Adar-Shapira/rv32im-mcu-project/Auxiliary/Lab 5/Screenshots/pre/test3_pipe_signaltap.jpeg

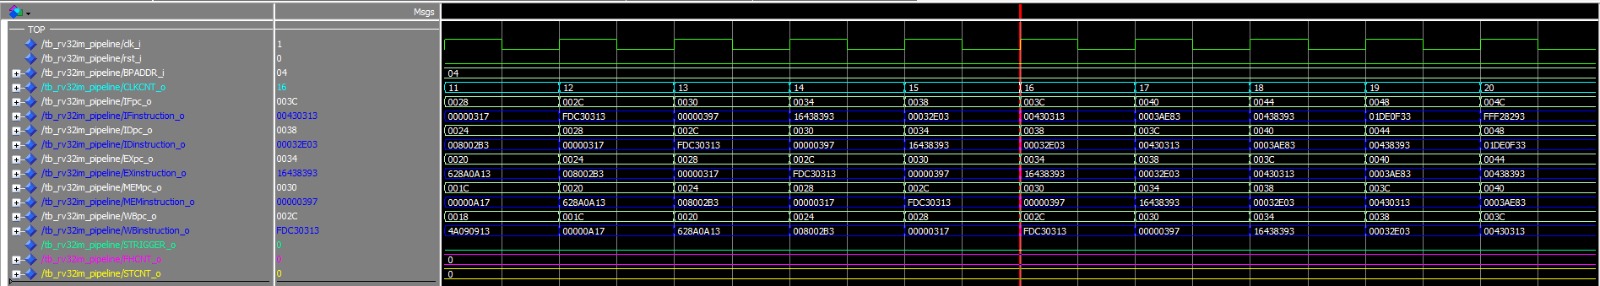
Auxiliary/Lab 5/Screenshots/pre/test3_pipe_signaltap.jpeg
