Adar-Shapira/rv32im-mcu-project/DOC/02_requirements_traceability.md

# Deliverable B — Requirements Traceability

Every address, bit field, interrupt source, timer mode, divider signal and clock, with the source it
came from. Where the material is ambiguous, the interpretation is labelled **Assumption** and what
would falsify it is stated.

Category tags, never mixed:

| Tag | Meaning |
| --- | --- |
| **[REQ]** | Official requirement, cited to a page of `Auxiliary/Final Project 2026 definition.pdf` |
| **[REQ-L5]** | Official requirement from `Auxiliary/Lab 5/Auxilary/LAB5 task definition.pdf` |
| **[CODE]** | Behaviour of code Hanan supplied |
| **[BENCH]** | Conclusion derived from a supplied benchmark |
| **[DEC]** | Our design decision |
| **[REC]** | Engineering recommendation, not binding |

All register bit-field tables in the specification are **raster images**, so no text extractor can
recover them and `Final Project 2026 definition.md` is missing or mangling every one. Everything
below was read from the PDF pages directly.

---

## 1. Data address space

**[REQ p3]** The data address space addresses DTCM and memory-mapped I/O at the lowest 14-bit
address `0…0 A13…A0`.

**[REQ p4, Figure 2]** Word-addressed layout, marked "32-bit Word":

| Word address | Byte address | Region |
| --- | --- | --- |
| `0x000` – `0x7FF` | `0x0000` – `0x1FFC` | DTCM, physical data memory — 2048 words |
| `0x800` – `0xFFF` | `0x2000` – `0x3FFC` | SFR (Special Function Registers), "distributed among many I/O devices, not all used" |

**[REQ p3, Figure 1]** Both memories are labelled `ITCM / L1-ICACHE 8kB size` and
`DTCM / L1-DCACHE 8kB size`.

**[CODE]** `cond_compilation_package.vhd:53-56` sets `G_ADDRWIDTH = 11` and
`G_DATA_WORDSNUM = 2048` — 2048 × 32 bits = 8 KiB. Consistent.

**[CODE]** `RV32IM_CORE.vhd:215-220` currently does `dtcm_addr_w <= alu_res_w(MA_WIDTH-1 DOWNTO 2)`
with `MA_WIDTH = 13`, and there is **no I/O decode at all**. Address `0x2000` therefore aliases onto
DTCM word 0 — where the interrupt vector table lives. This is the single most important gap in the
supplied core.

---

## 2. MMIO map

**[REQ p5, §5]** GPIO without interrupt capability:

| Register | Address | Resolution | Direction | Note |
| --- | --- | --- | --- | --- |
| `PORT_LEDR` | `0x2000` | Byte | GPO | LEDR7–LEDR0 |
| `PORT_HEX0` | `0x2004` | Byte | GPO | |
| `PORT_HEX1` | `0x2005` | Byte | GPO | |
| `PORT_HEX2` | `0x2008` | Byte | GPO | |
| `PORT_HEX3` | `0x2009` | Byte | GPO | |
| `PORT_HEX4` | `0x200C` | Byte | GPO | |
| `PORT_HEX5` | `0x200D` | Byte | GPO | |
| `PORT_SW` | `0x2010` | Byte | GPI | SW7–SW0 |

**[REQ p6, §6]** Peripherals with interrupt capability:

| Register | Address | Resolution | Device |
| --- | --- | --- | --- |
| `PORT_PB` | `0x2014` | Byte | KEY[3-1] |
| `UTCL` | `0x2018` | Byte | USART |
| `RXBF` | `0x2019` | Byte | USART |
| `TXBF` | `0x201A` | Byte | USART |
| `BTCTL1` | `0x201C` | Byte | Basic Timer |
| `BTCTL2` | `0x201D` | Byte | Basic Timer |
| `BTCMPR0` | `0x2020` | Word | Basic Timer |
| `BTCMPR1` | `0x2024` | Word | Basic Timer |
| `BTCAPR` | `0x2028` | Word | Basic Timer |
| `IE` | `0x202C` | Byte | Interrupt Controller |
| `IFG` | `0x202D` | Byte | Interrupt Controller |
| `TYPE` | `0x202E` | Byte | Interrupt Controller |

**[REQ p5, §4] vs [REQ p5, §5]** §4 lists ten switches and ten red LEDs; §5 maps only SW7–SW0 and
LEDR7–LEDR0. Only eight of each are memory-mapped. Benign — the map is authoritative.

**[REQ p5, Figure 5]** The decoder structure. An `Optimized Address Decoder` takes
`Address<A13..A4, A3, A2>` and produces `CS_1 … CS_n`. HEX registers are paired on one chip select
and separated by `A0`: HEX0 (`0x2004`) on `Ā0` and HEX1 (`0x2005`) on `A0`, both on `CS6`. Each
output port is a `D-Latch D0..D7 / Q0..Q7` enabled by `CS_x · MemWrite`, followed by a
`7-segment encoder` for the HEX ports. `PORT_LEDR` is a latch on `CS1 · MemWrite`. `PORT_SW` drives
`Data<7..0>` through a tri-state buffer on `CS7 · MemRead` — which is why the data bus is
bidirectional, and why Figure 1 links to a bidirectional-bus reminder.

**[BENCH]** Every `io_map.s` in every benchmark suite defines exactly these twenty addresses with
exactly these values, including the GPIO suites, which never use the timer or interrupt registers.
Two naming differences: the spec writes `RXBF`/`TXBF`, the benchmarks write `RXBUF`/`TXBUF`; and
`UTCL` on p6 is titled `UCTL` in the register table on p12. Same registers.

**[BENCH]** `Intrrupt-based IO/test1/asm-code/01_func.s:17-20` performs `sw` to `0x2005`, a
non-word-aligned byte address. Sub-word MMIO stores are therefore mandatory, not optional.

### 2.1 What the twenty addresses imply about the decoder — Phase 5A

**[BENCH]** Grouped by word — the addresses being those of §5 and §6 above — the map has no ragged edges: the twenty registers occupy exactly
**twelve consecutive 32-bit words** and **no register straddles a word boundary**.

| SFR word | Byte address(es) | Register(s) | Mapped lanes |
| --- | --- | --- | --- |
| 0 | `0x2000` | `PORT_LEDR` | 0 |
| 1 | `0x2004` `0x2005` | `PORT_HEX0` `PORT_HEX1` | 0 1 |
| 2 | `0x2008` `0x2009` | `PORT_HEX2` `PORT_HEX3` | 0 1 |
| 3 | `0x200C` `0x200D` | `PORT_HEX4` `PORT_HEX5` | 0 1 |
| 4 | `0x2010` | `PORT_SW` | 0 |
| 5 | `0x2014` | `PORT_PB` | 0 |
| 6 | `0x2018` `0x2019` `0x201A` | `UTCL` `RXBUF` `TXBUF` | 0 1 2 |
| 7 | `0x201C` `0x201D` | `BTCTL1` `BTCTL2` | 0 1 |
| 8 | `0x2020` | `BTCMPR0` — Word | 0 1 2 3 |
| 9 | `0x2024` | `BTCMPR1` — Word | 0 1 2 3 |
| 10 | `0x2028` | `BTCAPR` — Word | 0 1 2 3 |
| 11 | `0x202C` `0x202D` `0x202E` | `IE` `IFG` `TYPE` | 0 1 2 |

**[DEC]** The chip-select index is therefore `addr(5 DOWNTO 2)` — the word offset itself — and no
lookup table is needed to produce the one-hot. This is exactly Figure 5's structure: one CS per word,
`A0` separating the pair that shares it. Two words carry three registers, so `A1` joins `A0` there.
Implemented in `DUT/RV32IMscMCU/ADDR_DECODER.vhd`; the map is data in `const_package.vhd`
(`SFR_LANE_MASK`).

**[DEC]** Totals, exhaustively checked by `TB/RV32IMscMCU/tb_addr_decoder.vhd`: **8192** DTCM
bytes, **29** mapped SFR bytes (17 byte registers + 3 word registers × 4 lanes), **8163** unmapped.

**[BENCH] The write path is not the DTCM's write path.** `GPIO/test0/asm-code/test0.s:21-28` is
`li t4,PORT_HEX1` then `sw t0,0(t4)` — a **word** store to byte address `0x2005`. Every MMIO write in
every supplied benchmark has this shape, odd addresses included, and
`Intrrupt-based IO/test1/asm-code/01_func.s:17-20` uses an `srli` to place the value in bits 7..0
before the `sw`. Two consequences:

1. On the I/O side `A1..A0` are the **register selector**, not an offset into the data being
   written. Figure 5 wires the latch inputs `D0..D7` to `Data<7..0>` unconditionally.
2. The MMIO write path must **not** reuse the lane replication and `byteena_a` of Phase 3B
   (`DMEMORY.vhd`). Those are correct for the DTCM and wrong for a peripheral. A byte-resolution
   peripheral takes `Data<7..0>`; a Word-resolution one takes `Data<31..0>`.

**[BENCH] The read path only needs eight bits.** All three MMIO reads in the benchmarks are
`lw` from `PORT_SW`, and each is immediately followed by `andi` against a mask
(`GPIO/test1/asm-code/test1.s:24-25` and `test2.s:24-25`). Figure 5 drives only `Data<7..0>` from the
`PORT_SW` tri-state. **Assumption:** the upper 24 bits read as zero. Harmless either way in every
supplied benchmark, because the mask discards them. **Falsified by** a program that uses the upper
bits of an MMIO read.

**[DEC] Full decode, not partial.** `A12..A6 = 0` is part of the qualifier, so `0x2040` does not
alias onto `0x2000`. Figure 2 calls the SFR page "distributed among many I/O devices, **not all
used**", so unused addresses exist by design and must not land on used ones; and an unmapped-access
report is only meaningful under a full decode. Cost is a 7-input zero-compare. If Phase 14 finds the
decoder on the critical path, dropping `A12..A6` is the cheapest concession — `A13` must never be
dropped, as that is the DTCM/SFR split itself.

**[REQ p5] vs [REQ p5, Figure 5] — the GPO ports: output-only, or readable?** Clause 5's table gives
`PORT_LEDR` and `PORT_HEX0`…`PORT_HEX5` a Direction of **GPO**. Figure 5, however, draws inside *each*
of the three output-port interface blocks it shows a tri-state buffer labelled with `MemRead` and that
block's chip select (plus `A0` / `Ā0` for the pair), driving `Data<7..0>` — i.e. a **read-back** path,
so a load from `0x2000` or `0x2004` should return the byte the port last stored.

**Assumption (A15):** the two are reconcilable — "GPO" describes the *device* (an output device)
rather than forbidding a readable register, and a read-back register is the ordinary
memory-mapped-I/O arrangement. Read-back is therefore treated as required and scheduled with the rest
of the read path in Phase 6B. **Nothing is blocked either way:** no supplied benchmark reads a GPO
port — the only MMIO reads anywhere in the benchmark suites are three `lw` from `PORT_SW`.
**Falsified by** course staff saying the seven output ports must not respond to a read at all, in
which case Phase 6B omits the read-back and `unmapped_o`'s meaning there needs deciding.

**Phase 6A implements the write side only**, and records that omission as the second of its two
deviations from Figure 5 — see the header of `DUT/RV32IMscMCU/GPO_PORT.vhd`. It was found by an
adversarial review of the phase, not by design.

**[DEC] Naming deviation, recorded.** Figure 5 labels its chip selects `CS1`, `CS6` and `CS7` for
`PORT_LEDR`, the `PORT_HEX0`/`PORT_HEX1` pair and `PORT_SW`. No arithmetic relation to the addresses
reproduces those three numbers, so the figure's numbering is treated as **illustrative** and the
constants are named after the registers instead. The figure's structure is implemented unchanged.

---

## 3. Basic Timer

**[REQ p7, Figure 7]** `BTCTL1` — 8-bit, byte address `0x201C`:

| Bit | 7 | 6 | 5 | 4 | 3 | 2 | 1 | 0 |
| --- | --- | --- | --- | --- | --- | --- | --- | --- |
| Field | BTOUTMD | BTOUTEN | BTHOLD | BTSSEL | BTSSEL | BTCLR | BTINT | BTINT |
| Access | rw | rw | rw | rw | rw | rw | rw | rw |

**[REQ p7, Figure 7]** The `BTSSEL` encoding, from the 4-to-1 clock multiplexer in Figure 7:

| `BTSSEL` | Timer clock |
| --- | --- |
| `00` | SMCLK |
| `01` | SMCLK ÷ 2 |
| `10` | SMCLK ÷ 4 |
| `11` | SMCLK ÷ 8 |

**[REQ p7, Figure 7]** `BTCTL2` — 8-bit, byte address `0x201D`:

| Bit | 7 | 6 | 5 | 4 | 3 | 2 | 1 | 0 |
| --- | --- | --- | --- | --- | --- | --- | --- | --- |
| Field | 0 | 0 | 0 | 0 | CAPMD | CAPMD | CAPISEL | CAPISEL |
| Access | r | r | r | r | rw | rw | rw | rw |

**[REQ p8]** `CAPISEL` selects `{0: CAPIN1 pin, 1: CAPIN2 pin, 2: VCC('1'), 3: GND('0')}`.
`CAPMD` selects `{0,3: capture disabled, 1: Rising edge, 2: Falling edge}`.

**[REQ p7]** `BTCMPR0` (`0x2020`), `BTCMPR1` (`0x2024`), `BTCAPR` (`0x2028`) are all 32-bit
word-addressed, bits 31..0, `rw`.

**[REQ p8]** `BTCCRx` and `BTCMPRx` are the same registers under two names. "BTCCR" appears only in
the p8 prose and never in any address table; the addressed names are authoritative.

**[REQ p7, Figure 7]** Datapath, top to bottom:
`BTCMPR0` and `BTCMPR1` each feed a `Latch BTCL0` / `Latch BTCL1` enabled by a signal drawn as
`HEU0='1'`. `BTCNT` is a **32-bit up-mode** counter with `EN` from `BTHOLD`, `CLK` from the `BTSSEL`
mux, reset from `BTCLR`, and a comparator output `EQU0`. `BTCL0`/`BTCL1` and `EQU0`/`EQU1` feed an
`Output Unit` gated by `BTOUTMD` and `BTOUTEN`, producing `PWMout`. The capture path is
`CAPISEL` mux (CAPIN1 / CAPIN2 / VCC / GND) → `Capture Mode` block → edge detector →
`BTCNT_CAPTURE on event register` → `BTCAPR`. A 4-position mux selected by `BTINT` chooses the
`BTIFG` source from `EQU0`, `EQU1` and the capture event.

**[REQ p8]** Modes. *Compare*: `BTCNT` compared to `BTCCR0`/`BTCCR1` for periodic interrupt
intervals. *Output Compare*: compared to `BTCMPR0` and `BTCMPR1` for PWM. *Input Capture*: `BTCNT`
captured on event into `BTCAPR`.

**[REQ p8, Figure 8]** Reference lines top to bottom are `BTR(max)`, `BTCL0`, `BTCL1`, `0h`. The
sawtooth rises to `BTCL0` and resets. Two output traces: `Output Mode0: Set/Reset` and
`Output Mode1: Reset/Set`, which are complements of each other. So **`BTCL0` is the period and
`BTCL1` is the duty threshold**, and `BTOUTMD` selects which polarity.

### 3.1 Verification 1 — every timer constant decodes. **PASS, 13/13.**

Each `.eqv` from every `io_map.s`, decoded against the layouts above.

| Constant | Value | Binary | Decodes to | Name says | |
| --- | --- | --- | --- | --- | --- |
| `BTHOLD_BTCLR` | `0x24` | `0010_0100` | BTHOLD=1, BTSSEL=00, BTCLR=1, BTINT=00 | BTHOLD + BTCLR | ✔ |
| `BTHOLD_BTSSEL3_BTCLR` | `0x3C` | `0011_1100` | BTHOLD=1, BTSSEL=11, BTCLR=1 | BTHOLD + BTSSEL3 + BTCLR | ✔ |
| `BTSSEL3` | `0x18` | `0001_1000` | BTSSEL=11, everything else 0 | BTSSEL3 | ✔ |
| `BTOUTEN_BTSSEL3` | `0x58` | `0101_1000` | BTOUTEN=1, BTHOLD=0, BTSSEL=11 | BTOUTEN + BTSSEL3 | ✔ |
| `BTINT2` | `0x02` | `0000_0010` | BTINT=10 = 2 | BTINT2 | ✔ |
| `BTHOLD_BTCLR_BTINT2` | `0x26` | `0010_0110` | BTHOLD=1, BTSSEL=00, BTCLR=1, BTINT=10 | BTHOLD + BTCLR + BTINT2 | ✔ |
| `CAPMD1_CAPISEL3` | `0x07` | `0000_0111` | CAPMD=01 (rising), CAPISEL=11 (GND) | CAPMD1 + CAPISEL3 | ✔ |
| `BTIE` | `0x04` | `0000_0100` | IE bit 2 | BTIE | ✔ |
| `KEY3IE_KEY2IE_KEY1IE` | `0x38` | `0011_1000` | IE bits 5,4,3 | KEY1/2/3 IE | ✔ |
| `KEY3IE_KEY2IE_KEY1IE_BTIE` | `0x3C` | `0011_1100` | IE bits 5,4,3,2 | + BTIE | ✔ |
| `KEY1IFG_MASK` | `0xFFF7` | `…1111_0111` | AND-clears IFG bit 3 | KEY1IFG | ✔ |
| `KEY2IFG_MASK` | `0xFFEF` | `…1110_1111` | AND-clears IFG bit 4 | KEY2IFG | ✔ |
| `KEY3IFG_MASK` | `0xFFDF` | `…1101_1111` | AND-clears IFG bit 5 | KEY3IFG | ✔ |

**Independently corroborated by the benchmark authors' own comments**, which spell out the field
assignments:

| Source | Comment |
| --- | --- |
| `test4/01_func.s:76` | `# BTCTL1=(BTHOLD=1,BTCLR=1)` for `0x24` |
| `test2/01_func.s:56` | `# BTCTL1=(BTHOLD=1,BTSSEL=3,BTCLR=1)` for `0x3C` |
| `test4/01_func.s:101` | `# BTCTL1=(BTHOLD=0,BTCLR=0,BTSSEL=3,BTINT=0)` for `0x18` |
| `test4/01_func.s:147` | `# BTCTL1=(BTOUTEN=1,BTHOLD=0,BTCLR=0,BTSSEL=3)` for `0x58` |
| `test4/01_func.s:158` | `# BTCTL1=(BTHOLD=1,BTCLR=1,BTSSEL=SMCLK,BTINT=2)` for `0x26` |

That last comment is decisive: `0x26` has `BTSSEL = 00`, and the author annotates it
`BTSSEL=SMCLK`. So `00` is SMCLK undivided, exactly as Figure 7's mux shows.

**Caution:** `0x3C` means two different things depending on the destination register —
`BTHOLD_BTSSEL3_BTCLR` when written to `BTCTL1`, `KEY3IE_KEY2IE_KEY1IE_BTIE` when written to `IE`.

### 3.2 Verification 2 — the frequency arithmetic. **FAIL. A real contradiction.**

**[BENCH]** The two timing constants, with the benchmarks' own annotations:

```
.eqv SEC_PERIOD  0x01312D00   # = 20,000,000   # in case of SMCLK=20MHz
.eqv FREQ_5K     0x000001F4   # = 500          # in case of SMCLK=20MHz
```

**[BENCH]** Which `BTSSEL` each is used with, read from the sources rather than assumed:

| Test | Sequence | `BTSSEL` | Constant | Claimed |
| --- | --- | --- | --- | --- |
| test2 | `01_func.s:54` writes `0x3C`, `:64` loads `SEC_PERIOD` → `BTCMPR0`, `:72` writes `0x18` | **3 (÷8)** | `SEC_PERIOD` | "interrupt period of 1sec" |
| test3 | identical to test2 | **3 (÷8)** | `SEC_PERIOD` | "interrupt period of 1sec" |
| test4 compare | `01_func.s:74` writes `0x24`, `:95` loads `SEC_PERIOD`, `:99` writes `0x18` | **3 (÷8)** | `SEC_PERIOD` | "interrupt period of 1sec" |
| test4 PWM | `:120` loads `FREQ_5K` → `BTCMPR0`, `:145` writes `0x58` | **3 (÷8)** | `FREQ_5K` | "PWM frequency=5KHz (for SMCLK=20MHz)" |

Both constants are used at the **same** `BTSSEL = 3`, so ÷8 applies to both. Working the arithmetic
at SMCLK = 20 MHz, timer clock = 2.5 MHz:

- `FREQ_5K`: 2,500,000 ÷ 500 = **5000 Hz exactly** ✔ matches its comment.
- `SEC_PERIOD`: 20,000,000 ÷ 2,500,000 = **8 seconds**, not 1 ✘ off by exactly 8×.

For `SEC_PERIOD` to give one second at `BTSSEL = 3`, SMCLK would have to be 160 MHz, which is not
achievable from a 50 MHz input on this device and contradicts the constant's own annotation. For it
to give one second, `BTSSEL` would have to be `0`.

So exactly one of these holds, and the material does not say which:

1. SMCLK = 20 MHz, the `BTSSEL` table is as Figure 7 draws it, and the benchmarks' "1sec" comments
   are simply wrong — the real period is 8 s. `FREQ_5K` stays correct.
2. The `BTSSEL` encoding is reversed (`11` → ÷1), making `SEC_PERIOD` correct and `FREQ_5K` wrong
   by 8× (40 kHz instead of 5 kHz).

**[DEC]** We implement reading 1: Figure 7's table as drawn, `00` → ÷1 through `11` → ÷8. Three
independent things support it — the Figure 7 mux labels, the author's own `BTSSEL=SMCLK` comment on
value `00`, and `FREQ_5K` resolving exactly. Only the "1sec" prose comments contradict it, and
comments are the weakest evidence in the set.

**Assumption:** SMCLK = 20 MHz. Nothing in the specification states any frequency (see §6).
This is derived solely from `FREQ_5K` resolving exactly at ÷8, and from the benchmarks' own
`# in case of SMCLK=20MHz` annotations. **Falsified by** course staff stating a different SMCLK, in
which case `FREQ_5K` stops being 5 kHz and the whole derivation must be redone.

Raised as open question 2. It does not block: the timer implements the specified table, behaviour is
deterministic, and the 8× discrepancy is a property of the supplied benchmark rather than of our
RTL.

---

## 4. Interrupt controller

**[REQ p14]** `IE`, Interrupt Enable Register — byte address `0x202C`:

| Bit | 7 | 6 | 5 | 4 | 3 | 2 | 1 | 0 |
| --- | --- | --- | --- | --- | --- | --- | --- | --- |
| Field | 0 | 0 | KEY3IE | KEY2IE | KEY1IE | BTIE | TXIE | RXIE |
| Access | r-0 | rw | rw | rw | rw | rw | rw | rw |

`IEx`: 0 = interrupt not enabled, 1 = interrupt enabled.

**[REQ p14]** `IFG`, Interrupt Flag Register — byte address `0x202D`:

| Bit | 7 | 6 | 5 | 4 | 3 | 2 | 1 | 0 |
| --- | --- | --- | --- | --- | --- | --- | --- | --- |
| Field | 0 | 0 | KEY3IFG | KEY2IFG | KEY1IFG | BTIFG | TXIFG | RXIFG |
| Access | r-0 | rw | rw | rw | rw | rw | rw | rw |

`IFGx`: 0 = no interrupt pending, 1 = interrupt pending.

**[REQ p14]** `TYPE`, Interrupt Type Register — byte address `0x202E`. Bits 7:6 are `0`, read-only;
bits 5:0 are `TYPEx`, read-only.

**Cross-check:** these layouts were derived independently from the benchmark masks in §3.1 before
the PDF pages were read, and the two agree bit for bit. `BTIE = 0x04` → bit 2; `0x38` → bits 5,4,3;
`0xFFF7`/`0xFFEF`/`0xFFDF` → clear bits 3/4/5.

**[REQ p14]** Interrupt vector table:

| Source | Flag | TYPE | System interrupt | Priority |
| --- | --- | --- | --- | --- |
| RESET | — | `00h` | NMI | 0, highest |
| UART status error | RXIFG | `04h` | maskable | 1 |
| UART RX | RXIFG | `08h` | maskable | 2 |
| UART TX | TXIFG | `0Ch` | maskable | 3 |
| Basic Timer | BTIFG | `10h` | maskable | 4 |
| Pushbutton 1 | KEY1 | `14h` | maskable | 5 |
| Pushbutton 2 | KEY2 | `18h` | maskable | 6 |
| Pushbutton 3 | KEY3 | `1Ch` | maskable | 7, lowest |

**[REQ p13]** Clearing rules, verbatim:

- a. `BTIFG` is reset automatically when the interrupt is serviced.
- b. `RXIFG` is automatically reset if the pending interrupt is served or when `RXBUF` is read.
- c. `TXIFG` is automatically reset if the interrupt request is serviced or if a character is
  written to `TXBUF`.
- d. `KEYiIFG` is reset manually with software (`BTIFG`, `RXIFG`, `TXIFG` as well).
- e. As part of the CPU servicing an interrupt, `GIE` is cleared *in HW* — DINT of other interrupts.
- f. Symmetrically, as part of the CPU returning from interrupt, `GIE` is set *in HW* — EINT, back
  to the original state.

**[REQ p13, diagram]** Structure. The controller sits on the Control / Address / Data buses with a
`CS` input and interrupt-source inputs `IS0 … ISn`, drives `INTR` to the CPU and receives `INTA`
from it — both `CS` and `INTA` drawn active-low.

Per source: a D flip-flop with `D` tied to `"1"`, **clocked by the interrupt source `IS`** and
asynchronously cleared by `clr_irq`, with an "interrupt done" feedback path into that clear. So each
flag is a set-only latch triggered by the source's edge — this is exactly the KEY edge-latch
behaviour, and no separate edge detector is drawn.

Per the multi-source diagram, the flop outputs form the **IFG register** directly, and each
`irq_n AND eint_n` product feeds an OR tree whose output is ANDed with `GIE` to produce `INTR`.

**Assumption:** `IFG` holds the **raw latched** flag and `IE` masks only the path toward `INTR`.
The single-source diagram labels the `irq AND eint` output `IFGx`, which would instead make `IFG`
the masked value; the multi-source diagram contradicts it by bracketing the flop outputs as "the IFG
Register". We follow the multi-source reading because the benchmarks read and clear `IFG` bits
independently of `IE`. **Falsified by** a benchmark that reads `IFG` and expects a masked value.

### 4.1 Verification 4 — every TYPE value has a vector. **PASS.**

`TYPE` is a byte offset into the DTCM vector table, so `TYPE / 4` is the word index. Words 0–7 of
each benchmark's DTCM image:

| TYPE | Word | test1 | test2 | test3 | test4 |
| --- | --- | --- | --- | --- | --- |
| `00h` RESET | 0 | `00000000` | `00000000` | `00000000` | `00000000` |
| `04h` UART error | 1 | `00000200` | `0000011c` | `0000017c` | `00000234` |
| `08h` UART RX | 2 | `00000200` | `0000011c` | `0000017c` | `00000234` |
| `0Ch` UART TX | 3 | `00000204` | `00000120` | `00000180` | `00000238` |
| `10h` Basic Timer | 4 | `000001fc` | `00000104` | `00000164` | `000001f8` |
| `14h` KEY1 | 5 | `00000160` | `00000068` | `00000080` | `00000138` |
| `18h` KEY2 | 6 | `00000194` | `0000009c` | `000000cc` | `00000178` |
| `1Ch` KEY3 | 7 | `000001c8` | `000000d0` | `00000118` | `000001b8` |

Every entry is word-aligned and inside the ITCM extent. The RESET vector is `0` in all four,
consistent with **[REQ p3]** "KEY0 as a System RESET (brings the PC to the first program
instruction)".

**This resolves the `RXIFG` ambiguity in practice.** TYPE `04h` and `08h` hold the *same* handler
address in all four benchmarks, so the two UART sources vector to one routine that distinguishes
error from data by reading `UCTL`. The hardware still has to pick which TYPE value to present, but
the choice cannot change program behaviour in any supplied benchmark. Open question 4 is therefore
non-blocking.

### 4.2 The service protocol

**[REQ p15]** At the next clock cycle after `INTR` is set to `'1'` by the controller, the CPU sets
`INTA` to `'0'`. At that point, before the service process starts, the next PC address is the
**interrupt return address**.

Entry — latency **two cycles**, triggered by the **falling edge of `INTA`**:

*Cycle 1*
- Clear `GIE` (bit `gp[0] = 0`)
- Set `INTA` (`INTA = '1'`)
- Write the content of register `TYPE` onto the Data BUS and capture it in a dedicated register.
  **[REQ p15]** notes it cannot go on the Address BUS, because the CPU is the only bus master.

*Cycle 2*
- If the pending `TYPE` interrupt is a synchronous source, clear its flag (like `BTIFG`)
- Emulate execution of `load` (of the `TYPE` content) and `jalr` (to `Mem[TYPE]` content), with
  `R[tp]` = interrupt return address

Return — latency **one cycle**: as part of executing `jalr zero, 0(tp)` (`reti`), set `GIE`
(bit `gp[0] = 1`).

**[BENCH]** The software side of the contract:
`Intrrupt-based IO/*/asm-code/io_map.s` defines `.eqv reti  jalr zero,0(tp)`, and
`test1/asm-code/00_main.s:77` is `ori gp,gp,0x01   # EINT, GIE=gp[0]=1`.

So `INTA` is idle-high, pulses low for exactly one cycle as the trigger, and is driven high again in
Cycle 1.

### 4.3 What Phase 9A built — the controller leaf

**[OUR CODE]** `DUT/RV32IMscMCU/INTERRUPT_CTRL.vhd`, verified by `tb_interrupt_ctrl.vhd` against
`tools/model_interrupt_ctrl.py` (twelve faithful mutations, all caught). No lab precedent exists —
searched, only a student explanation document mentions interrupts. Design points, each carrying its
source:

- **Raw latch, masked view** — `irq_q` set by the event edge with **no IE gate** (the p13 flop,
  D='1'), and `ifg_w = irq_q AND ie_q` is the *only* thing read-back, the TYPE encoder and the
  `INTR` OR-tree ever see. This is the p13 structure taken literally and the falsified-A6 answer
  honoured: what `IFG` reads is the masked product. The first draft gated the *set* by IE instead —
  killed and kept as mutant M1. Observable corners recorded as **A22** (masked requests reappear on
  enable), **A23** (`RXIFG` presents `08h`), **A24** (W0C).
- **KEY events fire on RELEASE** — the prep session (`DOC/03` §C) is the only polarity source: all
  request events are rising 0→1 edges of the raw KEY line, which rises when the key is let go. The
  implementation detects the **falling** edge of the polarity-normalized pressed level — the same
  physical event on either board polarity — through the Figure 10a two-flop synchronizer
  (`SYNC.vhd`, reused as in `DIV_UNIT`) plus one history flop. Taking the raw idle-high line into
  reset-cleared flops would fabricate one spurious "release" after reset; the pressed level idles
  low, matching reset. Press-edge detection is mutant M8 — DOC/03's exact warned-against bug.
- **Clearing** — rules a/b/c auto-clear the serviced source's raw latch at the INTA accept edge
  (`b`/`c` are live but sourceless until Phase 12); rule d exempts the KEYs. A hardware set beats a
  same-edge software clear, so the ISR read-modify-write idiom can never swallow a new event.
- **The INTA handshake** — TYPE is frozen into `type_capt_q` at the edge ending the INTA-low cycle
  and pushed (`type_push_o`) during the following cycle, for the MCU level to drive onto the data
  bus per REQ p15 (the CPU is the only bus master, so the controller pushes and the CPU captures).
  Phase 9C owns the BidirPin that does the driving.
- **Clock domain** — the controller belongs to the CPU clock: INTR/INTA and the bus writes are
  CPU-side handshakes. `bt_ifg_set_i` arrives from the timer on `pclk_w`; under **A19**
  (MCLK = SMCLK, one 20 MHz net) that is the same domain today. **If B3 ever splits them, this
  input needs a pulse CDC** — this sentence is the recorded reminder.

### 4.4 What Phase 9B built — the CPU side

**[OUR CODE]** The entry FSM and the datapath hijacks, verified by `tb_intr_core.vhd` (the
testbench plays the controller) running a program from `tools/gen_intr_core_test.py`, whose
interpreter emulates the whole protocol as the second derivation. Design points:

- **The FSM is three states** (`I_IDLE → I_CYC1 → I_CYC2`), with the *accept cycle* being the IDLE
  cycle in which `accept_w` fires — so `INTA = NOT accept_w` is a combinational one-cycle low
  pulse, and the instruction executing in that cycle completes normally, leaving `pc_q` at the
  return address. `intr_i` is registered once (`intr_q`) because REQ p15 says INTA falls "at the
  next clock cycle after INTR is set".
- **F13 is the accept gate**: `accept_w` requires `div_start_w = '0'` (the RAW decode — a stalled
  div keeps it high for its whole stall, and an accept cycle can therefore never be a div issue
  cycle, so no divide is ever annulled mid-flight) **and** `div_busy_w = '0'` (the synchroniser
  tail after retirement — this is the consumer `div_busy_w` was declared for in Phase 7B2).
- **Cycle 1**: PC held through the same mechanism as the divider stall (`if_hold_w`); GIE cleared
  through IDECODE's new side door (`RF_q(3)(0)` only — gp's other 31 bits untouched); `type_q`
  captures `dbus_rdata_i` RAW (not the region-muxed load value — the annulled instruction's
  address must not steer the capture).
- **Cycle 2**: the DTCM address is hijacked to `type_q(7 DOWNTO 2)` (F14: TYPE is already ×4) with
  `MemOp` forced to `MEM_W` (DMEMORY's extract mux would otherwise slice the vector to whatever
  width the annulled instruction decoded); the read word enters IFETCH's new top-priority vector
  arm; `tp` takes the zero-extended return address.
- **Annul** (`annul_w`, Cycles 1+2): RegWrite, MemWrite, DivStart and — load-bearing — the bus-side
  MemRead are all suppressed: in Cycle 1 the controller is *driving* the shared bus with TYPE, so
  the core must not enable a reader against it. The DTCM-side MemRead gate also silences the
  half-word misalignment `severity failure` an annulled `lh` could otherwise raise.
- **reti** is recognized in CONTROL as the exact word `jalr zero,0(tp)` (`INST_RETI = x"00020067"`,
  io_map.s's own `.eqv`); the jalr redirect is the normal one, and the only added effect is the
  GIE-set side door at the same edge (rule f). An *annulled* reti — the return address itself
  holding one — is masked from the side door.

### 4.5 What Phase 9C wired — the two halves onto the bus

**[OUR CODE]** `RV32IMscMCU.vhd` only; no peripheral or core logic changed. Verified end to end by
`tb_intr_mmio.vhd` over a program from `tools/gen_intr_mmio_test.py`, whose second derivation is
the two **already-vetted models composed** (`Intc` + `Timer` on one emulated bus with the §4.4
protocol between them) — nothing re-modelled.

- `IE`/`IFG`/`TYPE` are readers 11/12/13 in the existing Phase 6B structure — `CS_INTC` with lanes
  0/1/**2** (`lane2_w` is new: TYPE at 0x202E is the map's first base+2 register). TYPE has a
  reader and **no write path anywhere** (REQ p14: read-only).
- **The TYPE push is bus driver `RD_TYPEPUSH`** — one more `BidirPin` on the one shared bus
  (Hanan's "mandatory … bi-directional bus" answer applies to it like to every reader), enabled by
  the controller's push strobe instead of a `CS·MemRead` term. It cannot collide: during entry
  Cycle 1 the core's annul holds MemRead **and** MemWrite low, and the `onehot_check` now watches
  exactly that claim.
- The controller instance sits on `pclk_w` — **F11 verbatim** ("the other modules' registers are
  DFF based on SMCLK"), which supersedes §4.3's earlier CPU-clock phrasing; sound because
  `pclk_w` *is* `mclk_w` today (A19). If B3 splits them, the INTR/INTA/TYPE handshake **and**
  `bt_ifg_set_i` all need CDC.
- Sources: `bt_ifg_set_w` (Phase 8B's pulse, consumed at last) and `key_pressed_w` (Phase 6C's
  normalized level; the controller fires on its falling edge = the release). The p13 drawing shows
  CS and INTA active-low; the CS here is active-high like every decoder output since Phase 5A — a
  recorded convention difference, not a behavioural one. INTA is active-low as drawn.

---

## 5. Division accelerator

**[REQ p9, Figure 9]** Datapath: a `Dividend left shift-register` loaded via `Load` and shifting
`'0'` in at the LSB; a `Divisor register`; a `Subtractor` computing `Result = Y − X` with a
`Non-negative Result` feedback that also drives the quotient bit; and a
`Quotient left shift-register`. Outputs are `Residue` and `Quotient`.

Control signals: `DIVCLK`, `DIVRST`, `DIVENA` in; `DIVBUSY` out.

**[REQ p9]** Operand and result registers `DIVIDEND`, `DIVISOR`, `QUOTIENT`, `RESIDUE`, all 32-bit,
bits 31..0.

**[REQ p9]** "The divider results are ready after N DIVCLK cycles after loading a value to the
second operand DIVISOR, i.e., 32 DIVCLK cycles (**fast clock**) in our case of N=32."

So **writing `DIVISOR` starts the operation**, and the count is 32 cycles of the fast clock.

**[REQ p4, Figure 3]** The integration. `Control Unit` gains `PCHold` and `DIVbusy` as inputs and
`DIVstart` as an output; a `Divider Accelerator 32-bit` block takes `Ain`/`Bin` and produces
`Quotient`/`Rem`, clocked by `divclk`, preceded by a `Sync` block also on `divclk`; and the
write-back mux is widened, selected by `WBSrc1`/`WBSrc0`.

**Assumption:** `DIVIDEND`, `DIVISOR`, `QUOTIENT` and `RESIDUE` are **core-internal**, not
memory-mapped. They are given register diagrams on p9 but appear in neither MMIO table, and
Figure 3 wires them to the ALU operands rather than to the data bus. **Falsified by** course staff
assigning them SFR addresses. Raised as open question 6.

**Third piece of evidence for the same reading, added 2026-08-24.** Figure 10b labels the two
synchroniser inputs `Read data1` and `Read data2` — which are this project's own register-file read
port names (`read_data1_o` / `read_data2_o` in `IDECODE.vhd`). So the operands enter the divider
domain straight from the register file, not from the data bus. Together with Figure 3 wiring
`Ain`/`Bin` to the ALU operands, that is two figures pointing the same way and none pointing the
other. Q6 still wants a confirmation, but the provisional answer is now well supported.

### 5.2 What Phase 7B1 built — the subsystem around the engine

**[CODE, ours]** `DUT/RV32IMscMCU/DIV_UNIT.vhd`, verified by `TB/RV32IMscMCU/tb_div_unit.vhd` and
pre-verified in Python by `tools/model_div_unit.py`. Engine + four clock-domain crossings + the
MCLK-side handshake + the signed `div`/`rem` wrapper, behind one MCLK-domain interface.

**[DEC] The stall is built on `done_o`, not `busy_o`.** `DIVstart` takes two synchroniser stages to
reach the engine and `DIVBUSY` two more to return, so for several MCLK cycles after a `div` issues
`busy` still reads **low**: a stall written as "hold while busy" does not hold at all, and the core
runs past its own divide. Phase 7B2's term is `PCHold <= DIVstart AND NOT done_o`.

**[DEC] A launch race, found in review of our own design and fixed.** The enable and the two operand
buses each cross through their own two-stage synchroniser. Launched on the same MCLK edge, nothing
guarantees the operand bits resolve no later than the enable bit — `DIVENA` can legitimately arrive
one DIVCLK edge before a bit of `Ain`/`Bin` has settled, and the engine would load a half-updated
operand. The `LAUNCH` state holds the enable back one MCLK cycle: data first, control after.

**[DEC] The result buses are deliberately not synchronised**, and that is the correct application of
`SYNC.vhd`'s own rule rather than an omission of it: a two-flop synchroniser on a multi-bit bus is
only sound when the bus is *stable*, and `Quotient`/`Residue` change on every iteration. They are
read directly, after `DIVBUSY` has been seen to fall through two stages — by which point the engine
has been idle and its outputs constant for at least two MCLK cycles.

**[DEC] The operands are registered before crossing**, a deliberate deviation from Figure 10b, which
draws live `Read data1`/`Read data2` going straight into the `Sync` block. A live register-file
output is stable only *because* the core stalls; a latched copy is stable by construction.

**[REQ, RISC-V] The signed wrapper needs exactly one special case, and it is not the one people
expect.** `-2^31 / -1` needs **nothing**: `|-2^31|` is `0x80000000`, the engine returns quotient
`0x80000000`, the signs agree so nothing is negated, and `0x80000000` *is* `-2^31`. **Divide by zero
does** need hardware: RISC-V requires `-1` for every dividend, but for a *negative* dividend the sign
correction would negate `0xFFFFFFFF` into `+1`. So `divisor = 0` bypasses the sign correction, giving
quotient all-ones and remainder the original dividend — one rule that is simultaneously correct for
`div`, `divu`, `rem` and `remu`. Confirmed necessary rather than defensive: removing it from the
model produces 155 failures.

**[DEC] A clock-ratio constraint, recorded because B3 is open.** The handshake's `WAIT_RISE` only
terminates if `DIVBUSY` stays high long enough for the MCLK synchroniser to catch it — roughly
`f_DIVCLK < 16 × f_MCLK`. At the planned 50 MHz against 20 MHz there is twelve times the margin
needed. **The failure mode is a hang, not a wrong answer**, which is why the testbench checks it (P5)
instead of trusting it. If B3 returns a much faster `DIVCLK`, re-check this.

---

### 5.3 What Phase 7B2 wired into the core

**[CODE, ours]** `CONTROL.vhd`, `IFETCH.vhd`, `IDECODE.vhd`, `RV32IM_CORE.vhd`, `RV32IMscMCU.vhd`.

**[REQ p4, Figure 3]** `CONTROL` gains the `DIVstart` output the figure draws, plus two qualifiers
(signed, remainder). The four encodings were already in `const_package.vhd` and had simply never been
decoded. Each mask is `0xFE00707F`, so **funct7 is part of the compare** — which matters: `div`'s
funct3 of `100` is the same as `xor`'s, and only the funct7 bit separates them. A narrower mask would
have made every `div` decode as a `xor` and quietly compute one.

**[DEC] The stall is one line in `IFETCH`, and the obvious alternative is wrong.** `next_pc_w` takes
`pc_q` while `PCHold` is high. Freezing only the *pc register* would not have worked: `itcm_addr_w`
is `next_pc_w`, so it would still have been `pc_plus4_q`, the ITCM would have fetched the *following*
instruction, `instruction_o` would have changed underneath the stall, and `DIVstart` — being
combinational decode — would have dropped mid-divide. Feeding `pc_q` back re-fetches the **same**
instruction, which is what holds the whole thing steady. `pc_plus4_q` needs no separate hold: it
tracks `next_pc_w + 4`, so it sits at `pc_q + 4`, the right value to resume on.

**[DEC] `RegWrite` and `MemWrite` are gated off during the stall.** Without it, a div — an R-type
instruction — leaves `RegWrite` asserted for every cycle of the stall, so the register file takes a
new and (until the last cycle) meaningless write on each. The final write would still be correct, so
this is not a correctness bug on its own; it is gated because a register file written fifteen times
per divide is indefensible in a report, and because the same gate is what any future multi-cycle
instruction needs. `MemWrite` is gated too, for one AND gate, against a store executing repeatedly.

**[BENCH] Why the four Lab 5 cycle counts cannot move, checked and not assumed.** Every new control
term is gated by `pc_hold_w`, which can only rise on a div — and the four Lab 5 benchmarks contain
**none**. Their ITCM images decode to exactly **one `mul` each and zero div/rem** (29 / 29 / 52 / 62
words). The decoder used for that count was validated by confirming test1's first word is
`0x00000417` = `auipc x8,0`, and the word counts match the "29 to 62 instructions" already recorded
in `RV32IMscMCU.vhd`'s header.

**[CODE] The ISA suite's expected counts changed from 25/9 to 21/5**, and that is the phase working
rather than a regression: `div`/`divu`/`rem`/`remu` were four of the mismatches and now pass
regardless of the ISA repairs (the divider was never behind the — since-retired — `G_ISA_REPAIR`
switch). The generator's two
independent derivations disagreed until the defect model was taught the new behaviour, and it
**refused to promise a count** until they agreed. The ITCM/DTCM images are byte-identical, so the
program did not change — only which stores are expected to fail. **The 5 that remain are all
mul-related and all out of scope** per F1.

---

### What Phase 8A built — the Basic Timer core

*(The timer's specification facts live in §3; this build note sits here with the other phase-build
notes rather than renumbering the document.)*

**[CODE, ours]** `DUT/RV32IMscMCU/BASIC_TIMER.vhd`, verified by `TB/RV32IMscMCU/tb_basic_timer.vhd`
and pre-verified by `tools/model_basic_timer.py` (0 failures; eight faithful mutations all caught).

**[CODE, Lab 4] The skeleton is `Auxiliary/Lab4/DUT/pwm.vhd`**, read in full first per the standing
check-the-labs rule: its wrap-at-`Y` counter → `BTCNT` wrapping at `BTCL0`; its `ena` → `BTOUTEN`
(page 8's *"hold the PWMout signal value"* is an update-enable's behaviour, stated in prose); its
Mode 0/1 → `BTOUTMD`; `X` → `BTCL1`; its Mode 2 Toggle dropped (one mode bit, two Figure 8 traces).

**[BENCH] B4 largely resolved from the benchmarks.** `BTINT` codes `00`→EQU0 and `10`→capture are
pinned by `io_map.s`'s `BTINT2=0x02` being written exactly when test4 configures capture, and by
every compare test using `BTINT=0`. `01`→EQU1 / `11`→reserved are **A20**.

**[FORUM F16]** implemented literally: reset clears `BTCTL1`, `BTCTL2`, `BTCAPR`, `BTCMPR0`,
`BTCMPR1` — and `BTCNT` has **no reset arm** at all (`BTCLR` only).

**[FORUM F17] and a new finding.** `EQU0 = (BTCNT = BTCL0)` with restart on the next counting tick
makes the period **`BTCL0`+1** ticks. Consequence, measured by the testbench rather than argued:
`FREQ_5K = 500` at ÷8 yields (500+1)×8 = **4008** SMCLK cycles = **4990 Hz**, not the 5 kHz the
`io_map.s` comment claims; exactly 5 kHz needs 499. Reported (P8's printed note), not silently
"fixed" — the same posture as B2's `SEC_PERIOD` factor-8.

**[DEC]** The prescaler is a clock **enable**, not a divided clock net (fabric idiom; nothing
observable differs at the register boundary). Capture uses two synchroniser stages plus an
edge-delay stage, because an edge detector must compare two *settled* samples — the `SYNC.vhd` rule
applied inline. Writes to `BTCAPR` are ignored; capture hardware owns it.

---

**[REQ p10, Figures 10a/10b]** The CDC rule and its exact structure, read off the figures rather
than inferred from the prose. **Three flip-flops, not two.**

Figure 10a draws the complete crossing:

| Domain | Contents | Clock |
| --- | --- | --- |
| A (slow) | `Comb logic` → one `D Q` | `MCLK` |
| B (fast) | `Din` → `D Q` → `Ds` → `D Q` → `Dout` "stable" | `DIVCLK`, both stages |

The accompanying waveform names the interval between `Din` and `Ds` the **"Metastable phase"** and
the point after `Dout` settles **"Stable Output"**.

The page 10 prose makes the domain-A register mandatory, not optional: *"It's fundamental to have a
flip-flop to synchronize every signal that is driven by combinational logic (combo) in domain A
before sending it to domain B through the synchronizer. In domain B, we must register the input to
avoid metastability caused by violating the fast clock-domain B regime."*

Figure 10b then draws the block as the divider instantiates it — a `Sync` box clocked by `divclk`,
containing **two independent two-DFF chains**:

```
Read data1 -> [DFF] -Ds-> [DFF] -> Ain
Read data2 -> [DFF] -Ds-> [DFF] -> Bin
```

**Assumption, and it is a real one.** A two-stage synchroniser on a *multi-bit bus* is only sound
when the bus is stable across the crossing: individual bits can resolve on different destination
cycles, so a bus that changes mid-sample can present a value that never existed on the source side.
Figure 10b applies it to two 32-bit operands regardless. For the divider that is sound, because the
CPU writes `DIVIDEND` and `DIVISOR` and only then does the enable cross — the operands are
quasi-static by the time they matter. **Falsified by** any later use where the data can change while
being sampled; such a crossing needs a handshake or a gray code, not this block.
**Implemented and tested:** `DUT/RV32IMscMCU/SYNC.vhd`, `TB/RV32IMscMCU/tb_sync.vhd`. Gap G-310.

Neither figure draws a reset. One is added anyway — a synchroniser chain starting at `'U'` propagates
unknowns into the divider for two cycles — and it is sampled in the **destination** domain, since a
reset released in the source domain would itself be an unsynchronised crossing.

### 5.1 What Phase 7A built, and the one interpretation it rests on

**[CODE, ours]** `DUT/RV32IMscMCU/DIV_ACCEL.vhd`, verified by
`TB/RV32IMscMCU/tb_div_accel.vhd` and pre-verified in Python by
`tools/model_div_accel.py`. The **unsigned engine only**. The signed `div`/`rem` wrapper, both
clock-domain crossings, the `DIVstart`/`PCHold` stall and the write-back mux are Phase 7B, which
needs the `DIVCLK` that Phase 4B produces.

**Assumption A18 — the interconnection of Figure 9's blocks.** Figure 9 is a raster image, and at
its resolution the individual wires between the shift register, the subtractor's two inputs and the
residue output **cannot be traced**. The block set and every signal name *are* legible and are
implemented exactly as drawn. The interconnection is implemented as classical restoring division:
the upper half of the 2N-bit register is the running remainder, the lower half holds the dividend
bits not yet consumed, each cycle shifts the pair left by one with `'0'` entering at the LSB, `Y` is
the upper half *after* that shift, `X` is the divisor register, and the non-negative flag both
selects `Y-X` over `Y` and becomes the next quotient bit. **The argument for it is that it is the
only assignment of Figure 9's blocks that produces a correct quotient and residue — not that it was
read off the page.** **Falsified by** course staff describing a different interconnection. Verified
exhaustively at N=8: all 65536 operand pairs, divide-by-zero column included.

**Reconciling "writing `DIVISOR` starts it" with `DIVENA`.** §5 above, read straight off page 9,
says the operation begins when a value is loaded into the second operand `DIVISOR`. This
implementation is triggered by `DIVENA`. Those are the same event seen from the two sides of the
boundary, and it is worth writing down because side by side they look like a contradiction:
`DIVIDEND` and `DIVISOR` are **core-internal** registers (F2, confirmed), so there is no MMIO store
that could "write `DIVISOR`" — the core loads them while executing `div`/`rem`, and Figure 3 shows
the Control Unit raising `DIVstart` from that same decode. `DIVstart`, crossed into the `DIVCLK`
domain, *is* `DIVENA`. Page 9 describes the core's view; Figure 9's port list describes the
accelerator's. Neither says the accelerator watches a bus write, and it does not.

**[REQ p9] The 32-cycle sentence, met literally.** "The divider results are ready after N DIVCLK
cycles after loading a value to the second operand DIVISOR." Implemented as one Load edge followed
by N iteration edges, with `DIVBUSY` raised on the Load edge and dropped on the Nth iteration —
so `DIVBUSY` is high across exactly N `DIVCLK` periods and the results are valid N cycles after the
load. The testbench measures this on every one of its 66 000+ operations rather than as a spot
check.

**[REQ p9 + BENCH-independent] Divide by zero needs no hardware at all.** With `X = 0` the test
`Y >= X` holds on every cycle, so every quotient bit is `'1'` and every subtraction removes nothing,
which leaves the remainder accumulating the dividend's bits as they shift through. After N cycles:
`QUOTIENT` = all ones, `RESIDUE` = the dividend. That is exactly Hanan's forum answer (*"in
practice the division result will be all ones"*, `DOC/03` F4) **and** exactly what the RISC-V
unprivileged spec requires of `divu`/`remu` — three independent sources agreeing on one behaviour,
reached with zero exception logic. Stated here because its absence from the RTL looks like an
omission and is not.

**[DEC] An N-bit `Y` is wide enough — nothing overflows.** The natural worry is that `2A + b` needs
N+1 bits, since `A` can be as large as `X-1`. It cannot happen: after k steps `A` is exactly (the
value of the top k bits of the dividend) minus (partial quotient)×`X`, and the partial quotient is
non-negative, so `A ≤` the value of the top k bits `< 2^k ≤ 2^N`. The bit shifted out of the top of
the upper half is therefore always `'0'`. This is why Figure 9's 2N-bit register with an N-bit
subtractor is correct for **every** divisor, including divisors at or above `2^31` — the case a
naive width argument gets wrong. It is also the only claim in this section that an N=8 sweep cannot
test, so the N=32 directed list aims straight at it.

**[REQ p4, Figure 3] The start is armed once per `DIVENA` assertion, and that is load-bearing.**
Figure 3 makes `DIVstart` an output of the Control Unit, and the Control Unit is combinational
decode of the current instruction. While the core is stalled on a `div`, the `div` *is* the current
instruction — so `DIVstart`, and therefore `DIVENA`, stays asserted for the whole operation and
beyond. A start condition of "`DIVENA` is high" alone would relaunch the divide on the cycle after
it finished, forever, and the core would never see a result. The engine therefore refuses to reload
until it has seen `DIVENA` low. Confirmed to be a real trap rather than a theoretical one:
`tools/model_div_accel.py` was mutated to start on a level, and **property P7 was the sole failure**
— it passes every other check in the suite.

**[REQ p4, Figure 3 — PHASE 7B, recorded now so it is not rediscovered the hard way] The core
cannot stall on "`DIVBUSY` is high".** `DIVstart` has to cross into `DIVCLK` (two stages), the
engine then raises `DIVBUSY`, and `DIVBUSY` has to cross back into `MCLK` (two stages). For several
`MCLK` cycles after the `div` issues, `DIVBUSY` still reads low — so a naive "stall while busy"
stalls for nothing and the core runs straight past its own divide. The stall must begin on the
core's own `DIVstart` and end on a seen-high-then-low `DIVBUSY`. Note that Figure 10 draws only the
operand crossing, MCLK→DIVCLK; the `DIVBUSY` crossing in the other direction is drawn nowhere and is
ours to get right.

**[CODE] `DIVRST` is a functional initialise, not only a power-on reset**, per Hanan's wording (F2).
It is asynchronous and active high, matching every other clocked element in this design, and it
clears the whole engine rather than only the quotient register — which cannot change any result,
since everything it clears is reloaded by the next Load, and which does mean a read before the first
divide returns zero instead of `'U'`. **It must arrive already synchronised to `DIVCLK`**: it
originates in the `MCLK` domain, and an asynchronous reset released in one domain against registers
clocked in another is a recovery/removal violation. That is not a gap — it is what Figure 3's `Sync`
block in front of the accelerator is for, and the block already exists (`SYNC.vhd`, Phase 4A).

**[CODE] The subtractor uses the `-` operator, on Hanan's explicit permission** (F5: *"You may use
the subtraction operator"*, with the advice to check what Quartus synthesises). Taken because this
unit sits on the **fast** clock, so its 32-bit carry path is the accelerator's critical path, and an
inferred subtractor maps onto the Cyclone IV carry chain while a hand-built ripple of discrete gates
may not. The structural alternative is real and already in the material —
`Auxiliary/Lab4/DUT/AdderSub.vhd`, generic n-bit, built from `Lab4/DUT/FA.vhd` — and
its mapping is exact: `x => divisor`, `y => the shifted upper half`, `sub_cont => "001"`,
`s => Y-X`, **`cout` => the Non-negative Result flag** (for `sub_cont = "001"` it forms
`y + not(x) + 1`, whose carry-out is precisely `y >= x`). Written down so the PPA comparison is a
component swap rather than a re-derivation. Deliberately not done in Phase 7A: it is a PPA
experiment, and 7A is the correctness step.

---

## 5A. USART in UART mode — bonus, §6.iv  (numbered 5A so §6–§10 keep their references)

**[REQ p6]** `UTCL` `0x2018`, `RXBF` `0x2019`, `TXBF` `0x201A` — all three Byte resolution, all
three in SFR word 6, `CS_UART`, split by A1..A0 (**F15**: in the peripherals' space any byte
address is meaningful). The chip select and its three lanes have existed and been exhaustively
tested since Phase 5A; Phase 12A is their first consumer.

**[REQ p12]** `UCTL` — the p6 map spells it `UTCL`, the p12 bit-field table is titled `UCTL`. Same
register, two spellings; **open question P3**, and the code uses the table's name.

| 7 | 6 | 5 | 4 | 3 | 2 | 1 | 0 |
| --- | --- | --- | --- | --- | --- | --- | --- |
| BUSY | OE | PE | FE | BAUDRATE | PEV | PENA | SWRST |
| r | r | r | r | w | w | w | w |

- `SWRST` 0 = released for operation, 1 = USART logic held in reset.
- `PENA` parity enable; `PEV` 0 = odd, 1 = even, unused when parity is disabled.
- **`BAUDRATE` 0 = 9600, 1 = 115200.** This **answers open question P4** from the specification
  itself: baud is selected by this one bit and there is no separate `UxBRx`/`UxMCTL` register, which
  is what Figure 11's undocumented "Prescaler/Divider" and "Modulator" blocks had left ambiguous.
- `FE` framing error; `PE` parity error, **"when PENA = 0, PE is read as 0"**; `OE` overrun, set
  when a character is transferred into `RXBUF` before the previous one was read; `BUSY` a transmit
  or receive operation is in progress.

**The contradiction on this page, and how it was resolved.** The feature list a few lines above says
"1-start bit, 1-stop-bit, 8-bit data with **non-parity**", while this table defines `PENA`, `PEV` and
`PE`. Both cannot be true. **Phase 12A read the feature list and left parity out** — `PENA`/`PEV`
stored and inert, `PE` a constant 0 — recorded as **A26**. **Phase 12E reversed that.** The register
table is the more specific source; a generic cannot implement a writable register field; a bit
software can write that changes nothing is a stub; and `PE` is one of the three error flags the
feature list *itself* asks for under "Status flags for error detection". Parity is now runtime,
selected by `PENA`/`PEV` and reported by `PE`. 8N1 remains the reset state and what every supplied
program uses, so nothing that worked before changed. **A26 is retired**; **A30** records what happens
to a character whose parity is wrong.

**[REQ p12]** `RXBUF` holds the last received character, and **"reading RXBUF resets the receive-
error bits, and RXIFG"**. `TXBUF` holds data waiting for the transmit shift register, and
**"writing to the transmit data buffer clears TXIFG"**. Those two sentences are the second halves
of clearing rules b and c in §4 — the "or when serviced" halves are already built in
`INTERRUPT_CTRL.vhd` (`svc_rx_w` / `svc_tx_w`).

### 5A.1 What Phase 12A built

**[OUR CODE + THIRD PARTY]** `UART_PERIPH.vhd` (ours) over `UART_CORE.vhd` (jakubcabal's MIT top
level, adapted) over his `UART_TX`/`UART_RX`/`UART_DEBOUNCER`/`UART_PARITY`. Provenance, md5s and
the exact per-file changes are in `DOC/01` §2.5. Verified by `tb_uart.vhd` — a **real txd→rxd
loopback** for the engine — and `tools/model_uart.py` for the register layer, twelve faithful
mutations all caught.

- **The baud divider is rounded, and that is a finding, not a preference.** The reference truncates
  `CLK_FREQ/(16*BAUD)`; at SMCLK = 20 MHz (**F8**, **F11**) and 115200 that gives 10 → 125 000 baud,
  **+8.5%**, which no 8N1 frame survives. Rounding gives 11 → 113 636, −1.36%. 9600 → 130 → 9615,
  +0.16%. `UART_CORE.vhd` asserts the resulting error at **elaboration** for any `CLK_HZ`, so a
  wrong clock is a compile error and not a dead link on the bench.
- **BUSY is three terms** — receiver mid-frame, transmitter mid-frame, and a byte still queued in
  `TXBUF`. Dropping the third would let a polling loop write over an unsent character.
- **The overrun case that is not one:** a character arriving in the same cycle its predecessor is
  read is not an overrun, because the predecessor was read. The read-clear is sequenced before the
  arrival-set inside one process for exactly this.
- **How software knows a character arrived:** there is no "RXBUF full" bit in the p12 table, by
  design — that is `RXIFG`'s job, read from `IFG` at `0x202D`. Which is why rule b's second half
  (`rx_clr_o`) has to reach the interrupt controller, and does in Phase 12B.

### 5A.1b What Phase 12E built — parity, because a stored bit that does nothing is a stub

**[REQ p12 → CODE]** `PENA` and `PEV` reach the shift registers and `PE` comes back. Two input ports
and one output port on the third-party `UART_TX`/`UART_RX`, and three touched lines in each:

- the `PARITY_BIT` **string generic is gone**, replaced by `PARITY_EN`/`PARITY_EVEN` ports, both
  defaulted so an upstream-style instantiation still means "none";
- `UART_PARITY` is instantiated **unconditionally** with `PARITY_TYPE => "even"` and odd is one
  inversion of it — odd parity *is* the inverse of even parity — so **`UART_PARITY.vhd` stays
  byte-identical to upstream** and no second instance is spent on it;
- the receiver's parity-check register gains **`AND PARITY_EN`**, which is load-bearing: it samples
  on every `rx_clk_en`, not only in the `paritybit` state, so without the gate an 8N1 frame would
  latch a meaningless comparison and *valid characters would be dropped about half the time*.
  Upstream could leave it ungated because the whole process only existed in a parity build.

With `PARITY_EN = '0'` the `paritybit` state is unreachable and the check register is pinned at `'0'`,
so the 8N1 path is **bit-for-bit the path Phase 12A verified**.

**Verified where each half can be.** The register layer: `model_uart.py` phase **P6B**, plus nine
mutations of the parity logic, all nine caught — two of them only after the phase itself was fixed,
because the first draft sampled `RXBUF` one edge too early and tested the no-overrun property on a
buffer that was already full. The engine: `tb_uart.vhd` phase **P9**, which does what a loopback alone
cannot — it **measures the parity bit on the wire**. A `0x00` character is low for 9 bit times in 8N1
and 10 in 8E1, because the data bits and the even parity of zero are all `0`. Then 8O1 round-trips —
which is what discriminates `PEV`, since the two parity bits for a byte are inverses and a receiver
locked to one polarity rejects every frame of the other — a hand-driven frame with an **inverted**
parity bit sets `PE` and is **not delivered**, and a hand-driven frame with the right one is, so the
failure is about parity and not about hand-driven frames.

**Assumptions A25, A27, A28 and A30** are in §10, each with what would falsify it. **A26 is
retired** — it was the assumption that parity could be left out.

### 5A.2 What Phase 12B built — the USART on the bus

**[OUR CODE]** `uart_periph` is instantiated in **both** MCU tops on `CS_UART`'s three lanes, with
`MemRead_i` connected — which is what makes `RXBUF`'s read side effect possible at all. Three new
byte readers join the read path (`NRD_BYTE` 15 → 18, `NRD` 18 → 21).

**[REQ p12 → CODE]** `INTERRUPT_CTRL` gains `rx_clr_i` and `tx_clr_i`, ORed into the raw latches'
clear terms. These are the **software halves of clearing rules b and c**, and they close the two
half-implemented rules §4 has carried since Phase 9A. The three UART event inputs, defaulted to `'0'`
since 9A, are driven now too: every input the controller has finally has a real source, and all seven
vector-table entries of REQ p14 can fire.

**[REQ p6 → CODE]** The USART was the twelfth and last mapped SFR word to be attached, so the
simulation-only stub notice changed meaning rather than being deleted: a write that still reaches it
means the target is **read-only by design**, and the only two such words left are `PORT_SW` and
`PORT_PB`.

**[REF]** The two board pins come from the course's own Terasic table,
`Auxiliary/Lab4/Auxiliary/DE2_115_pin_assignments.csv`: `UART_RXD` = **PIN_G12** (input),
`UART_TXD` = **PIN_G9** (output), 3.3-V LVTTL. `UART_CTS` (PIN_G14) and `UART_RTS` (PIN_J13) are in
that table too and are deliberately left unassigned — 8N1 with no hardware flow control.

Verified by `tb_uart_mmio.vhd`: the bench ties `UART_RXD_i` to `UART_TXD_o` — what a loopback plug on
the DB9 does — and 22 scored stores are exact. Two of them exist only because mutation testing showed
the first draft could not see a fault: rule c was unobservable until a round enabled `TXIE`, and with
a loopback `RXBUF` and `TXBUF` hold the same byte at every natural scoring point, so one moment is
now engineered where they differ (`TXBUF` = `0x71` while its frame is on the wire, `RXBUF` still
`0x3C`).

### 5A.3 What Phase 12C built — the clause 8 menu

**[REQ p12, clause 8]** The menu, transmitted MCU → PC, with five items. Implemented as an
interrupt-driven server: `ISR_RX` delivers each command, `ISR_BT` is the ~0.5 s tick (Basic Timer
`EQU0`), `ISR_KEY1` arms the message, and one polling main loop pushes a character per pass whenever
the transmitter is not `BUSY`.

**Item 1 says `LEDG`.** The board *has* nine green LEDs — the Terasic CSV lists `LEDG[0..8]` with
pins — but **clause 4's output interface is the ten red LEDs and clause 5's GPIO table has exactly
one LED register**, `PORT_LEDR` at `0x2000`. There is no memory-mapped path to `LEDG` anywhere in the
specification, and `LEDG` appears in the document exactly once, in that line. **Our design decision:**
item 1 counts up on `PORT_LEDR`, and the transmitted text says `LEDR` so the operator reads what the
board does. Recorded as **R2**; inventing a `PORT_LEDG` register would be adding an address the
specification does not contain.

**One program, two data images.** The ITCM is byte-identical for the board and for simulation (the
generator asserts it); a single DTCM word, `V_HALFSEC`, carries `9,999,999` for the board — 10,000,000
SMCLK ticks = 0.5 s at 20 MHz with `BTSSEL = 00`, cross-checked against the supplied benchmarks'
`SEC_PERIOD = 20,000,000` for one second at the same setting — and `1,999` for simulation.

**Register discipline, stated because there is no context save:** the three handlers touch only
`t3`/`t4` and read-only address registers; the main loop uses only `t0`/`t1`/`t2` and the
s-registers. An interrupt can therefore land between any two instructions of main without corrupting
it. The supplied ISRs in `test1` rely on the same convention informally.

Verified by `tb_uart_menu.vhd`, the first bench in this project that acts as a **third party** rather
than an observer: it shifts characters onto `UART_RXD_i` at the real bit time and decodes
`UART_TXD_o` mid-bit, then works the menu as a person would. Its two expected strings are
**generated**, and `gen_uart_menu.py` reads the testbench back and fails if they have drifted from
the DTCM image.

## 5B. The PPA tables — three tables, three rows each  *(added 2026-08-27)*

**[REQ p10, §6]** Three tables, each ending *"Attaching the print screen of the Quartus … report is
mandatory"*:

| table | columns |
| --- | --- |
| Area | Logic elements, Registers, I/O pins, Embedded memory bits, Embedded 9-bit Multipliers, PLLs |
| Performance | `f_max`, Critical path (*"what is the slowest submodule and why does it cause the critical path"*), `f_MCLK (= f_sysclk)` |
| Power | Total, Static, Dynamic, I/O power consumption |

**All three have the same three rows**, and this is the part nothing in this project had recorded:

| row | the document's label | the build |
| --- | --- | --- |
| 1 | MCU with GPIO | single-cycle, **no interrupt capability** |
| 2 | MCU with GPIO and Interrupt Capability | single-cycle, complete |
| 3 | Pipelined MCU with GPIO and Interrupt Capability | the pipeline, complete |

**[REQ p5 / p6]** Which peripherals row 1 drops is settled by the two clause titles, not by
interpretation. §5: "GPIO peripherals … **without** interrupt capability" — eight devices,
`PORT_LEDR`, `PORT_HEX0..5`, `PORT_SW`. §6: "Peripherals **with** interrupt capability" — twelve
addresses, `PORT_PB` + the USART's three + the Basic Timer's five + `IE`/`IFG`/`TYPE`. So **`PORT_PB`
is in the interrupt half.** It reads like a GPIO input port and is easy to file under §5 by mistake;
the specification puts it in §6 because the KEYs are an interrupt source.

**[OUR CODE]** `GEN_INTERRUPT` on `RV32IMscMCU` (default `G_GEN_INTERRUPT`, `True`) is row 1's
switch. §7's own wording endorses the mechanism: SignalTap pins *"need to be removed in the final
step using a suitable parameter in the generate VHDL statement"*.

**Assumption A29:** row 1 means "none of §6's twelve addresses", and the CPU core is the same core in
both rows. What would falsify it: a statement from Hanan that row 1 also drops the divider
accelerator (§6.iii, which has no MMIO address and is part of the CPU as we read it), or that row 1
keeps `PORT_PB` because it is physically a GPIO device.

**The residue, stated because a PPA number must be honest:** with `GEN_INTERRUPT => FALSE` the core
is untouched and `intr_i` is tied to `'0'`, so the entry FSM collapses by constant propagation — but
`reti` stays decoded in `CONTROL` and its GIE side door in `IDECODE` survives. One AND gate and one
register-bit write path. Verified to work, not merely to compile, by
`SIM/RV32IMscMCU/run_ppa_row1.do`.

## 6. Clocks

**[REQ p3, Figure 1]** `baseclk50MHz → Clock Tree → mclk, accelclk, smclk`. Three named clocks:
`mclk` to the RISC-V core, `smclk` to the peripherals, `accelclk` to the accelerator.

**[REQ p16]** The PPA performance table's third column is `f_MCLK (= f_sysclk)`, so `mclk` is the
system clock the tables report.

**[REQ p7, Figure 7]** The Basic Timer's `BTSSEL` mux input is `SMCLK`.

**[REQ p9]** The divider's `DIVCLK` is "fast clock" — corresponding to `accelclk`.

**No numeric frequency is stated anywhere in the specification** except the string `baseclk50MHz`
inside the Figure 1 image. Verified by searching the whole document.

**[CODE]** `cond_compilation_package.vhd:58-59` sets `G_PLL_DIV = 2`, `G_PLL_MUL = 1`, giving
50 ÷ 2 = **25 MHz**, and both Lab 5 SDC files document 25 MHz.

**[CODE]** `Auxiliary/Lab 5/Auxilary/RV32I/QUARTUS/SDC/RISCV_simple.sdc` constrains the *input port* at 50 MHz —
`create_clock -name clk -period 20 [get_ports {clk_i}]` — and then `derive_pll_clocks
-create_base_clocks`, letting the tool derive the PLL outputs.

**[BENCH]** `SEC_PERIOD` and `FREQ_5K` are both annotated `# in case of SMCLK=20MHz`, and `FREQ_5K`
resolves exactly at 20 MHz ÷ 8 (see §3.2).

**[CODE]** All three ALTPLL copies in the material expose only `c0`. ~~A three-output clock tree
requires regenerating the megafunction.~~ **Superseded 2026-08-24 by forum answer F6:** three
separate PLL instances, so nothing is regenerated. What was actually missing was a per-instance
ratio — `PLL.vhd`'s entity has no generics at all. See §6.1.

**[DEC]** Target `SMCLK = 20 MHz`. **Assumption:** `MCLK = SMCLK = 20 MHz` unless course staff say
otherwise. **[REC]** 20 MHz also buys timing headroom the design needs: the single-cycle core closes
at only 26.81 MHz *before* any peripheral is added, and the MMIO decoder lands in its critical path.
**Falsified by** course staff specifying `MCLK ≠ SMCLK`, or by a required `f_MCLK` above 20 MHz.

**Assumption:** `ACCELCLK = 50 MHz`, the undivided board clock, since §6.iii calls `DIVCLK` the fast
clock and 50 MHz is the only faster clock available. **Falsified by** timing closure failing at
50 MHz for the divider, or by a stated value.

### 6.1 What Phase 4B built, and the conflict it had to resolve

**[CODE, ours]** `DUT/RV32IMscMCU/CLOCK_TREE.vhd` and `DUT/RV32IMscMCU/PLL_GEN.vhd`, verified by
`TB/RV32IMscMCU/tb_clock_tree.vhd`. The leaf only — wiring it in, releasing reset on lock and
constraining the three clocks in the SDC are Phase 4C.

**[CODE] The roadmap's stated blocker was the wrong one, and the real one is smaller.** The plan said
Phase 4B needed the ALTPLL regenerated for `c1`/`c2`. Forum answer F6 removed that — three separate
instances, not one multi-output PLL. But three instances of `PLL.vhd` would produce **three copies of
one frequency**, because `PLL.vhd`'s entity takes **no generics at all**: its ratio comes from
`G_PLL_DIV`/`G_PLL_MUL` in `cond_compilation_package.vhd`. That is the actual obstacle, and the fix is
a per-instance ratio, not a regenerated megafunction.

`PLL_GEN.vhd` promotes four constants to generics — `clk0_divide_by`, `clk0_multiply_by`,
`inclk0_input_frequency`, `intended_device_family`, plus the `lpm_hint` string. **Every one already
appears in `PLL.vhd`'s own `altpll` component declaration and is already passed by it**, so nothing
new is asserted about the megafunction. That distinction matters: adding `clk1_*`/`clk2_*` generics,
which appear in no file we have, *would* have been the unverifiable-parameter risk the roadmap warned
about, and this deliberately is not that.

**[DEC] `PLL.vhd` is left byte-identical rather than edited.** Its md5 is
`a12064f21cedbb715db75713499dc998` in all four places it exists — our `DUT` copy, `Lab 5/DUT/RV32IM_sc`,
`.../RV32IM_pipeline` and Hanan's `Auxilary/DUT` — making it the one file whose provenance needs no
argument. The price is ~60 lines of duplicated `altpll` component declaration, accepted knowingly.

**Assumption A19 — when `MCLK` and `SMCLK` are the same frequency they share one PLL and one net.**
This is the one genuine conflict in the phase, and it is a design decision, not a reading.

- **F6** says the three clocks come from three separate PLL instances.
- **F7** says `MCLK` and `SMCLK` may be the same value.
- Do both literally and you get **two independent PLLs each producing 20 MHz.**

That combination has a defect. The core drives address, write data and `MemWrite` on `MCLK`; every
peripheral register captures that bus on `SMCLK` — `gpo_port` does exactly this, and F11 says the
peripheral registers should be DFFs on `SMCLK`. Two PLLs locked to the same 50 MHz reference are
frequency-identical, but **nothing specifies their output phase relationship**, so the setup/hold
margin on that capture is whatever the fitter happens to produce, Quartus has no basis on which to
analyse it, and Figure 5 draws no synchroniser anywhere on the GPIO write path. It would probably
work on the bench and it cannot be shown to work — which is the failure mode that appears during a
demonstration.

The reading A19 rests on: F6 answers *how to produce three clocks* — do not try to make one PLL emit
three — rather than mandating that two clocks of equal frequency be electrically distinct nets. F7
permitting `MCLK = SMCLK` as *values* supports that, since two independent PLLs at one frequency buy
nothing and cost analysability. **Falsified by** course staff saying `MCLK` and `SMCLK` must be
separate nets even at equal frequency, in which case the MMIO bus needs synchronisation that nothing
in the assignment draws. One generic: `SMCLK_SHARES_MCLK => FALSE`. Raised in `DOC/05`.

**[CODE] The ratios are checked at elaboration, not trusted.** `50000 kHz × 2 = 20000 kHz × 5` for
`MCLK` and `SMCLK`, `× 1 = × 1` for `ACCELCLK`, cross-multiplied in integer kHz so nothing rounds.
A further check refuses `SMCLK_SHARES_MCLK = TRUE` together with `SMCLK_KHZ /= MCLK_KHZ`, since one
net cannot carry two frequencies and the symptom would be every Basic Timer interval silently wrong.

**[CODE] In simulation `MCLK` *is* `clk_i`**, exactly as `RV32IM_CORE.vhd` already does at
`MODELSIM = 1`. This is deliberate and it is the property Phase 4C depends on: the four benchmark
counts 134 / 1514 / 2725 / 2735 must survive 4C unchanged. `ACCELCLK` is generated at a period
deliberately **coprime** with the testbenches' 100 ns clock (reducing to 10:3), so the fast edge walks
through every phase of the slow one — the same argument as `tb_sync.vhd`'s 70/30, and the property
Phase 7B's crossing needs in order to be exercised at all. It does **not** reproduce the real 5:2
ratio and is not trying to.

### 6.2 What Phase 4C did with it

**[CODE, ours]** `RV32IMscMCU.vhd`, `RV32IM_CORE.vhd`, `aux_package.vhd` and
`Quartus/RV32IMscMCU/RV32IMscMCU.sdc`. No new files.

`clk_i` — the 50 MHz board oscillator — now enters `CLOCK_TREE` **and nowhere else**, which is what
Figure 1 draws. The core receives `mclk` on its `clk_i`; the internal PLL generate is gone and the
transitional `mclk_o` port that Phase 6A added is removed. The peripherals move to `smclk_w` (the
same net as `mclk_w` under A19's default). `PLL.vhd` is now instantiated by nothing — it stays
compiled and byte-identical, because its provenance is worth more than a tidy file list.

**[DEC] Reset is held until the PLLs report lock**, behind `GEN_RESET_ON_LOCK` (default `TRUE`).
Before lock a PLL output is not a valid clock — it can be stopped, at the wrong frequency, or
glitching — so releasing reset into it is how a design comes up differently on different power-ons.
`Auxiliary/Lab4/DUT/fpga_hw_interface.vhd` captures `pll_locked` and `PROJECT_EXPLANATION.md` §9.3
records that it then leaves it **unused**, so this is a deliberate improvement over the reference and
the report should present it as one. The clock tree's own `areset` keeps the *unconditioned* reset: a
PLL held in reset by its own lock signal would never lock.

**[DEC] Why the four benchmark counts must not move, stated so that a change is a finding.** In
simulation `CLOCK_TREE`'s `mclk_o` **is** `clk_i` — the same tie the core previously made for itself
at `MODELSIM = 1` — so the clock is bit-identical. And `mclk_cnt_q` is held at zero by reset and
starts counting when reset releases, while the program starts executing at that same moment: holding
reset until the modelled 200 ns lock shifts both together, so the count at the benchmark's self-jump
is unchanged. Only the wall-clock time at which the simulation ends moves. `GEN_RESET_ON_LOCK =>
FALSE` isolates the reset change from the clock change in one run if a count does move.

**[CODE] The SDC was rewritten and the old one was wrong twice over** — it named `RV32IM_CORE` as the
top (untrue since Phase 1) and documented a single 25 MHz PLL output (untrue since 4B). It now
constrains the one real clock and lets `derive_pll_clocks` produce the rest, and it writes out two
conditionals rather than leaving them to be rediscovered: what must be added if `SMCLK_SHARES_MCLK`
is ever set `FALSE`, and the ACCELCLK clock-group statement — **deliberately commented out** until
Phase 7B, because `accelclk` has no load today, Quartus prunes that PLL, and a `set_clock_groups`
whose collections match nothing is a constraint that looks applied and is not.

**Modelling limitation, recorded rather than discovered later:** the simulated `locked` is one-shot
and ignores `rst_i`. A real PLL drops lock when its `areset` is asserted; this one rises once at
`SIM_LOCK_DELAY_NS` and stays high. No current testbench asserts reset twice — all six drive it high
from 0 ns and low at 80 ns — so the simplification is acceptable, but a reset-recovery test written
against this model would prove nothing.

**What none of this verifies: the PLLs themselves.** `altpll` is a black box needing `altera_mf`, and
the course's own idiom is not to instantiate it in simulation. Whether three `pll_gen` instances lock
at the right frequencies on a Cyclone IV E is a Quartus question, on Adar's list. Two specific
unknowns are recorded there: the inherited `intended_device_family => "Cyclone II"` against the
board's Cyclone IV E (left at the known-working value), and whether three instances with different
parameters may share one `CBX_MODULE_PREFIX`.

---

## 7. IPC and validation instrumentation

**[REQ-L5 p8, clause 6.iii.b]** The IPC equation the final-project document references but does not
contain:

```
IPC = ( CLKCNT_o − ( STCNT_o + 4 + depth · FHCNT_o ) ) / CLKCNT_o
    = InstructionCounter / CLKCNT_o                        where IPC = 1/CPI
```

**[REQ-L5 p8, clause 6.iii.a]** `SignalTap trigger = ( IF_pc == BPADDR_i )`

**[REQ-L5 p8]** SignalTap capacity:
`STdepth = ( Embedded memory size − Design usage memory size ) / #ST channels`

**[REQ-L5 p8]** `STCNT_o` is an 8-bit stall counter, cleared on reset, counting on the rising edge
when a stall occurs. `FHCNT_o` is an 8-bit flush counter, same conditions. `BPADDR_i` is an 8-bit
breakpoint address of **word granularity**, cleared on reset, fed by SW7–SW0.

> **The submitted design deliberately exceeds this width, and it had to.** The revised pipeline
> declares `STCNT_WIDTH` and `FHCNT_WIDTH` as **16**
> (`Auxiliary/Lab 5/DUT/RV32IM_pipeline/RV32IM_PIPE_CORE.vhd`), because test3 and
> test4 produce roughly 298 and 304 flushes — an 8-bit counter wraps at 255 and the IPC equation
> would then be computed from a wrapped value. `DOC/HANDOVER_Report_lab5.md` §4.3 records the change.
>
> This is a **design decision, not a requirement**, and the report must say so rather than presenting
> 16 bits as what p8 asked for. Our wrapper follows the implementation at 16 bits.
>
> A related change in the same revision: `STCNT` now increments only when `stall = '1' AND
> flush = '0'` (§4.4). A stall coinciding with a MEM redirect is moot — the flush already costs
> `depth = 3` in the IPC equation — so counting it would double-charge. `Auxilary/Ori/` counts
> unconditionally (`RV32IM_CORE.vhd:558`) and is the counter-example.

**[REQ-L5 p7]** Conditional branches and unconditional jumps are resolved in **pipeline stage 4**.

**[REQ p17, §8.c.iii and §8.e.iii]** Both reference "clause 6.iii.b". **That clause does not exist
in the final-project document** — its §6.iii is the divider diagram and has no lettered sub-items.
The equation is in the LAB5 PDF. Recorded so nobody hunts for it again.

**[REQ p17, §8.c.i]** ModelSim golden comparison: RARS `DTCM.h` against ModelSim `DTCM.mem`.
**[REQ p17, §8.e.i]** ISMCE golden comparison: RARS `DTCM.hex` against ISMCE `DTCM.hex`.

**[BENCH]** This is why the two image formats differ and must not be interchanged. `bin/M9K-intel/*.hex`
uses `auipc imm = 0x00000` (text base 0) and is the ITCM source; `bin/Hexadecimal-Text/ITCM.h`
retains RARS's `0x3000` base and is **not** loadable. The `.h` files are the DTCM golden text, which
is exactly what §8.c.i asks for.

---

## 8. Verification 3 — the MMIO map is bijective. **PASS.**

- Every one of the twenty addresses in §5 and §6 appears in every `io_map.s`, with the same value.
- Every address any `io_map.s` defines appears in §5 or §6. No extras.
- The GPIO suites define the timer and interrupt-controller addresses too, even though they never
  use them — so all seven `io_map.s` files carry the identical canonical map.

Only naming differs: `RXBF`/`TXBF` (spec) vs `RXBUF`/`TXBUF` (benchmarks), and `UTCL` (p6 map) vs
`UCTL` (p12 register table).

---

## 9. Submission

**[REQ p18, §10.8]** `id1_id2.zip` with `id1 < id2`, uploaded to Moodle only by the student with
`id1`. Any violation disqualifies the submission. Here: `209580208_211468582.zip`, uploaded by
209580208.

**[REQ p18, Table 1]** The ZIP contains "the next six subdirectories (only the exact next sub
folders)" — above a table listing **five**: `DUT`, `TB`, `SIM`, `DOC`, `Quartus`.

**[REQ-L5 p10, §9.g]** The LAB5 document uses the *identical* wording — "the next six
subdirectories" — above a table listing the same five. Lab 5 was submitted with five and accepted.

**[DEC]** Five directories. The word "six" is an inherited typo, and the precedent is direct.

**[REQ p18]** Subfolder names for this project are `RV32IMscMCU` and `RV32IMpipelinedMCU` — *not*
Lab 5's `RV32IM_sc` / `RV32IM_pipeline`. Testbench filenames `tb_RV32IMscMCU.vhd` and
`tb_RV32IMpipelinedMCU.vhd`. `DOC` holds `Readme.txt` and `Final_report.pdf`. `Quartus` holds a
SignalTap file, an SDC file and a SOF file per design, and "Do not place files that are not relevant
for compilation or a result of compilation!"

**[REQ p17, §10]** The prose says the report is `final.pdf`; Table 1 says `Final_report.pdf`.
**[DEC]** `Final_report.pdf`, matching the table, which is the more specific statement. Open
question 7.

---

## 10. Assumption register

Everything in this document that is not cited to a source.

| # | Assumption | Basis | Falsified by |
| --- | --- | --- | --- |
| ~~A1~~ | `SMCLK = 20 MHz` — **CONFIRMED 2026-08-24, no longer an assumption.** Stated in Hanan's own words in `Intrrupt-based IO/ReadMe.txt`: *"value of 0x01312D00 is for SMCLK=20MHz"* | — | — |
| ~~A2~~ | `MCLK = SMCLK` — **CONFIRMED 2026-08-24.** Hanan, on whether the three clocks may share a frequency: *"since you are working with a single-cycle base CPU (not a pipeline) running at a low frequency … your values may be identical, i.e. MCLK = SMCLK"* | — | — |
| A3 | `ACCELCLK = 50 MHz` | §6.iii calls DIVCLK the fast clock; 50 MHz is the only faster clock | Timing closure failure, or a stated value |
| A4 | `BTSSEL` is `00`→÷1 … `11`→÷8 as Figure 7 draws it | Figure 7 mux labels; the `BTSSEL=SMCLK` author comment on `0x26`; `FREQ_5K` resolving exactly | Course staff reversing it — but then `FREQ_5K` breaks |
| A5 | The benchmarks' "1sec" comments are wrong, not the `BTSSEL` table | Three-to-one evidence, §3.2 | Course staff confirming a 1 s period at `BTSSEL=3` |
| ~~A6~~ | ~~`IFG` holds the raw latched flag; `IE` masks only toward `INTR`~~ — **FALSIFIED 2026-08-24 by Hanan's forum answer.** `IFG` is the **masked** value: *"the flag accumulated as '1' in the IFG register depends on BOTH conditions, interrupt request AND interrupt enable; if either is zero the flag drops to zero and the meaning is that the source is not pending"*, and `IFG` only rises when `IE = 1`. The single-source diagram's `IFGx` label on the `irq AND eint` output was the correct reading after all. Phase 9 follows this. | — | — |
| ~~A7~~ | Divider operand/result registers are core-internal — **CONFIRMED 2026-08-24.** Hanan on `DIVRST`: it initialises the divider's internal quotient shift register *"in parallel with writing the Dividend, Divisor values into the **core's** registers"* | — | — |
| A8 | Five submission directories, not six | LAB5 uses identical wording and was accepted with five | Course staff naming a sixth |
| A9 | `Final_report.pdf` | Table 1 is more specific than the prose | Course staff preferring `final.pdf` |
| A10 | Board is DE2-115 | All Lab 5 material and the students' own hardware runs target it | Course staff naming DE10-Standard |
| A11 | The upper 24 bits of an MMIO read return zero | Figure 5 drives only `Data<7..0>` from the `PORT_SW` tri-state; all three MMIO reads in the benchmarks `andi` the result immediately | A program that uses the upper bits of an MMIO read |
| A12 | A Word-resolution register owns all four lanes of its word | §6's table gives `BTCMPR0`/`BTCMPR1`/`BTCAPR` Address Resolution "Word", and `io_map.s` marks them "define a Word address" | A byte-resolution use of any of those three |
| A13 | A GPO port holds zero after reset — LEDs off, every HEX showing `0` | Nothing states a reset value and Figure 5 draws no reset on the latch at all; zero needs no extra state, whereas "blank until first written" needs a flag nothing asks for | Any statement that the displays should be dark after KEY0 |
| A16 | `PORT_PB` reads `'1'` for a **pressed** key — i.e. the active-low pushbuttons are inverted at the board boundary | The bit **order** is Hanan's forum answer and is not assumed; the **polarity** is stated nowhere, and no supplied program reads `PORT_PB` at all. Grounds: `Auxiliary/Lab4/DUT/fpga_hw_interface.vhd:37-38` does exactly this for all four keys, and this design already does it for KEY0 via `RST_ACTIVE_LOW` | Course staff saying `PORT_PB` presents the raw pin. One word: `KEY_ACTIVE_LOW => FALSE` |
| A15 | The seven GPO ports are readable (Figure 5's `MemRead` tri-state), despite clause 5's Direction column saying `GPO` | Figure 5 draws the buffer inside every output-port block; a read-back register is the ordinary MMIO arrangement, and "GPO" plausibly describes the device | Course staff saying an output port must not respond to a read |
| ~~A14~~ | A `PORT_HEXn` register is 8 bits wide and the display decodes bits 3..0 — **CONFIRMED 2026-08-24.** Hanan, asked whether HEX0 and HEX1 are needed together to show one value: *"each HEX stands on its own"* | — | — |
| A17 | All five Basic Timer interface registers are readable as well as writable, `BTCTL2` included | One of the two forum lines that could not be transcribed with full confidence appeared to make `BTCTL2` read-only, but `BTCTL2` is the capture-control register and the applications do write to it. Asked rather than assumed — `DOC/05` §2 | Course staff confirming `BTCTL2` is read-only |
| A18 | Figure 9's blocks are interconnected as classical restoring division | The figure is a raster image and its bit-level wiring is not legible; this is the only interconnection of those blocks that yields a correct quotient and residue. Verified exhaustively at N=8, all 65536 pairs | Course staff describing a different interconnection |
| A19 | When `MCLK` and `SMCLK` are configured to the same frequency they share **one PLL and one net** | F6 (three instances) and F7 (equal values permitted) taken literally together give two independent PLLs at 20 MHz, across which the core drives a synchronous parallel bus into peripheral registers (F11) with no synchroniser drawn anywhere. Two PLLs on one reference are frequency-identical but phase-unspecified, so that capture cannot be timing-analysed. See §6.1 | Course staff saying the two must be separate nets even at equal frequency. One generic: `SMCLK_SHARES_MCLK => FALSE` |
| A20 | `BTINT`: `01`→EQU1 and `11`→no source | `00`→EQU0 and `10`→capture are **benchmark-pinned** (`BTINT2=0x02` set exactly when test4 configures capture; every compare test uses 0); EQU1 is the only source left and page 8 says "three options" | Course staff giving a different table — one selected-signal assignment in `BASIC_TIMER.vhd` |
| A21 | `BTCL0`/`BTCL1` shadow latches load on the bus write | Figure 7's latch-enable label `HEU0` is defined nowhere (open question P1); immediate transfer is indistinguishable in every supplied benchmark, which all configure the compare registers while the timer is held | `HEU0` turning out to mean update-on-EQU0 — one enable term |
| A22 | A masked interrupt request is invisible but **remembered**: the raw latch keeps it, and setting the IE bit later makes the flag reappear | The p13 diagram's flop has D='1' and no enable — IE lives one AND gate downstream, on the product the diagram itself labels `IFGx`; the prep session restates the same structure ("the flop output irq is the raw latch; what the register exposes is the AND"). No benchmark can tell: all four clear `IFG` while `IE=0` and only then enable — the W0C store clears the raw latches, which `tb_interrupt_ctrl` P3 proves as the exact test1 init pattern | A benchmark (or Hanan) expecting silence when IE is enabled over an uncleared request — the fix is one AND gate on the set path, and mutant M1 already models it |
| A23 | The one `RXIFG` bit presents TYPE `08h`, never `04h` | One flag serves two vector-table rows (p14); §4.1 shows words 1 and 2 of every benchmark vector table hold the **same** handler, so the choice cannot change behaviour in any supplied program. Open question 4 / P2 stays open for Phase 12, where the UART could tell error from data at the source | Hanan specifying the error code must win — a side latch remembering which event set the bit, Phase 12 |
| A24 | Software cannot **set** an `IFG` bit — writes are W0C (0 clears the raw latch, 1 leaves it) | The p13 flop has no software-set path drawn; the only software access in any benchmark is the ISR read-modify-write idiom, which W0C serves exactly (and a hardware set beats a same-edge software clear, so a flag arriving between the `lw` and the `sw` survives) | A benchmark or answer requiring software-triggered interrupts — a write-through arm on the latch, and mutant M3 already models it |
| A25 | `UCTL` resets to `0x00`, so `SWRST = 0` and the USART is operational out of reset | The p12 table gives SWRST's two meanings but **no reset value**; the MSP430 this peripheral is modelled on resets it to 1. Every other peripheral here resets its interface registers to zero (F16 for the timer), and firmware written either way still works — an MSP430-style driver clears SWRST first, which is a no-op here | A supplied firmware that depends on the USART being *held* in reset until it is configured. One reset value to change |
| A26 | ~~**Parity is not implemented — the frame is 8N1.**~~ **RETIRED 2026-08-27 by Phase 12E: parity is implemented, at runtime.** The assumption was that REQ p12's feature list ("8-bit data with non-parity") outweighed the same page's UCTL table, which defines `PENA` as "Parity enabled. Parity bit is generated (TXD) and expected (RXD)", `PEV` as odd/even and `PE` as a readable error flag. That was the cheap reading, not the right one: a generic cannot implement a writable register field, a bit software can write that changes nothing is a stub, and `PE` is one of the three error flags §6.iv's own feature list requires ("Status flags for error detection"). The predicted cost — "a runtime *is there a parity bit* input threaded into the author's RX and TX state machines" — was right, and it came to two ports and three touched lines per file | The specification's own register table, which is the more specific of the two conflicting statements | Nothing now: both readings are satisfied. 8N1 is still the reset state and what every supplied program uses, `PE` still reads 0 whenever `PENA = 0` — the specification says so outright — and `PENA = 1` now does what the table says it does |
| A27 | `TXBUF` is readable | The p12 text calls it "user accessible" and the MSP430's is readable; no supplied program reads it | Nothing that matters — if it should be write-only, delete one reader |
| A28 | Switching `UCTL[3]` mid-character corrupts that character; no hardware interlock is built | Nothing in the specification describes an interlock, and one would silently delay a software write. What *is* built is `UART_CORE`'s `>=` compare, so a downward switch cannot strand the divider counter above its new maximum — that part is not left to software | A requirement that the rate change take effect only at a frame boundary — one gating term on the counter's maximum |

| A29 | PPA table row 1, "MCU with GPIO", means none of §6's twelve interrupt-capable addresses — so no interrupt controller, no Basic Timer, no USART and no `PORT_PB` — while the CPU core is the same core as in row 2 | The two clause titles: §5 is "GPIO peripherals ... **without** interrupt capability" (eight devices), §6 is "Peripherals **with** interrupt capability" (twelve addresses, `PORT_PB` among them). The row labels are the document's own | A statement that row 1 also drops the divider accelerator (§6.iii, no MMIO address, part of the CPU as we read it), or that it keeps `PORT_PB` because that device is physically GPIO |
| A30 | A character whose parity bit is wrong is **not delivered**: `RXBUF` keeps what it held, `RXIFG` is not raised by it, and software learns of it through `PE` and the status-error interrupt (TYPE 04h) | This is the third-party receiver's own behaviour, not ours — `uart_rx.vhd` holds `DOUT_VLD` low for a parity-errored frame (`DOUT_VLD <= NOT rx_parity_error AND UART_RXD`), and it was kept rather than changed. REQ p12 defines `PE` and says nothing about whether the character is delivered | A statement that a parity-errored character must still land in `RXBUF` (which is the MSP430's behaviour). The cost is one term in `UART_RX`'s output register and one line in the register layer, both already identified |

Thirty assumptions, one of them (A26) since **retired**, of which **five were settled by Hanan's forum answers on 2026-08-24** — A1, A2, A7 and A14 confirmed, and **A6 falsified**. A17 was raised in `DOC/05` on the same day and is entered here only now; A18 came out of Phase 7A, A19 out of Phase 4B, A20/A21 out of Phase 8A — note A20 is only the half of B4 the benchmarks do NOT pin — A22/A23/A24 out of Phase 9A (the falsified-A6 structure's observable corners: the masked-request memory, the `RXIFG` TYPE choice, and W0C), and A25–A28 out of Phase 12A (the USART: its reset value, the 8N1 frame, a readable TXBUF, and baud switching being a program-order responsibility), A29 out of Phase 14 (what PPA row 1 contains), and A30 out of Phase 12E (what happens to a parity-errored character). **A26 is the one that has been retired**: Phase 12E implemented the parity it assumed away. **A19 is the one to send with A15** — like A15 it is a genuine conflict between two sources rather than a gap, and it decides whether the core-to-peripheral bus is one clock domain or two. See `DOC/03_open_questions.md`, section "ANSWERS FROM HANAN'S FORUM", for the wording of each and for the three answers that contradict code already written.

None blocks Step 2. A1, A2, A4 and A5 must be settled before the Basic Timer
(roadmap Step 9) is verified against real constants; A10 before pin planning. A11 and A12 came out of
Phase 5A and are both exercised by `TB/RV32IMscMCU/tb_addr_decoder.vhd`, so if either is wrong the
change is one line in `const_package.vhd` and the exhaustive sweep re-proves the whole map. A13 and
A14 came out of Phase 6A; both are one line in `GPO_PORT.vhd` or in the `SEGGEN` generate of
`RV32IMscMCU.vhd`, and `tb_gpio.vhd` re-proves the display path either way. **A15 is the one to send
Hanan** — it is a genuine contradiction between clause 5's table and Figure 5, not an ambiguity, and
it decides whether Phase 6B builds seven read-back paths or none.
