Adar-Shapira/rv32im-mcu-project/Auxiliary/hanan/Fundamental_Concepts_and_ISA_G.md

361-1-4201
Computer Architecture
Lecture 1: Fundamental Concepts
and ISA
Lecturer: Dr. Guy Tel-Zur

Based on a course by Prof. Onur Mutlu

Carnegie Mellon University

Spring 2015

V 1.0, 19/03/2020
V 1.1, 3/3/2021
V 1.2 24/3/2022
V 1.3 8/3/2023
V2 8/5/2024

Computer Architecture in Levels of Transformation

Problem

Algorithm

Program/Language

Runtime System
(VM, OS, MM)

ISA (Architecture)

Microarchitecture

Logic

Circuits

Electrons

 האירק: Patt, “Requirements, Bottlenecks, and Good Fortune: Agents for

Microprocessor Evolution,” Proceedings of the IEEE 2001.

3

Levels of Transformation, Revisited

 A user-centric view: computer designed for users

Problem

Algorithm

Program/Language

User

Runtime System
(VM, OS, MM)

ISA

Microarchitecture

Logic

Circuits

Electrons

 The entire stack should be optimized for user

4

What is Computer Architecture?

 The science and art of designing, selecting, and

interconnecting hardware components and designing the
hardware/software interface to create a computing system
that meets functional, performance, energy consumption,
cost, and other specific goals.

 We will soon distinguish between the terms architecture, and

microarchitecture.

םג ומכ הרמוח יביכר ןיב רושקלו רוחבל ןנכתל תונמואהו עדמה
בשחמ תכרעמ רוציל ידכ הנכתל הרמוחה ןיב קשממ ןנכתל
 ,
היגרנאה תכירצב םיעוציבב תוילאנויצקנופה תושירדב תדמועש
.
תופסונ תויפיצפס תורטמבו תולעב

 ,

 ,

:
בשחמ תרוטקטכירא רידגנ
 ,

5

An Enabler: Moore’s Law

Reading
 Assignment!

סוחדל

Moore, “Cramming more components onto integrated circuits,”
Electronics Magazine, 1965.       Component counts double every other year

Image source: Intel

.םידומע

3

 כ"הסב

Moodle

 -ה רתאמ םג הדרוהל ןתינ  רמאמה

6

Number of transistors on an integrated circuit doubles ~ every two years

Image source: Wikipedia

7

Required Reading

Reading
 Assignment!

 Moore, “Cramming more components onto integrated

circuits,” Electronics Magazine, 1965.

 Only 3 pages

 A quote:

   “With unit cost falling as the number of components per circuit
rises, by 1975 economics may dictate squeezing as many as 65
000 components on a single silicon chip.”

 Another quote:

    “Will it be possible to remove the heat generated by tens of

thousands of components in a single silicon chip?”

.םידומע

3

 כ"הסב

Moodle

 -ה רתאמ םג הדרוהל ןתינ  רמאמה

8

What Do We Use These Transistors for?

 תצלמומ האירק

 Your readings for this week should give you an idea…

 Patt, “Requirements, Bottlenecks, and Good Fortune:

Agents for Microprocessor Evolution,” Proceedings of the
IEEE 2001.

9

Computer Architecture Today (I)

 Today is a very exciting time to study computer architecture

 Industry is in a large paradigm shift (to multi-core and

beyond) – many different potential system designs possible

 Many difficult problems motivating and caused by the shift

 Power/energy constraints → multi-core?
 Complexity of design → multi-core?
 Difficulties in technology scaling → new technologies?
 Memory wall/gap

ןורכיזה ןכלו תוחפ הברה ורפוש ןורכיזה יעוציב ךא םידבעמה יעוציב ורפוש םינש ךשמב
קובקב ראווצ תויהל ךפה

 ,

!

 Reliability wall/issues

 Programmability wall/problem

 Huge hunger for data and new data-intensive applications

 No clear, definitive answers to these problems



10

Computer Architecture Today (II)

 These problems affect all parts of the computing stack – if we

do not change the way we design systems

Problem

Algorithm

Program/Language

User

Many new demands
from the top
(Look Up)

Runtime System
(VM, OS, MM)

ISA

Microarchitecture

Logic

Circuits

Electrons

Many new issues
at the bottom
(Look Down)

Fast changing
demands and
personalities
of users
(Look Up)

 No clear, definitive answers to these problems

11

Computer Architecture Today (III)

 Computing landscape is very different from 10-20 years ago.

 Both UP (software and humanity trends) and DOWN

(technologies and their issues), FORWARD and BACKWARD,
and the resulting requirements and constraints.

Hybrid Main Memory

Heterogeneous
Processors and
Accelerators

Persistent Memory/Storage

Every component and its
interfaces, as well as
entire system designs
are being re-examined

General Purpose GPUs

הנש

25

 ינפל םייק היה אל ףקשב תונומתב גצומש המ לכ

12

Computer Architecture Today (IV)

Credit: Dr. MeganWachs - Keynote RISC-V and FPGAs: "Open Source Hardware Hacking",
https://hackaday.com/2020/01/27/supercon-keynote-megan-wachs-breaks-down-risc-v/
https://www.youtube.com/watch?v=vCG5_nxm2G4

Computer Architecture Today (V)

 You can revolutionize the way computers are built, if you
understand both the hardware and the software (and
change each accordingly)

 You can invent new paradigms for computation,

communication, and storage

 Recommended book: Thomas Kuhn, “The Structure of Scientific

Revolutions” (1962)
 Pre-paradigm science: no clear consensus in the field

 Normal science: dominant theory used to explain/improve things

(business as usual); exceptions considered anomalies

 Revolutionary science: underlying assumptions re-examined

14

Computer Architecture Today (V)

 You can revolutionize the way computers are built, if you

understand both the hardware and the software (and change
each accordingly)

 You can invent new paradigms for computation,

communication, and storage

 Recommended book: Thomas Kuhn, “The Structure of Scientific

Revolutions” (1962)
 Pre-paradigm science: no clear consensus in the field

 Normal science: dominant theory used to explain/improve things

(business as usual); exceptions considered anomalies

 Revolutionary science: underlying assumptions re-examined

15

Paradigm Shift

Fundamental Concepts

17

What is A Computer?

 Three key components

H&P

→

– Computation      (
– Communication (
→
– Storage (memory)

 datapath & control)

 input & output)

 יכ הנושארה תגצמב וניאר
 םירידגמ

:םיביכרמ

5

1. Input
2. Output
3. Memory
4. Datapath
5. Control

18

What is A Computer?

 We will cover all three components

Processing

control
(sequencing)

datapath

Memory
(program and data)

I/O

19

The Von Neumann Model/Architecture

 Also called stored program computer

 (instructions in memory).

 Two key properties:

 Stored program

 Instructions stored in a linear memory array

 Memory is unified between instructions and data

When is a value interpreted as an instruction?
 The interpretation of a stored value depends on the control signals

 Sequential instruction processing

 One instruction processed (fetched, executed, and completed) at a time

 Program counter (instruction pointer) identifies the current instr.

 Program counter is advanced sequentially except for control transfer

instructions

20

The Man from the Future: The
Visionary Life of John von Neumann

https://www.ias.edu/von-neumann
https://www.atomicarchive.com/resources/biographies/vonNeumann.html

The Von Neumann Model/Architecture

 Recommended reading – )תושר( תצלמומ האירק

 Burks, Goldstein, von Neumann,

Preliminary discussion of the logical design of an electronic computing instrument, 1946.

 Patt and Patel book, Chapter 4, “The von Neumann Model”

https://archive.org/details/introduction-to-computing-systems-from-bits-gates-to-c-beyond-yale-patt-z-library/mode/2up

 Stored program

 Sequential instruction processing

22

The Von Neumann Model (of a Computer)

Credit: Behrooz Parhami, University of California, Santa Barbara

The Von Neumann Model (of a Computer)

 Q: Is this the only way that a computer can operate?

 A: No.

 Qualified Answer: But, it has been the dominant way

 i.e., the dominant paradigm for computing

 for N decades

 Multi Processor isn’t Von Neumann model!

27

The Dataflow Model (of a Computer)

יביטנרטלא לדומ
 Von Neumann model: An instruction is fetched and executed

in control flow order
 As specified by the instruction pointer

 Sequential unless explicit control flow instruction

 Dataflow model: An instruction is fetched and executed in

data flow order
 i.e., when its operands are ready

 i.e., there is no instruction pointer

 Instruction ordering specified by data flow dependence
 Each instruction specifies “who” should receive the result

 An instruction can “fire” whenever all operands are received

 Potentially many instructions can execute at the same time

 Inherently more parallel

28

Von Neumann vs Dataflow

 Consider a Von Neumann program

 What is the significance of the program order?

 What is the significance of the storage locations?
b

a

V ←  a + b;
w ←  b * 2;
x ←  v - w
y ←  v + w
z ←  x * y

Sequential

+

-

*2

+

Dataflow

*

z

 Which model is more natural to you as a programmer?

29

More on Data Flow

 In a data flow machine, a program consists of data flow nodes
 A data flow node fires (fetched and executed) when all it inputs

are ready
 i.e. when all inputs have tokens

 Data flow node and its ISA representation

סוטטס

An example:

טנמוגראה

הלועפה

R=Ready bit

30

Data Flow Nodes

וז תכרעמל ריבחת תונבל רשפא

Control
input

10>7 is true

Branch

הבחרה
 ףקשב
 אבה

)יליבקמ בשחמ(

31

Barrier sync. example

Parallel program

Single thread

Work
sharing

Sequential part

Parallel section

Parallel count the number of characters in
a book. Divide the pages of the book

Barrier

parallel for

Barrier synchronization

Local
histogram

Bulk synchronous processing - Leslie Lamport

32

https://en.wikipedia.org/wiki/Leslie_Lamport

 winner of the 2013 Turing Award

תושר תאירק

An Example Data Flow Program

N is a non negative integer

boolean

decrement

OUT

34

ISA level Trade-off: Instruction Pointer

 Do we need an instruction pointer in the ISA?

 Yes: Control-driven, sequential execution

 An instruction is executed when the IP points to it

 IP automatically changes sequentially (except for control flow

instructions)

 No: Data-driven, parallel execution

 An instruction is executed when all its operand values are available

(data flow)

?ונלש הריחבה לש תוכלשהה המ

 Tradeoffs: MANY high-level ones

 Ease of programming (for average programmers)?

•

תיתרדס תינכת גאבדל רתוי לק

 Ease of compilation?

 Performance: Extraction of parallelism?

 Hardware complexity?

36

ISA vs. Microarchitecture Level Trade-off

 A similar tradeoff (control vs. data-driven execution) can be made

at the microarchitecture level

 ISA: Specifies how the programmer sees instructions to be

executed
 Programmer sees a sequential, control-flow execution order vs.

 Programmer sees a data-flow execution order

 Microarchitecture: How the underlying implementation actually

executes instructions
 Microarchitecture can execute instructions in any order as long as

it obeys the semantics specified by the ISA when making the
instruction results visible to software
 Programmer should see the order specified by the ISA

Most of the ISAs available today are sequential!!!

37

The Von-Neumann Model

 All major instruction set architectures today use this model

 x86, ARM, MIPS, SPARC, Alpha, POWER

Underneath (at the microarchitecture level), the execution model
of almost all implementations (or, microarchitectures) is very
different

 Pipelined instruction execution: Intel 80486 uarch

 Multiple instructions at a time: Intel Pentium uarch

 Out-of-order execution: Intel Pentium Pro uarch

 Separate instruction and data caches

 But, what happens underneath that is not consistent with the

von Neumann model is not exposed to software
 Difference between ISA and microarchitecture

38

What is Computer Architecture?

 ISA+implementation definition: The science and art of

designing, selecting, and interconnecting hardware
components and designing the hardware/software interface
to create a computing system that meets functional,
performance, energy consumption, cost, and other specific
goals.

 Traditional (ISA-only) definition: “The term architecture is

used here to describe the attributes of a system as seen by the
programmer, i.e., the conceptual structure and functional
behavior as distinct from the organization of the dataflow and
controls, the logic design, and the physical implementation.”
Gene Amdahl, IBM Journal of R&D, April 1964

39

ISA vs. Microarchitecture

 ISA

 Agreed upon interface between software

and hardware
 SW/compiler assumes, HW promises

 What the software writer needs to know to
write and debug system/user programs

Problem

Algorithm

Program

ISA

 Microarchitecture

 Specific implementation of an ISA

 Not visible to the software

 Microprocessor

u = μ

 ISA, uarch, circuits “Architecture”

=ISA+microarchitecture

Microarchitecture

Circuits

Electrons

40

ISA vs. Microarchitecture

 What is part of ISA vs. Uarch?

 Gas pedal: interface for “acceleration”

 Internals of the engine: implement “acceleration”

 Implementation (uarch) can be various as long as it satisfies

the specification (ISA)
 Add instruction vs. Adder implementation

 Bit serial, ripple carry, carry lookahead adders are all part of

microarchitecture

 x86 ISA has many implementations: 286, 386, 486, Pentium, Pentium

Pro, Pentium 4, Core, …

 Microarchitecture usually changes faster than ISA

 Few ISAs (x86, ARM, SPARC, MIPS, Alpha) but many uarchs

 Why?

41

ISA

 Instructions

 Opcodes, Addressing Modes, Data Types

 Instruction Types and Formats

 Registers, Condition Codes

 Memory

 Address space, Addressability, Alignment

 Virtual memory management

 Call, Interrupt/Exception Handling

 Access Control, Priority/Privilege

 I/O: memory-mapped vs. instr.

 Task/thread Management

 Power and Thermal Management

 Multi-threading support, Multiprocessor support

42

Microarchitecture

 Implementation of the ISA under specific design constraints

and goals

 Anything done in hardware without exposure to software

 Pipelining

 In-order versus out-of-order instruction execution

 Memory access scheduling policy

 Speculative execution

 Superscalar processing (multiple instruction issue?)

 Clock gating

 Caching? Levels, size, associativity, replacement policy

 Prefetching?

 Voltage/frequency scaling?

 Error correction?

43

:הבוח תאירק

A New Golden Age for Computer
Architecture
By
JOHN L. HENNESSY and
DAVID A. PATTERSON

לדומה רתאב אצמנ רמאמה

וז תגצמ ןאכ דע
