Adar-Shapira/rv32im-mcu-project/Auxiliary/Lab 5/Auxilary/RV32I/QUARTUS/pinPlanner/DE2-115_pinLocation.txt

Pin Planner - Connected Locations:

1) rst_i = PIN_AB28(SW0)
2) clk_i = PIN_Y2(CLOCK_50MHz) = PLL input clock

Note: all the rest signals pins and ports are unassigned
