Adar-Shapira/rv32im-mcu-project/Auxiliary/Lab 5/Auxilary/RV32I/QUARTUS/pinPlanner/DE10-Standard_pinLocation.txt

Pin Planner - Connected Locations:

1) SW[0] = PIN_AB30 = reset
2) CLOCK_50MHz = PIN_AF14 = PLL input clock

Note: all the rest MIPS.vhd ports are unassigned
