Adar-Shapira/rv32im-mcu-project/Auxiliary/Lab4/Auxiliary/Digital Logic Circuits - Power Analysis.pdf

# Digital Circuits

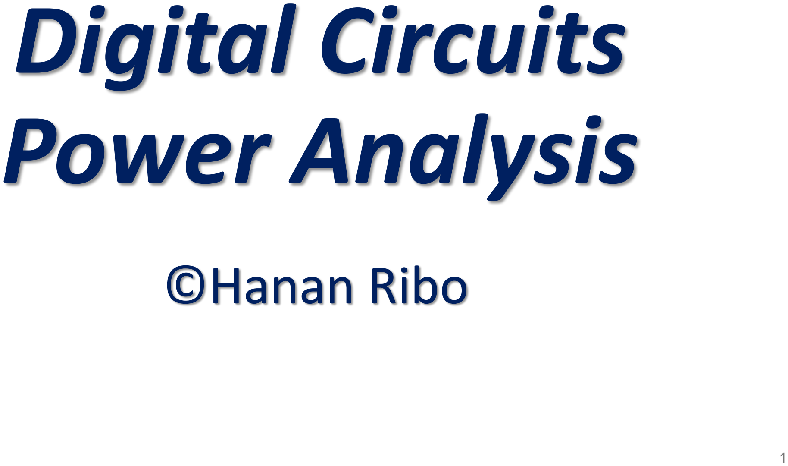
[picture p3: page 1]

# Power Analysis

# ©Hanan Ribo

## CMOS Static Power Dissipation

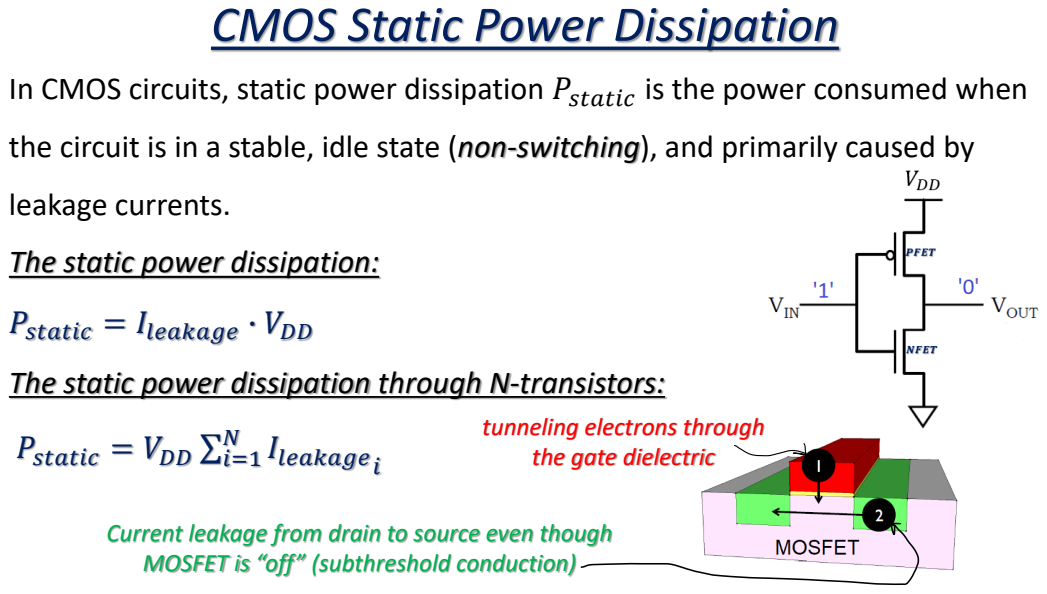
[picture p4: page 3]
N Ileakagei

In CMOS circuits, static power dissipation Pstatic is the power consumed when
the circuit is in a stable, idle state (non-switching), and primarily caused by
leakage currents.
The static power dissipation:

Pstatic = Ileakage ∙ VDD
The static power dissipation through N-transistors:

tunneling electrons through
the gate dielectric

Pstatic = VDD σi=1

Current leakage from drain to source even though
MOSFET is “off” (subthreshold conduction)

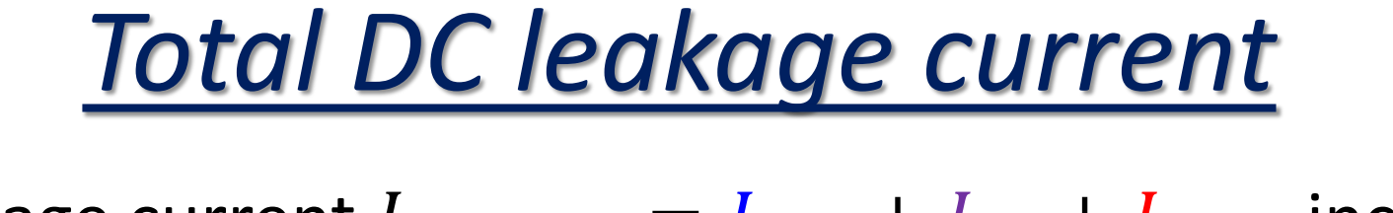
[picture p5: figure]
Total DC leakage current

The total DC leakage current Ileakage = Isub + Iox + IGIDL includes:

### 1. Subthreshold leakage Isub flowing from the drain to the source

when VGS < Vtℎ , depends strongly on temperature and Vtℎ (gets larger as

difference between Vtℎ and VGoff gets smaller)

### 2. Gate Oxide leakage Iox tunneling through the gate dielectric (dependent

on the gate oxide thickness and material)

### 3. Junction leakage IGIDL caused by high electric fields in the drain junction

(dependent on the voltage difference between the gate and drain)

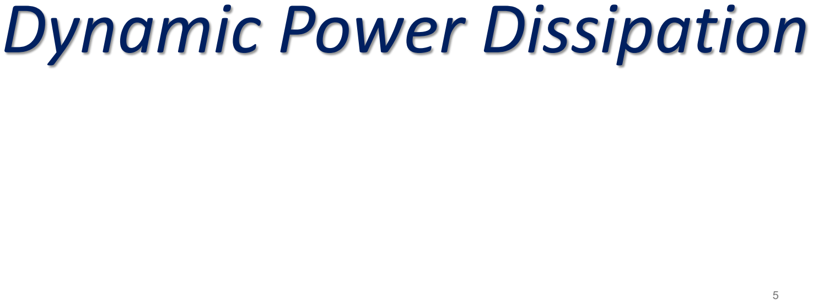
[picture p6: page 5]

# Dynamic Power Dissipation

## CMOS Dynamic Power Dissipation

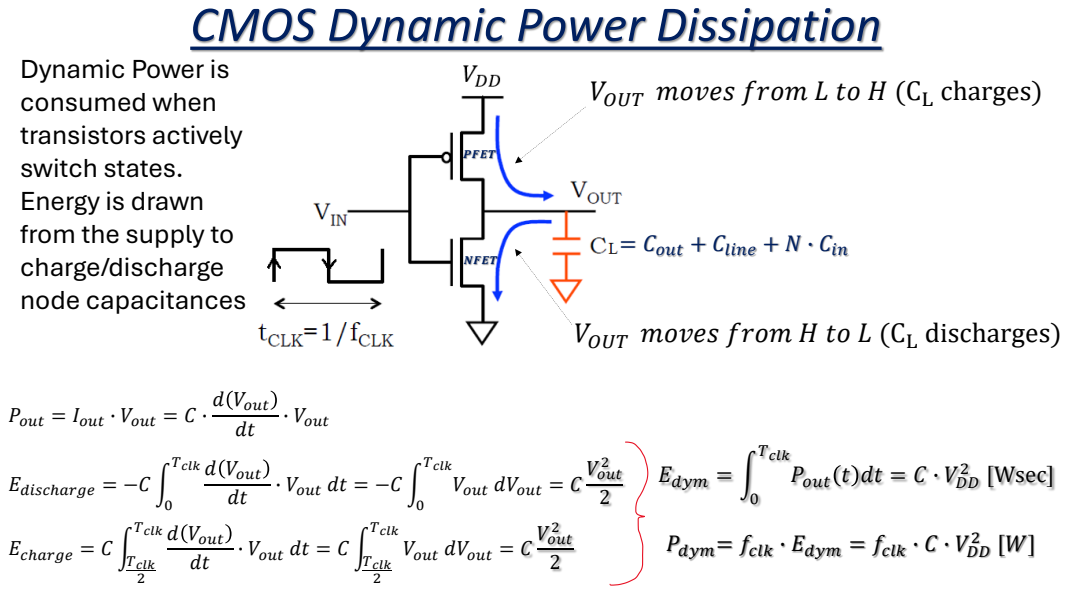
[picture p7: page 6]
d Vout; ∙ Vout; Ediscℎarge = −C න; Tclk d Vout; ∙ Vout dt = −C න; Tclk; Vout dVout = C; Vout; Ecℎarge = C නTclk; ∙ Vout dt = C නTclk; Edym = න; Pout t dt = C ∙ VDD; [Wsec]

Dynamic Power is
consumed when
transistors actively
switch states.
Energy is drawn
from the supply to
charge/discharge
node capacitances.

VOUT moves from L to H (CL charges)

= Cout + Cline + N ∙ Cin

VOUT moves from H to L (CL discharges)

Pout = Iout ∙ Vout = C ∙

Pdym= fclk ∙ Edym = fclk ∙ C ∙ VDD

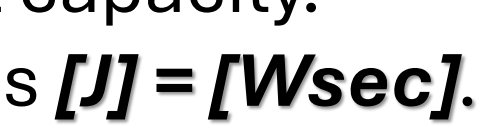
[picture p8: figure]
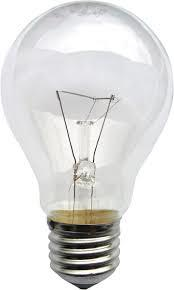
[picture p9: figure]

©Hanan Ribo | 7

### Energy: - The total capacity to do work (is a measure of quantity), like a car's

total fuel or like battery total capacity.
- Energy measure unit is joules [J] = [Wsec].

### Power: - The rate at which that work is done over time (the speed the energy is

used), like a car's engine horsepower or battery electrical power.
- Power measure unit is watts [W] = [J/sec] (i.e., energy per second).

### Electrical Power and Energy: P = I ∙ V [W] , E = I ∙ V ∙ t [J] How much energy a 100W light bulb running for 2 hours uses ?

E = 200 Wh = 200 ∙ 3600 J = 720,000 J

## CMOS Dynamic Power Dissipation

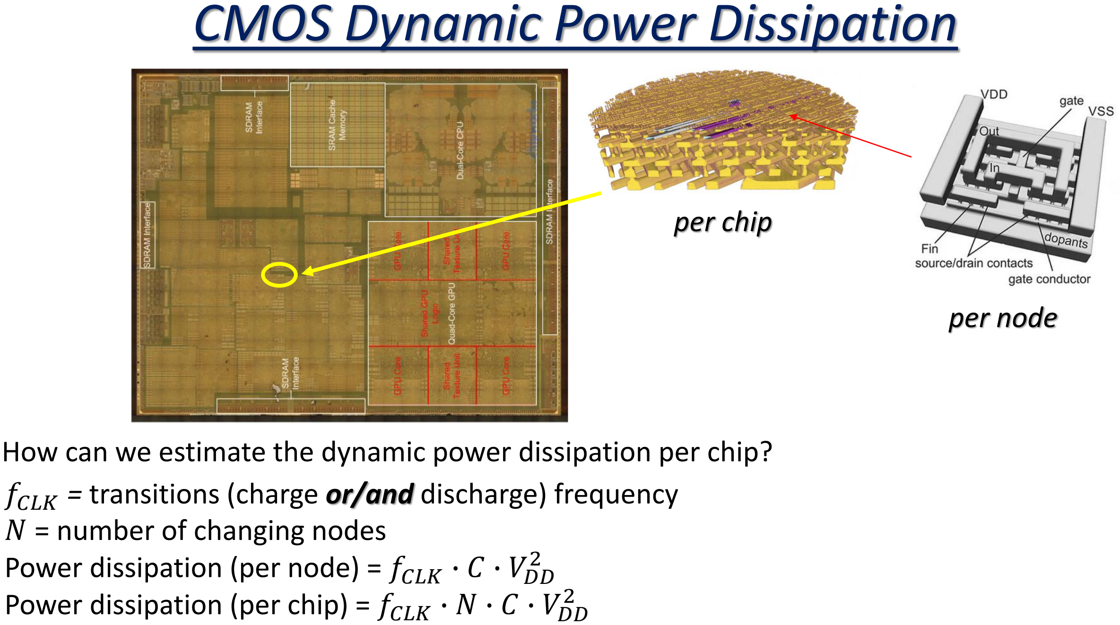
[picture p10: page 8]

fCLK = transitions (charge or/and discharge) frequency N = number of changing nodes
Power dissipation (per node) = fCLK ∙ C ∙ VDD

2
Power dissipation (per chip) = fCLK ∙ N ∙ C ∙ VDD

2

How can we estimate the dynamic power dissipation per chip?

per chip

per node

## CMOS Dynamic Power Dissipation - Example

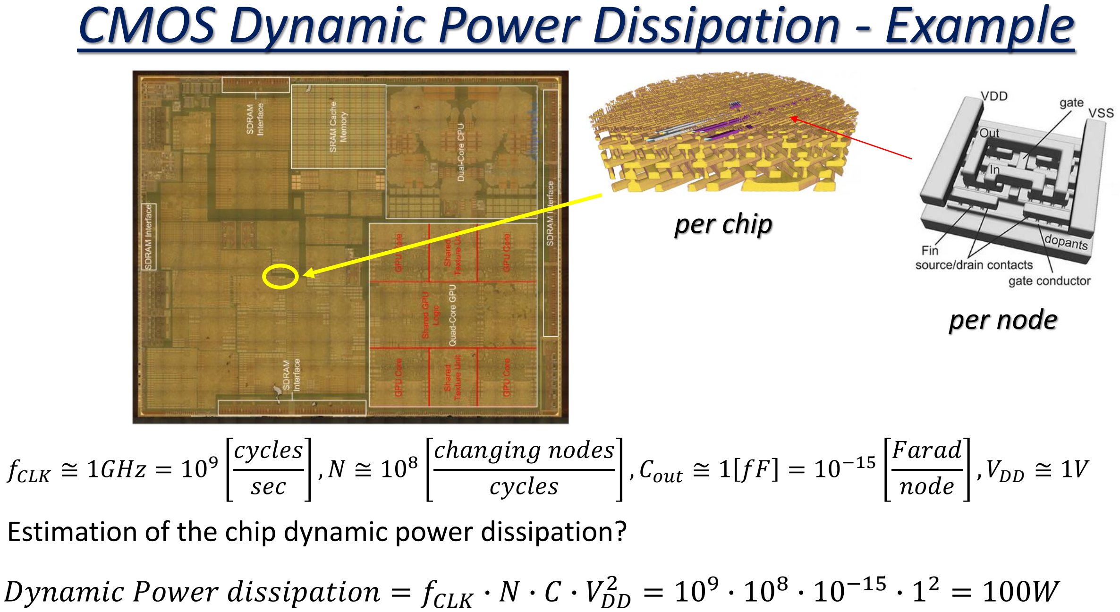
[picture p11: page 9]

fCLK ≅ 1GHz = 10⁹

cycles
sec

, N ≅ 10⁸

cℎanging nodes

cycles | , Cout ≅ 1 | fF | = 10⁻¹⁵ | Farad
node | , VDD ≅ 1V

Estimation of the chip dynamic power dissipation?

per chip

per node

Dynamic Power dissipation = fCLK ∙ N ∙ C ∙ VDD

2 = 10⁹
- 10⁸
- 10⁻¹⁵
- 1

2 = 100W

# Counter layout on an FPGA - example

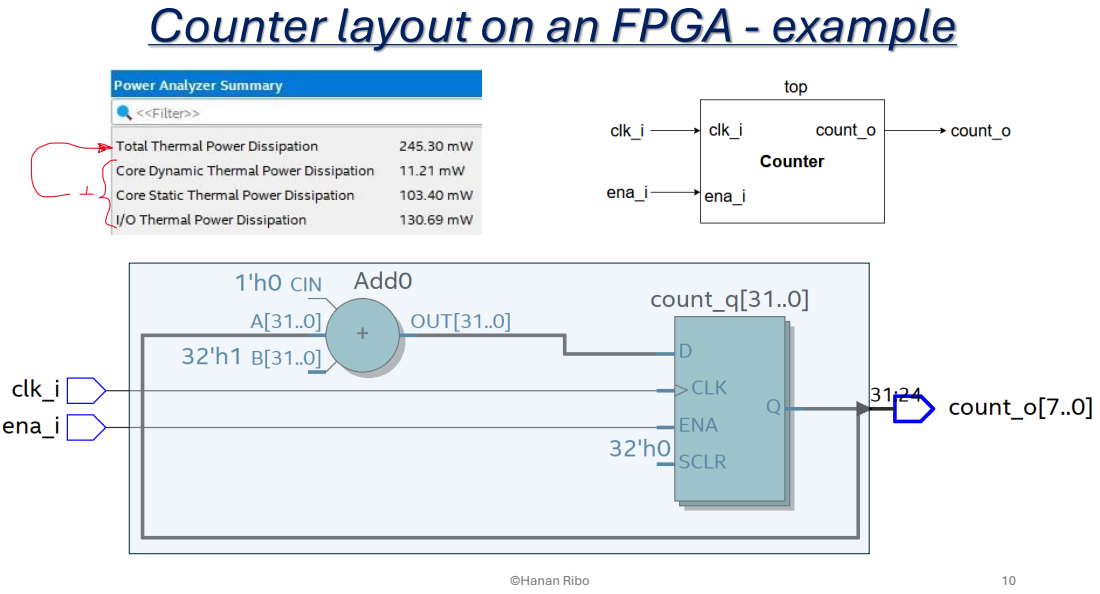
[picture p12: page 10]
©Hanan Ribo
