Adar-Shapira/rv32im-mcu-project/Auxiliary/Lab4/Auxiliary/Digital Logic Circuits - Timing Analysis.pdf

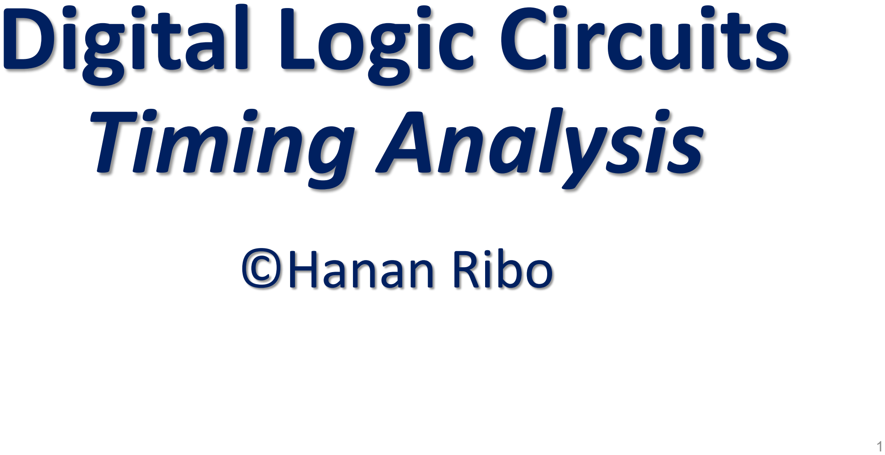
[picture p13: page 1]

# Digital Logic Circuits Timing Analysis

1

# ©Hanan Ribo

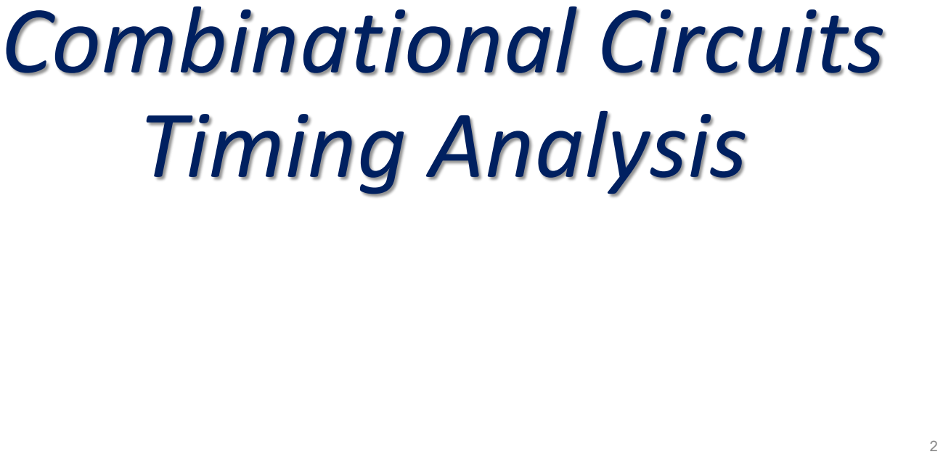
[picture p14: page 2]

# Combinational Circuits Timing Analysis

2

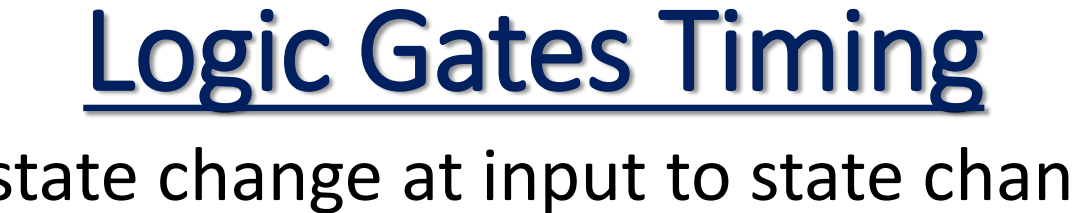
[picture p15: figure]
Logic Gates Timing
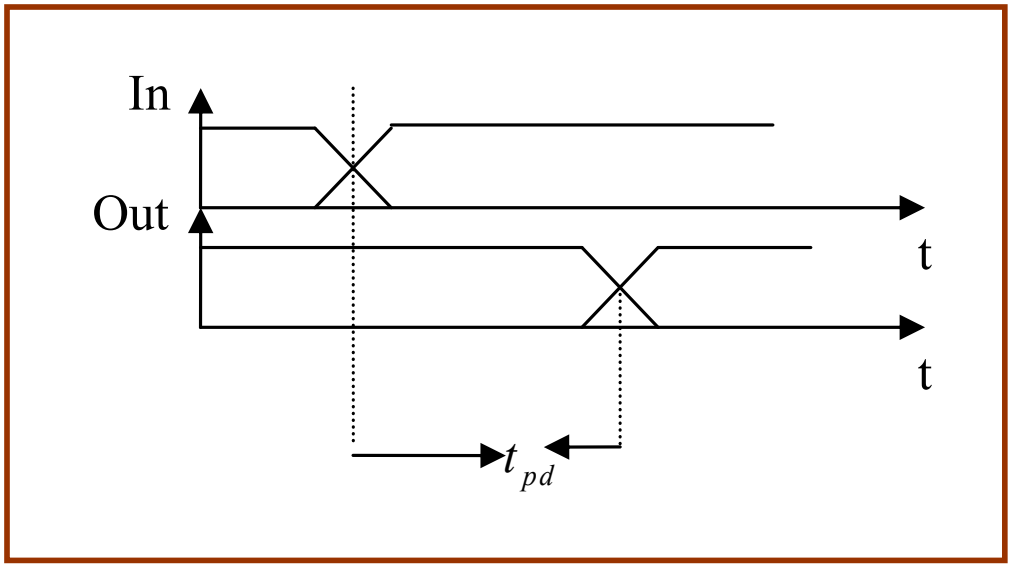
[picture p16: figure]
Out

©Hanan Ribo | 3

tpd: Time from state change at input to state change at output

## CMOS NOT Gate VTC (Voltage Transfer Curve)

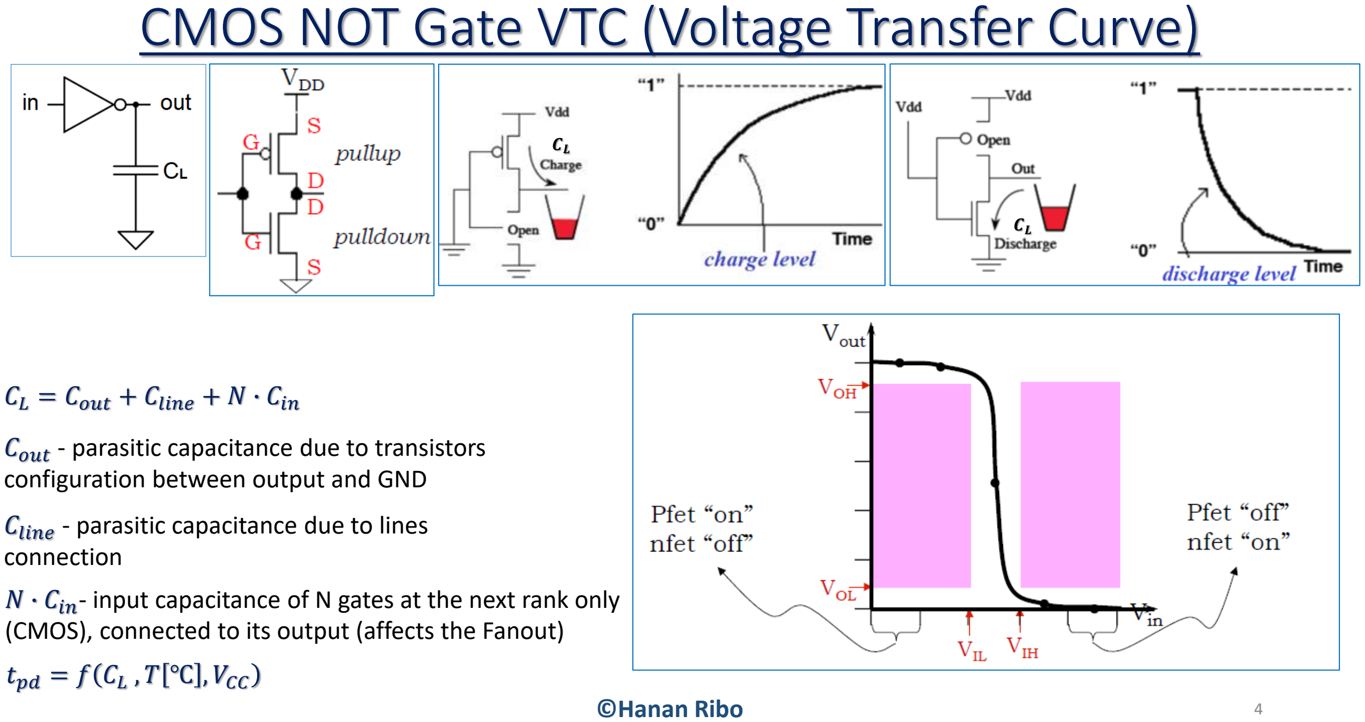
[picture p17: page 4]

©Hanan Ribo | 4

CL = Cout + Cline + N ∙ Cin

Cout - parasitic capacitance due to transistors configuration between output and GND
Cline - parasitic capacitance due to lines
connection
N ∙ Cin- input capacitance of N gates at the next rank only (CMOS), connected to its output (affects the Fanout)
tpd = f CL
, T | ℃ | , VCC

CL

CL

## Digital Logic Abstraction

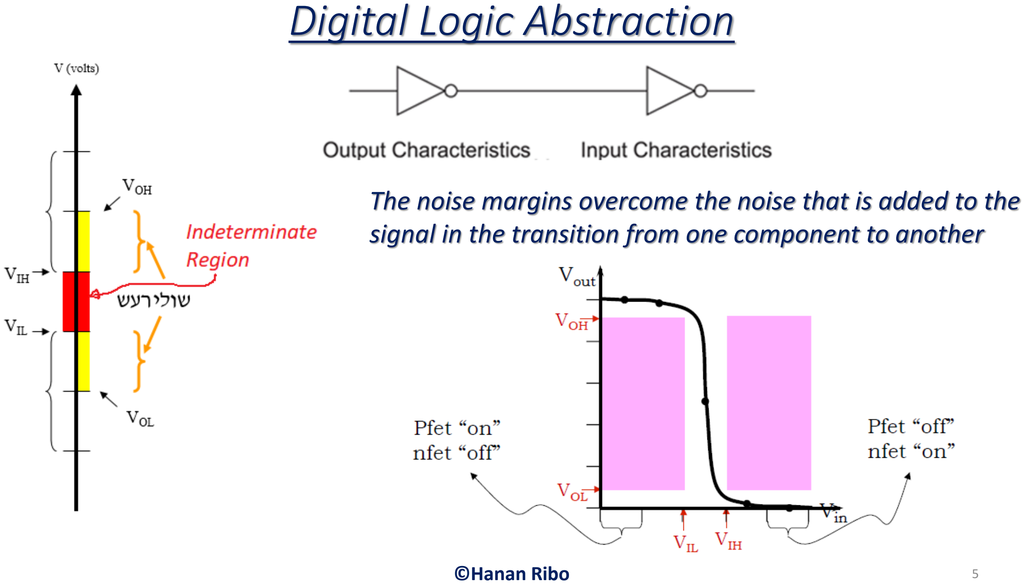
[picture p18: page 5]

©Hanan Ribo | 5

The noise margins overcome the noise that is added to the signal in the transition from one component to another

## CMOS Timing Specifications

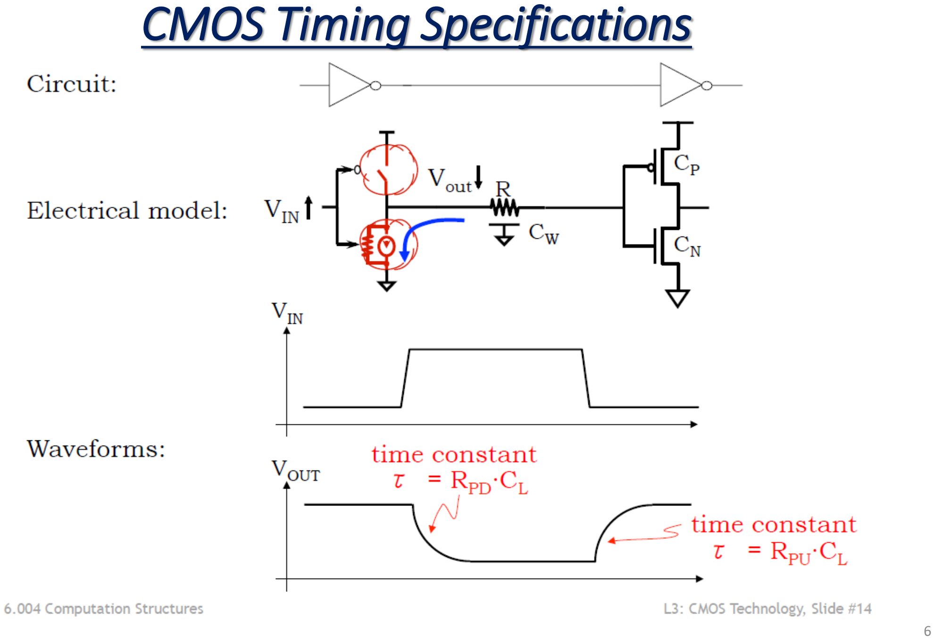
[picture p19: page 6]

6

## Propagation delay (tPD):

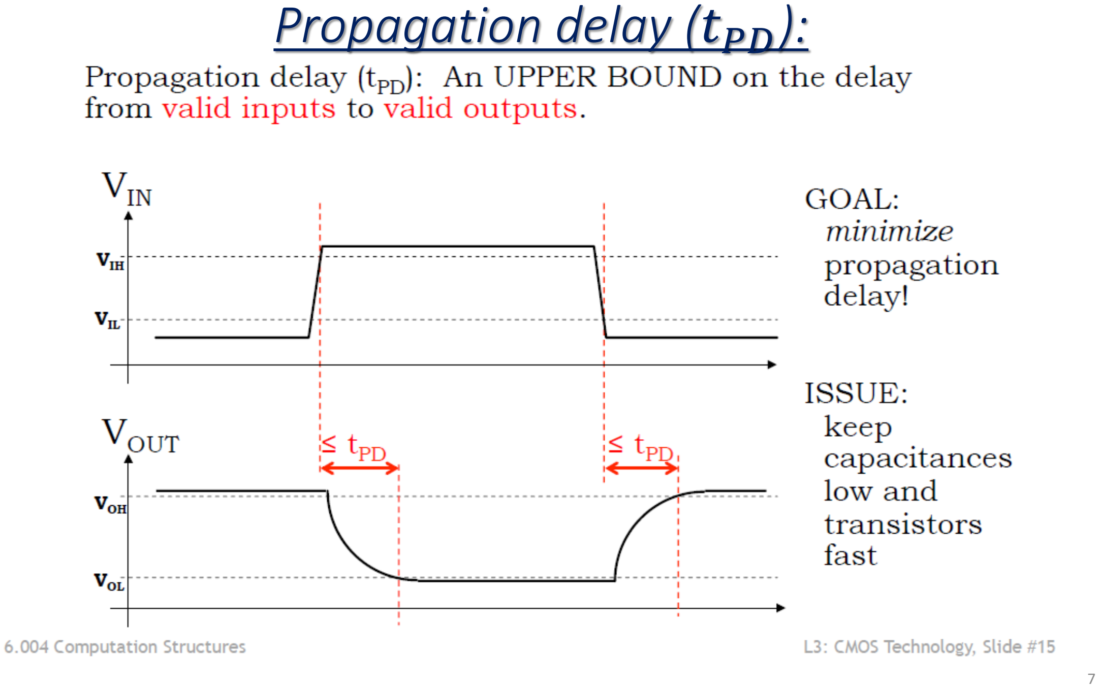
[picture p20: page 7]

7

## Contamination Delay

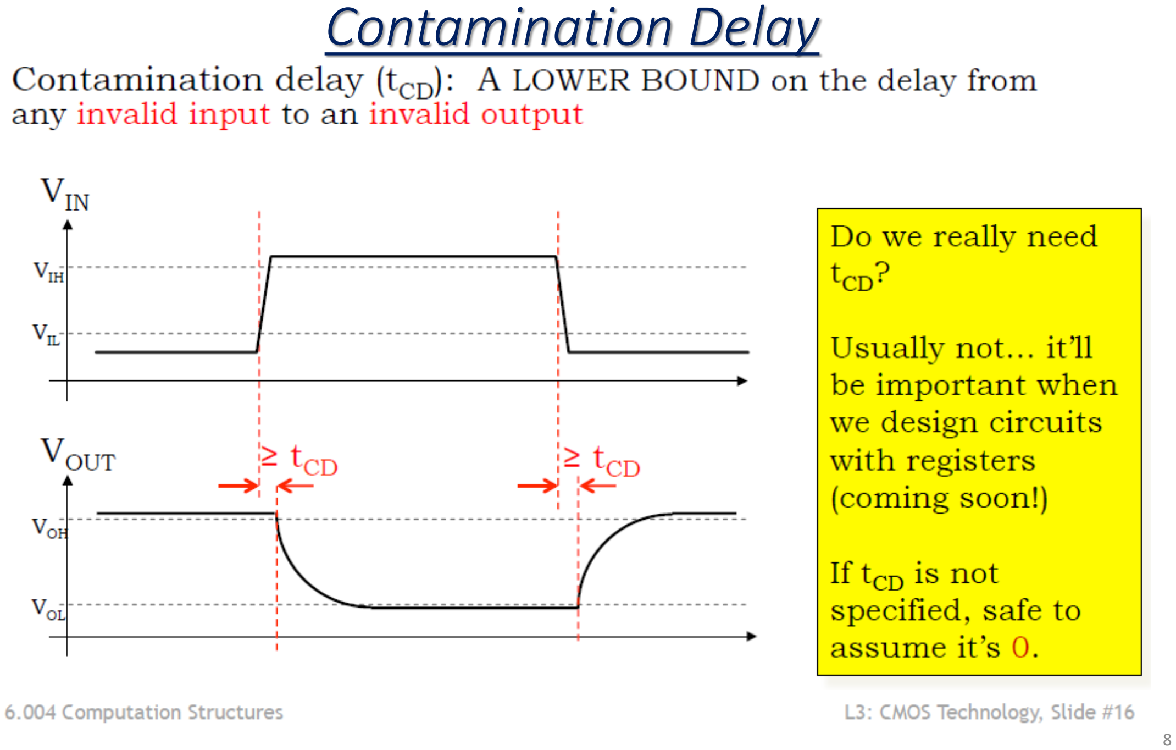
[picture p21: page 8]

8

## Combinational Example

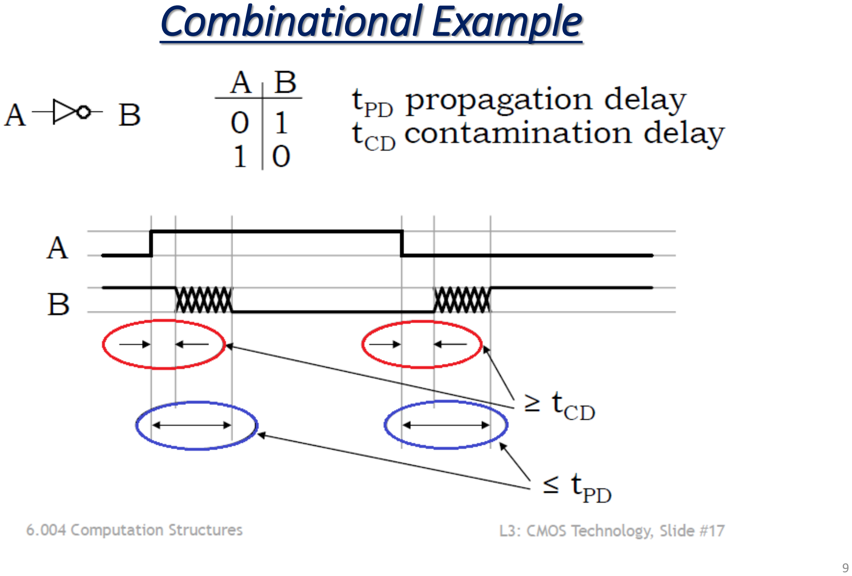
[picture p22: page 9]

9

# Static Discipline Obedience

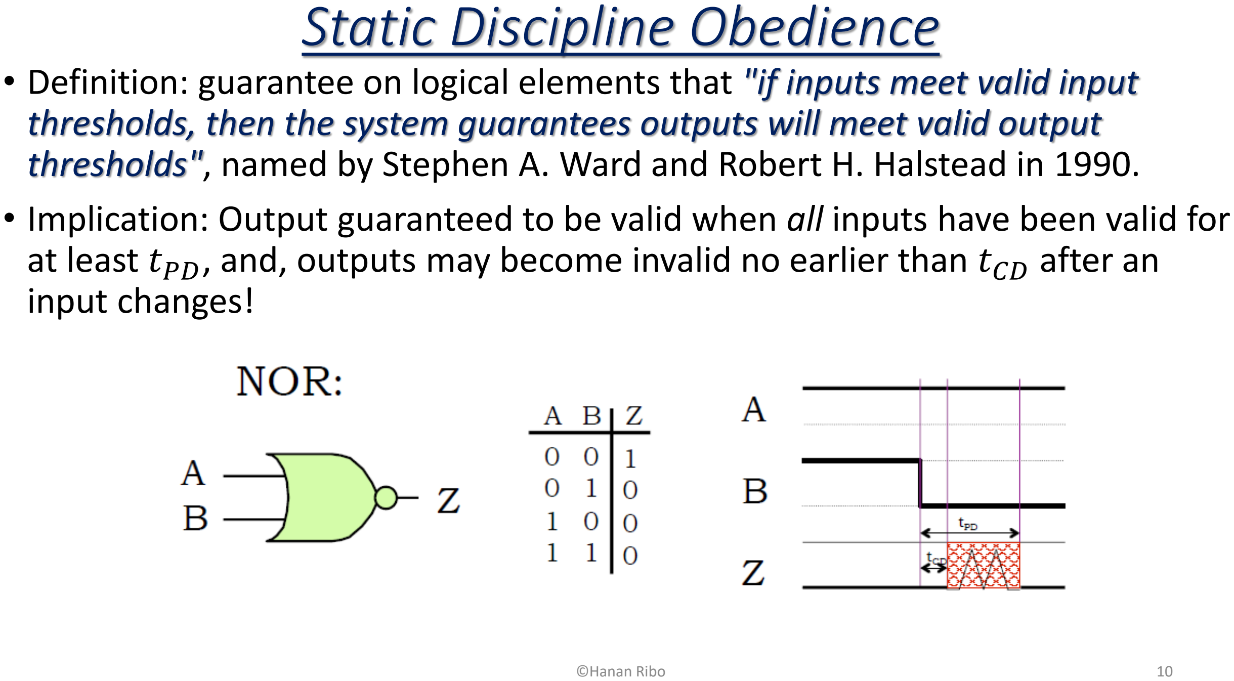
[picture p23: page 10]

- Definition: guarantee on logical elements that "if inputs meet valid input thresholds, then the system guarantees outputs will meet valid output thresholds", named by Stephen A. Ward and Robert H. Halstead in 1990.
- Implication: Output guaranteed to be valid when all inputs have been valid for at least tPD, and, outputs may become invalid no earlier than tCD after an input changes!
©Hanan Ribo | 10

# Cascaded gates delay

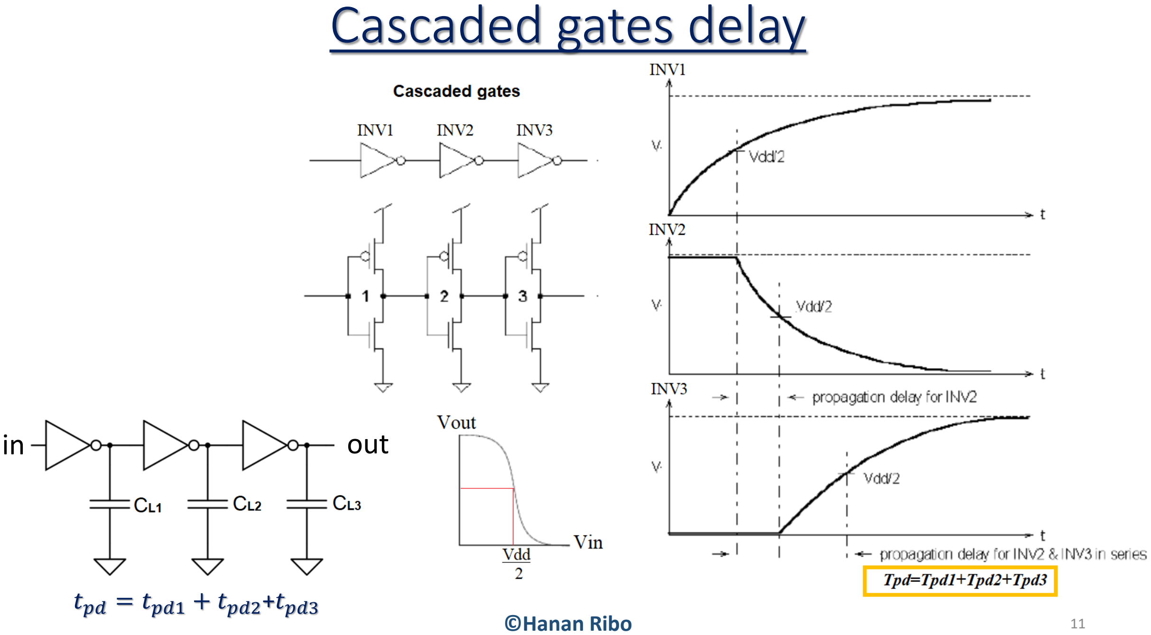
[picture p24: page 11]

©Hanan Ribo | 11

tpd = tpd1 + tpd2+tpd3

in | out

## Fan-out delay

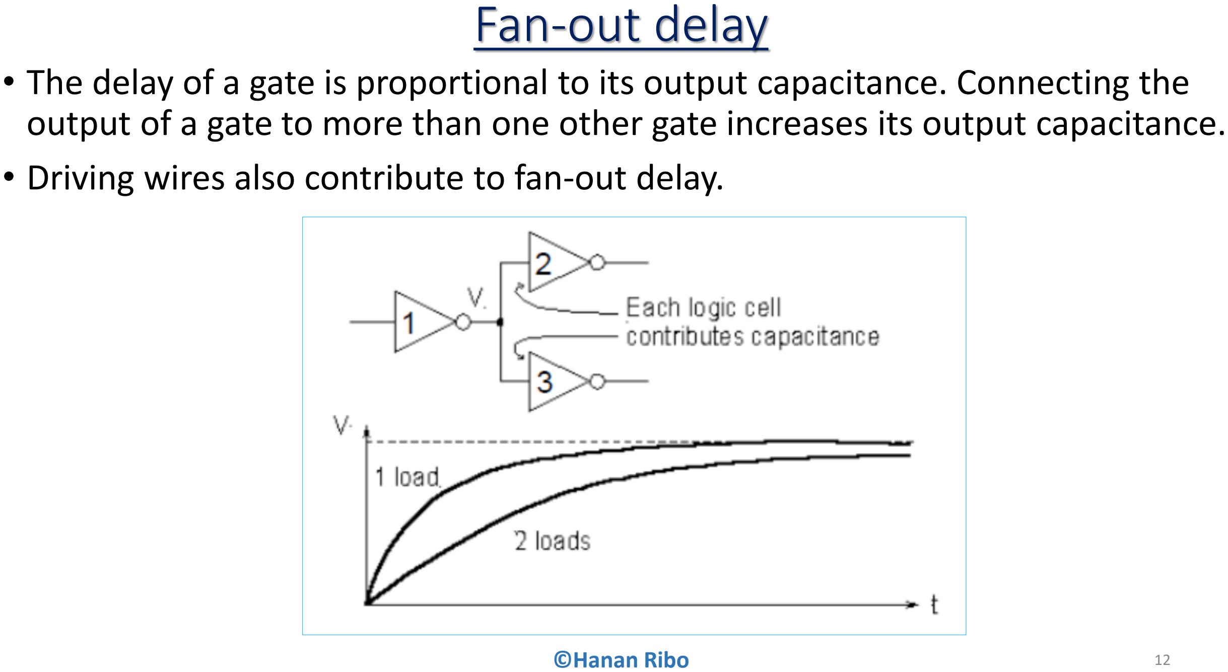
[picture p25: page 12]

- The delay of a gate is proportional to its output capacitance. Connecting the output of a gate to more than one other gate increases its output capacitance.
- Driving wires also contribute to fan-out delay.
©Hanan Ribo | 12

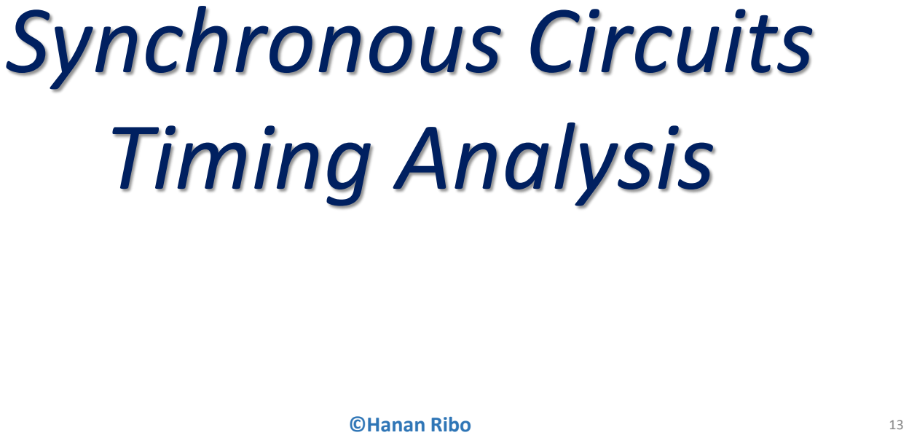
[picture p26: page 13]

©Hanan Ribo | 13

# Synchronous Circuits Timing Analysis

# NOR based SR Latch

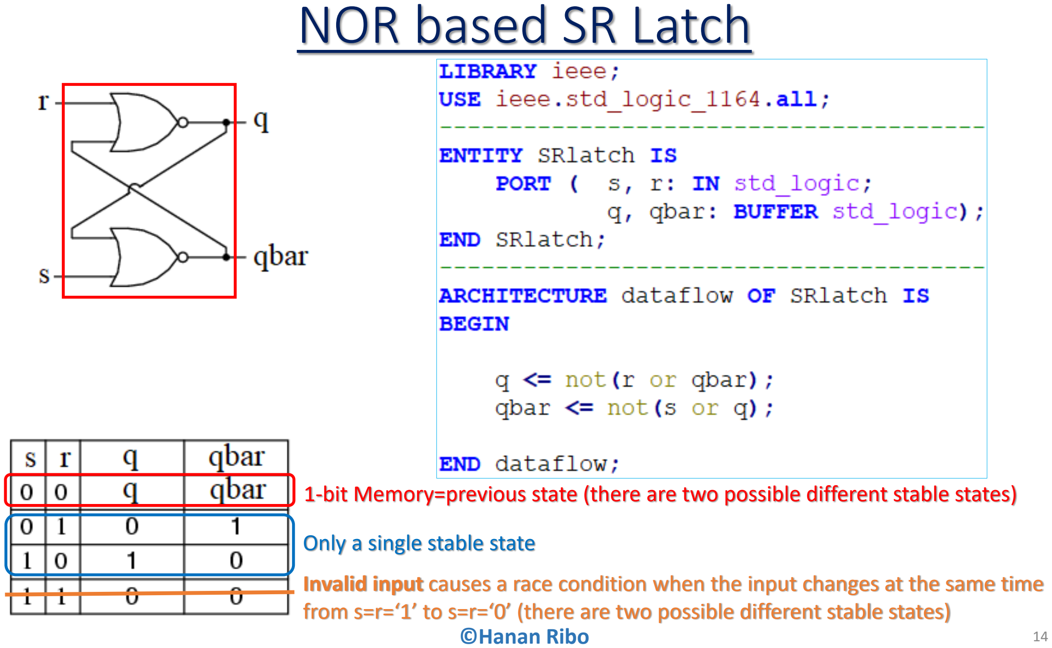
[picture p27: page 14]

©Hanan Ribo | 14

1-bit Memory=previous state (there are two possible different stable states)

Only a single stable state
Invalid input causes a race condition when the input changes at the same time from s=r=‘1’ to s=r=‘0’ (there are two possible different stable states)

# NAND based SR Latch

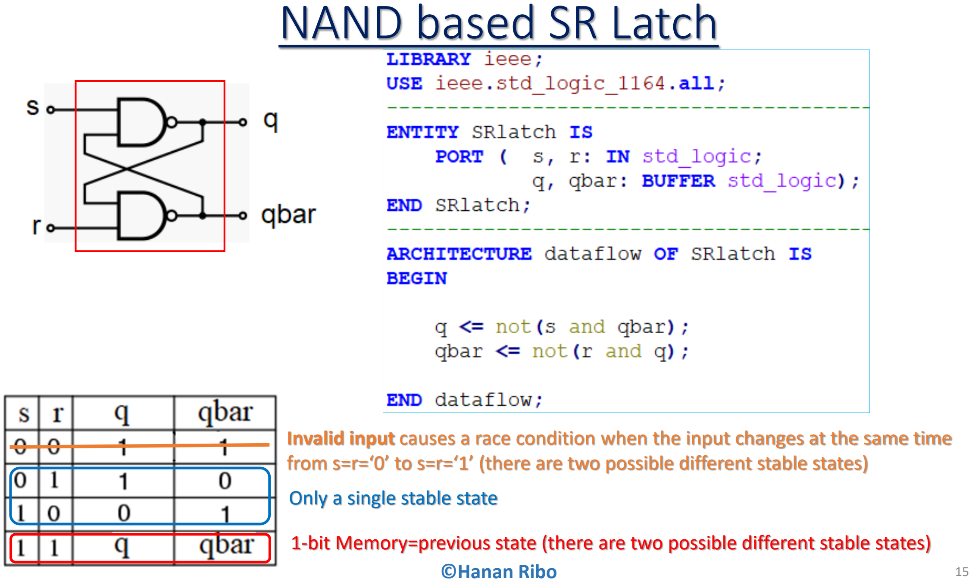
[picture p28: page 15]

©Hanan Ribo | 15

1-bit Memory=previous state (there are two possible different stable states)

Only a single stable state

Invalid input causes a race condition when the input changes at the same time from s=r=‘0’ to s=r=‘1’ (there are two possible different stable states)

## Gated D-Latch

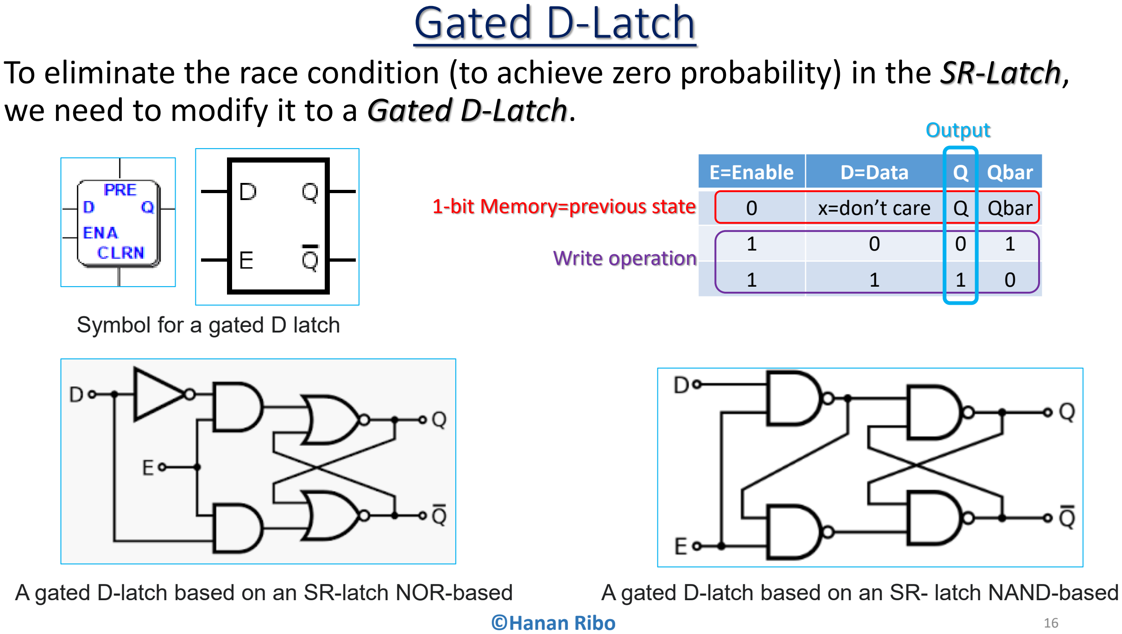
[picture p29: page 16]

To eliminate the race condition (to achieve zero probability) in the SR-Latch, we need to modify it to a Gated D-Latch.

©Hanan Ribo | 16
A gated D-latch based on an SR-latch NOR-based | A gated D-latch based on an SR- latch NAND-based

Symbol for a gated D latch

E=Enable | D=Data | Q | Qbar
0 | x=don’t care | Q | Qbar
1 | 0 | 0 | 1
1 | 1 | 1 | 0

1-bit Memory=previous state

Write operation

Output

# D Flip-Flop = DFF

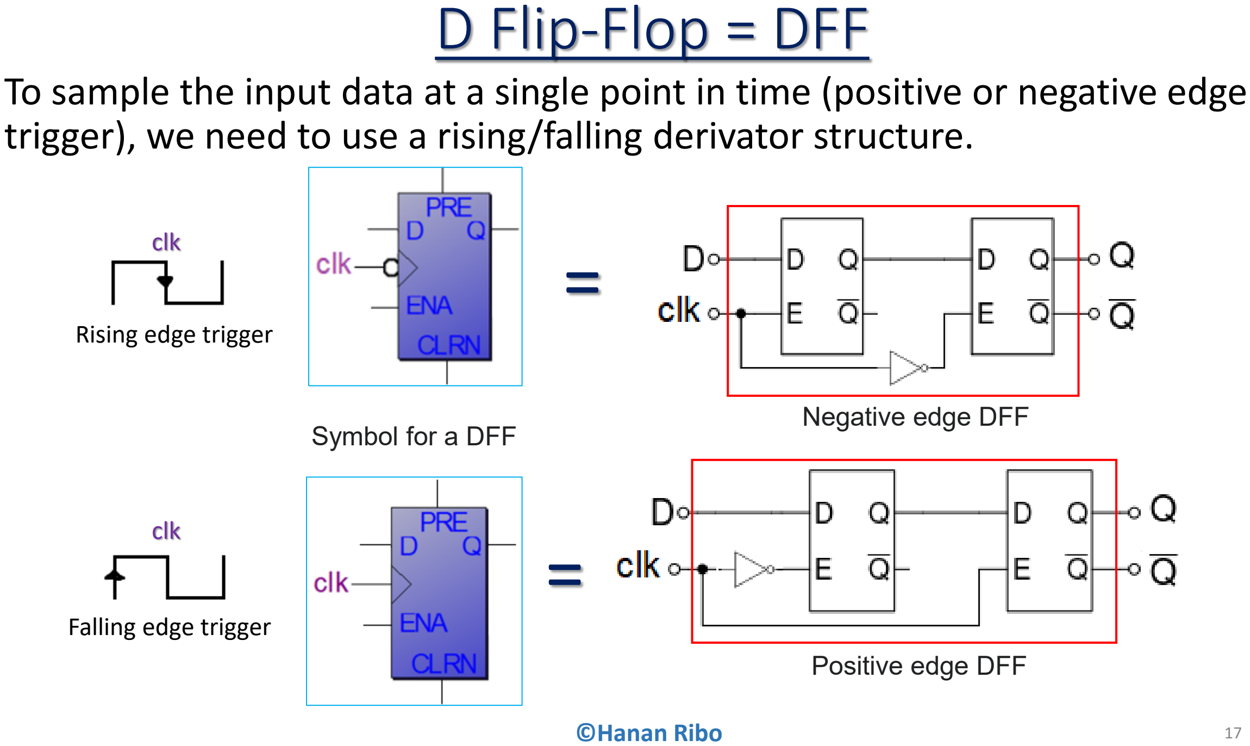
[picture p30: page 17]

To sample the input data at a single point in time (positive or negative edge trigger), we need to use a rising/falling derivator structure.

©Hanan Ribo | 17

Symbol for a DFF

Positive edge DFF

Negative edge DFF

=

=

Falling edge trigger

Rising edge trigger

clk

clk

# Dynamic Discipline Obedience

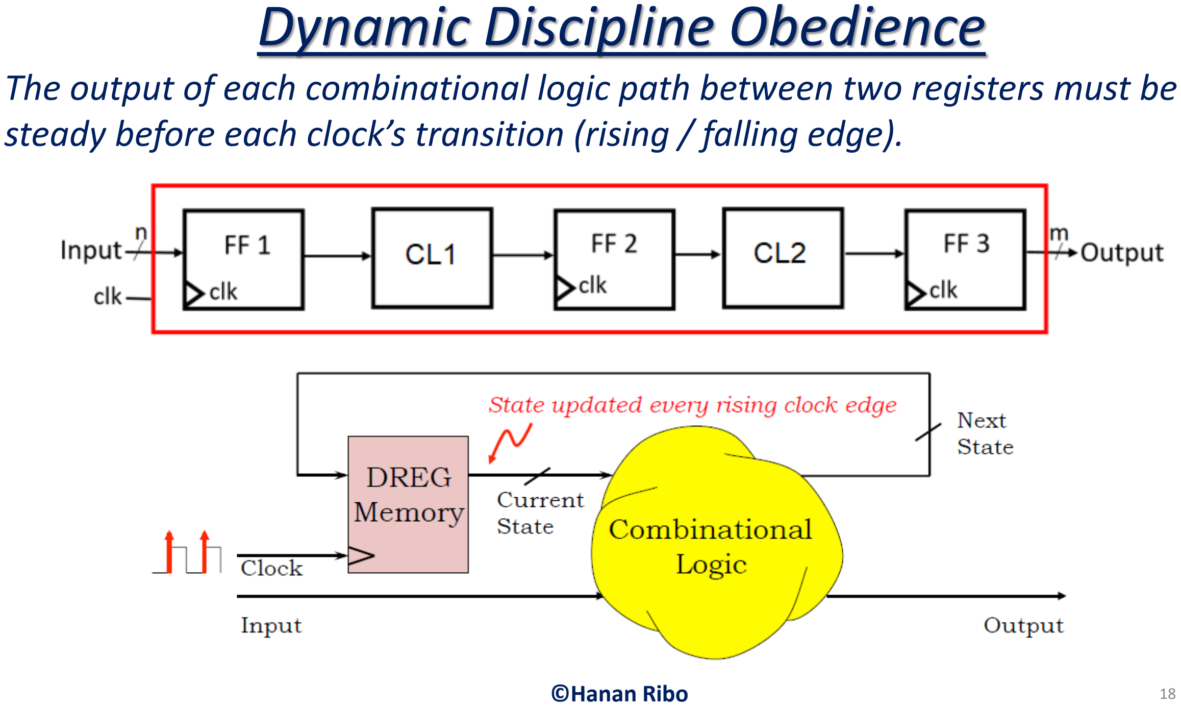
[picture p31: page 18]

©Hanan Ribo | 18

The output of each combinational logic path between two registers must be steady before each clock’s transition (rising / falling edge).

# Synchronous Data Movement

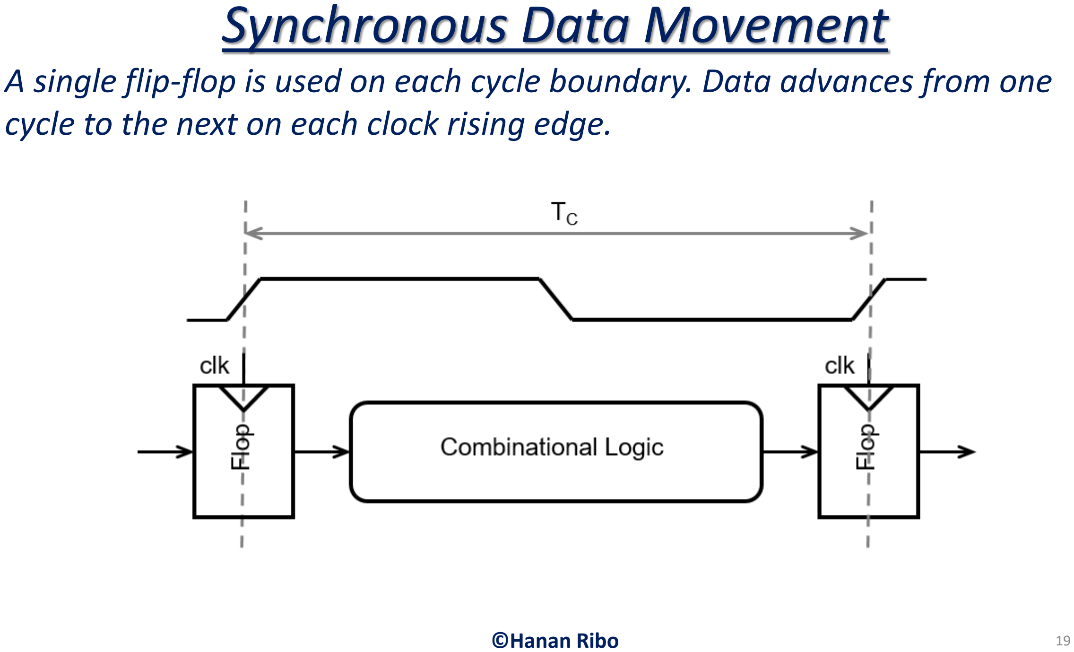
[picture p32: page 19]

©Hanan Ribo | 19

A single flip-flop is used on each cycle boundary. Data advances from one cycle to the next on each clock rising edge.

## Reminder - Combinational timing analysis

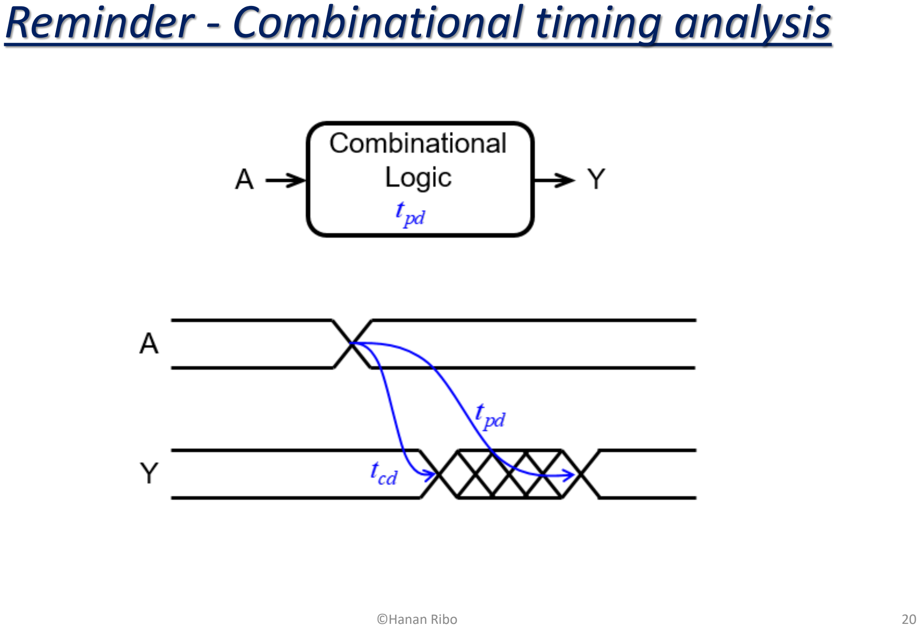
[picture p33: page 20]

©Hanan Ribo | 20

# DFF timing analysis

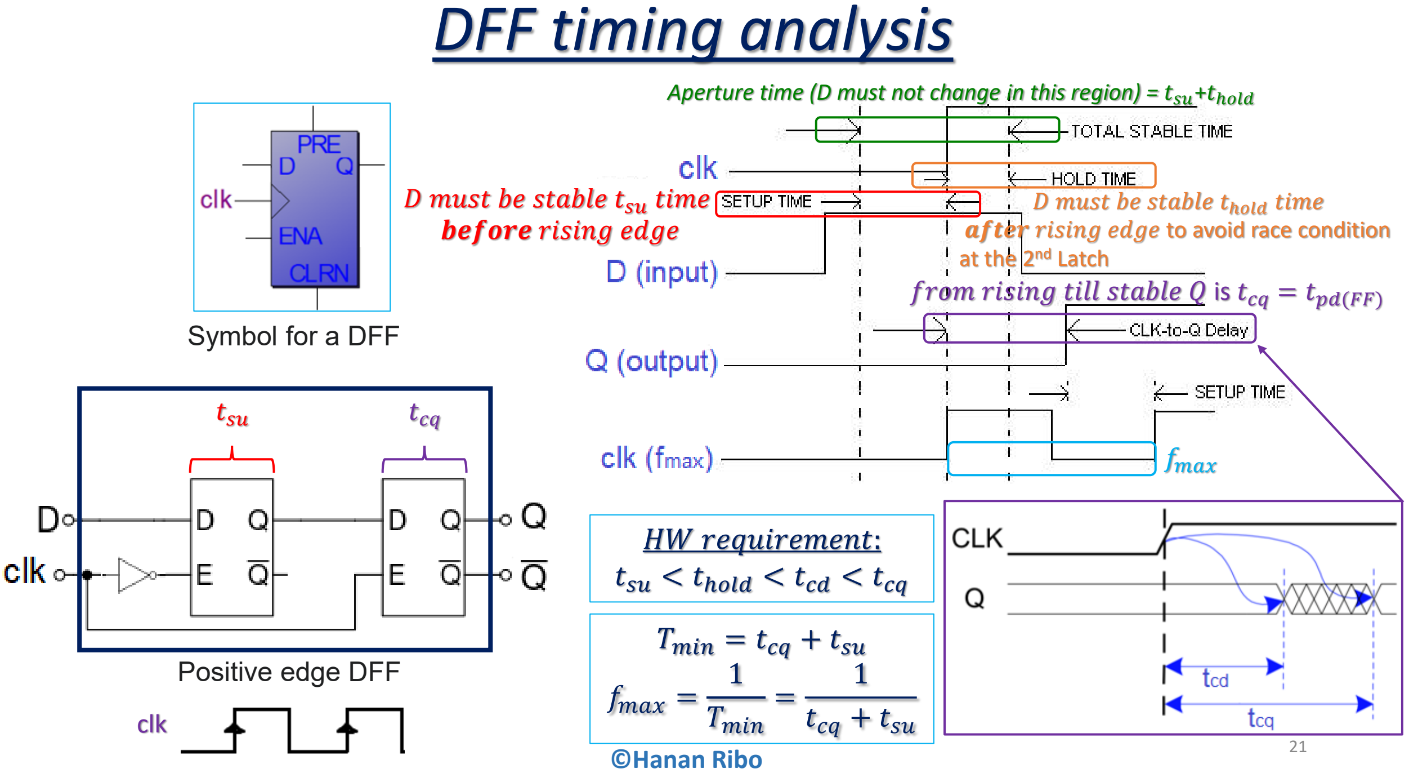
[picture p34: page 21]

©Hanan Ribo | 21

Symbol for a DFF

Positive edge DFF

tsu

D must be stable tsu time
before rising edge

D must be stable tℎold time after rising edge to avoid race condition at the 2

nd Latch

tcq

from rising till stable Q is tcq = tpd(FF)

HW requirement:
tsu < tℎold < tcd < tcq

Tmin = tcq + tsu

fmax =

1

Tmin

=

1

tcq + tsu

fmax

Aperture time (D must not change in this region) = tsu+tℎold

clk

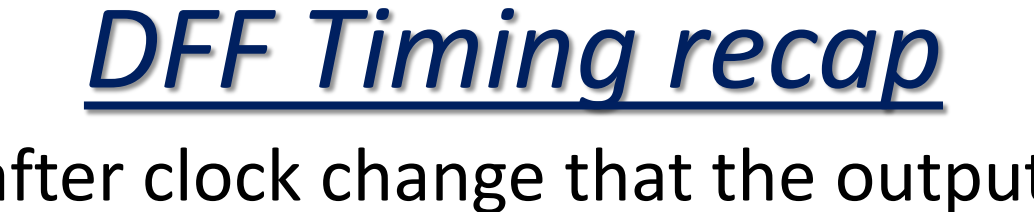
[picture p35: figure]
DFF Timing recap

: time after clock change that the output is guaranteed to be stable (propagation delay).

- tsu: time before clock edge, data must be stable (Setup time)
- tℎold : time after clock edge data must be stable (Hold time)
- ta = tsu+tℎold: time around clock edge data must be stable (Aperture time)
- tcd: time after clock edge that Q is stable by the previous value (Contamination delay)
©Hanan Ribo | 22

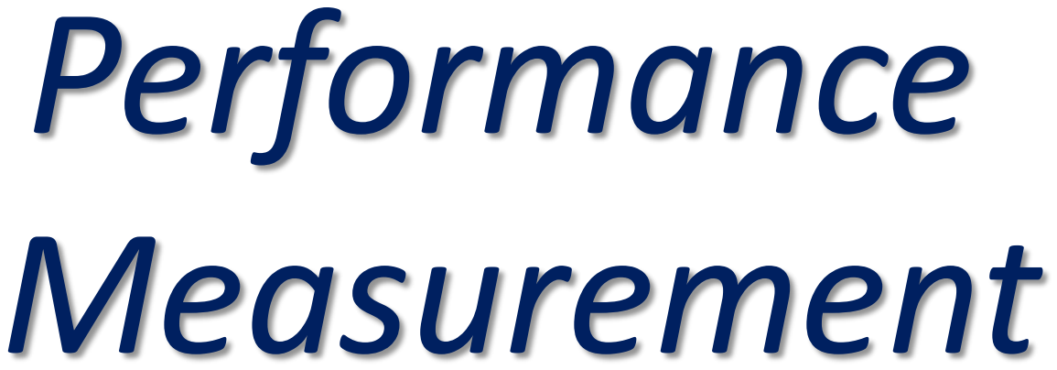
[picture p36: figure]
Performance Measurement

©Hanan Ribo | 23

## Components of Path Delay

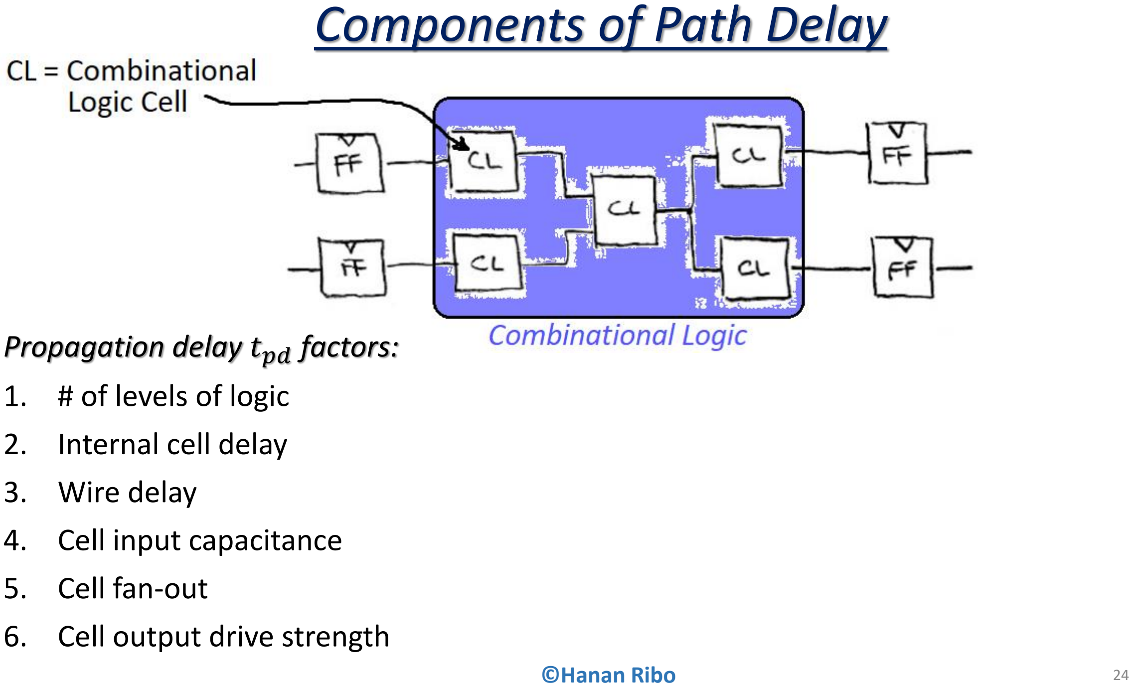
[picture p37: page 24]

24

©Hanan Ribo

Propagation delay tpd factors:
1. # of levels of logic
2. Internal cell delay
3. Wire delay
4. Cell input capacitance
5. Cell fan-out
6. Cell output drive strength

# Timing Delay Constraints of tsetup and tℎold

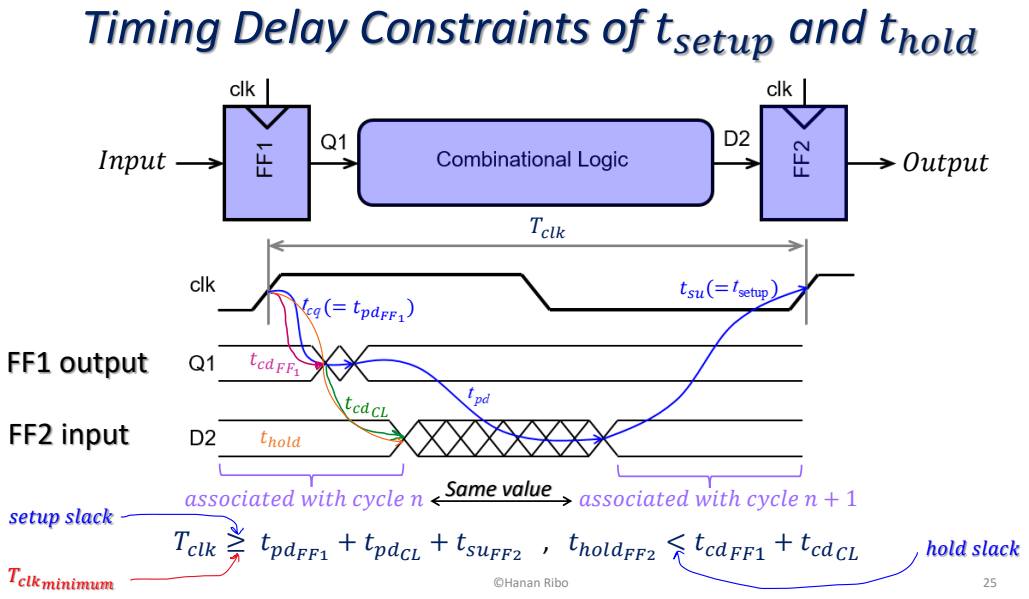
[picture p38: page 25]
©Hanan Ribo; Tclk ≥ tpdFF1 + tpdCL + tsuFF2; , tℎoldFF2 < tcdFF1 + tcdCL; tcdFF1; tcdCL; tℎold; (= tpdFF1; associated witℎ cycle n; associated witℎ cycle n + 1; Same value; Input; Output; tsu(=; Tclk; FF1 output; FF2 input; Tclkminimum; setup slack; ℎold slack

# High Level System Description

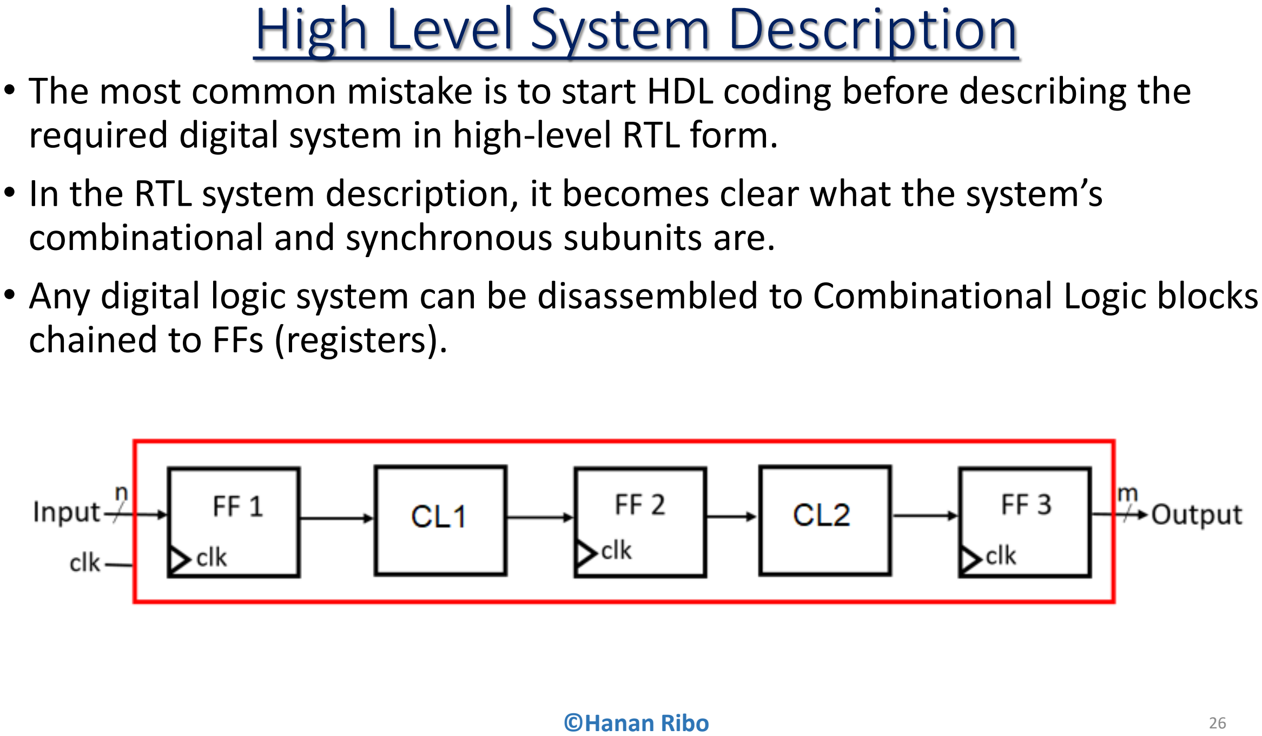
[picture p39: page 26]

- The most common mistake is to start HDL coding before describing the required digital system in high-level RTL form.
- In the RTL system description, it becomes clear what the system’s combinational and synchronous subunits are.
- Any digital logic system can be disassembled to Combinational Logic blocks chained to FFs (registers).
©Hanan Ribo | 26

# Critical Path

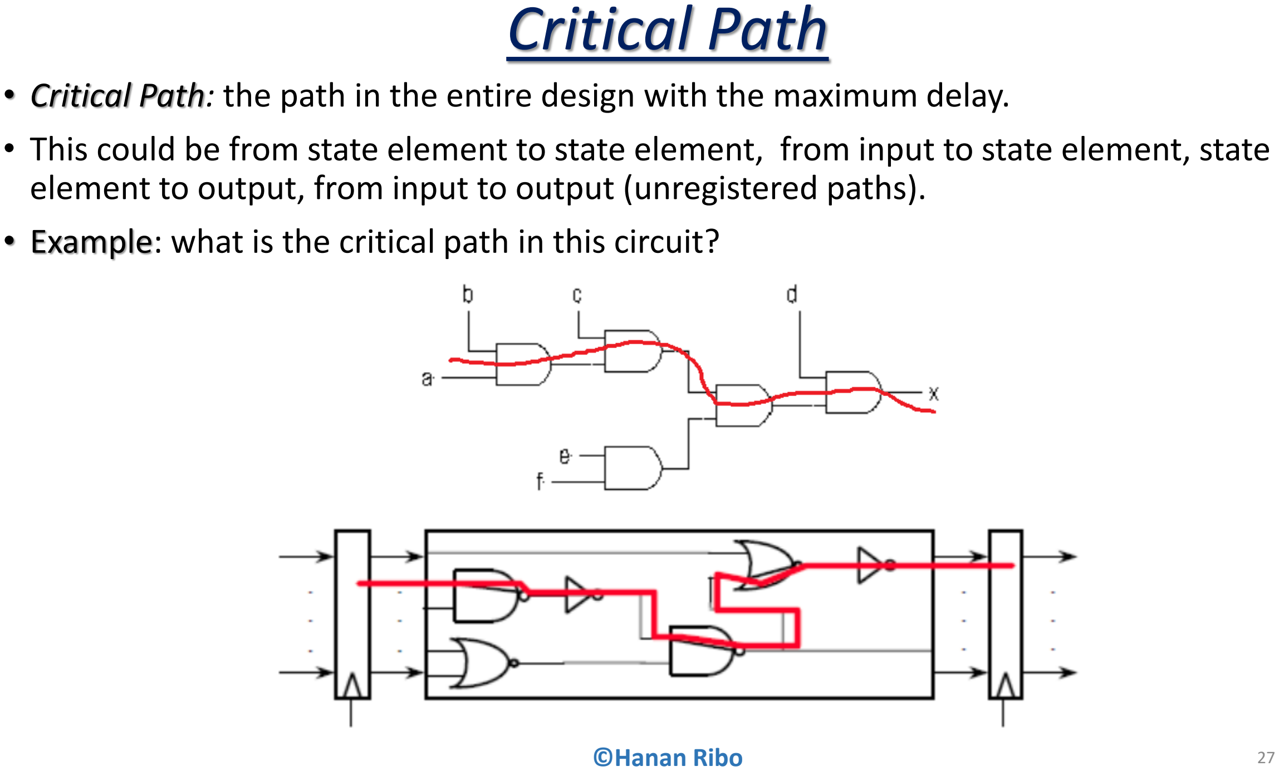
[picture p40: page 27]

©Hanan Ribo | 27
- Critical Path: the path in the entire design with the maximum delay.
- This could be from state element to state element, from input to state element, state element to output, from input to output (unregistered paths).
- Example: what is the critical path in this circuit?

# RTL design - example

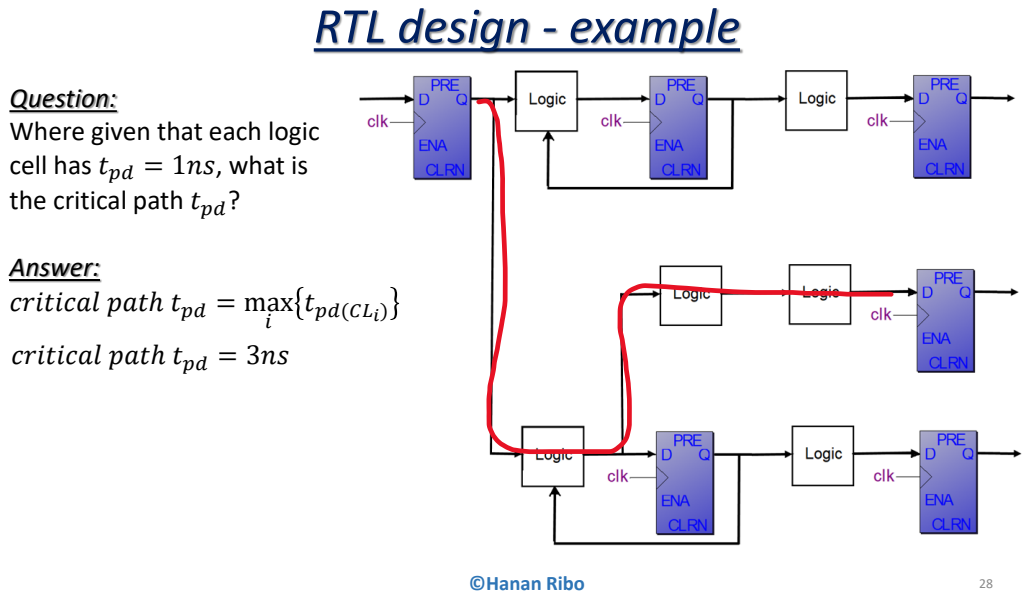
[picture p41: page 28]
©Hanan Ribo; tpd(CLi

Question:
Where given that each logic
cell has tpd = 1ns, what is
the critical path tpd?

Answer:
critical patℎ tpd = max

critical patℎ tpd = 3ns

## fmax calculation – dynamic discipline Obedience

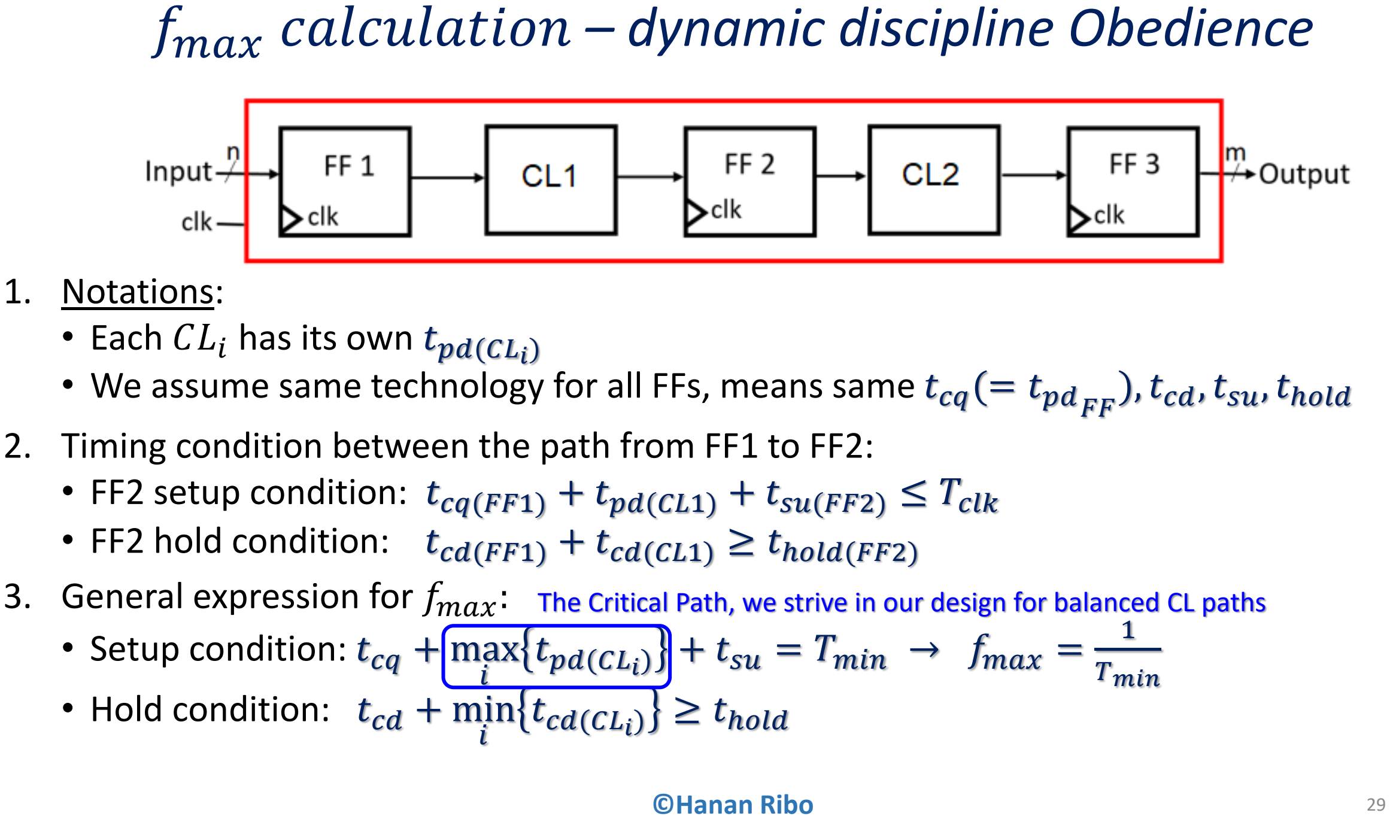
[picture p42: page 29]

1. Notations:
- Each CLi has its own tpd(CLi
)
- We assume same technology for all FFs, means same tcq(= tpdFF

),tcd,tsu,tℎold
2. Timing condition between the path from FF1 to FF2:
- FF2 setup condition: tcq(FF1) + tpd(CL1) + tsu(FF2) ≤ Tclk
- FF2 hold condition: tcd(FF1) + tcd(CL1) ≥ tℎold(FF2)
3. General expression for fmax:
- Setup condition: tcq + max
i

tpd(CLi

) + tsu = Tmin → fmax =

1

Tmin
- Hold condition: tcd + min
i

tcd(CLi

) ≥ tℎold

©Hanan Ribo | 29

The Critical Path, we strive in our design for balanced CL paths

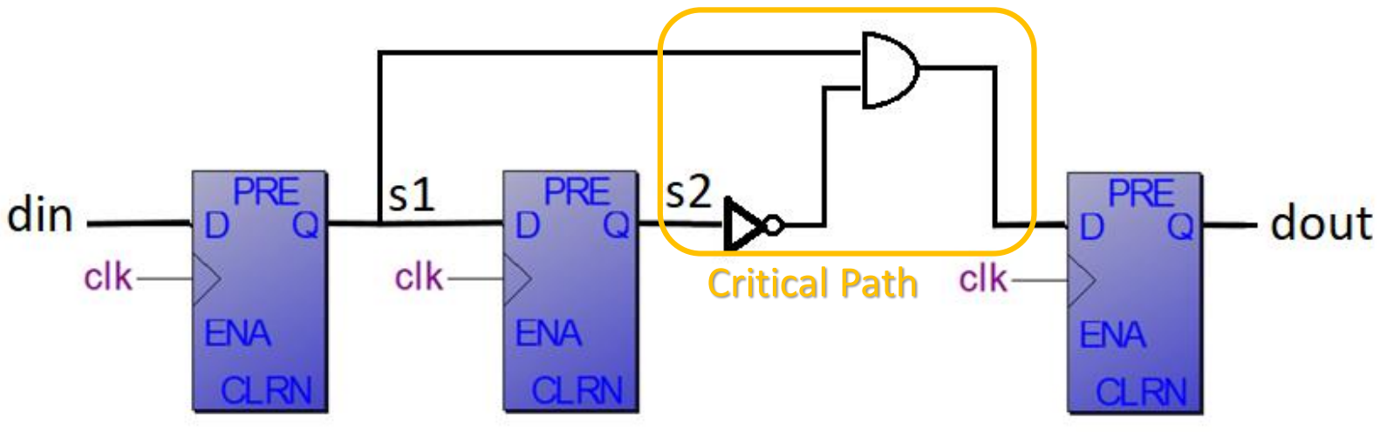
[picture p43: figure]
Critical Path

©Hanan Ribo | 30

The given data:
tsu = 200ps
tcq = 300ps

tpdgate

= 100ps

Tmin = tcq +2 ∙ tpdgate + tsu = 700ps → fmax =

1

Tmin

= 1.428GHz

## fmax calculation − example 2

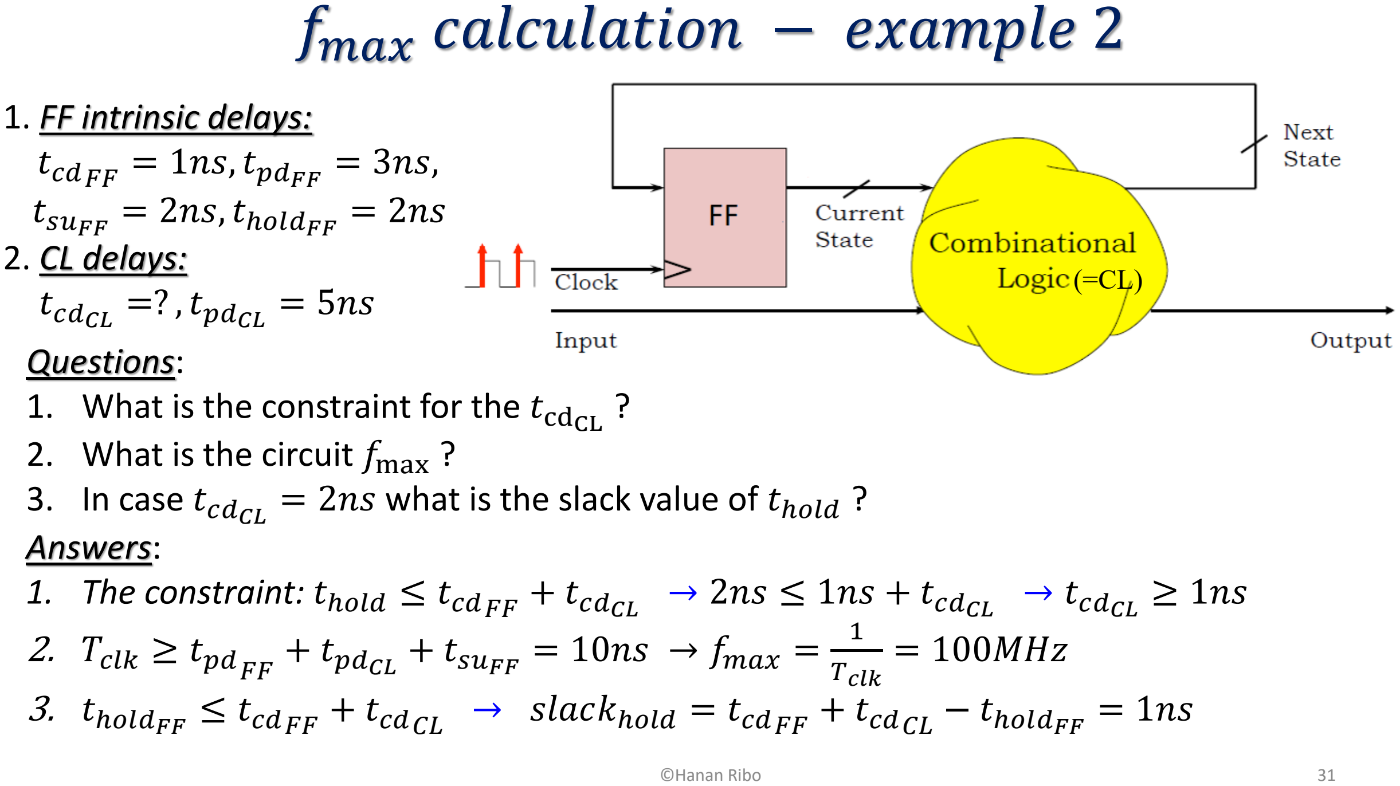
[picture p44: page 31]

©Hanan Ribo | 31
1. FF intrinsic delays:
tcdFF

= 1ns,tpdFF

= 3ns,

tsuFF

= 2ns,tℎoldFF

= 2ns
2. CL delays:
tcdCL

=? ,tpdCL

= 5ns
Questions:
1. What is the constraint for the tcdCL ?
2. What is the circuit fmax ?
3. In case tcdCL

= 2ns what is the slack value of tℎold ?

(=CL)

Answers:
1. The constraint: tℎold ≤ tcdFF + tcdCL

→ 2ns ≤ 1ns + tcdCL

→ tcdCL ≥ 1ns

2. Tclk ≥ tpdFF

+ tpdCL + tsuFF

= 10ns → fmax =

1

Tclk

= 100MHz

3. tℎoldFF ≤ tcdFF + tcdCL → slackℎold = tcdFF + tcdCL − tℎoldFF

= 1ns

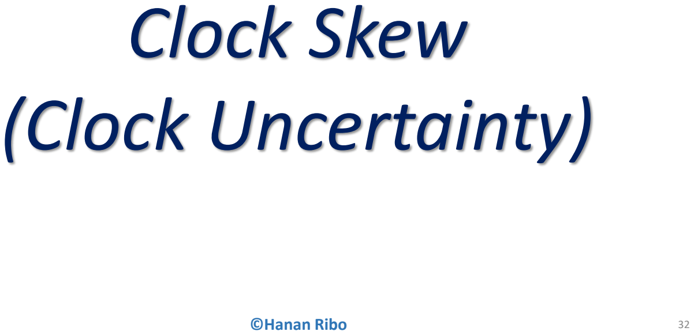
[picture p45: page 32]

©Hanan Ribo | 32

# Clock Skew (Clock Uncertainty)

# Wire Delay

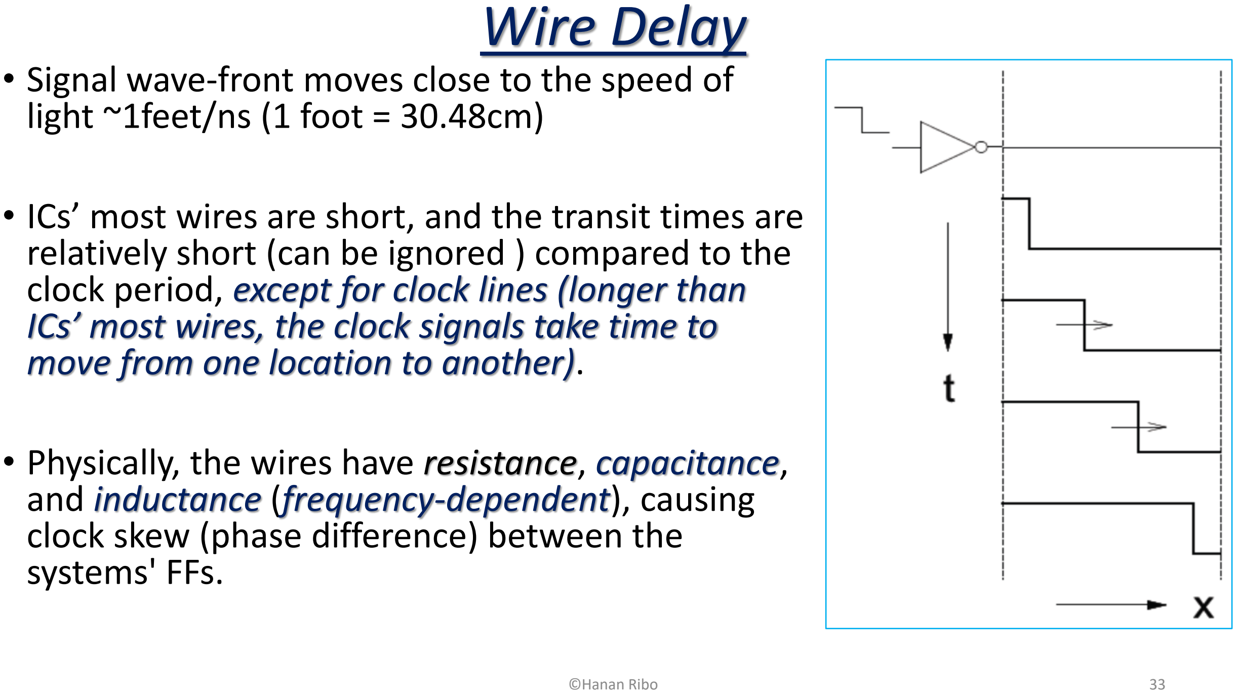
[picture p46: page 33]

©Hanan Ribo | 33
- Signal wave-front moves close to the speed of light ~1feet/ns (1 foot = 30.48cm)
- ICs’ most wires are short, and the transit times are relatively short (can be ignored ) compared to the clock period, except for clock lines (longer than ICs’ most wires, the clock signals take time to move from one location to another).
- Physically, the wires have resistance, capacitance, and inductance (frequency-dependent), causing clock skew (phase difference) between the systems' FFs.

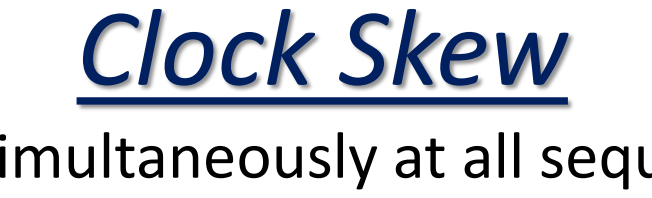
[picture p47: figure]
Clock Skew

Clock should theoretically arrive simultaneously at all sequential circuits. Practically, it arrives at different times. The differences are called clock skews.

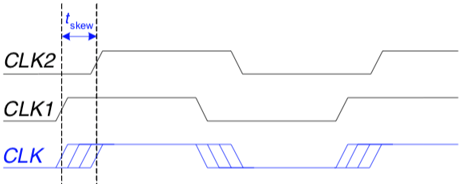
[picture p48: figure]
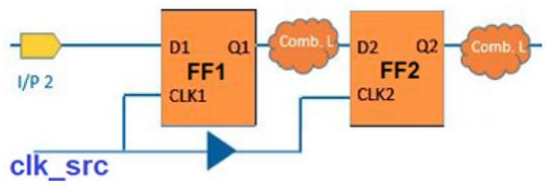
[picture p49: figure]
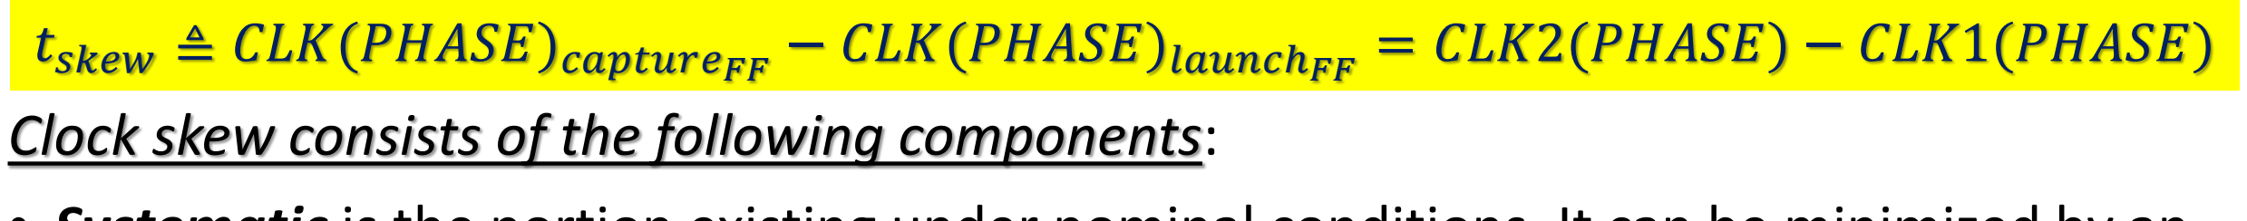
[picture p50: figure]
= CLK2(PHASE) − CLK1(PHASE)

Clock skew consists of the following components:
- Systematic is the portion existing under nominal conditions. It can be minimized by an appropriate design.
- Random is caused by process variations like devices’ channel length, oxide thickness, threshold voltage, wire thickness, width, and space. It can be measured on silicon and adjusted by delay components.
©Hanan Ribo | 34

tskew ≜ CLK(PHASE)captureFF − CLK(PHASE)launcℎFF

# Positive Clock Skew

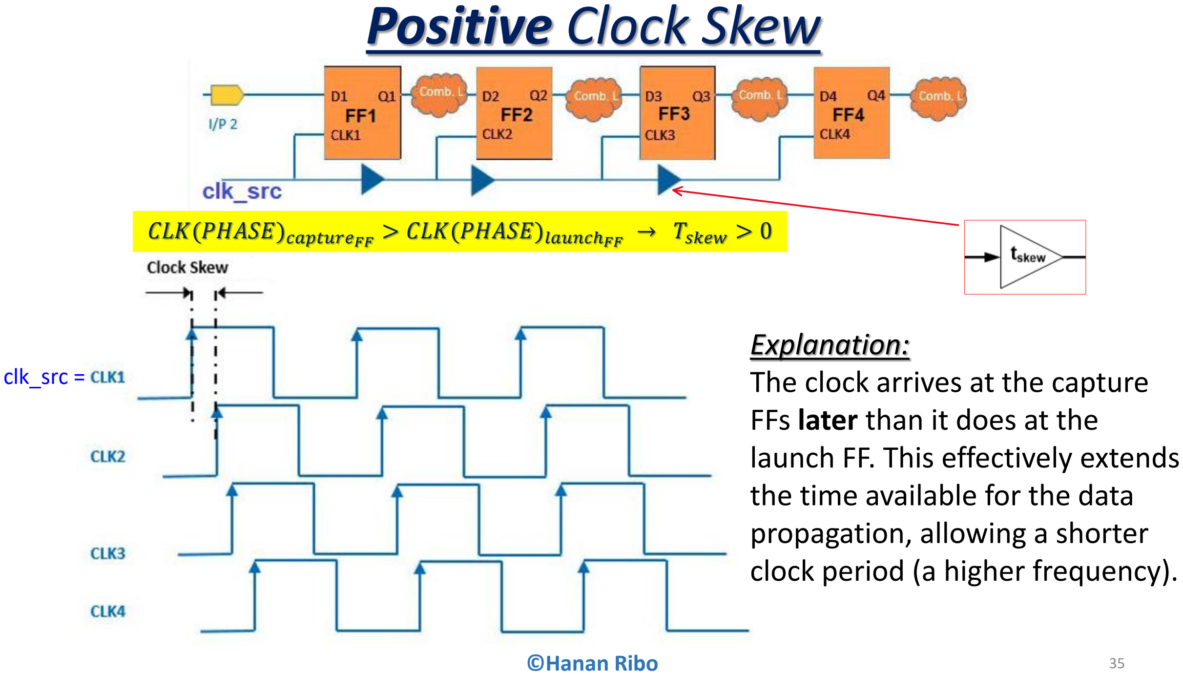
[picture p51: page 35]

©Hanan Ribo | 35

clk_src =

CLK(PHASE)captureFF > CLK(PHASE)launcℎFF

→ Tskew > 0

Explanation:
The clock arrives at the capture FFs later than it does at the launch FF. This effectively extends the time available for the data propagation, allowing a shorter clock period (a higher frequency).

# Positive Clock Skew

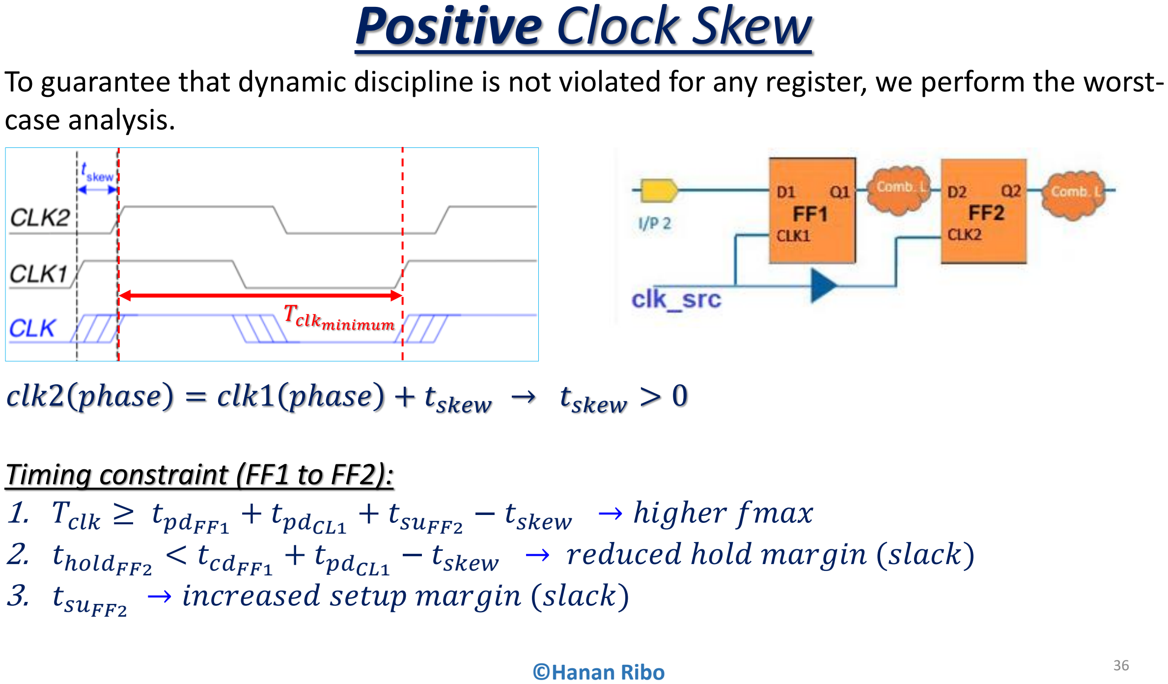
[picture p52: page 36]

©Hanan Ribo | 36

To guarantee that dynamic discipline is not violated for any register, we perform the worst-case analysis.

Timing constraint (FF1 to FF2):
1. Tclk ≥ tpdFF1 + tpdCL1 + tsuFF2 − tskew → ℎigℎer fmax
2. tℎoldFF2 < tcdFF1 + tpdCL1 − tskew → reduced ℎold margin (slack)
3. tsuFF2

→ increased setup margin (slack)

Tclkminimum

clk2 pℎase = clk1 pℎase + tskew → tskew > 0

# Positive Clock Skew

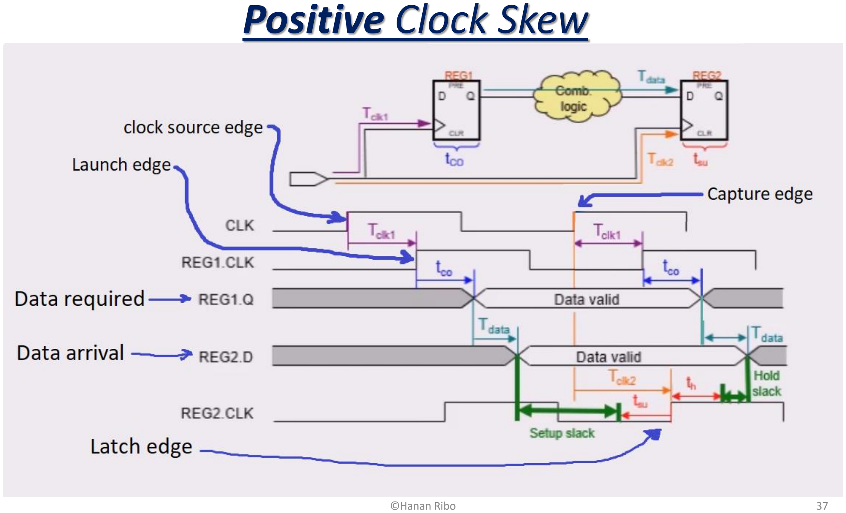
[picture p53: page 37]

©Hanan Ribo | 37

# Negative Clock Skew

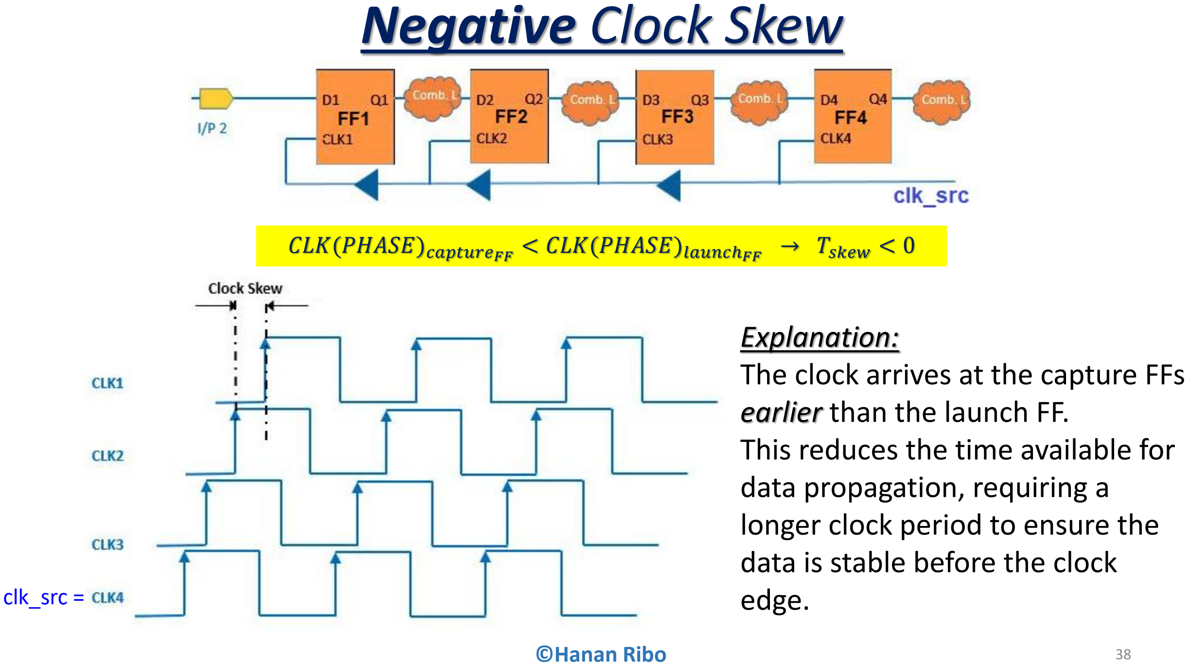
[picture p54: page 38]

©Hanan Ribo | 38

clk_src =

CLK(PHASE)captureFF < CLK(PHASE)launcℎFF

→ Tskew < 0

Explanation:
The clock arrives at the capture FFs earlier than the launch FF.
This reduces the time available for data propagation, requiring a longer clock period to ensure the data is stable before the clock edge.

# Negative Clock Skew

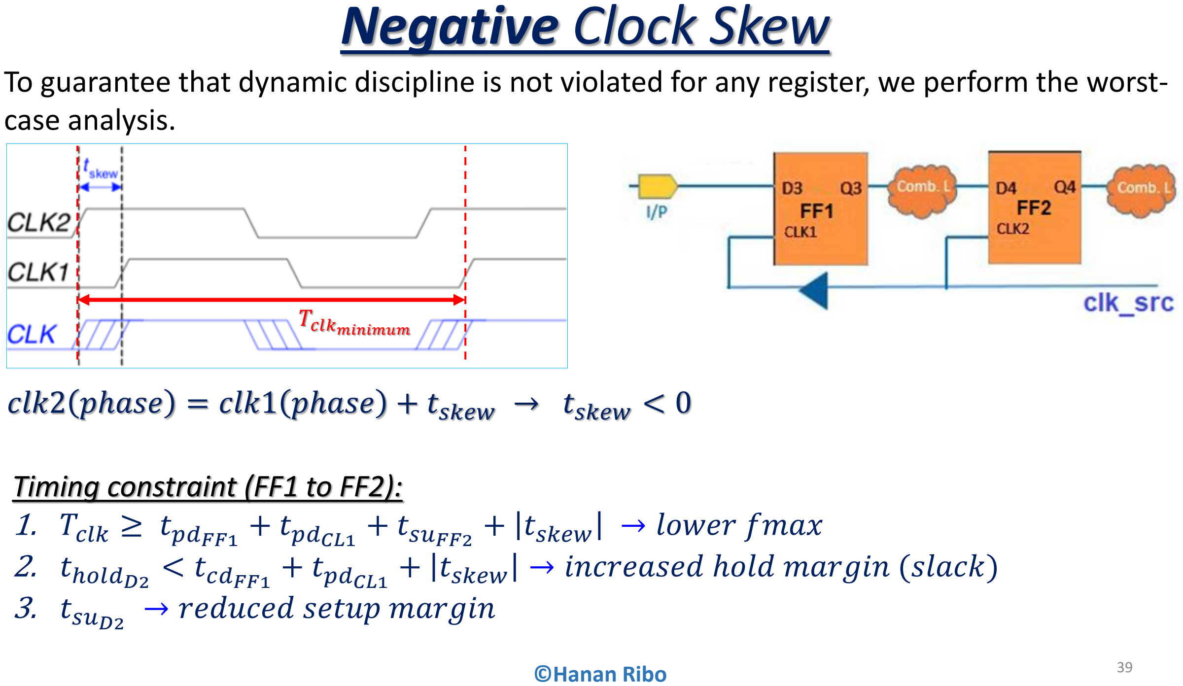
[picture p55: page 39]

©Hanan Ribo | 39

To guarantee that dynamic discipline is not violated for any register, we perform the worst-case analysis.

Timing constraint (FF1 to FF2):
1. Tclk ≥ tpdFF1 + tpdCL1 + tsuFF2 + | tskew | → lower fmax
2. tℎoldD2 < tcdFF1 + tpdCL1 + | tskew | → increased ℎold margin (slack)
3. tsuD2

→ reduced setup margin

clk2 pℎase = clk1 pℎase + tskew → tskew < 0

Tclkminimum

# Clock Skew - example

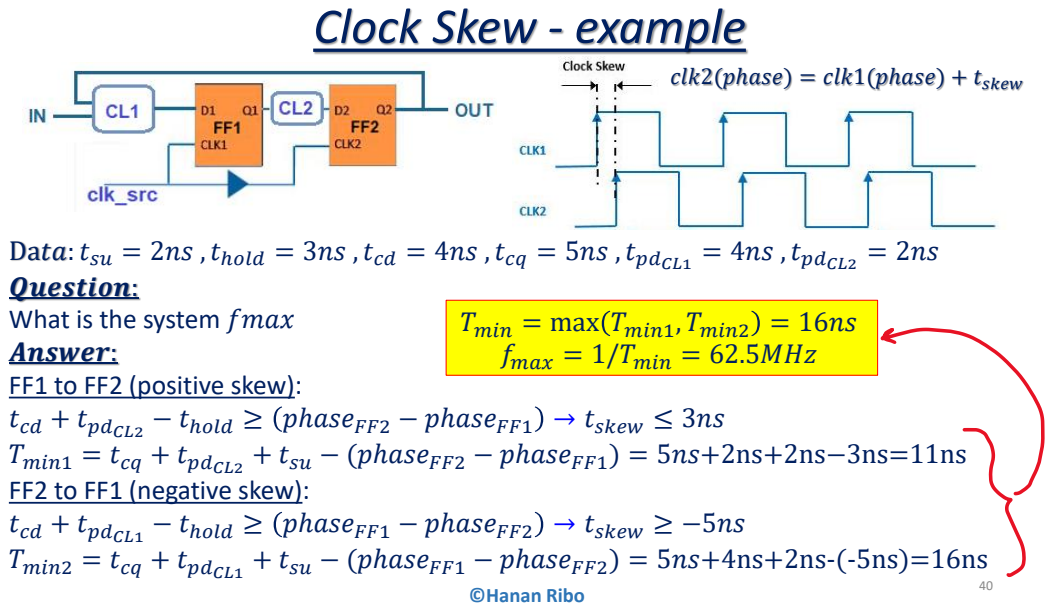
[picture p56: page 40]
©Hanan Ribo; = 4ns ,tpdCL2; Tmin = max Tmin1, Tmin2 = 16ns fmax = 1/Tmin = 62.5MHz

clk2(pℎase) = clk1(pℎase) + tskew

Data:tsu = 2ns ,tℎold = 3ns ,tcd = 4ns ,tcq = 5ns ,tpdCL1
Question:
What is the system fmax
Answer:
FF1 to FF2 (positive skew):
tcd + tpdCL2 − tℎold ≥ pℎaseFF2 − pℎaseFF1 → tskew ≤ 3ns
Tmin1 = tcq + tpdCL2 + tsu − (pℎaseFF2 − pℎaseFF1) = 5ns+2ns+2ns−3ns=11ns
FF2 to FF1 (negative skew):
tcd + tpdCL1 − tℎold ≥ pℎaseFF1 − pℎaseFF2 → tskew ≥ −5ns
Tmin2 = tcq + tpdCL1 + tsu − (pℎaseFF1 − pℎaseFF2) = 5ns+4ns+2ns-(-5ns)=16ns
