Adar-Shapira/rv32im-mcu-project/Auxiliary/Lab4/Auxiliary/FPGA_Quartus_PLL_SignalTap_DE2-115.pdf

©Hanan Ribo

## Table of Contents

### A. Create a New Project:

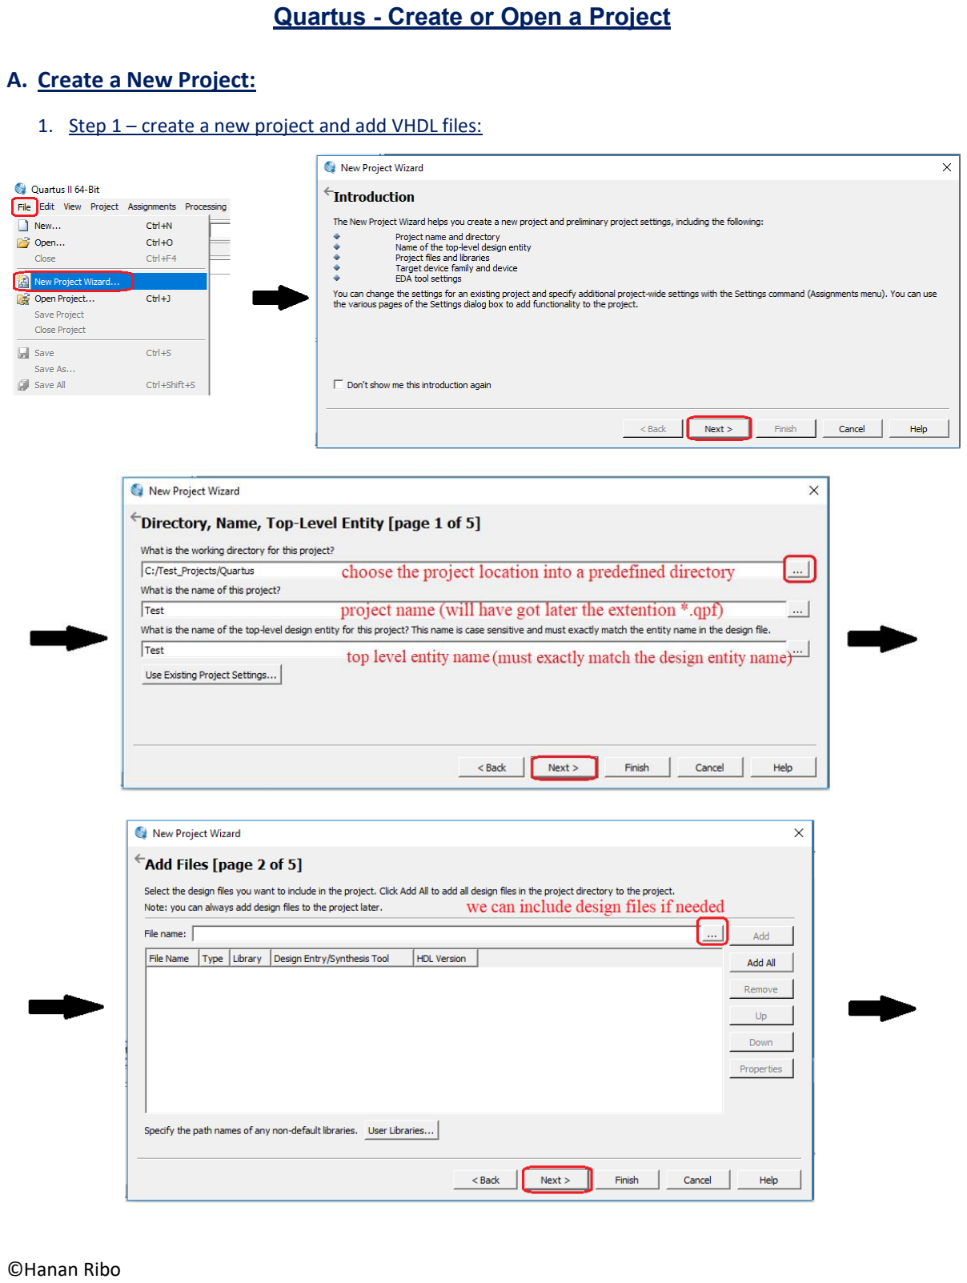
[picture p57: page 2]

### Quartus - Create or Open a Project

1. Step 1 – create a new project and add VHDL files:

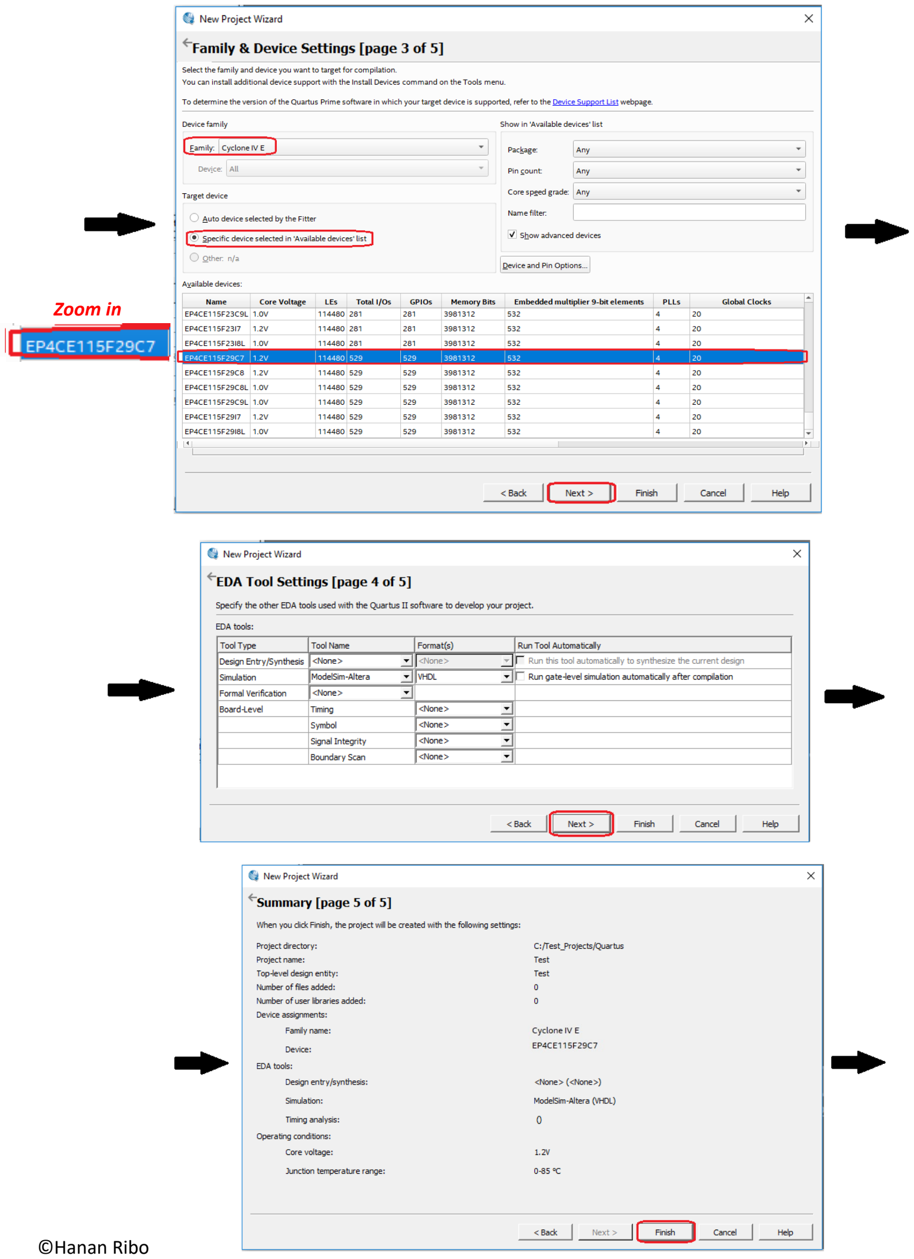
[picture p58: page 3]

Zoom in

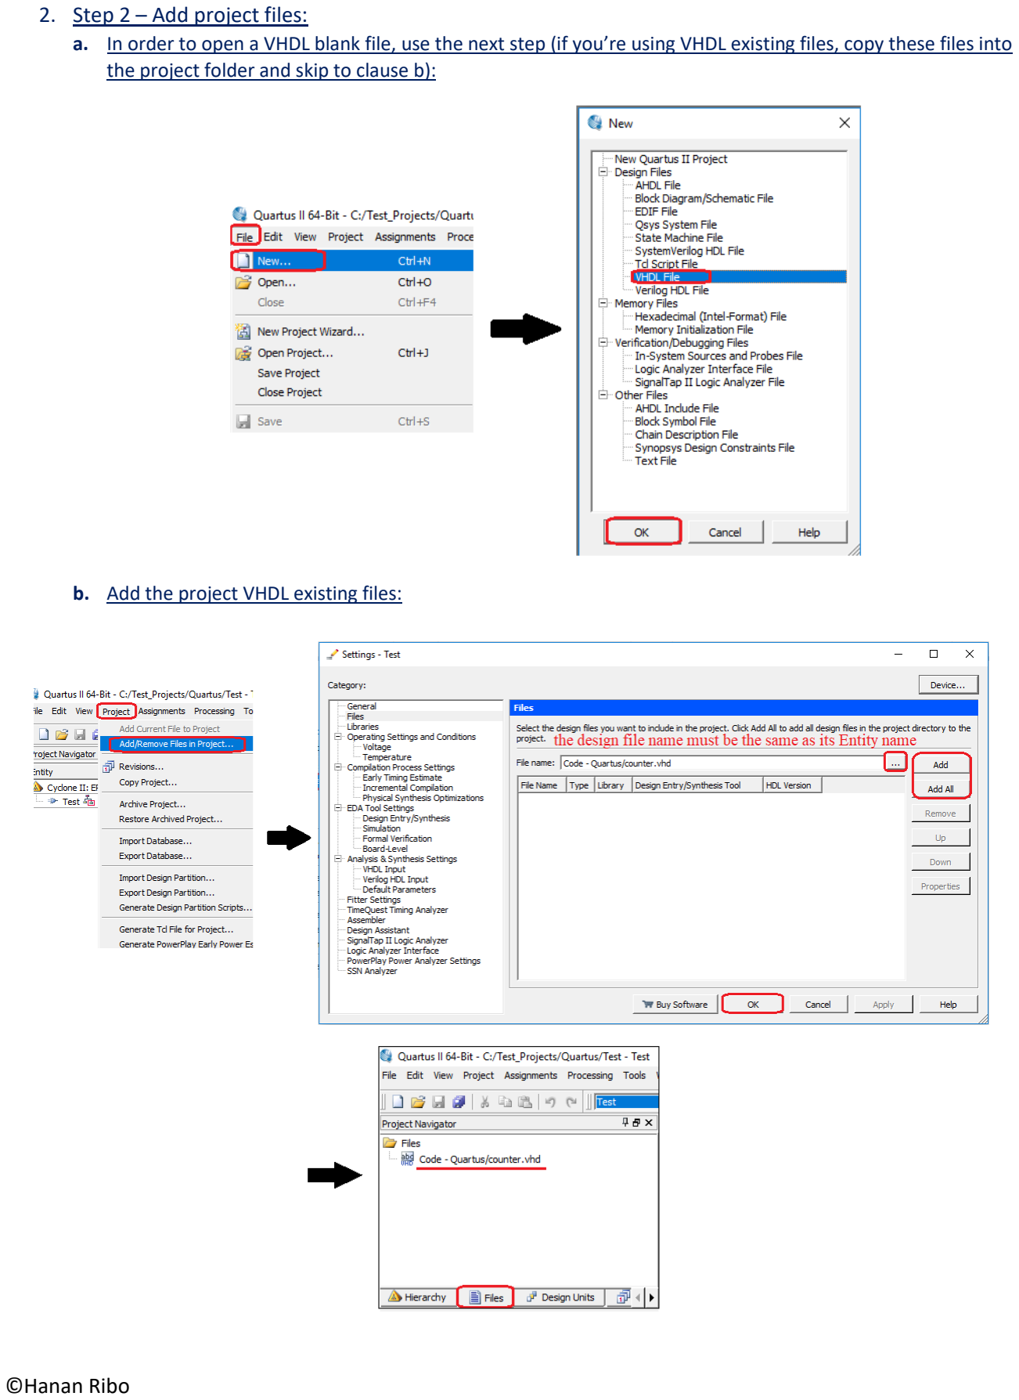
[picture p59: page 4]

2. Step 2 – Add project files:
a. In order to open a VHDL blank file, use the next step (if you’re using VHDL existing files, copy these files into the project folder and skip to clause b):
b. Add the project VHDL existing files:

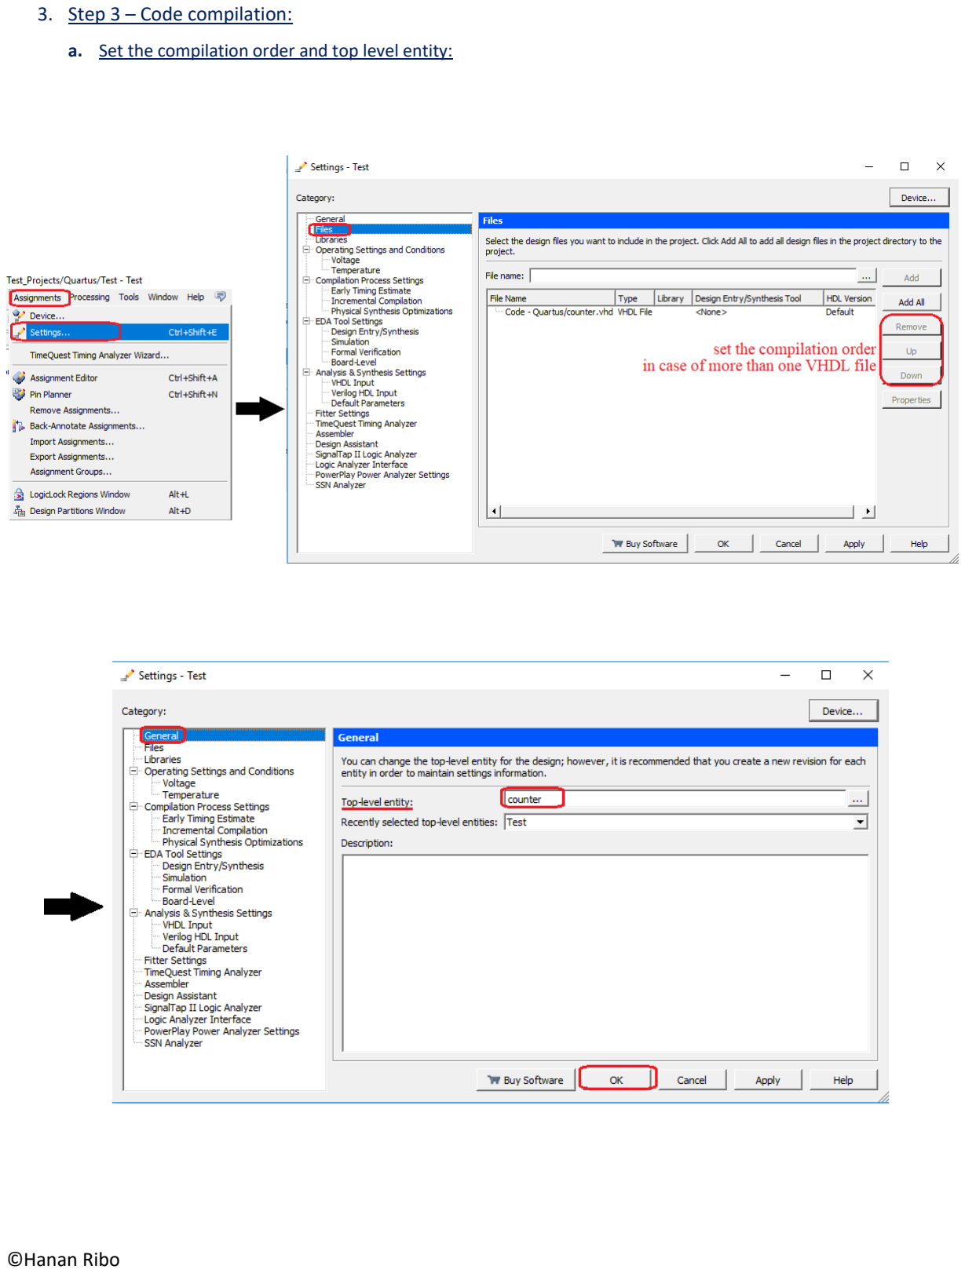
[picture p60: page 5]

3. Step 3 – Code compilation:
a. Set the compilation order and top level entity:

### counter.vhd

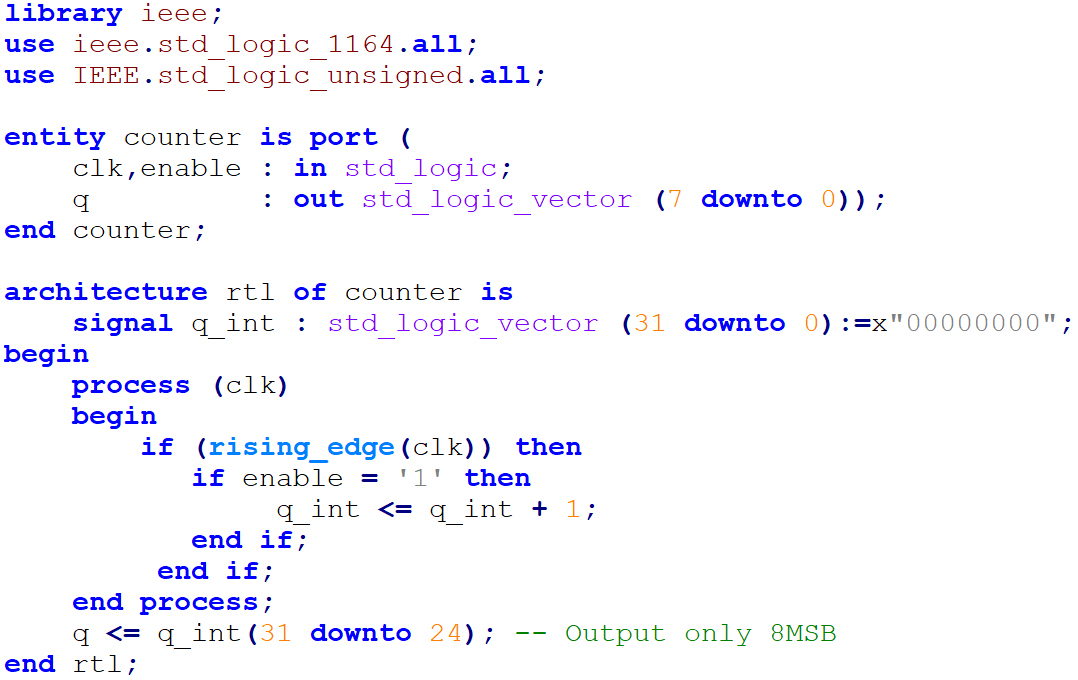
[picture p61: figure]

Example application:

◼ 32bit behavioral counter with enable

◼ 8-bit MSB of counter output are connected to red LEDs (LEDR7-LEDR0)

◼ Enable connected to switch SW0

◼ 50MHz on board clock named CLOCK_50

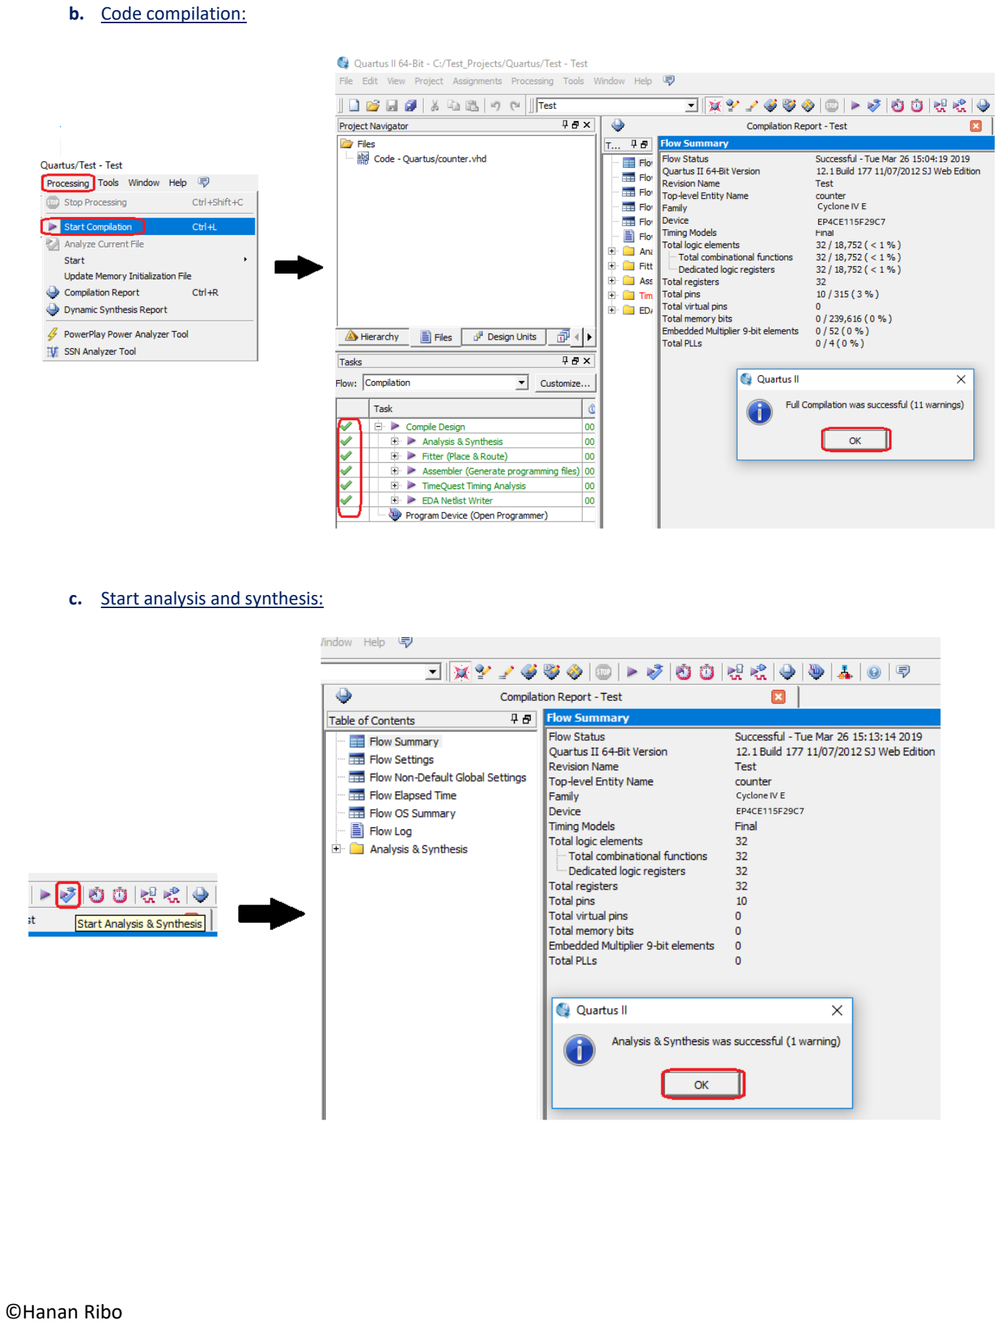
[picture p62: page 7]

b. Code compilation:
c. Start analysis and synthesis:

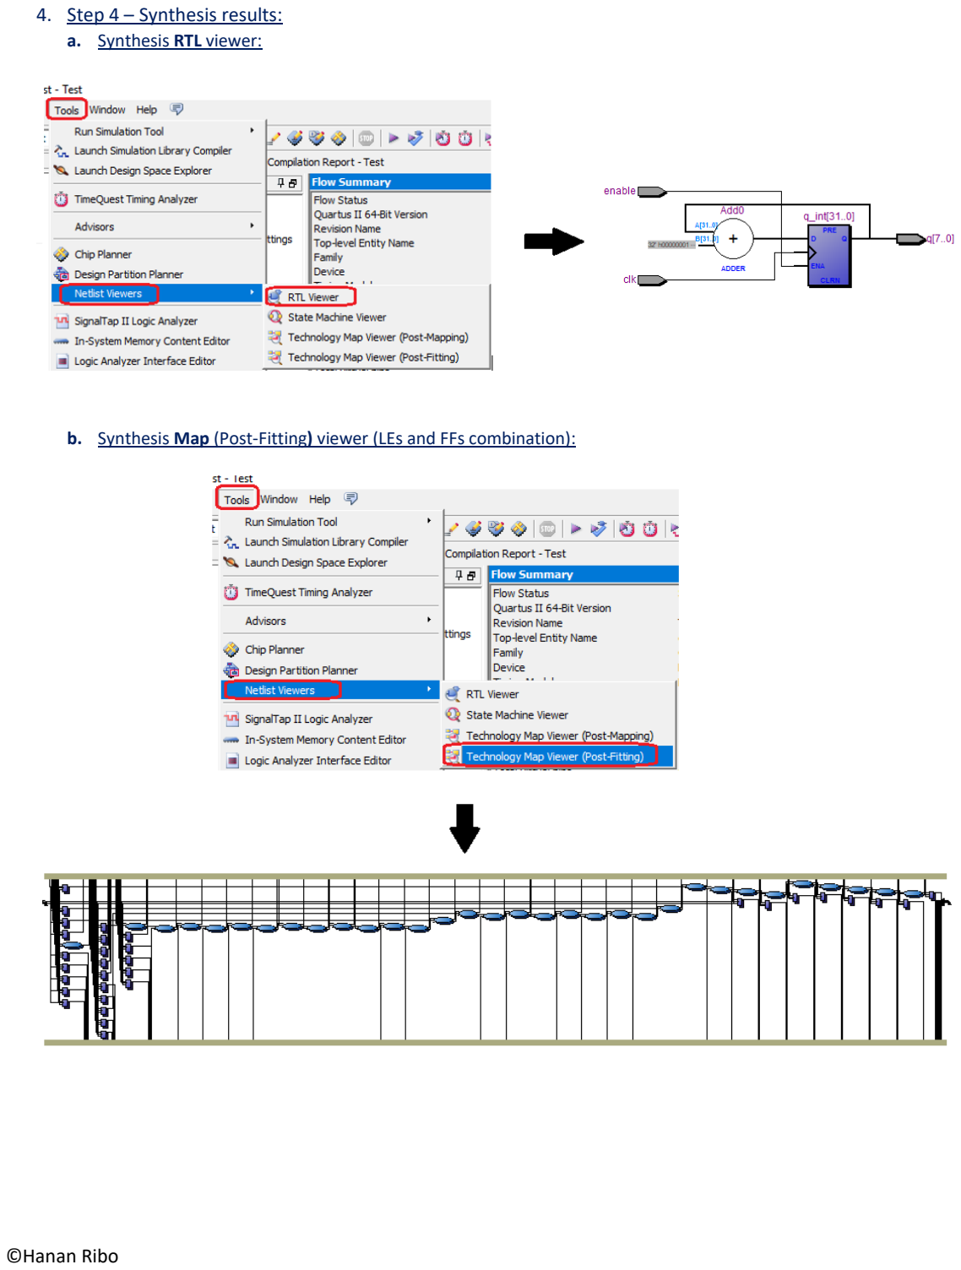
[picture p63: page 8]

4. Step 4 – Synthesis results:
a. Synthesis RTL viewer:
b. Synthesis Map (Post-Fitting) viewer (LEs and FFs combination):

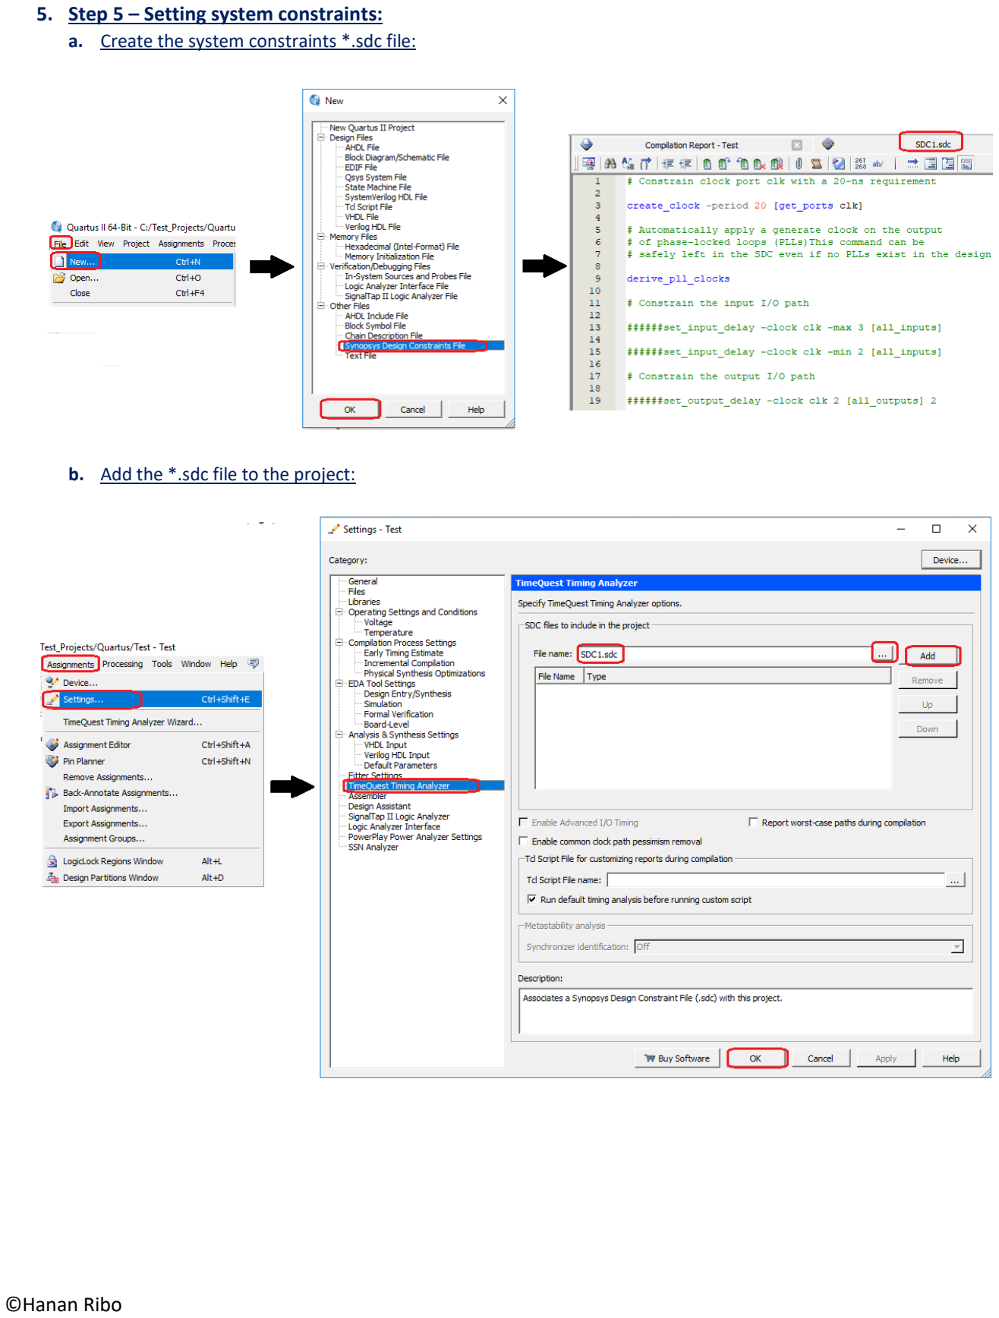
[picture p64: page 9]

### 5. Step 5 – Setting system constraints:

a. Create the system constraints *.sdc file:
b. Add the *.sdc file to the project:

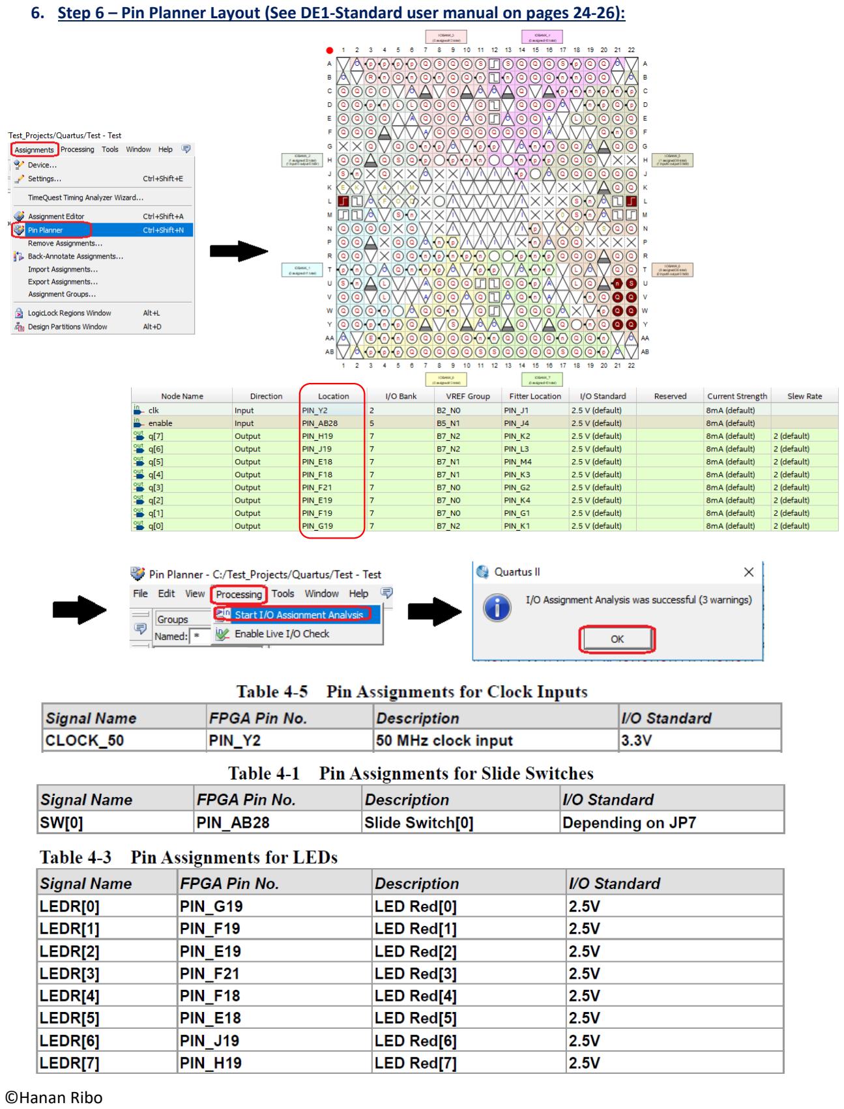
[picture p65: page 10]

### 6. Step 6 – Pin Planner Layout (See DE1-Standard user manual on pages 24-26):

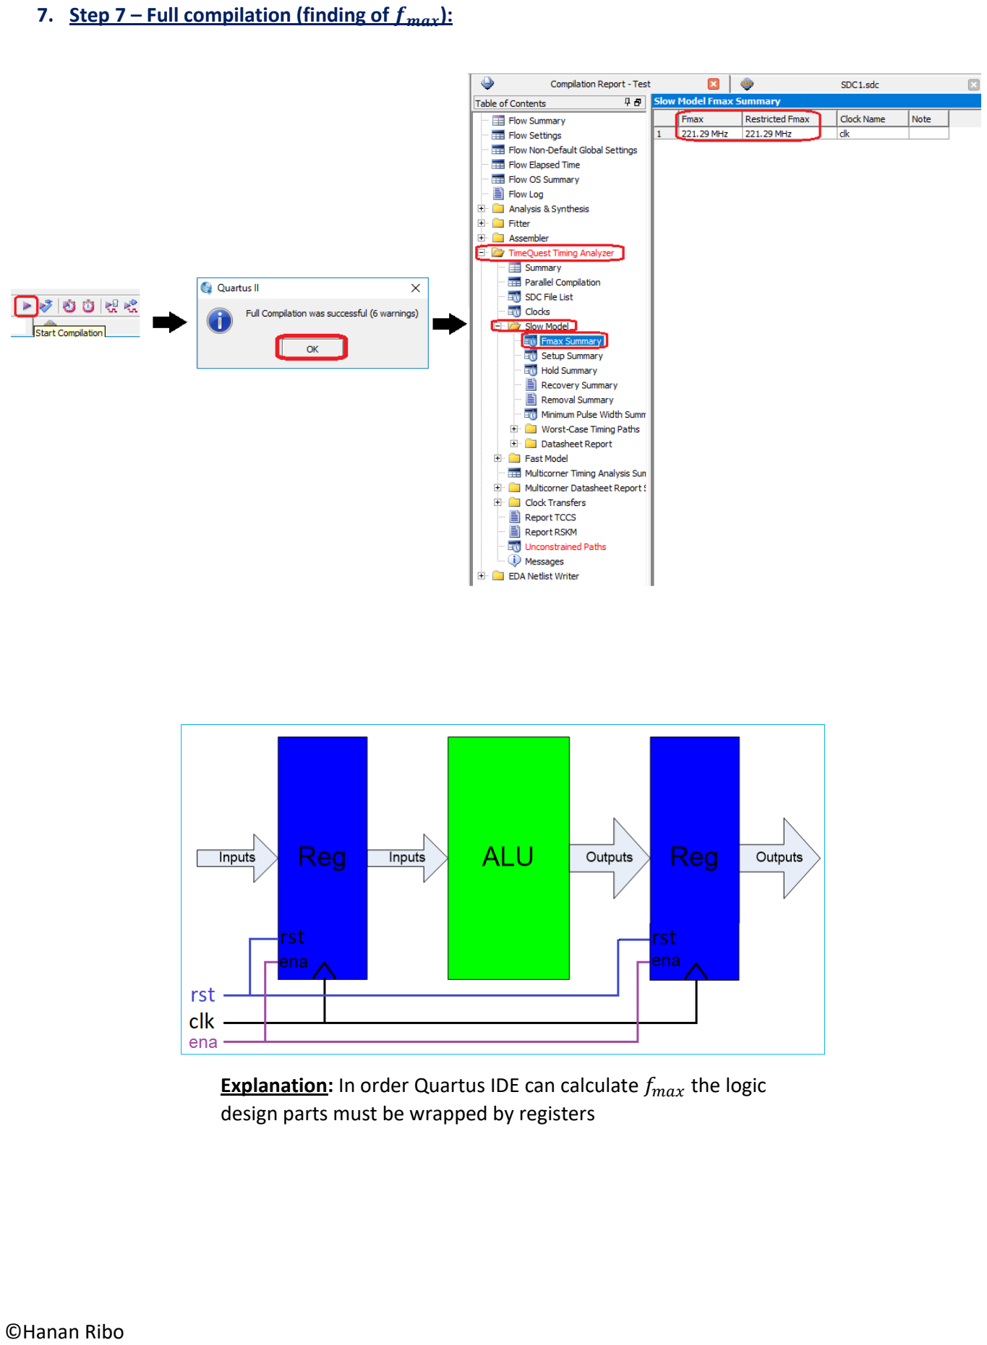
[picture p66: page 11]

### 7. Step 7 – Full compilation (finding of fmax):

Explanation: In order Quartus IDE can calculate fmax the logic design parts must be wrapped by registers

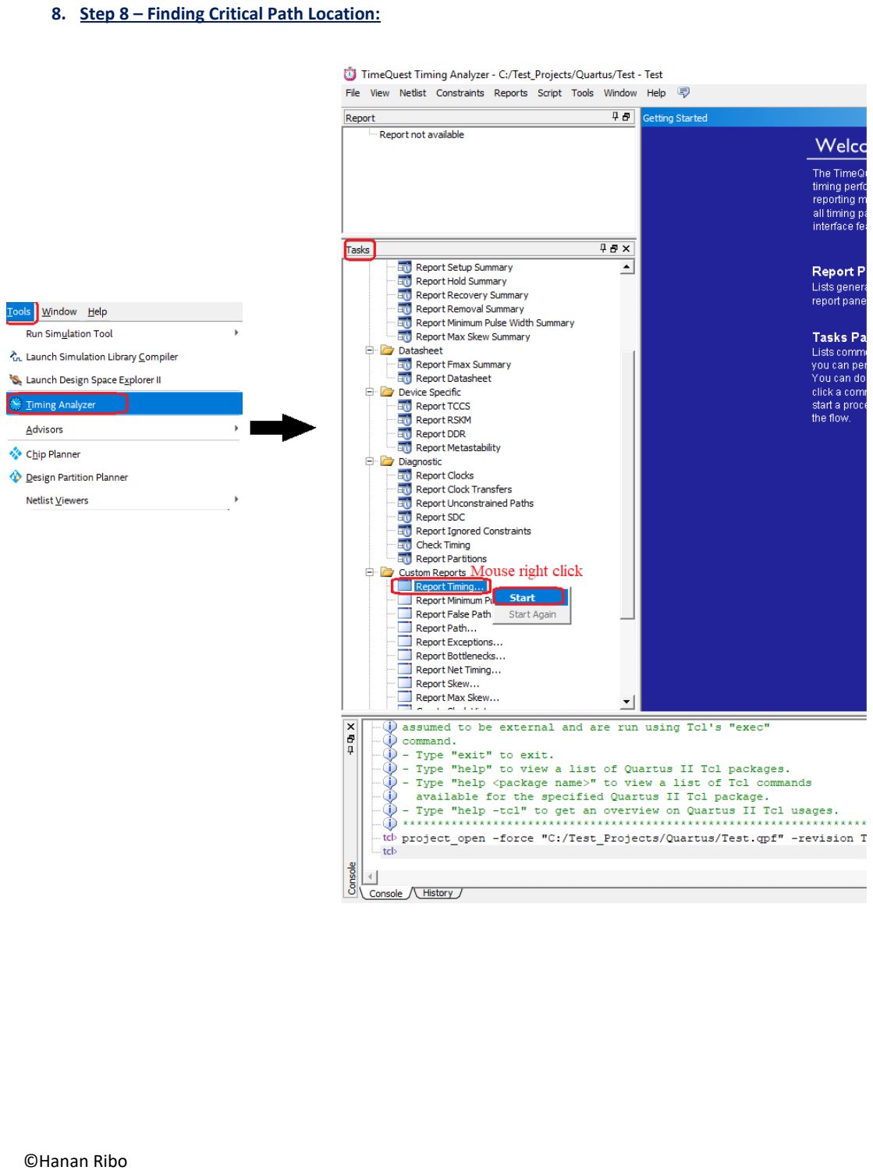
[picture p67: page 12]

### 8. Step 8 – Finding Critical Path Location:

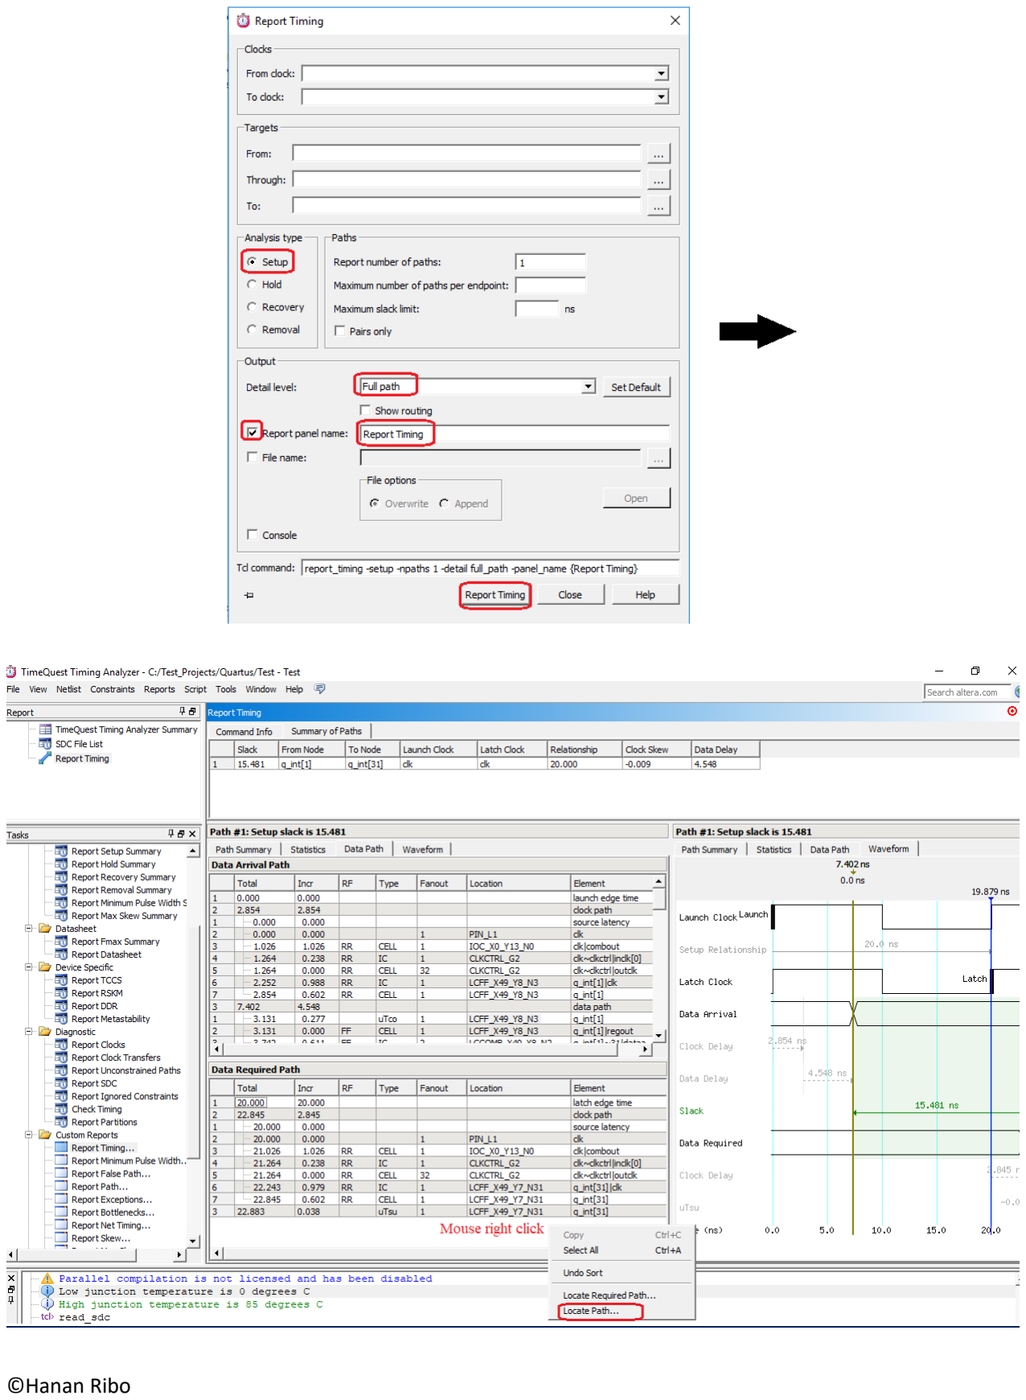
[picture p68: page 13]
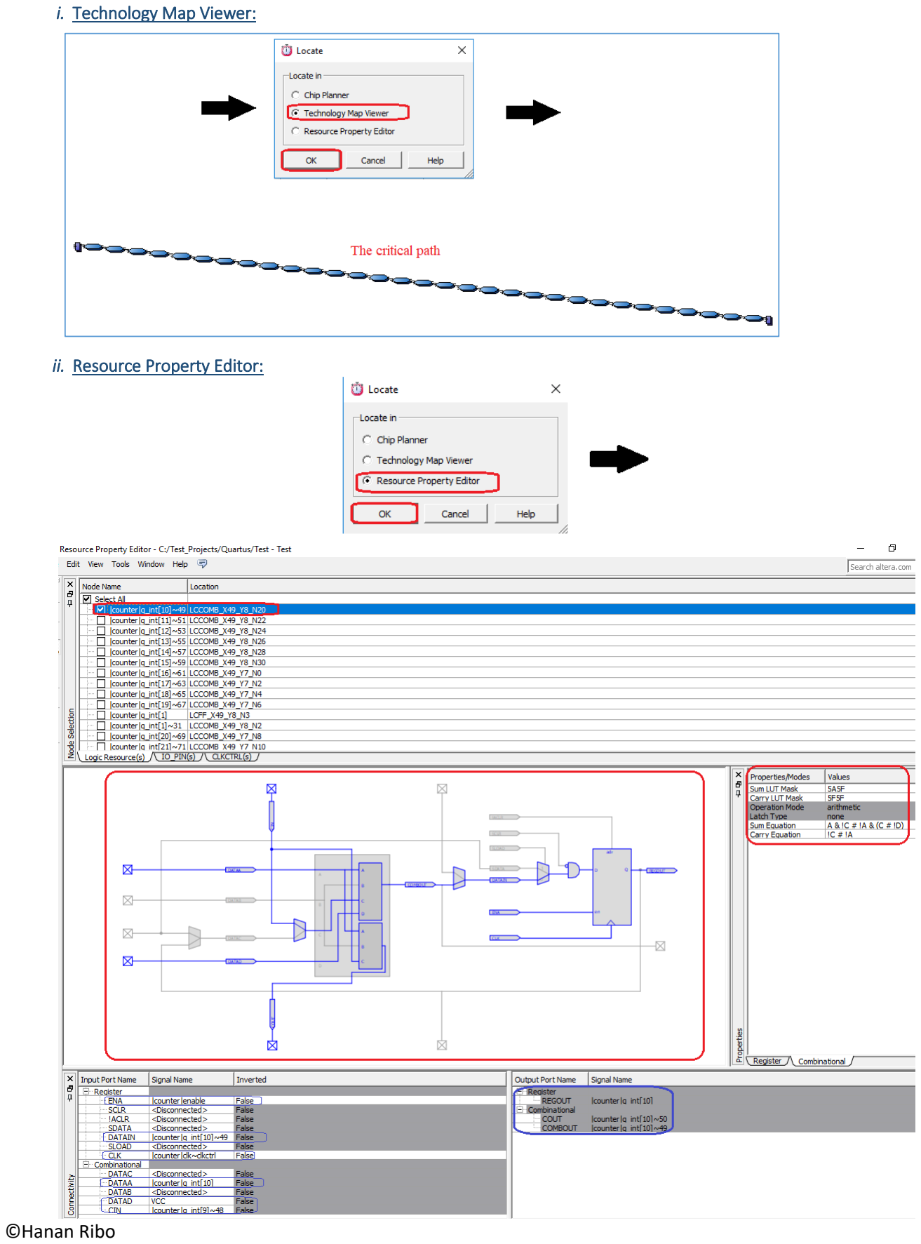
[picture p69: page 14]

i. Technology Map Viewer:

ii. Resource Property Editor:

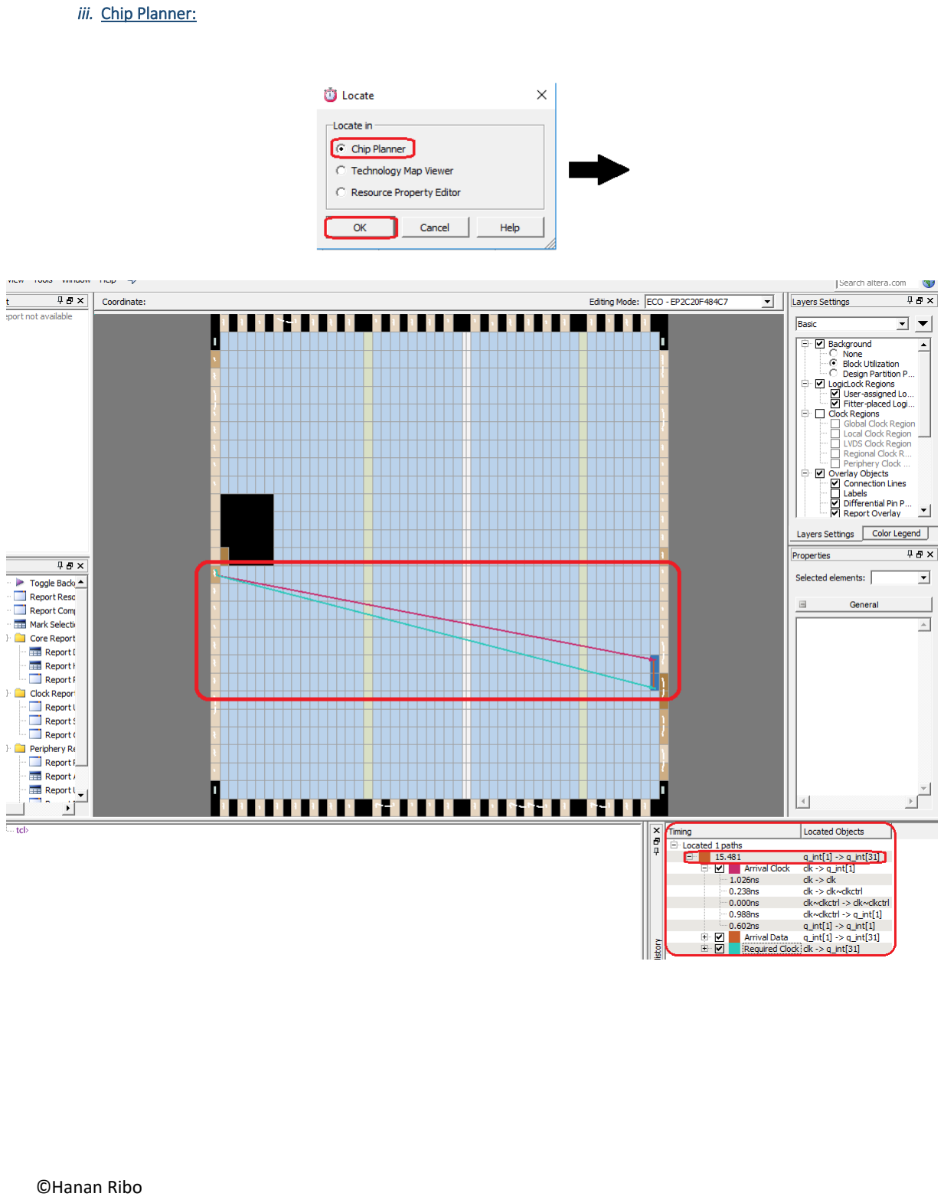
[picture p70: page 15]

iii. Chip Planner:

### 9. Step 9 – Quartus Power Analyzer:

Quartus power analysis using a *.vcd (Value Change Dump) file provides accurate power estimation by analyzing real signal activities from simulation. The process involves generating a VCD file from ModelSim during gate-level simulation, configuring the Power Analyzer in Quartus, and running the analysis.

Steps for Power Analysis Using a VCD File:

a. Generate the VCD File:
i. Compile-All and start the simulation of the required ModelSim project: Tcl commands:
project calculateorder
project compileall
vsim tb_entity_name
ii. Create a *.vcd file, add all DUT signals, run the simulation, and save the file:
Tcl commands:
vcd file filename.vcd // create a *.vcd file
vcd add tb_entity_name /* // add the top entity signals (keep tb and top the same signal names)
run 20 us | // in case the clock cycle time is 20ns, run simulation for 1000 cycles
vcd flush | // immediate writing of buffered VCD data to the VCD file
b. Configure Quartus Power Analyzer:
i. Open your project in Quartus
ii. Go to Assignments > Settings > Power Analyzer Settings
iii. Under Input signal activities, select Simulation Results
iv. Select File name and browse to your generated .vcd file, click OK
v. Click Processing > Power Analyzer Tool > Set Operating Conditions (cooling Solution and Temperature …)
vi. Click Start, and at the simulation's end, click Report to get the Power Analysis report

Key Tips for VCD Power Analysis:

i. Glitch Filtering: Use the recommended simulator settings to enable glitch filtering to prevent overestimating dynamic power.
ii. Vectorless Estimation: If you do not have a full VCD file, you can use vectorless estimation, but it is less accurate.
iii. Simulation Time: Ensure the VCD file captures a long enough period to represent typical design activity.

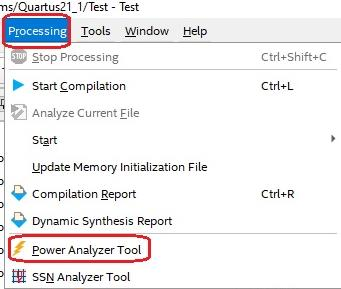
[picture p71: figure]
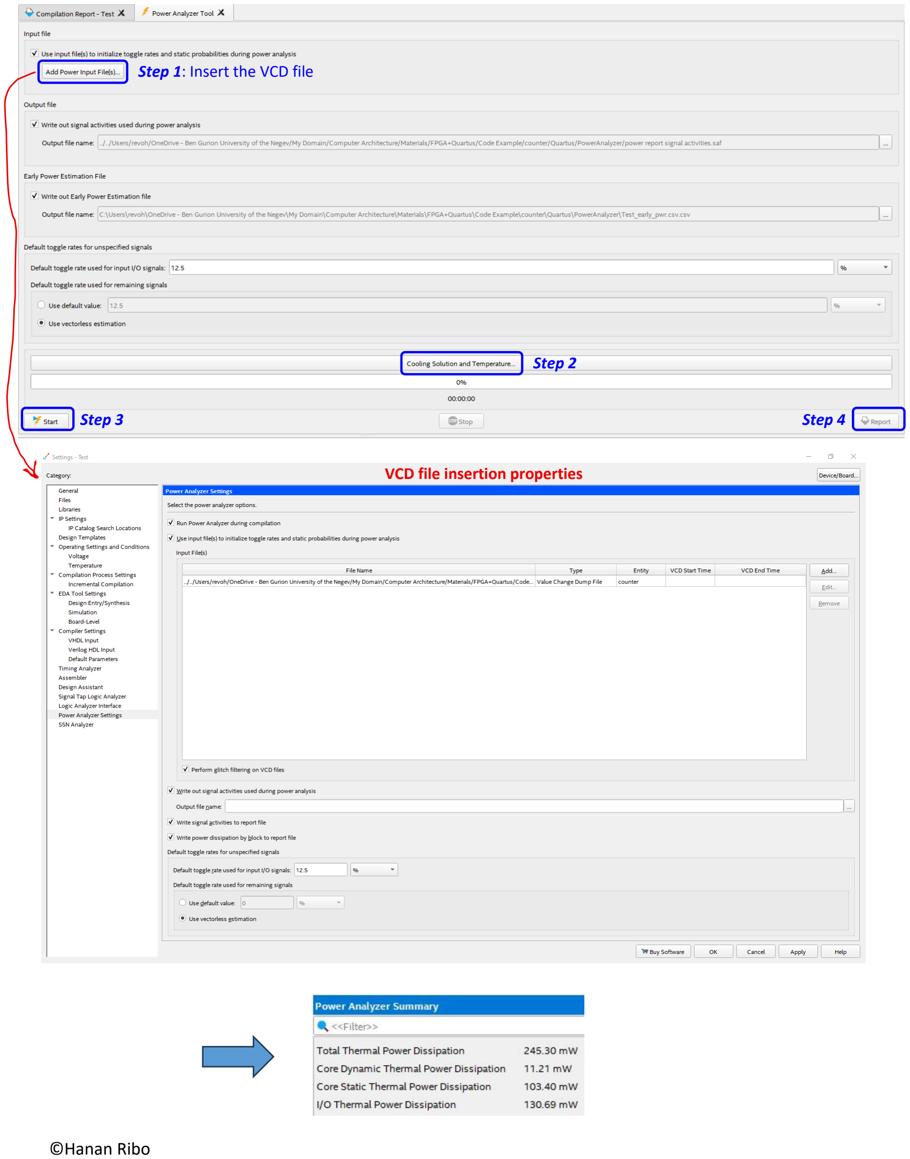
[picture p72: page 17]

Step 1: Insert the VCD file

VCD file insertion properties

Step 3
Step 2
Step 4

1 2

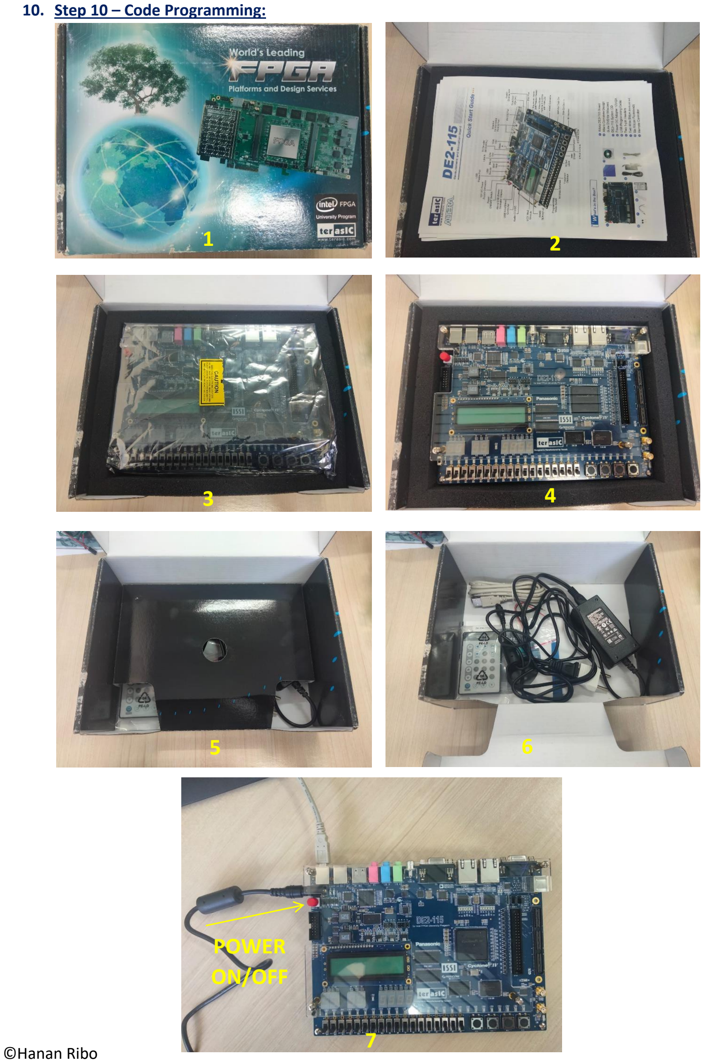
[picture p73: page 18]

### 10. Step 10 – Code Programming:

3 4

5 6

7

## POWER ON/OFF

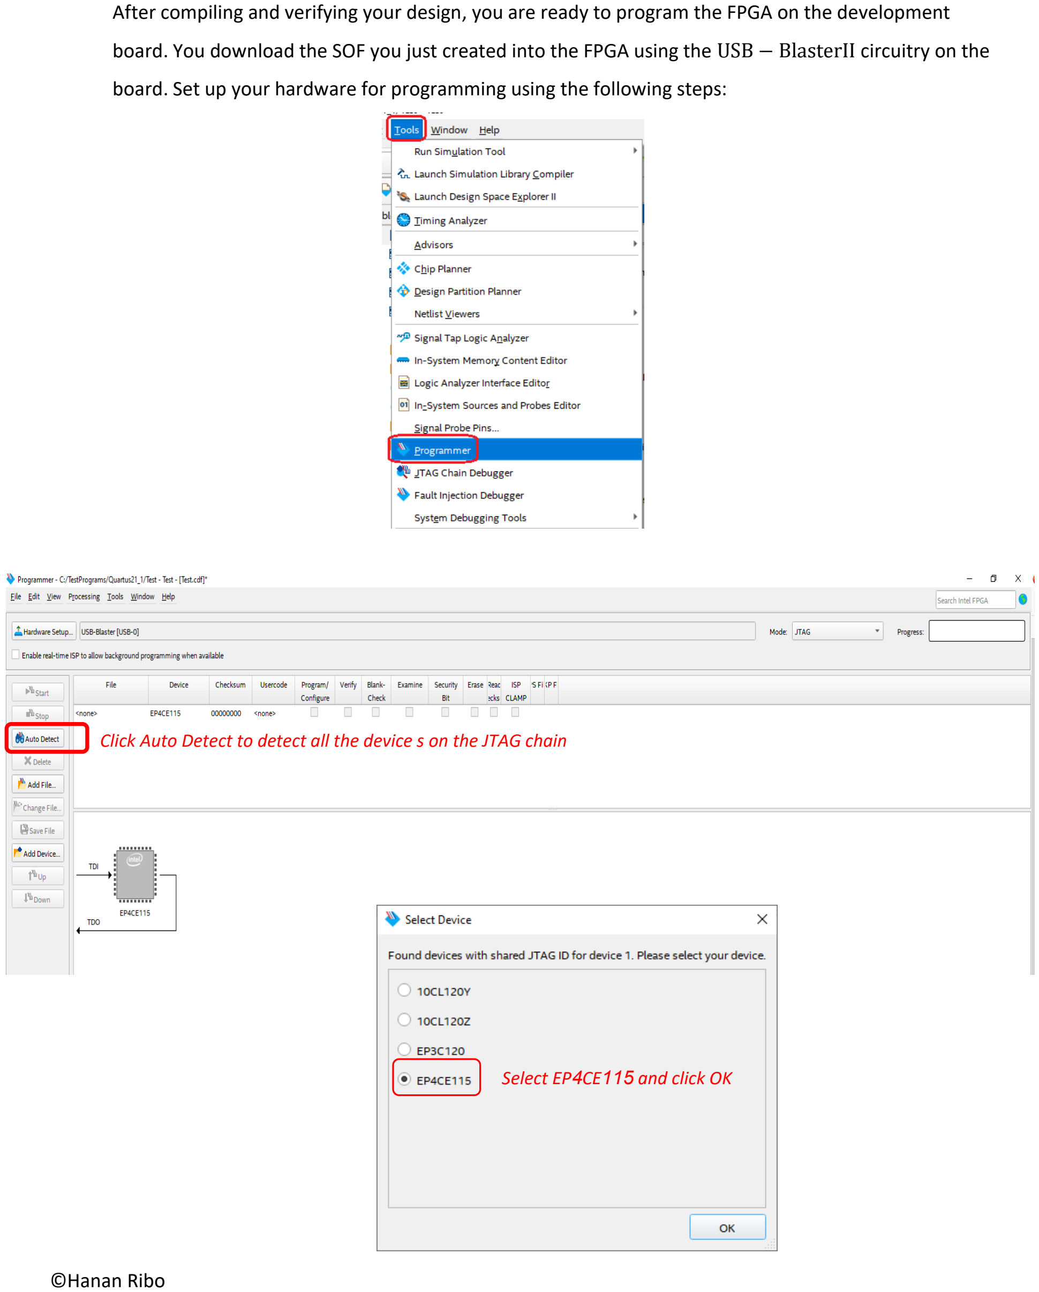
[picture p74: page 19]

After compiling and verifying your design, you are ready to program the FPGA on the development

board. You download the SOF you just created into the FPGA using the USB − BlasterII circuitry on the

board. Set up your hardware for programming using the following steps:

Click Auto Detect to detect all the device s on the JTAG chain

Select EP4CE115 and click OK

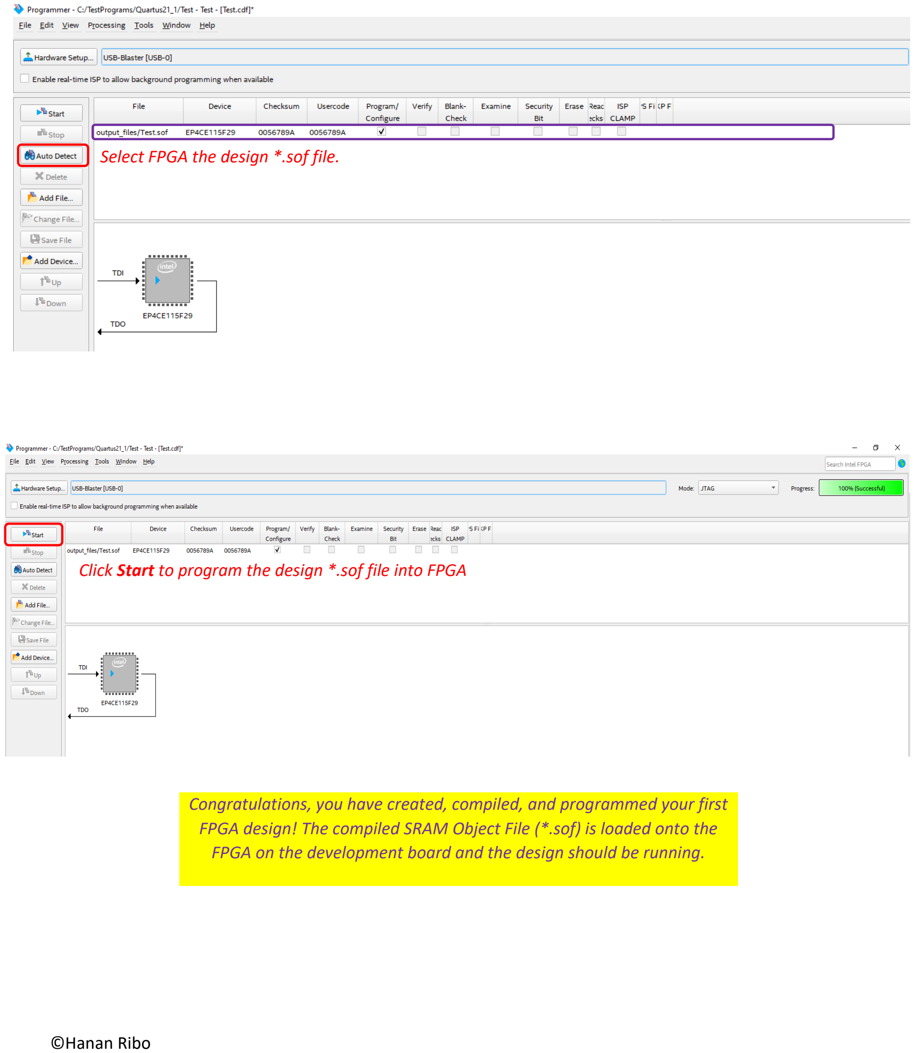
[picture p75: page 20]

Select FPGA the design *.sof file.

Click Start to program the design *.sof file into FPGA

Congratulations, you have created, compiled, and programmed your first FPGA design! The compiled SRAM Object File (*.sof) is loaded onto the FPGA on the development board and the design should be running.

### B. Validation – Using Signal TAP:

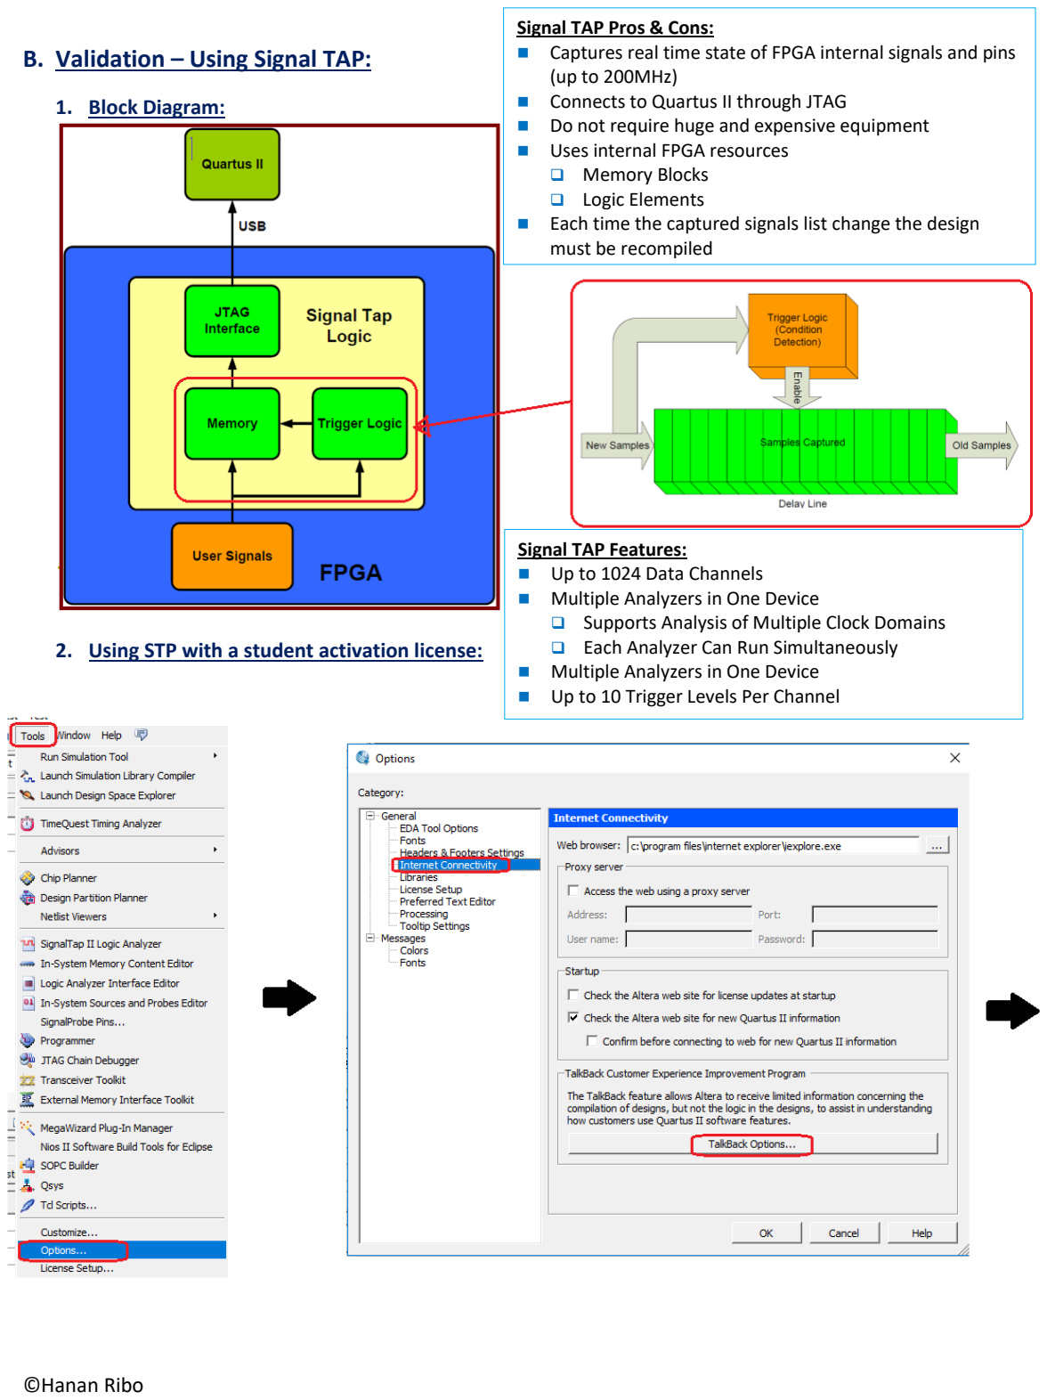
[picture p76: page 21]

### 1. Block Diagram:

### 2. Using STP with a student activation license:

Signal TAP Pros & Cons:
◼ Captures real time state of FPGA internal signals and pins (up to 200MHz)
◼ | Connects to Quartus II through JTAG
◼ | Do not require huge and expensive equipment
◼ | Uses internal FPGA resources
❑ | Memory Blocks
❑ | Logic Elements
◼ | Each time the captured signals list change the design
must be recompiled

Signal TAP Features:
◼ | Up to 1024 Data Channels
◼ | Multiple Analyzers in One Device
❑ | Supports Analysis of Multiple Clock Domains
❑ | Each Analyzer Can Run Simultaneously
◼ | Multiple Analyzers in One Device
◼ | Up to 10 Trigger Levels Per Channel

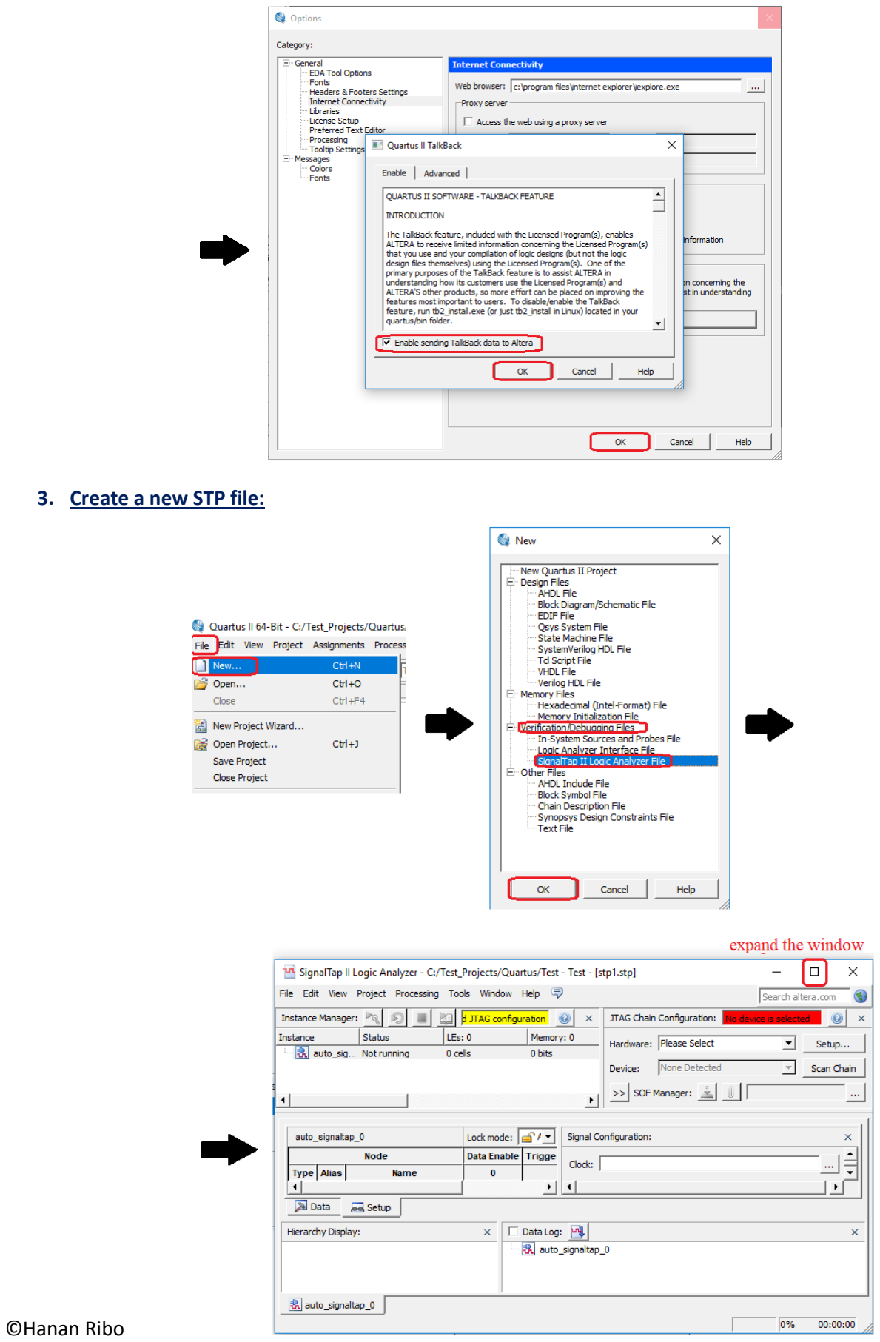
[picture p77: page 22]

### 3. Create a new STP file:

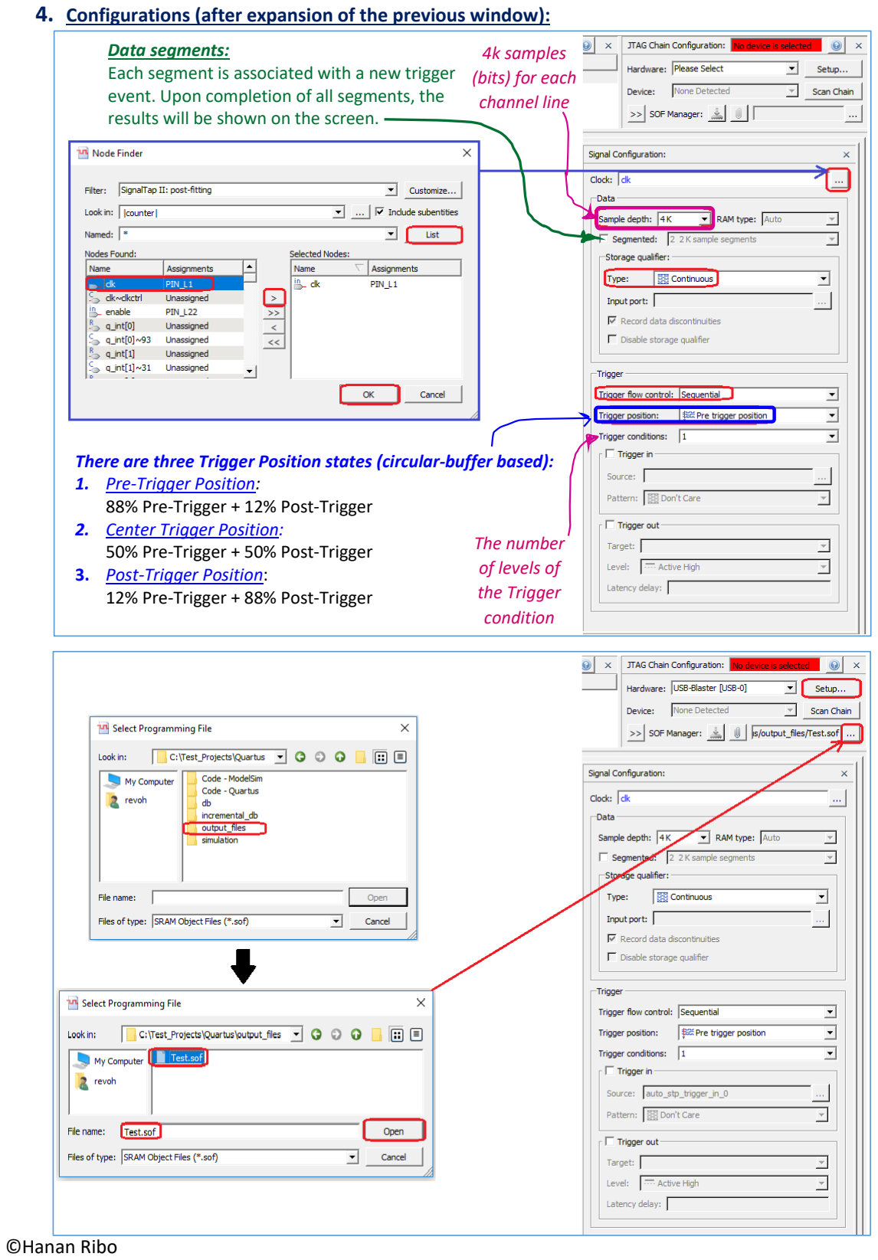
[picture p78: page 23]

### 4. Configurations (after expansion of the previous window):

There are three Trigger Position states (circular-buffer based):

### 1. Pre-Trigger Position:

88% Pre-Trigger + 12% Post-Trigger

### 2. Center Trigger Position:

50% Pre-Trigger + 50% Post-Trigger

### 3. Post-Trigger Position:

12% Pre-Trigger + 88% Post-Trigger

Data segments:
Each segment is associated with a new trigger event. Upon completion of all segments, the results will be shown on the screen.

4k samples
(bits) for each
channel line

The number
of levels of
the Trigger
condition

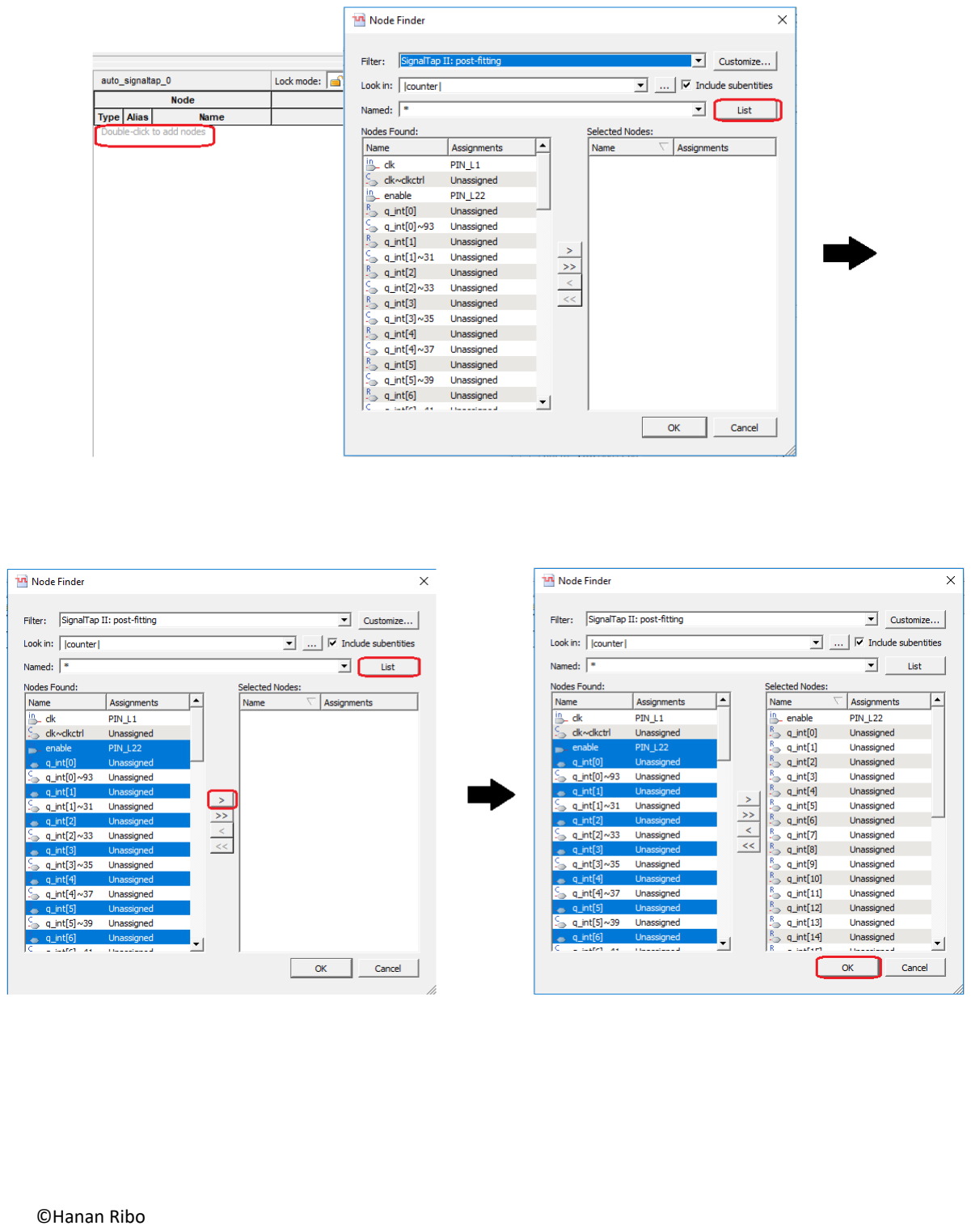
[picture p79: page 24]
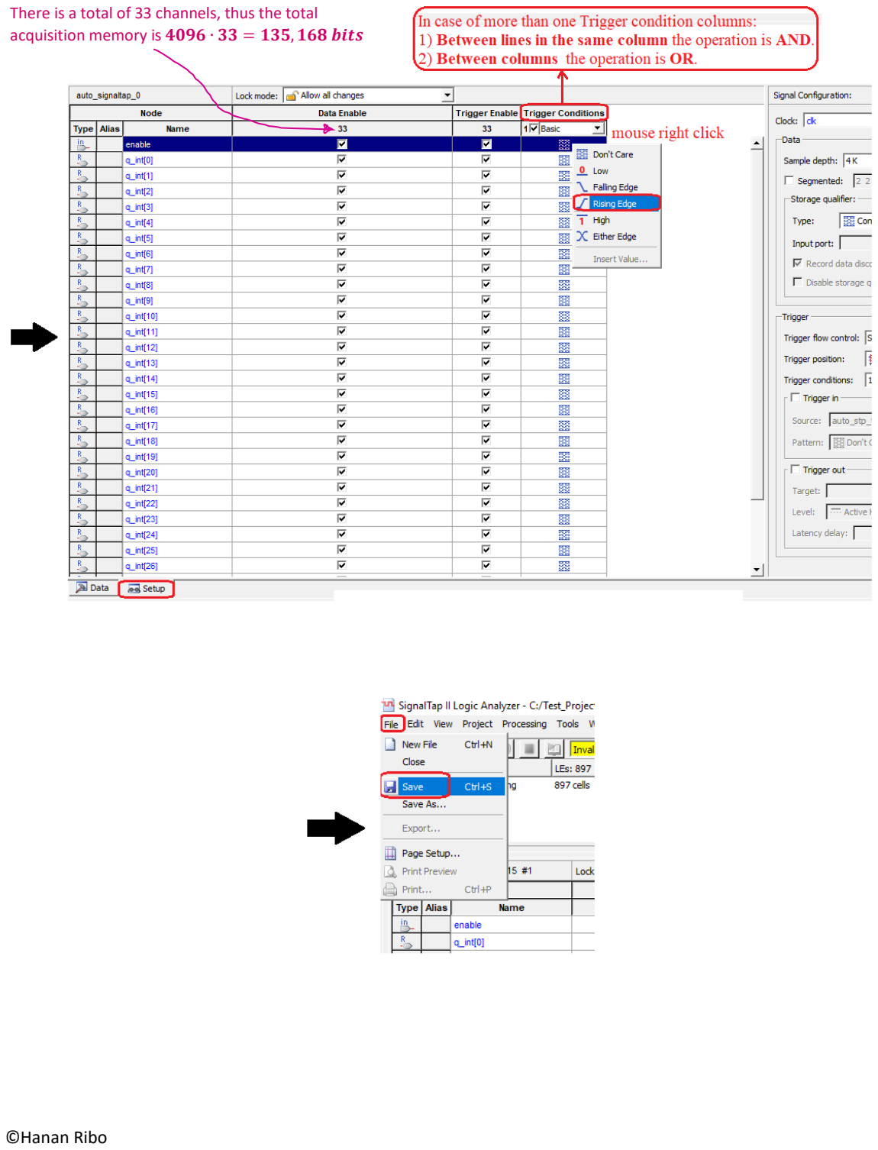
[picture p80: page 25]

There is a total of 33 channels, thus the total acquisition memory is 4096 ∙ 33 = 135, 168 bits

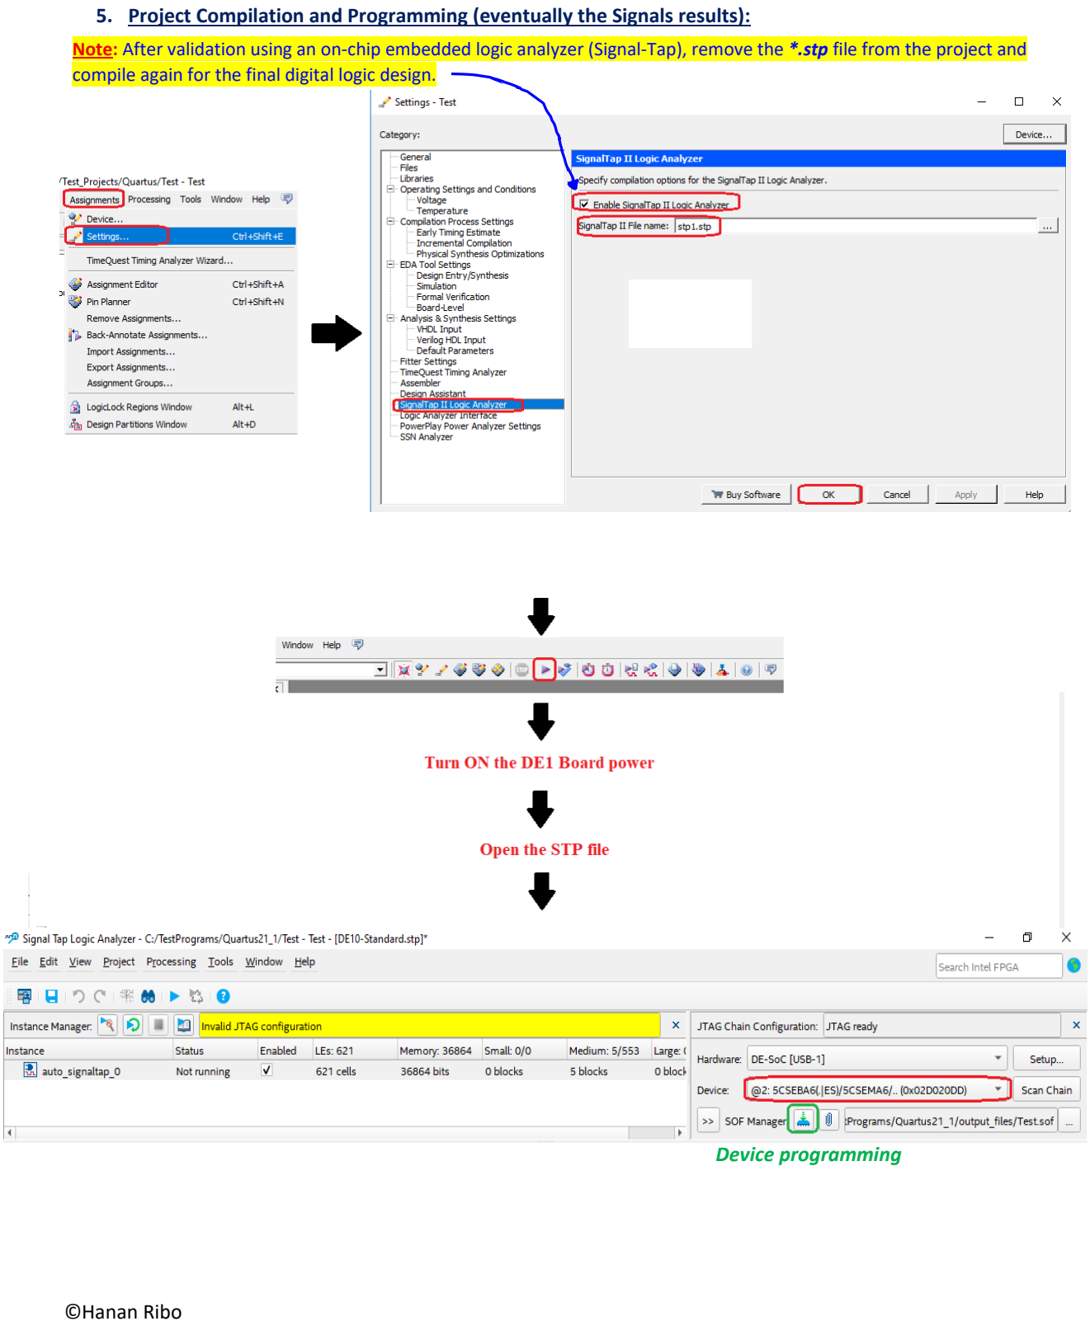
[picture p81: page 26]

### 5. Project Compilation and Programming (eventually the Signals results):

Device programming

Note: After validation using an on-chip embedded logic analyzer (Signal-Tap), remove the *.stp file from the project and compile again for the final digital logic design.

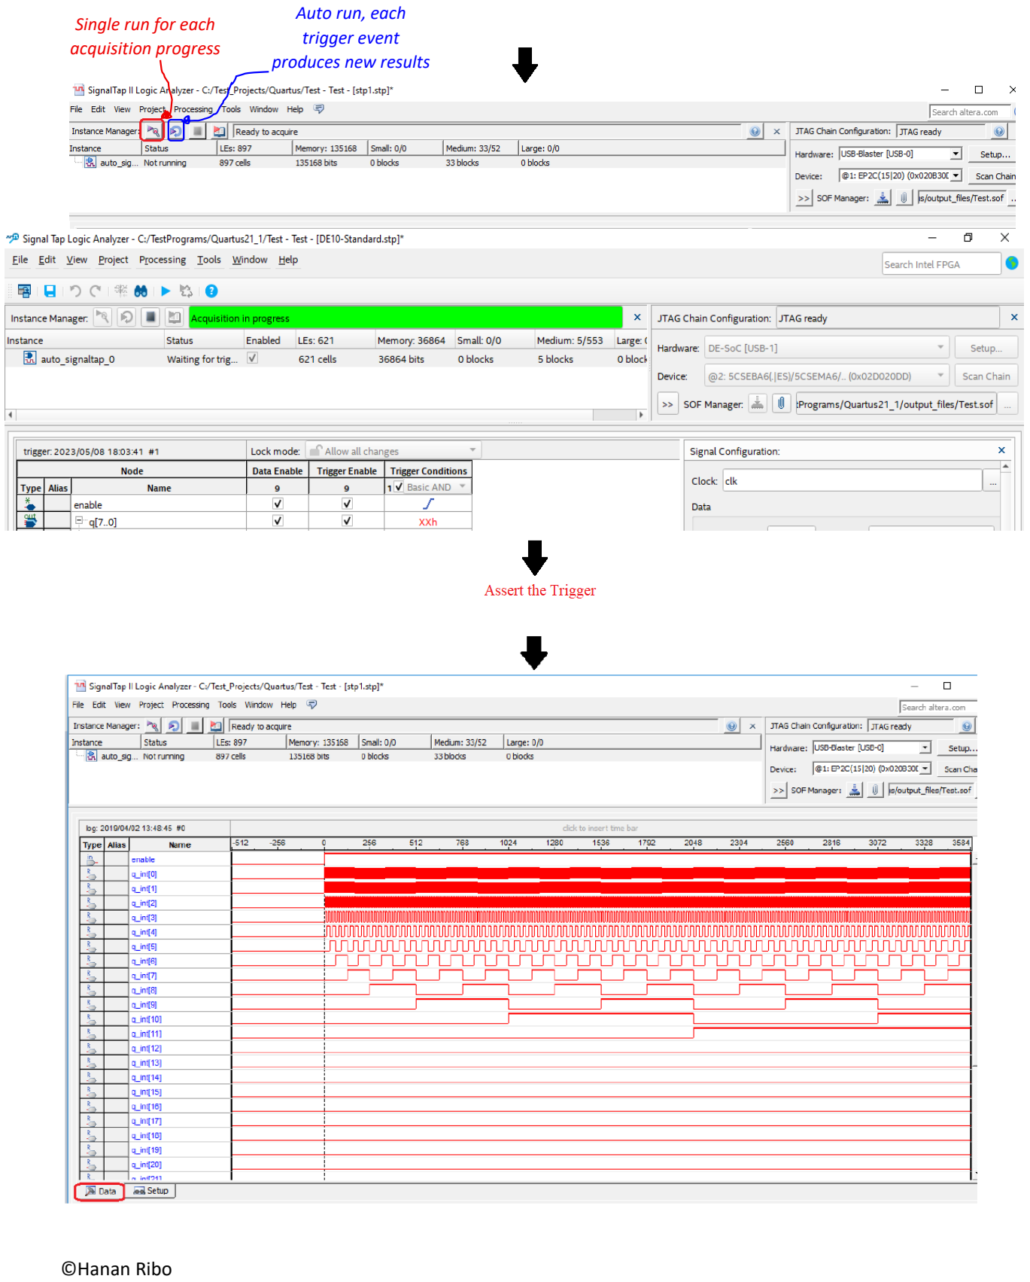
[picture p82: page 27]

Single run for each
acquisition progress

Auto run, each
trigger event
produces new results

### C. Changing the VHDL source files of the project:

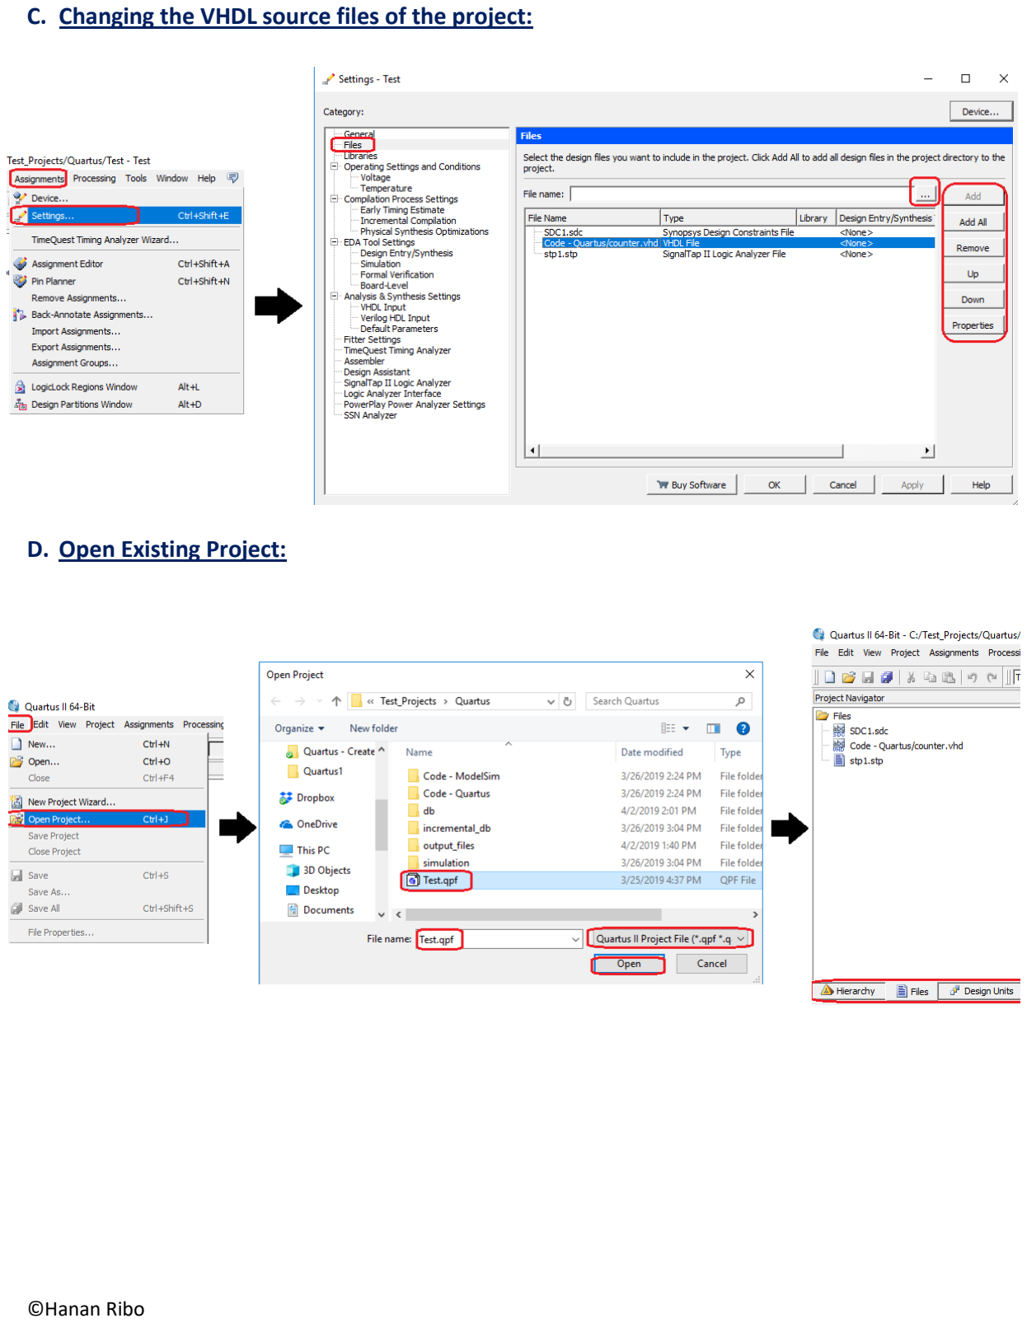
[picture p83: page 28]

### D. Open Existing Project:
