Adar-Shapira/rv32im-mcu-project/Auxiliary/Lab4/Auxiliary/Timing and Power Analysis.pdf

# Counter example

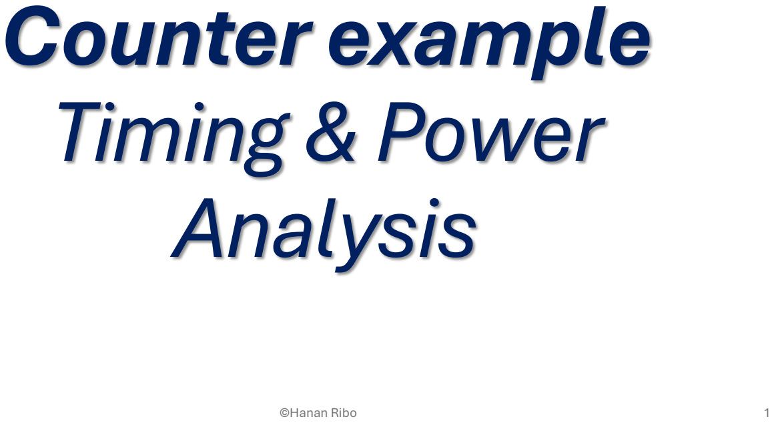
[picture p84: page 1]

©Hanan Ribo | 1

# Timing & Power

# Analysis

# Counter RTL

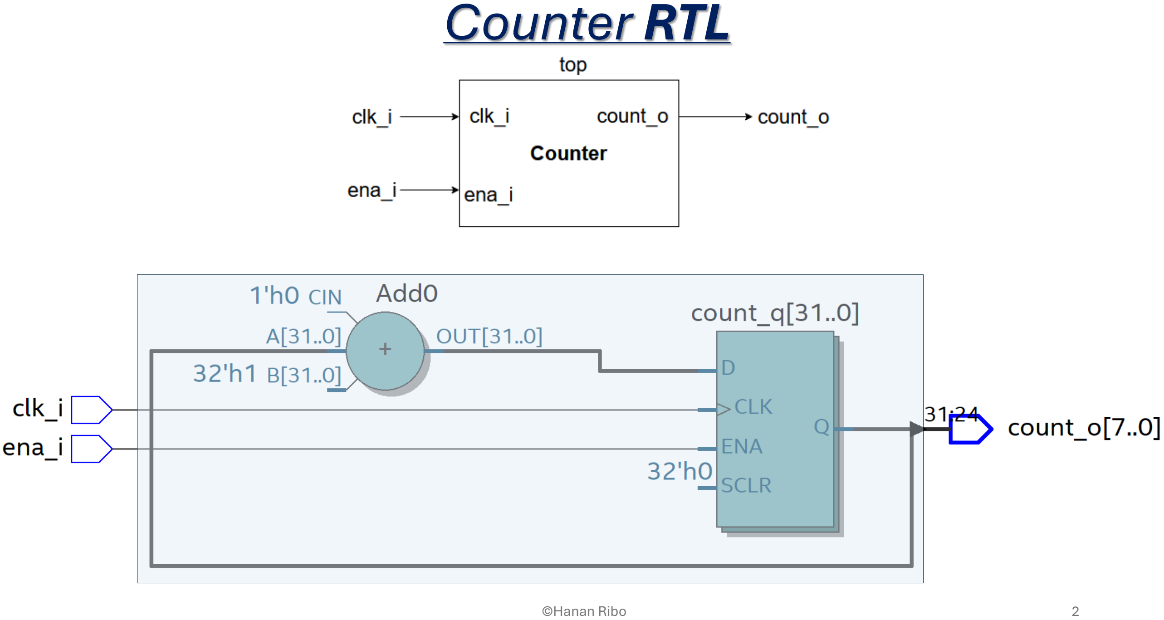
[picture p85: page 2]

# Counter – Area summary

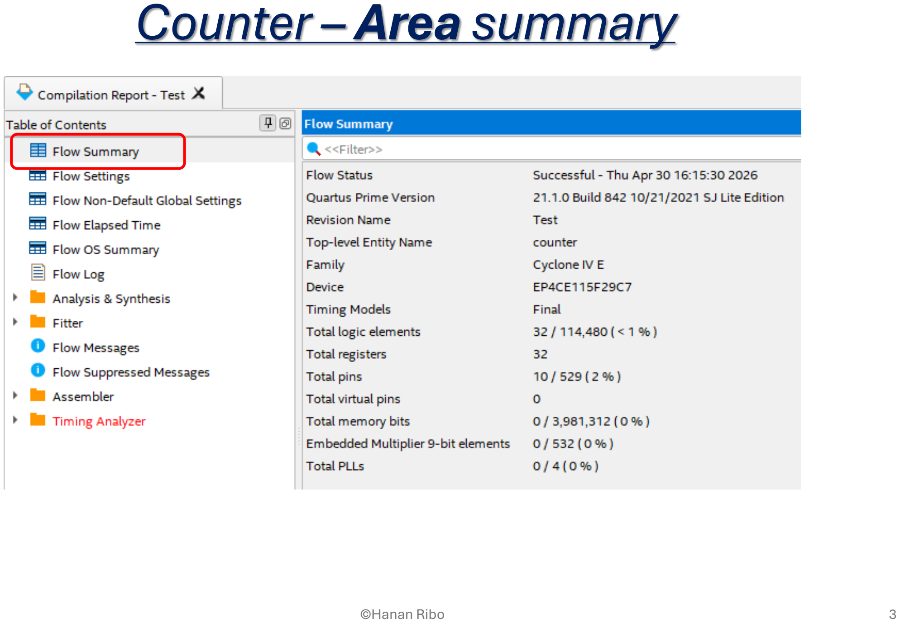
[picture p86: page 3]

# Counter - Setup time

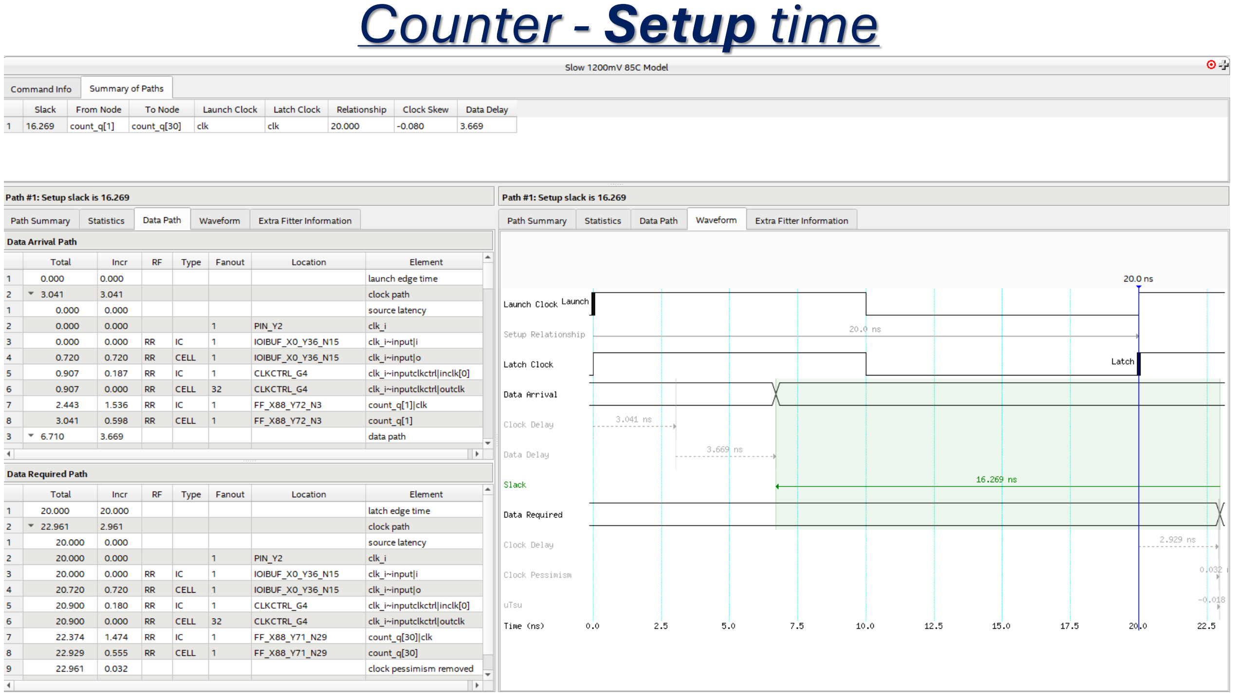
[picture p87: page 4]

# Counter - Setup time paths

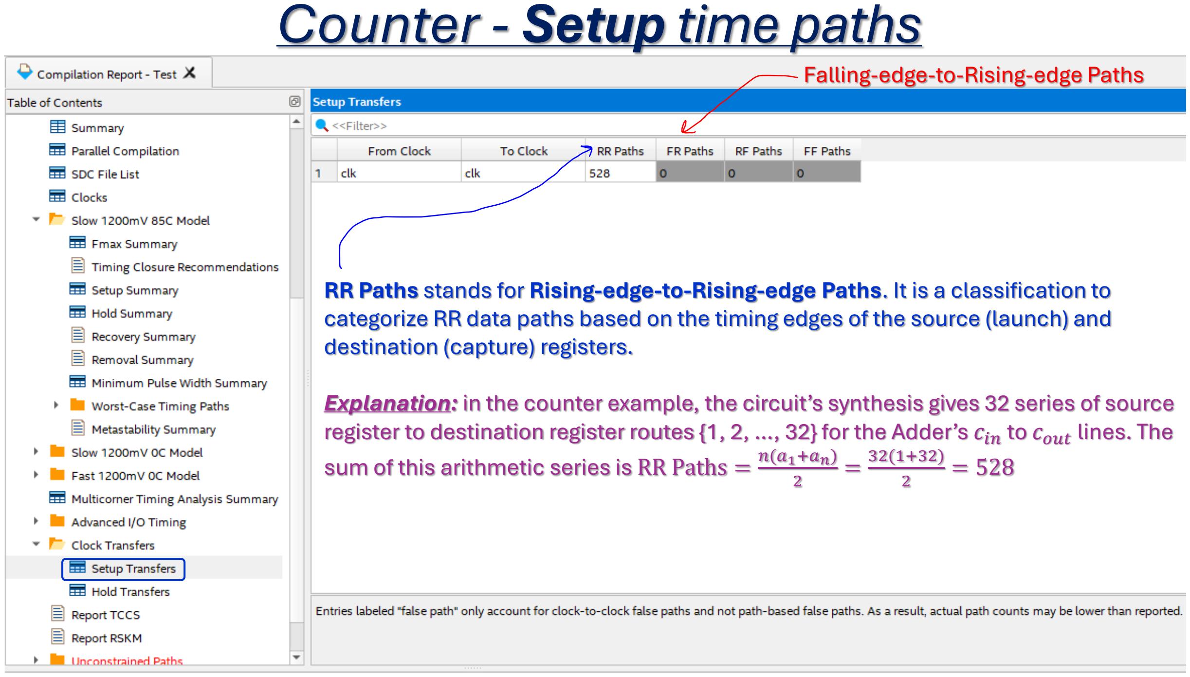
[picture p88: page 5]

RR Paths stands for Rising-edge-to-Rising-edge Paths. It is a classification to categorize RR data paths based on the timing edges of the source (launch) and destination (capture) registers.

Explanation: in the counter example, the circuit’s synthesis gives 32 series of source register to destination register routes {1, 2, …, 32} for the Adder’s cin to cout lines. The sum of this arithmetic series is RR Paths =

n(a1+an)
2

=

32(1+32)
2

= 528

Falling-edge-to-Rising-edge Paths

# Counter - hold time

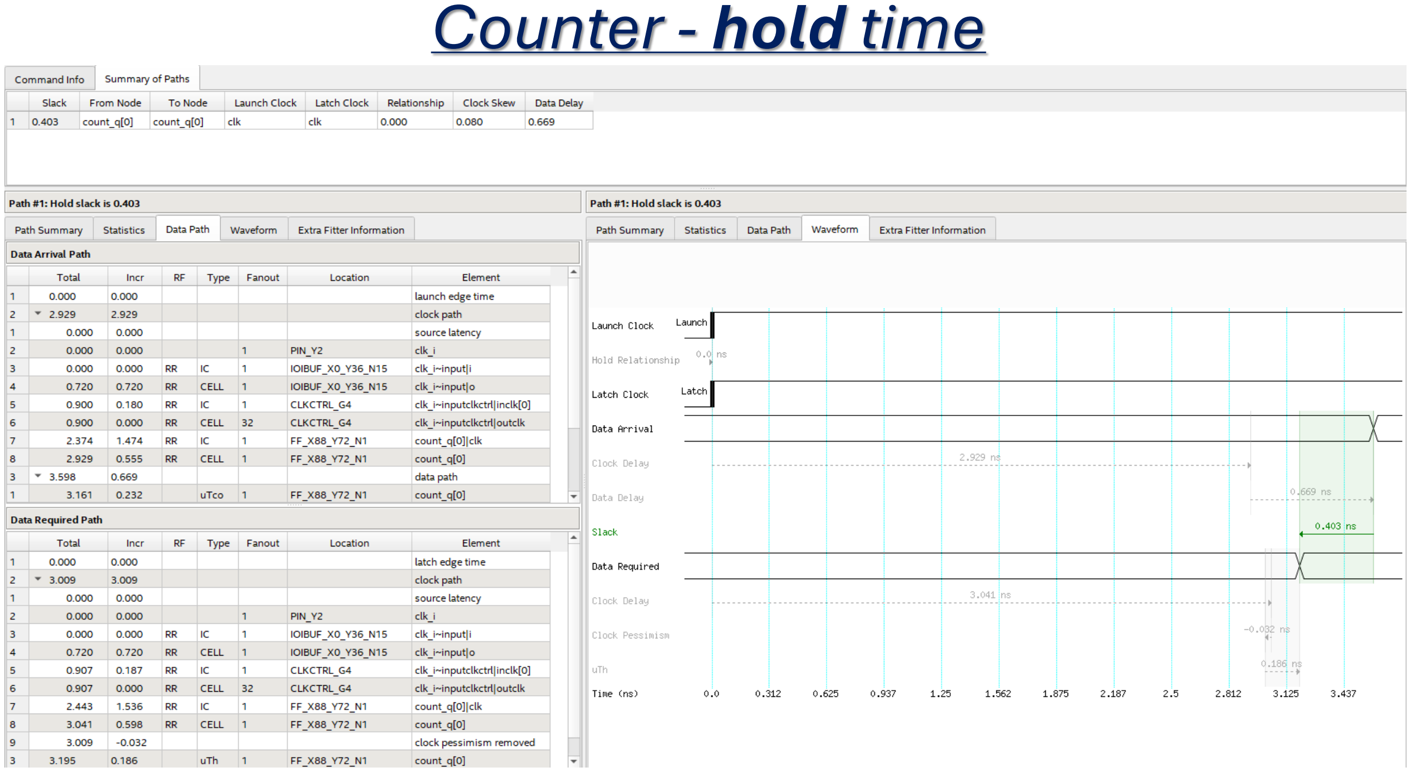
[picture p89: page 6]

# Counter - hold time paths

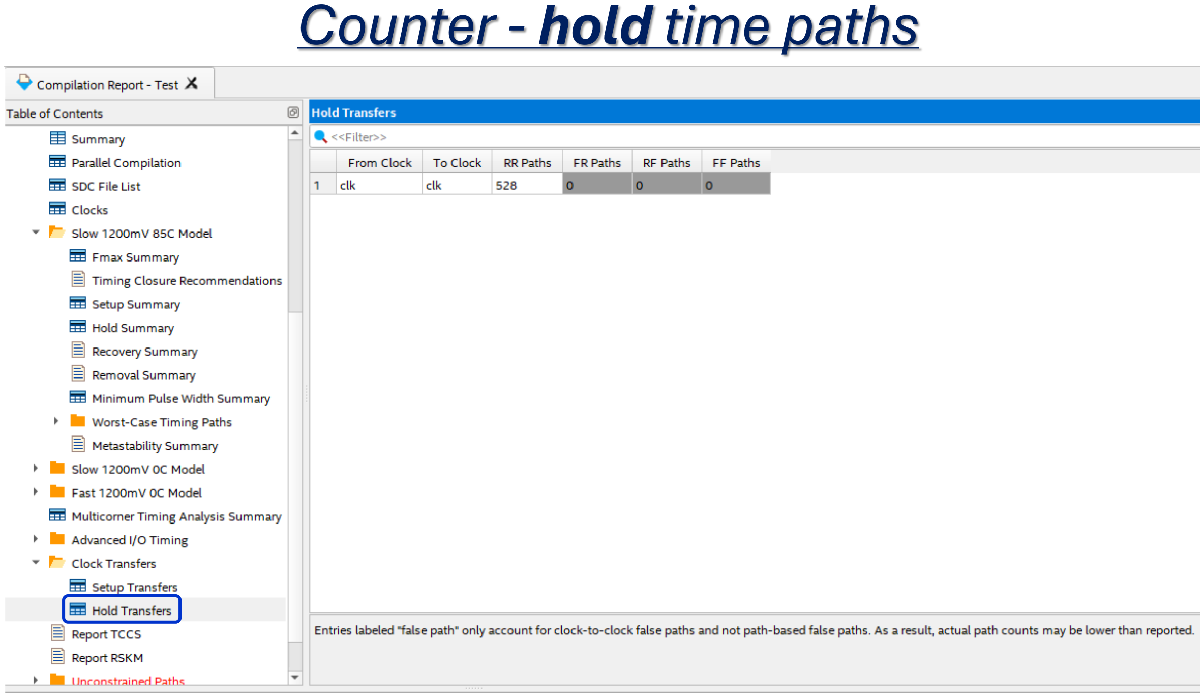
[picture p90: page 7]

# Counter - clocks

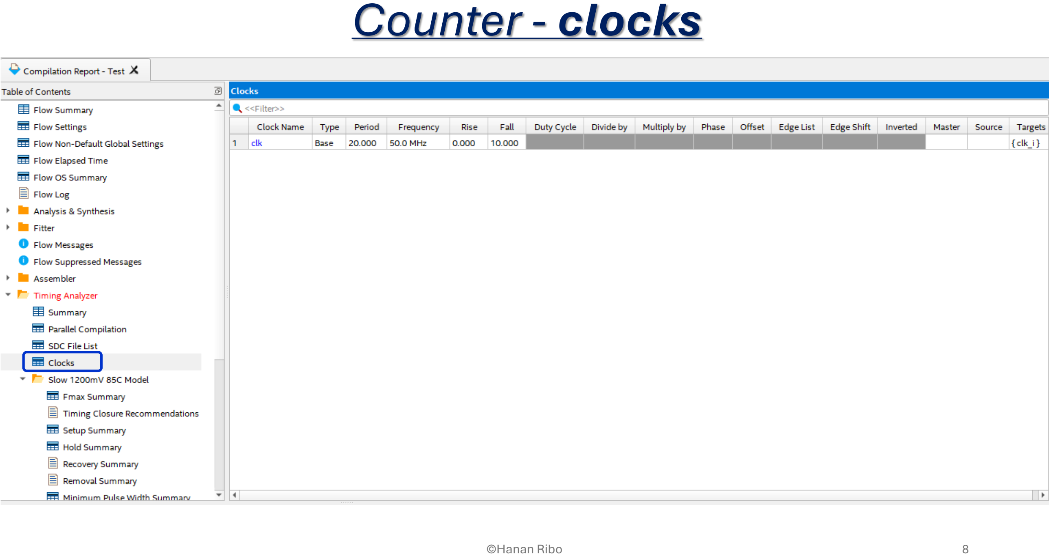
[picture p91: page 8]

# Counter – fmax summary

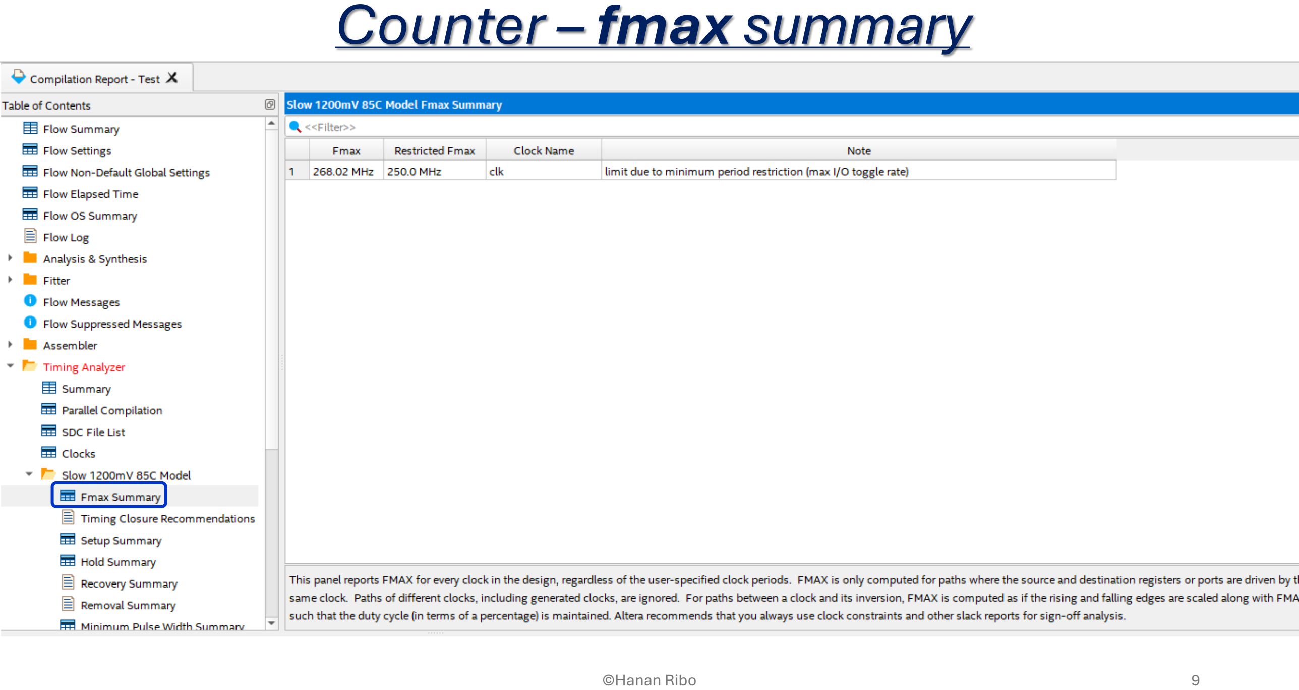
[picture p92: page 9]

# Counter - Power summary

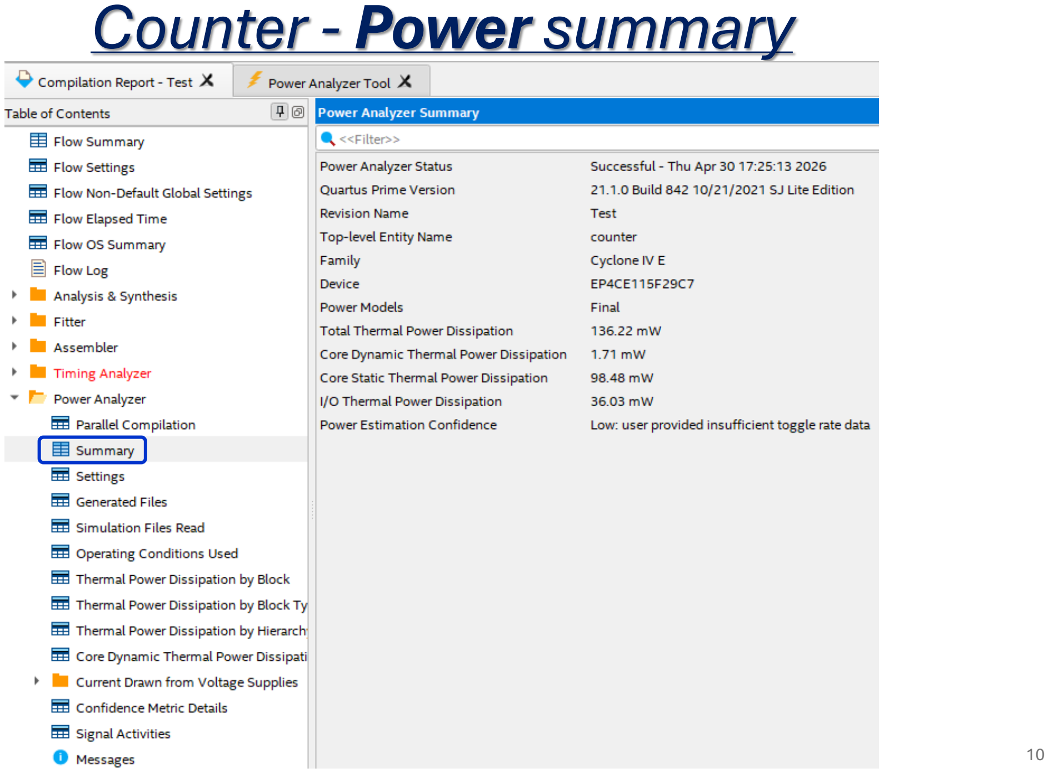
[picture p93: page 10]

# PLL-Counter example

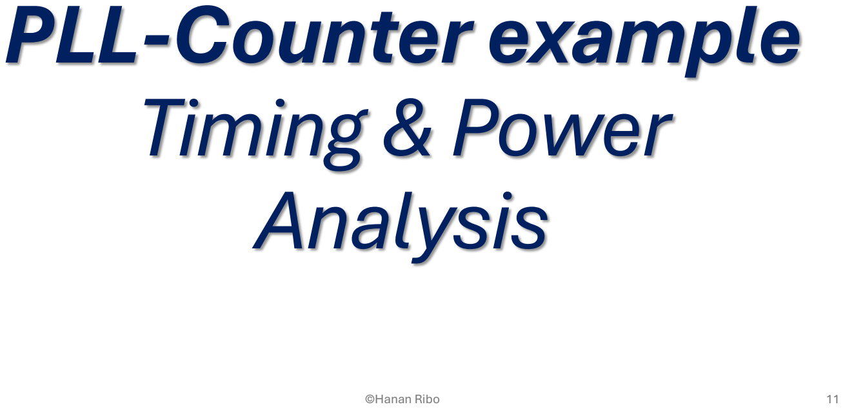
[picture p94: page 11]

# Timing & Power

# Analysis

# Counter_pll RTL

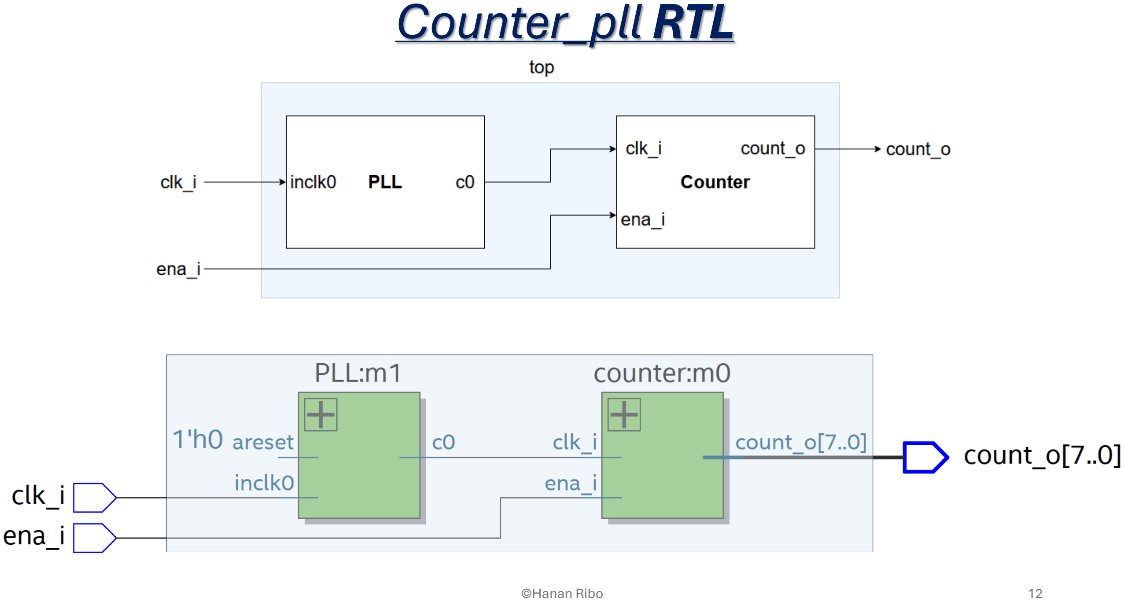
[picture p95: page 12]

# Counter_pll - Area Summary

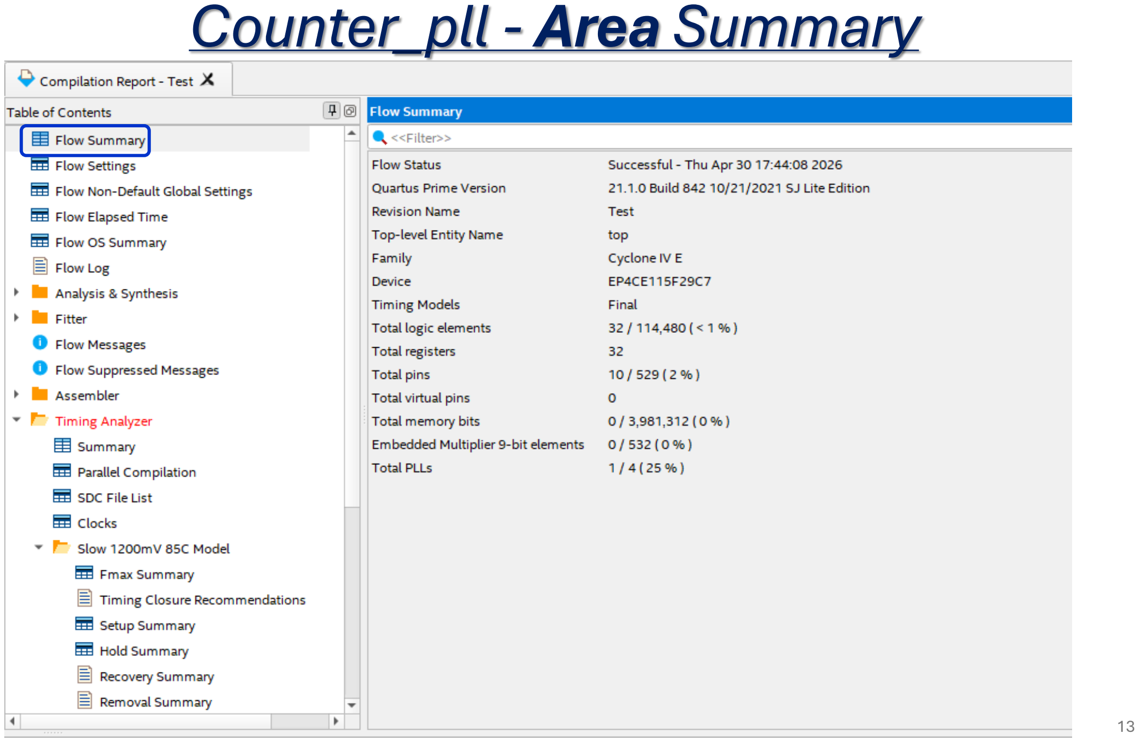
[picture p96: page 13]

# Counter_pll - clocks

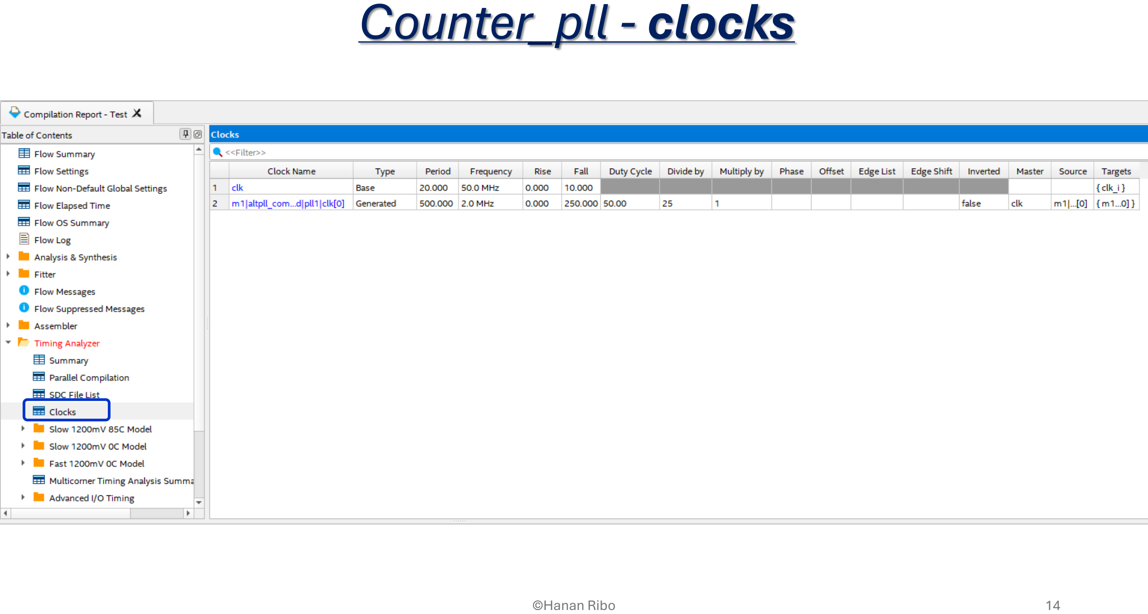
[picture p97: page 14]

# Counter_pll - Setup time

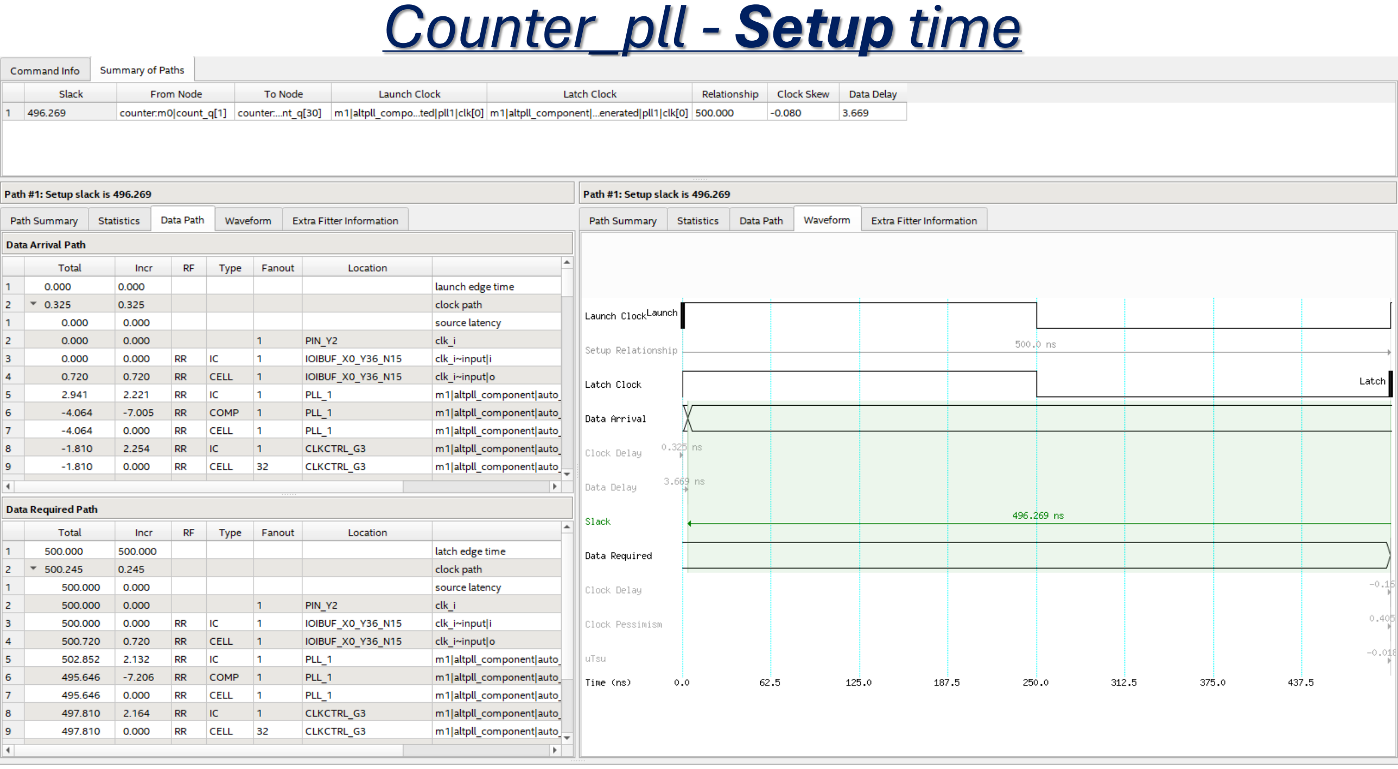
[picture p98: page 15]

# Counter_pll - hold time

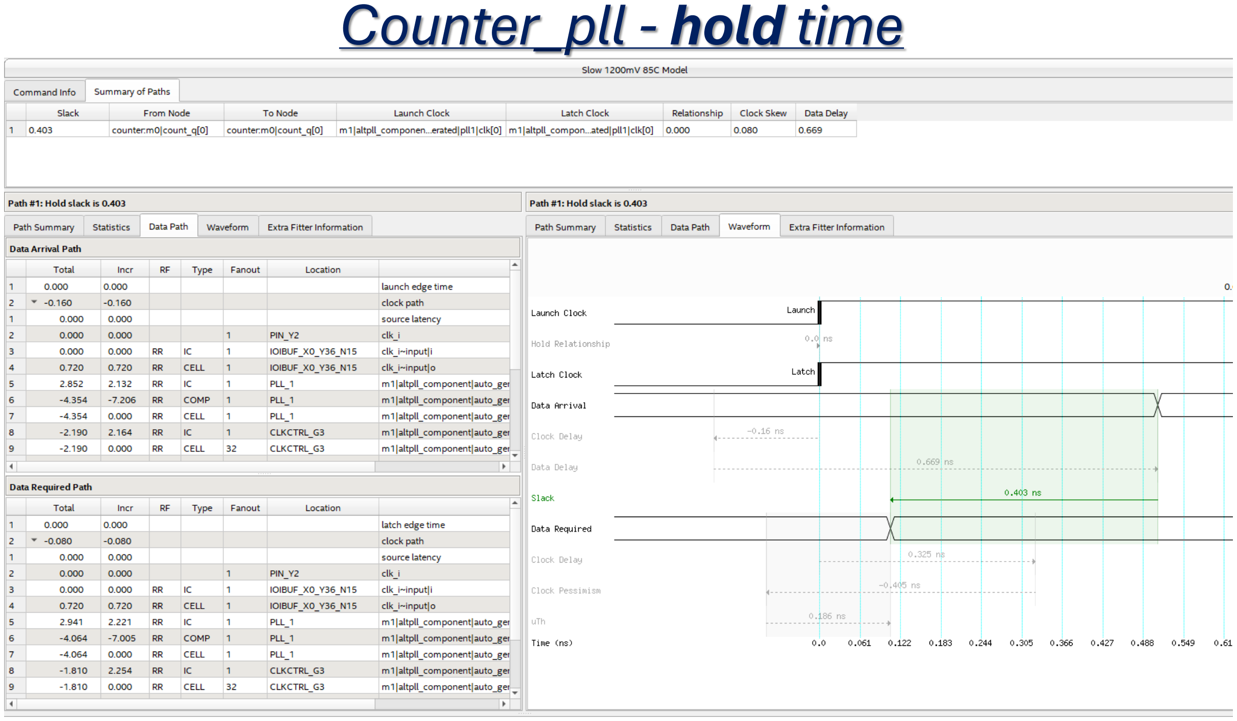
[picture p99: page 16]

# Counter_pll – fmax summary

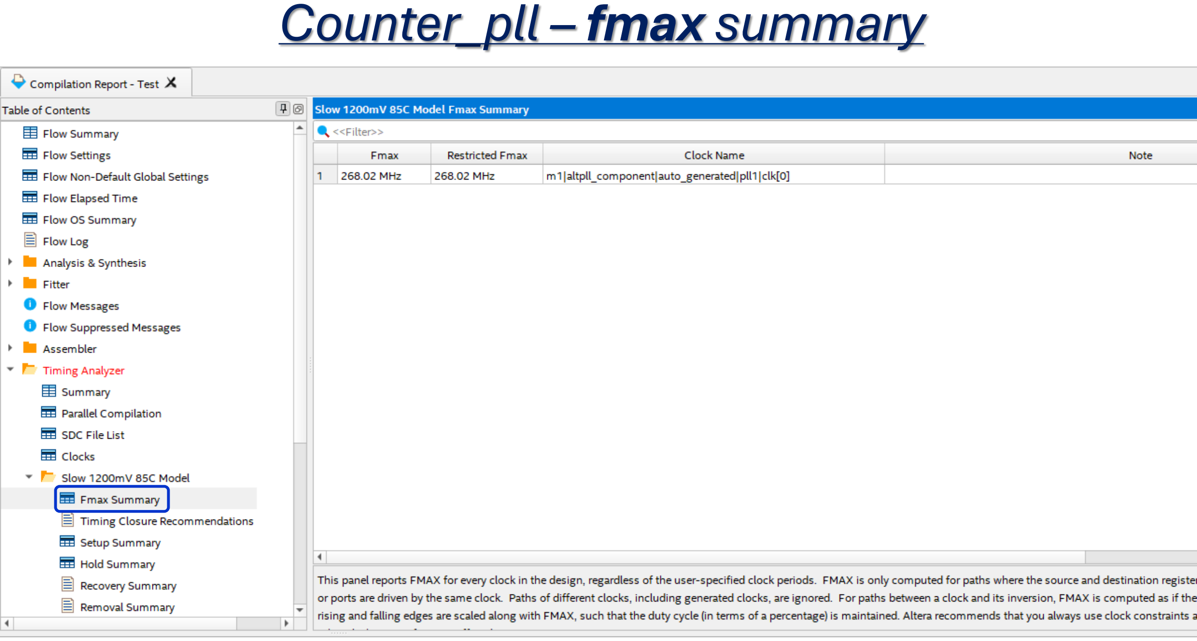
[picture p100: page 17]

# Counter_pll - Power Summary

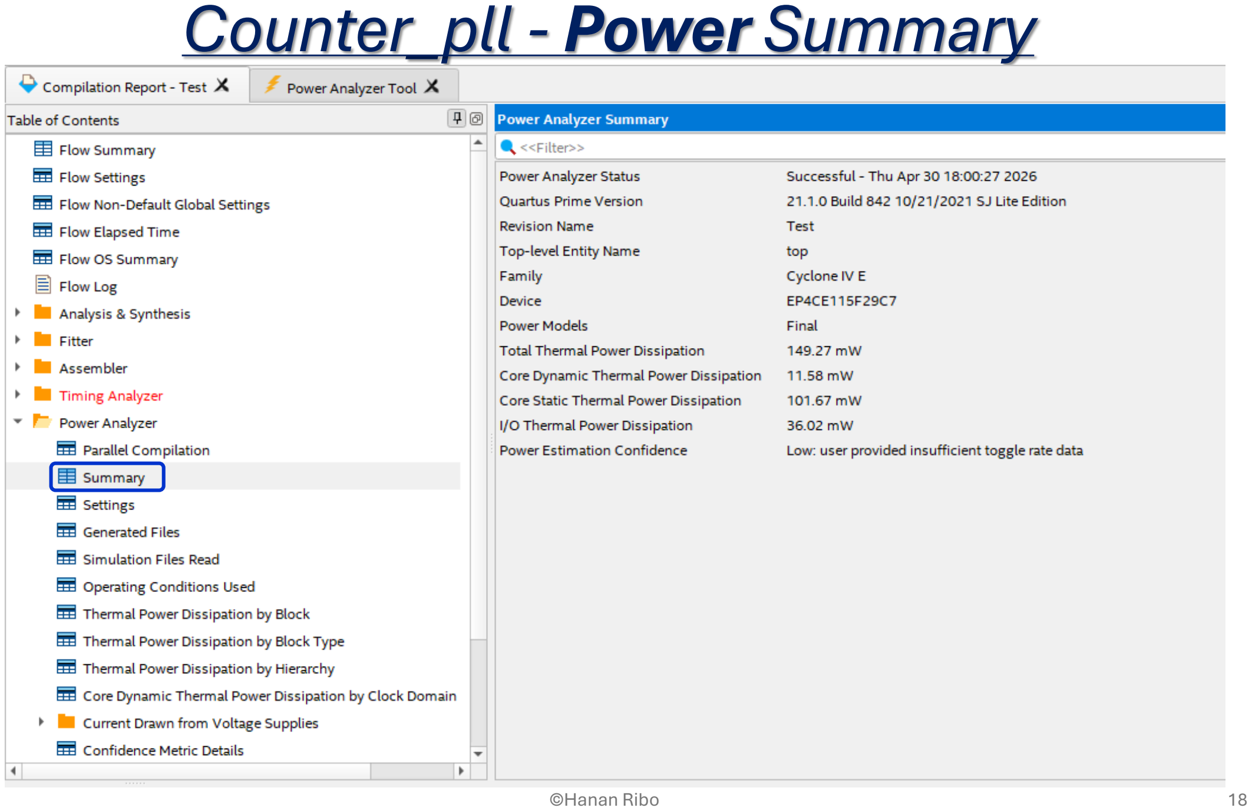
[picture p101: page 18]
