Adar-Shapira/rv32im-mcu-project/Auxiliary/Lab4/DOC/pre4.pdf

# מעבדת ארכיטקטורת מעבדים מתקדמת ומאיצי חומרה

36114693

## דוח מכין מעבדה 4

## אדר שפירא 209580208

## יהונתן דדכה 211468582

## מטרות המעבדה

- הבנה של סינתזת מערכות סיפרתיות ומבנה החומרה הנוצר.
- תכנון ומימוש מעגל דיגיטלי מורכב על גבי חומרת יעד מסוג.FPGA
- ניתוח ואפיון המערכת על פי מדדי ביצועים, ניצול שטח ברכיב וצריכת הספק.

## הגדרת המערכת והארכיטקטורה:

המערכת מורכבת משני חלקים עיקריים אשר פועלים במקביל ובאופן עצמאי:

- חלק צירופי (Subpart Combinatorial (יחידת ALU המבצעת פעולות חשבון, לוגיקה והזזה ברוחב של 8 ביט. פעולת המעגל נקבעת על ידי וקטור הבקרה.ALUFN
- חלק סדרתי (Subpart Synchronous (יחידת PWM המבוססת על טיימר פנימי ברוחב של 16 ביט. יחידה זו מופעלת ומקבלת נתונים רק כאשר אות הבקרה מורה על בחירת מצב.PWM

המערכת השלמה משלבת תכנון היררכי מבני כאשר היחידה העליונה מקשרת בין הרכיבים, מייצרת אוגרי שמירה זמניים עבור המבואות, וממפה את האותות אל הפינים הפיזיים של לוח הפיתוח.

איור 1 מציג את דיאגרמת המבנה הכללי של היחידה העליונה במערכת )Entity Top System). הדיאגרמה מפרטת את וקטורי הקלט Y ו X ברוחב 16 ביט, את קלטי השעון והאיפוס, ואת המוצאים הכוללים את דגלי המצב ואות ה PWM.

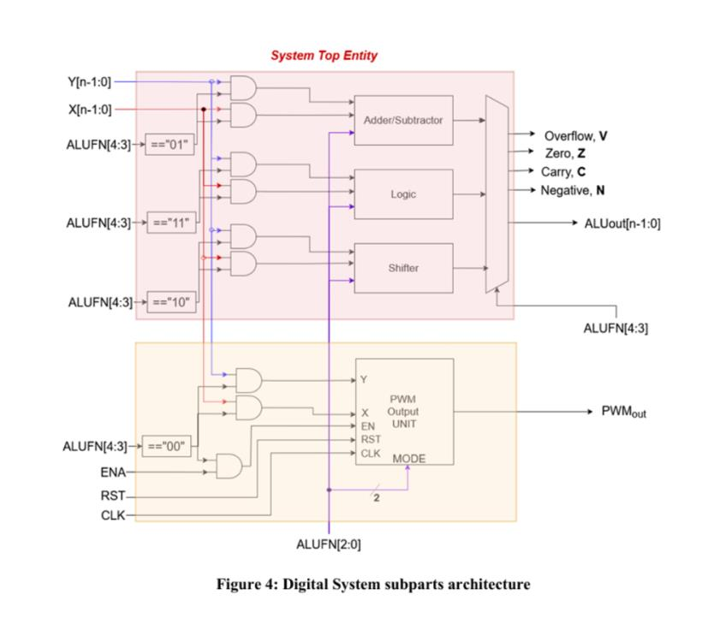
[picture p102: figure]

## מבנה חומרה ומבט לוגי

איור 2 מציג את החלוקה הפנימית של המעגל לשני תת חלקים נפרדים: המערכת הצירופית
(Synchronous Digital Circuit). | הסדרתית | והמערכת | ) Combinatorial Digital Circuit)

הנתונים מנותבים במקביל לשני הבלוקים, ואות הבקרה ALUFN מנתב את המוצא הסופי ומפעיל את יחידת ה PWM רק במצבים שבהם הסיביות הגבוהות שוות ל .00

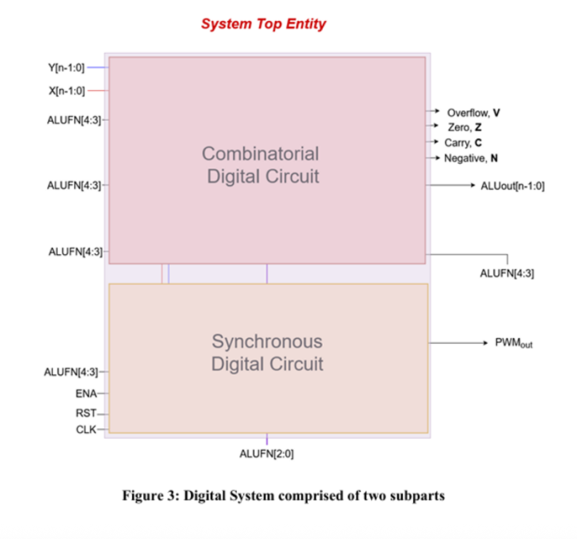
[picture p103: figure]

## מבנה יחידת ה PWM והטיימר הסינכרוני

איור 3 מציג את הארכיטקטורה הפנימית של יחידת ה PWM והטיימר ברוחב 16 ביט. המעגל מכיל בלוק ליבה -Core Timer bit 16 המבצע ספירה מחזורית עד להגעה לערך השמור באוגר.Y

התוצאה מושווה לערך השמור באוגר X על מנת לקבוע את זמני המיתוג והפקת האות PWMout בשלושת מצבי העבודה השונים המוגדרים במערכת: Set/Reset ,Reset/Set ו-Toggle.

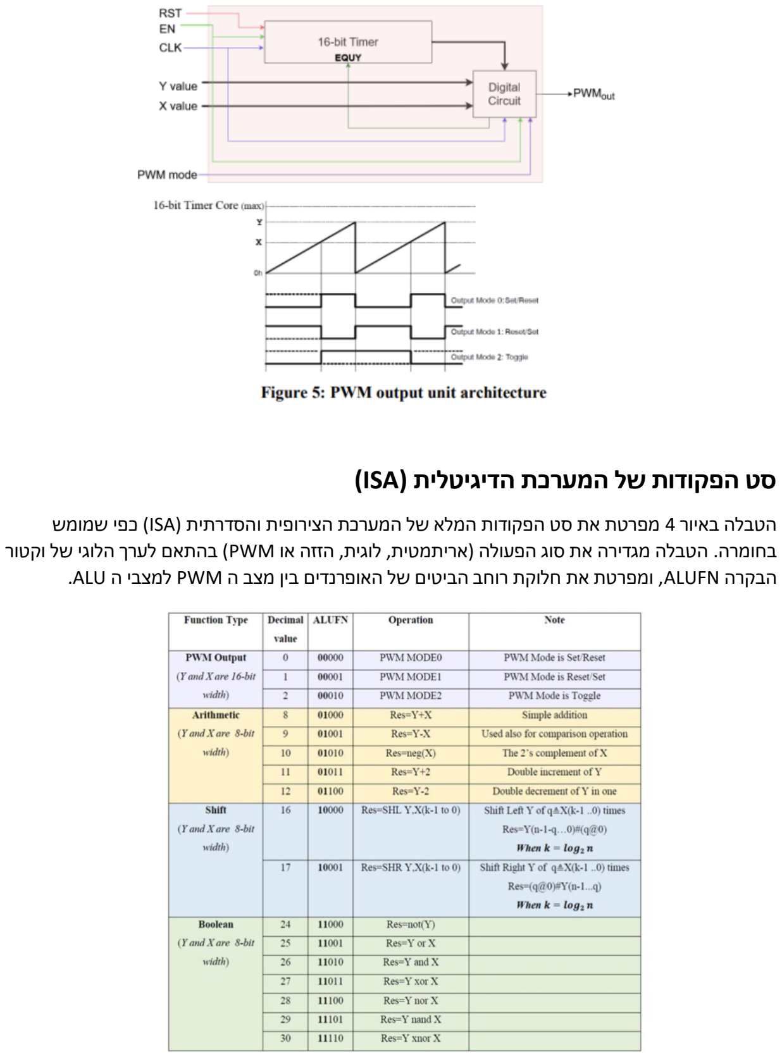
[picture p104: page 4]

## סט הפקודות של המערכת הדיגיטלית )ISA )

הטבלה באיור 4 מפרטת את סט הפקודות המלא של המערכת הצירופית והסדרתית (ISA (כפי שמומש בחומרה. הטבלה מגדירה את סוג הפעולה )אריתמטית, לוגית, הזזה או PWM )בהתאם לערך הלוגי של וקטור הבקרה ALUFN, ומפרטת את חלוקת רוחב הביטים של האופרנדים בין מצב ה PWM למצבי ה ALU.

ארכיטקטורת רמת ה-Top בחומרה:

באיור 5 מוצג מבנה רמת ה-Top המלא של מערכת החומרה כפי שסונתז ב-Quartus. המבנה מציג את החיבורים הפיזיים של הבורד, כולל רכיבי ה-PLL להורדת התדר, מפענחי שבעת המקטעים )-7Segments ) להצגת הנתונים, ואוגרי השמירה בכניסות המבוקרים על ידי רשת הדחפנים.

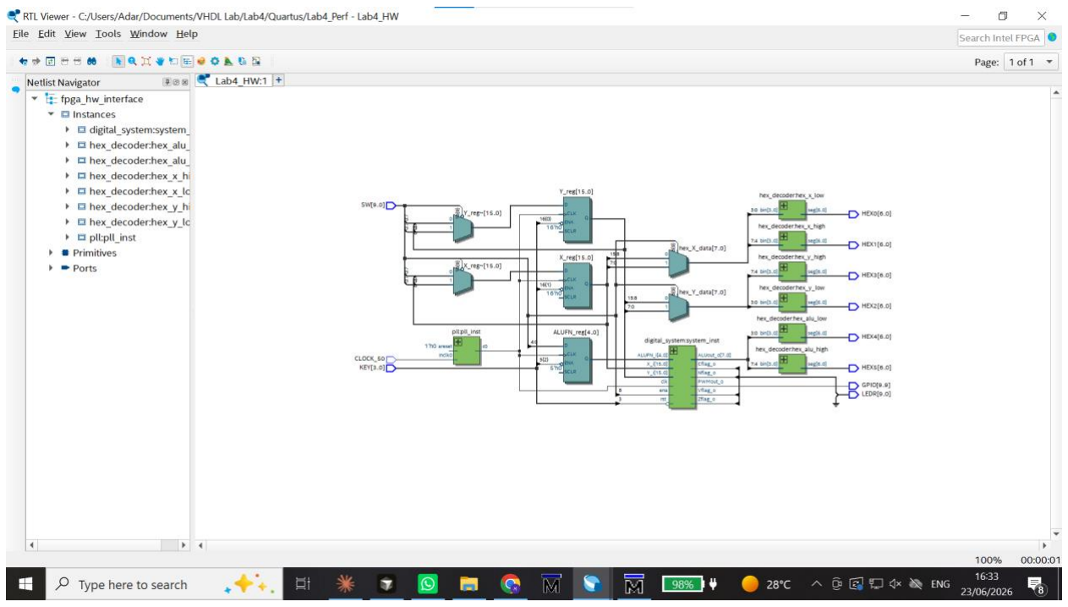
[picture p105: figure]

מבנה יחידת ה-ALU המרכזית:

איור 6 מציג את ה-Viewer RTL של יחידת ה-ALU הצירופית. ניתן לראות כיצד נתוני הכניסה מנותבים במקביל לשלושת תתי-הבלוקים )האריתמטי, הלוגי והמזיז(, כאשר מרבב סופי המבוקר על ידי האות ALUFN קובע את התוצאה המוזרמת למוצא ואת דגלי הסטטוס הנוצרים.

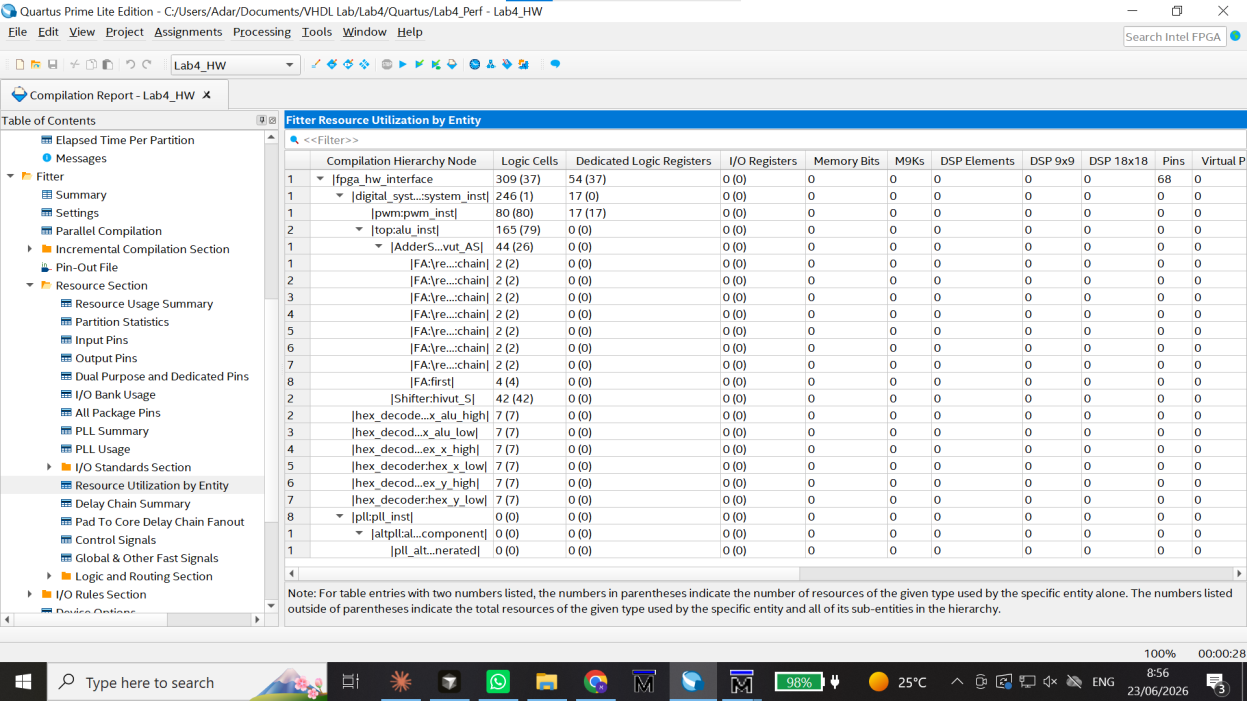
[picture p106: figure]

המבנה הפנימי של היחידה האריתמטית:

איור 7 מציג את הפירוק הלוגי הפנימי של היחידה האריתמטית ב-ALU. הבלוק מבוסס על רכיב חיבור/חיסור )Subtractor/Adder )ייעודי, ולצידו מערך שערים לוגיים המבצעים הכנת קלט )כמו היפוך ביטים לצורך פעולת משלים ל2- בחיסור( וחישוב ישיר של דגלי הסטטוס.

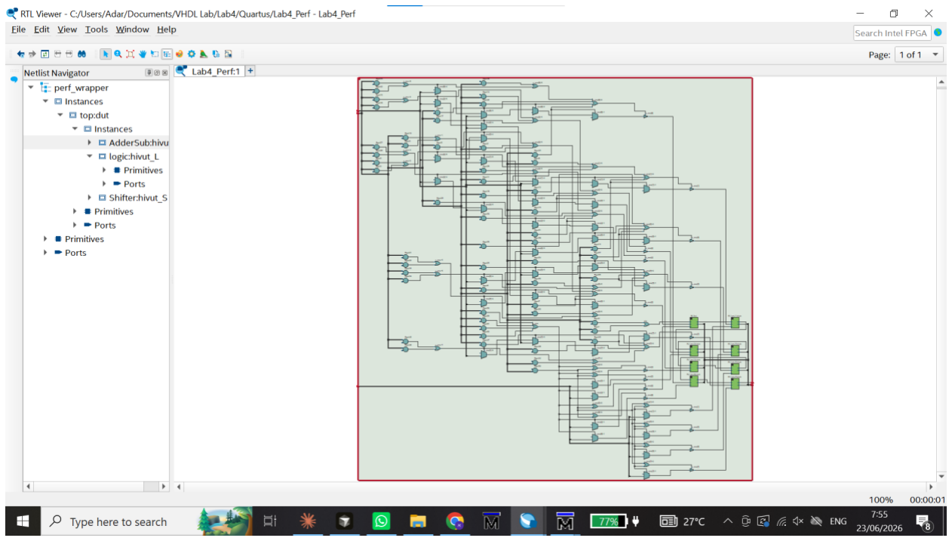
[picture p107: figure]

המבנה הפנימי של היחידה הלוגית:

איור 8 מציג את מבנה ה-RTL של היחידה הלוגית ב-ALU. היחידה מורכבת ממבנה מקבילי ושטוח המבצע את כל הפונקציות הלוגיות הנדרשות )כגון XOR ,OR ,AND )על פני כל 8 הסיביות בו-זמנית, כאשר מרבב פנימי

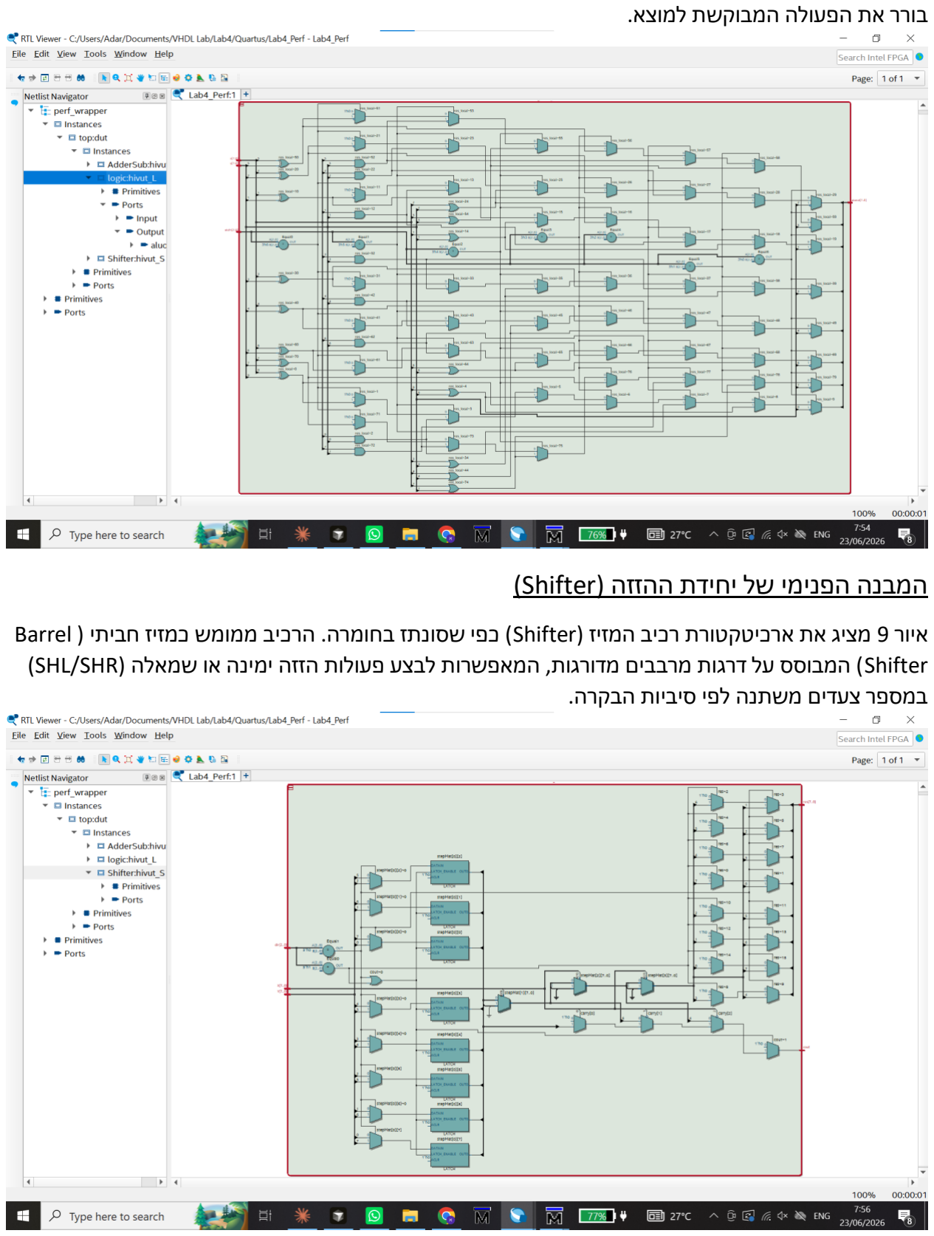
[picture p108: page 8]

בורר את הפעולה המבוקשת למוצא.

המבנה הפנימי של יחידת ההזזה )Shifter )

איור 9 מציג את ארכיטקטורת רכיב המזיז )Shifter )כפי שסונתז בחומרה. הרכיב ממומש כמזיז חביתי ) Barrel Shifter )המבוסס על דרגות מרבבים מדורגות, המאפשרות לבצע פעולות הזזה ימינה או שמאלה )SHR/SHL ) במספר צעדים משתנה לפי סיביות הבקרה.

מבנה יחידת הבדיקה )Case Test Performance):

איור 10 מציג את ארכיטקטורת בדיקת הביצועים של ה-ALU הצירופי. על מנת לאפשר ל-Analyzer Timing למדוד תדר מקסימלי ומסלול קריטי, המערכת כלאה את יחידת ה-ALU בין שני רגיסטרים סינכרוניים ) -DFF based )המוזנים מאותו שעון מערכת.

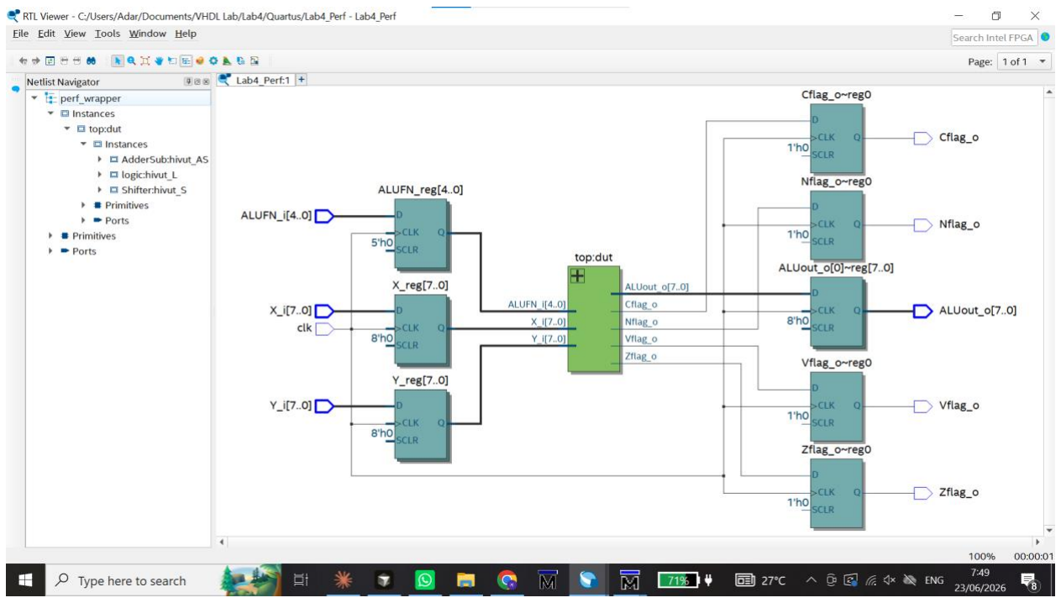
[picture p109: figure]

סיכום משאבי שטח וניצול הרכיב )Area):

באיור 11 מוצג סיכום הקומפילציה הכללי של המערכת. ניתן לראות כי המערכת כולה משתמשת ב79- יחידות ALMs, מפעילה 99 רגיסטרים, ומנצלת 42 פינים פיזיים של קלט ופלט, ללא שימוש בבלוקי זיכרון פנימיים או

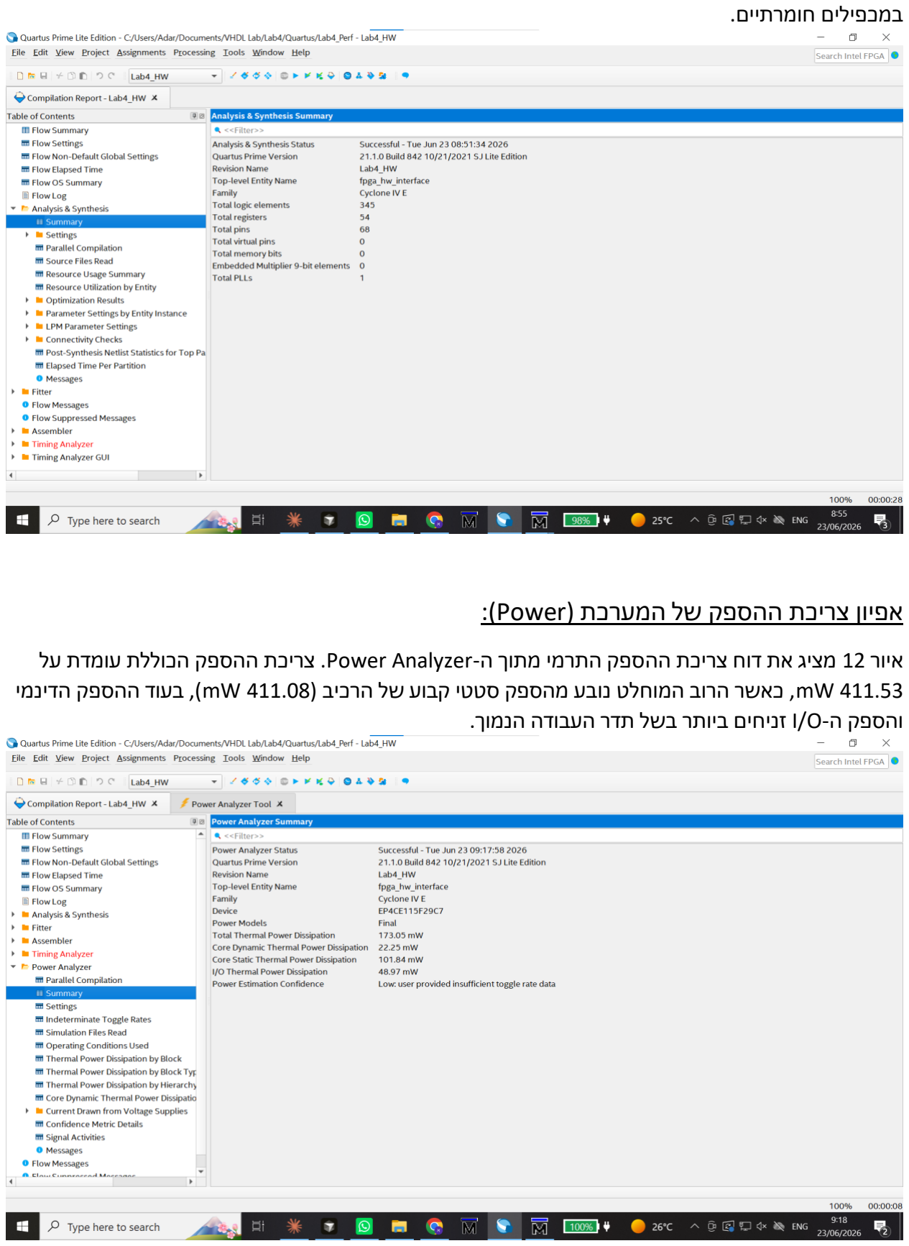
[picture p110: page 10]

במכפילים חומרתיים.

אפיון צריכת ההספק של המערכת )Power):

איור 12 מציג את דוח צריכת ההספק התרמי מתוך ה-Analyzer Power. צריכת ההספק הכוללת עומדת על 411.53 mW, כאשר הרוב המוחלט נובע מהספק סטטי קבוע של הרכיב )411.08 mW), בעוד ההספק הדינמי והספק ה-O/I זניחים ביותר בשל תדר העבודה הנמוך.

תדר עבודה מקסימלי בבדיקת הביצועים )Performance):

איור 13 מציג את תדר העבודה המקסימלי )max_f )של יחידת ה-ALU הצירופית תחת תנאי הטמפרטורה והמתח הגרועים ביותר )Model Slow). התדר המקסימלי שהתקבל עומד על 113.88 MHz, המקבילים למחזור שעון מינימלי של 8.781 ns.

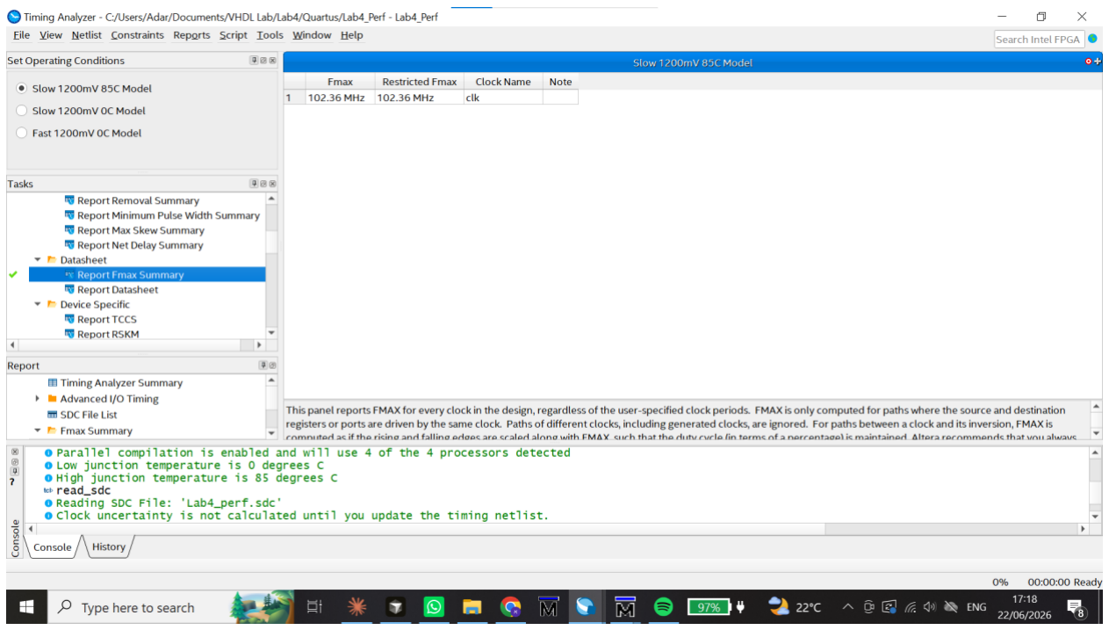
[picture p111: figure]

ניתוח המסלול הקריטי )Path Critical):

איור 14 מציג את המסלול הקריטי הארוך ביותר במערכת מתוך ה-Analyzer Timing. המסלול עובר דרך היחידה האריתמטית, והסיבה לעיכוב היא שרשרת התקדמות הנשא )Chain Carry )ברכיב המחבר/מחסר, הדורשת מעבר דרך דרגות לוגיות רבות עד לחישוב התוצאה והדגלים.

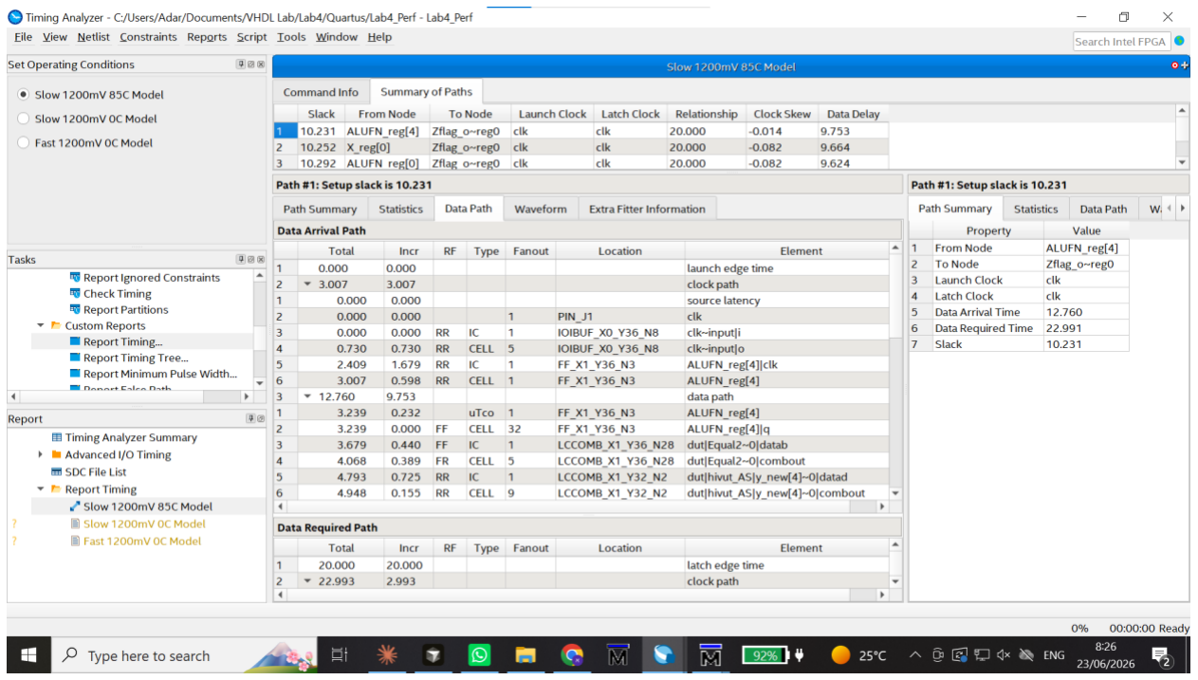
[picture p112: figure]

ניתוח המסלול הקצר ביותר )Path Shortest):

איור 15 מציג את המסלול המהיר והקצר ביותר במערכת. מסלול זה ממוקם ביחידה הלוגית עבור פעולת NOT, מכיוון שהיא מבוצעת ברמת שער לוגי בודד לכל סיבית באופן עצמאי לחלוטין וללא תלות הדדית, דבר המניב את עיכוב הנתונים המינימלי ביותר.

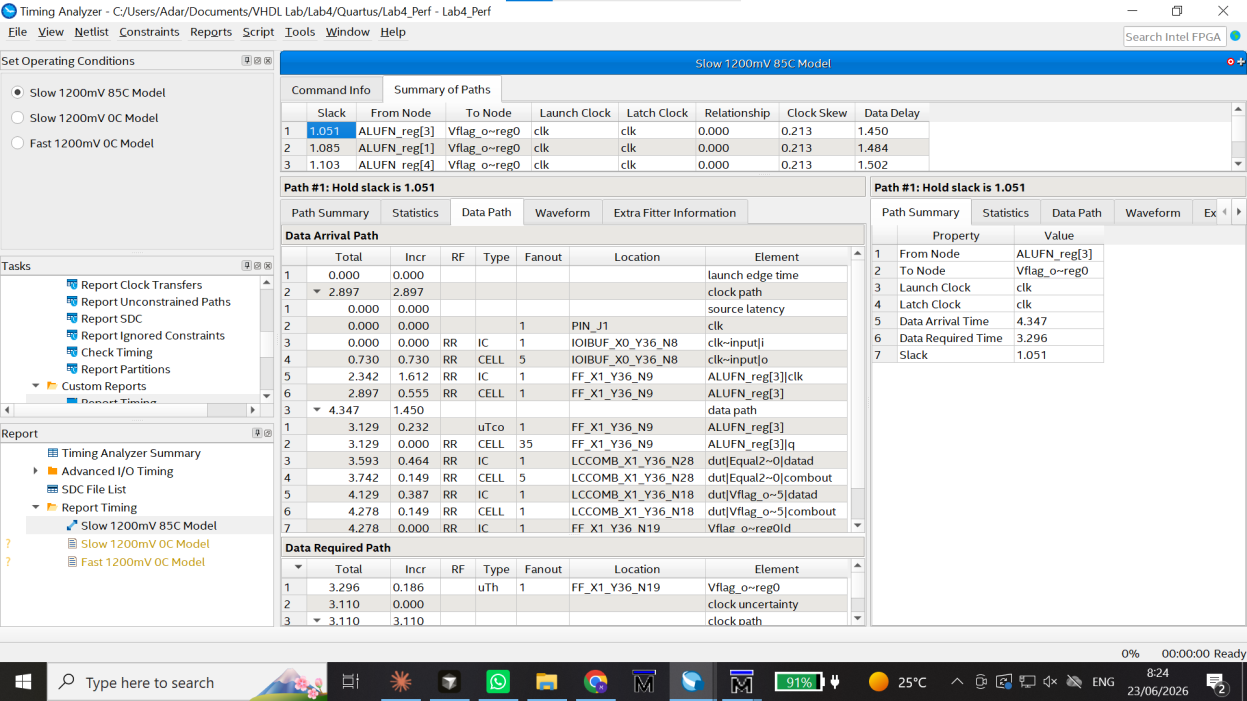
[picture p113: figure]

סימולציית אות מוצא ה-PWM ב-ModelSim:

איור 16 מציג את גלי הסימולציה עבור יחידת ה-PWM במצב עבודה Reset/Set (0 Mode). ניתן לראות כי אות המוצא PWMout משנה את מצבו הלוגי במדויק בנקודות השוויון שבהן מונה הטיימר בן -16הביט מגיע לערכי

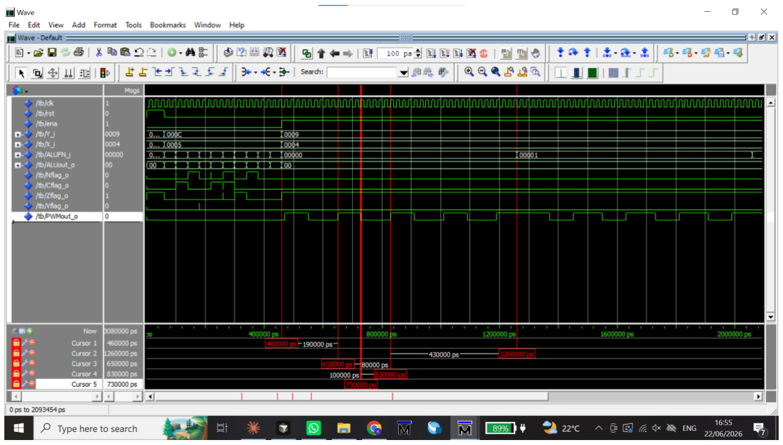
[picture p114: figure]

האוגרים X ו-Y.

אימות פקודה אריתמטית ב-Tap-Signal:

איור 17 מציג אימות חומרה בזמן אמת עבור פקודת החיבור האריתמטית )X + Y = Res). הטריגר הוגדר על הדחפן 2KEY, וניתן לראות כי עבור הקלטים 040x ו020-x מתקבלת במוצא התוצאה המדויקת 060x, כאשר כל דגלי הסטטוס נשארים באפס לוגי.

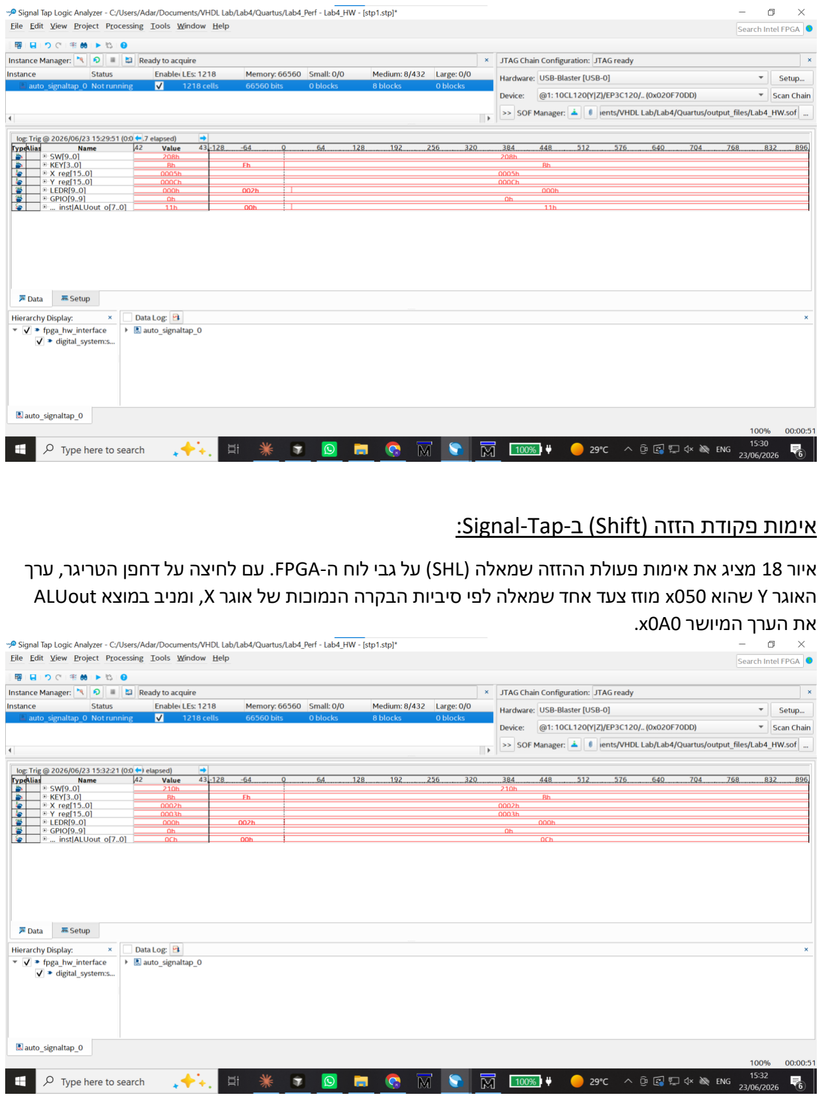
[picture p115: page 15]

אימות פקודת הזזה )Shift )ב-Tap-Signal:

איור 18 מציג את אימות פעולת ההזזה שמאלה )SHL )על גבי לוח ה-FPGA. עם לחיצה על דחפן הטריגר, ערך האוגר Y שהוא 050x מוזז צעד אחד שמאלה לפי סיביות הבקרה הנמוכות של אוגר X, ומניב במוצא ALUout את הערך המיושר 0A0x.

אימות פקודה לוגית )Boolean )ב-Tap-Signal:

איור 19 מציג את אימות הפעולה הלוגית XOR בחומרה. מהדגימה עולה כי ביצוע פעולת הקשר הלוגי ביט-אחר-ביט בין ערך האוגר Y( שתוכנו 050x )לבין ערך האוגר X( שתוכנו 010x )מייצר במדויק במוצא המערכת את הערך הלוגי 040x.

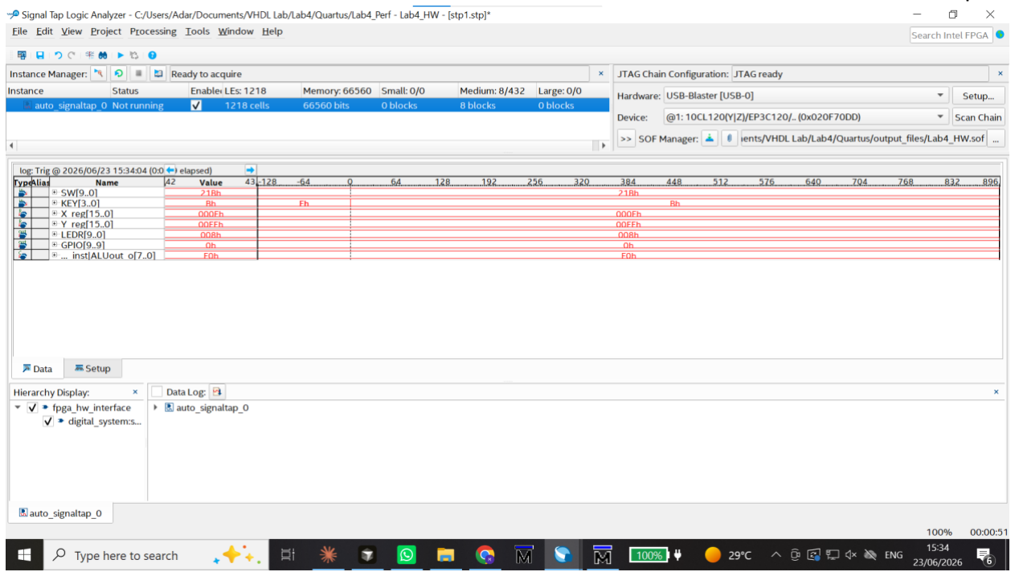
[picture p116: figure]

אימות אות ה-PWM במצב 1 Mode בחומרה:

איור 20 מציג את דגימת אות המוצא של ה-PWM בחומרה תחת מצב עבודה Set/Reset (1 Mode). האות נדגם ישירות מפין המוצא המשורשר לסיכה הפיזית 9]GPIO], ומציג התנהגות הפוכה )אינוורסיה( של מחזור הדיוטי ביחס למצב העבודה הבסיסי.

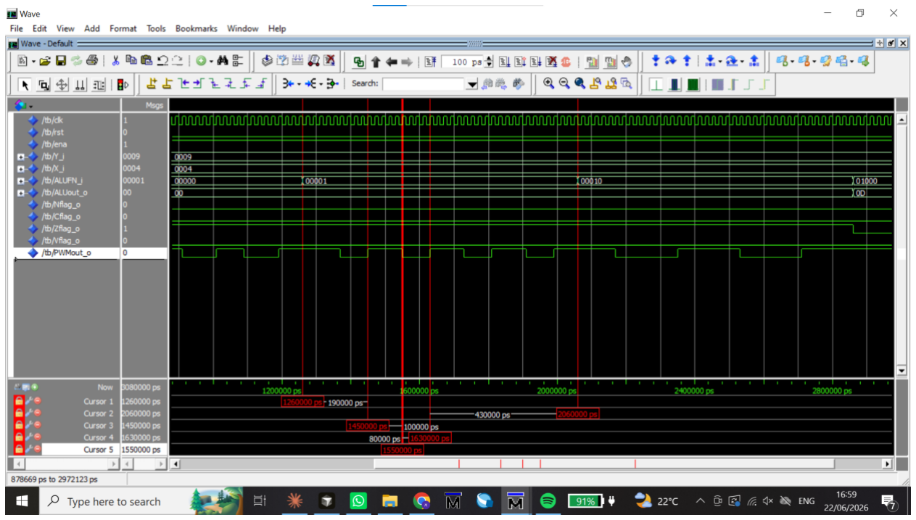
[picture p117: figure]

אימות אות ה-PWM במצב 2 Mode בחומרה:

איור 21 מציג את אות ה-PWM בחומרה תחת מצב עבודה Toggle (2 Mode). בדגימה זו ניתן לראות כי אות המוצא משנה את מצבו הלוגי )מ- '0' ל -'1' ולהיפך( בכל נקודת שוויון של הטיימר, דבר המבצע חלוקת תדר

אופיינית ושומר על גל ריבועי סימטרי.

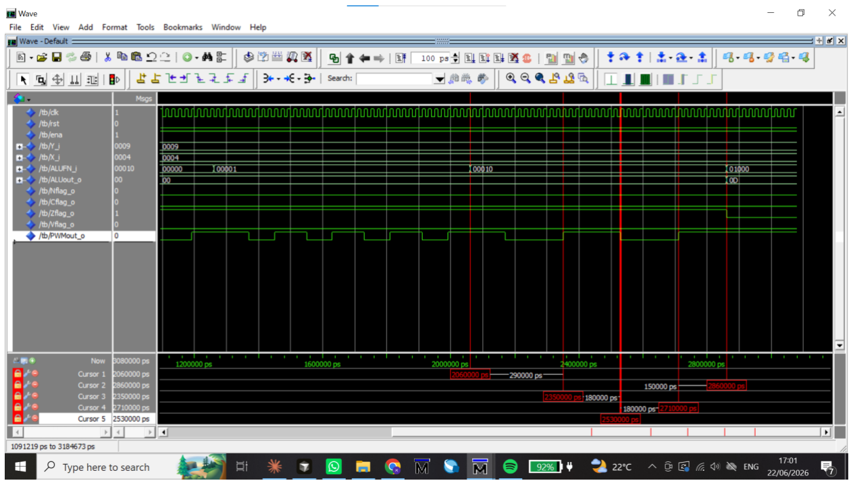
[picture p118: figure]

מבט פיזי על מיקומם הלוגי של רכיבי ה-Placement RTL/Fitter ALU:

איורים 25 ו 26 מציגים את המיפוי הפיזי ופריסת השערים הלוגיים )Placement Fitter )שביצע ה Quartus עבור פונקציות ה ALU השונות בתוך הרכיב. איורים אלו ממחישים כיצד הקוד ההתנהגותי תורגם בפועל למבנה חומרתי המבוסס על תאי לוגיקה ברכיב ה FPGA.

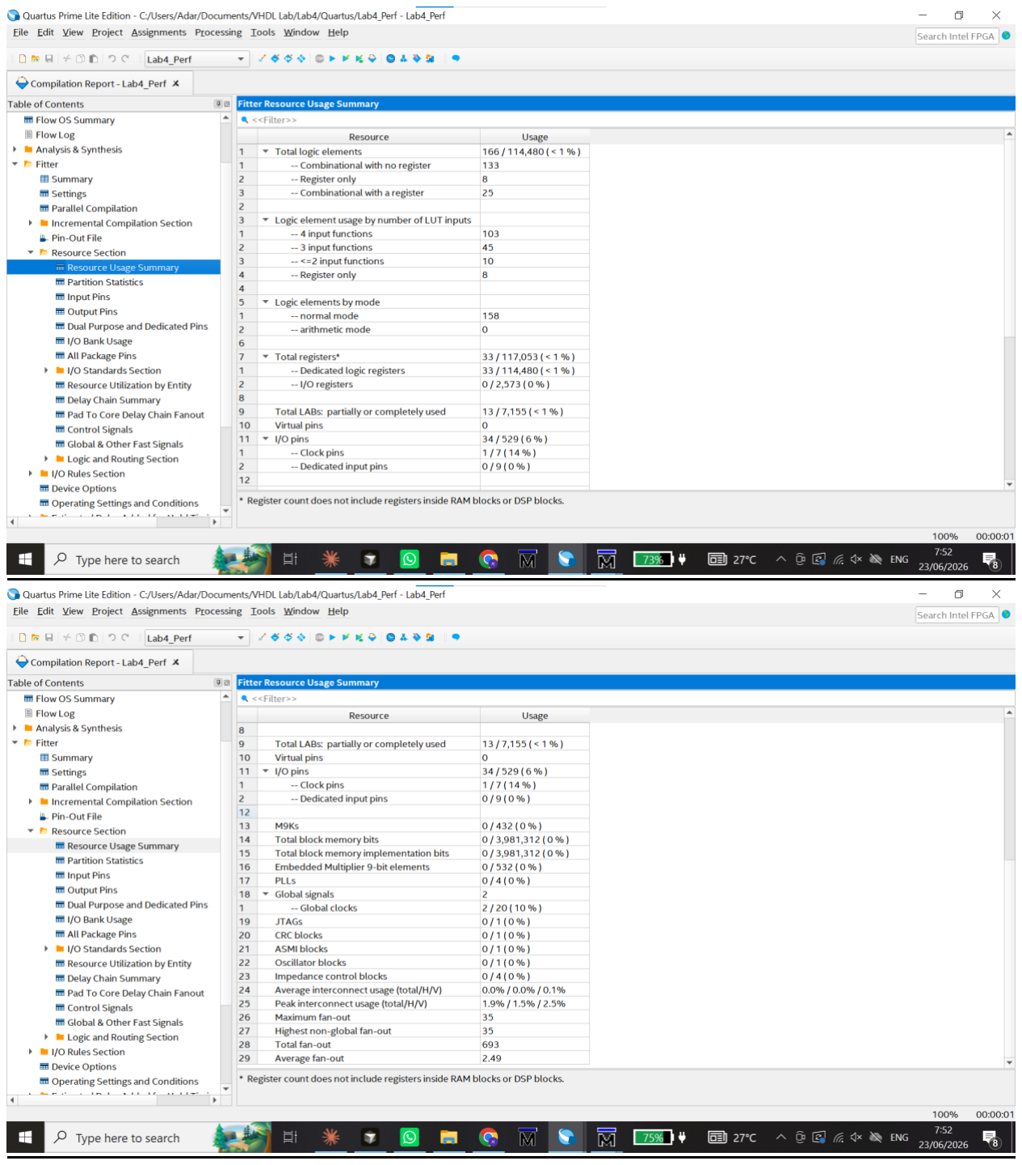
[picture p119: page 19]

תדר עבודה של שעון המערכת וה-Summary Clock PLL:

איור 27 מציג את דוח ה-Summary Clock מתוך ה-Analyzer Timing. ניתן לראות את הגדרת שעון המבוא הפיזי של הלוח בתדר 50MHz, ואת יצירת שעון המערכת הפנימי )fsysclk )בתדר של 2MHz על ידי יחידת ה-PLL לצורך הזנת תת-המערכת הסינכרונית.

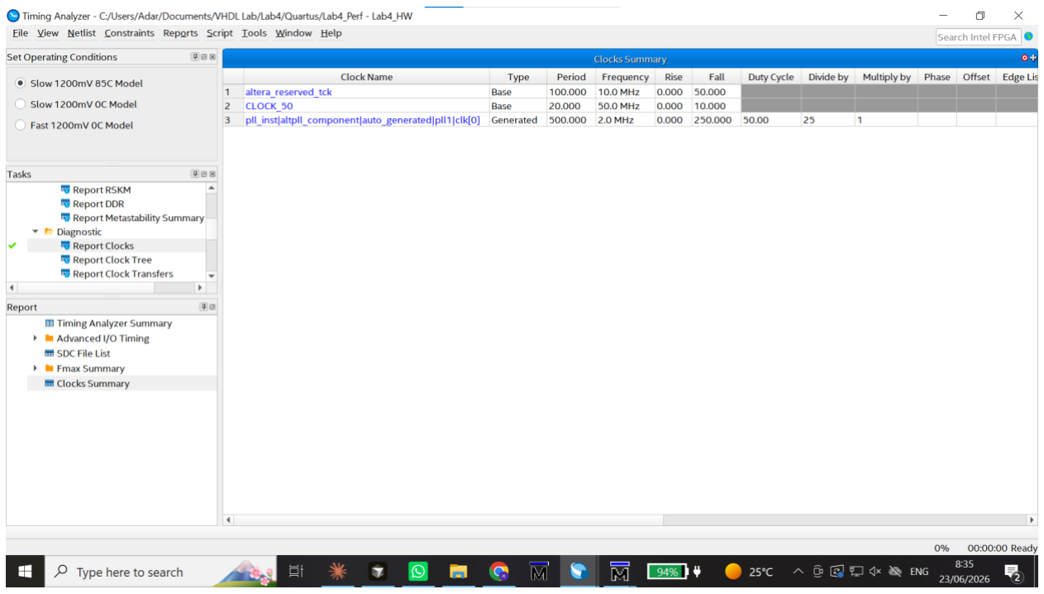
[picture p120: figure]

:)Setup Status ( | לבורד | Signal-Tap II-ה | חיבור | תצורת

איורים 28 ו 29 מציגים את חלונית הסטטוס והגדרות החיבור של כלי II Tap Signal. האיורים מציגים זיהוי מלא של שרשרת JTAG ומצב Ready, המוכיחים כי יחידת הבדיקה הוטמעה בהצלחה בחומרה ומאפשרת דגימה אמינה של האותות בזמן אמת.

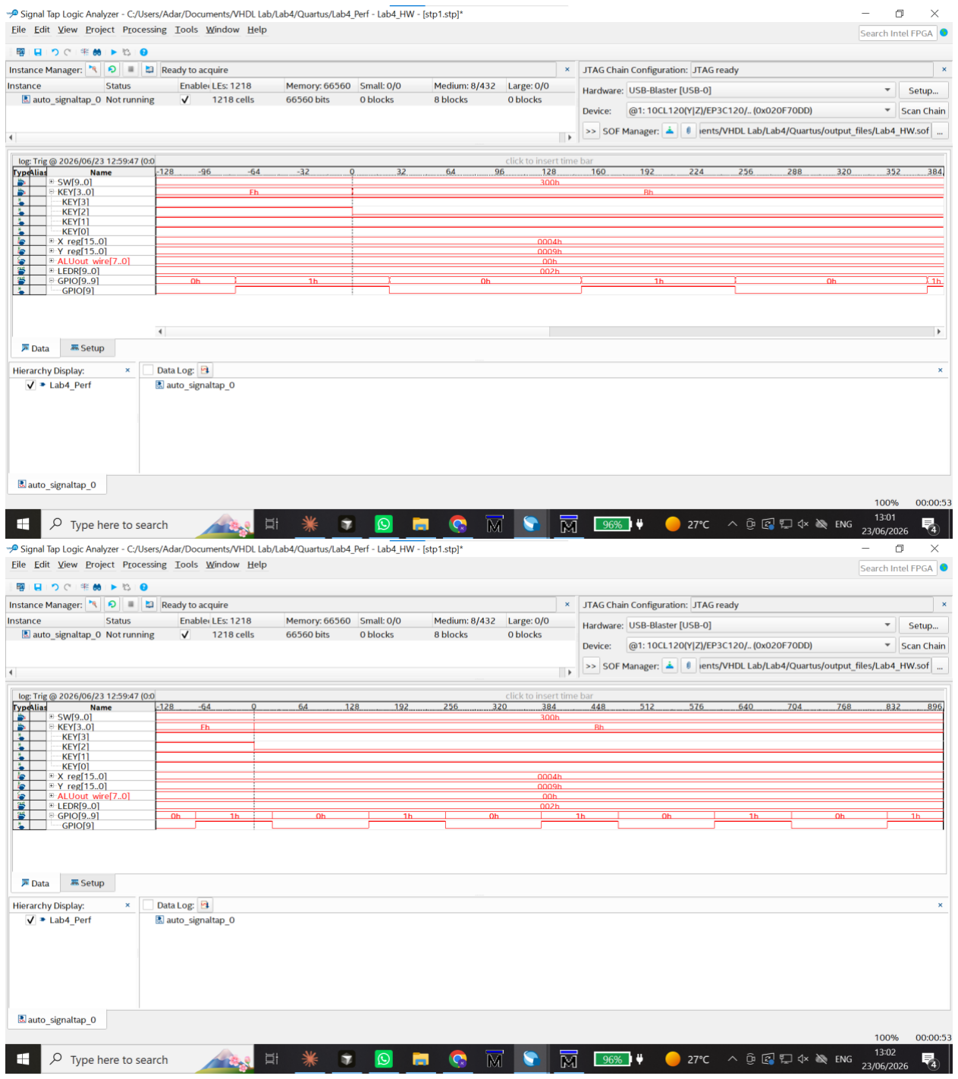
[picture p121: figure]

ע״פ התמונות המוצגות לעיל מילאנו את הטבלה:

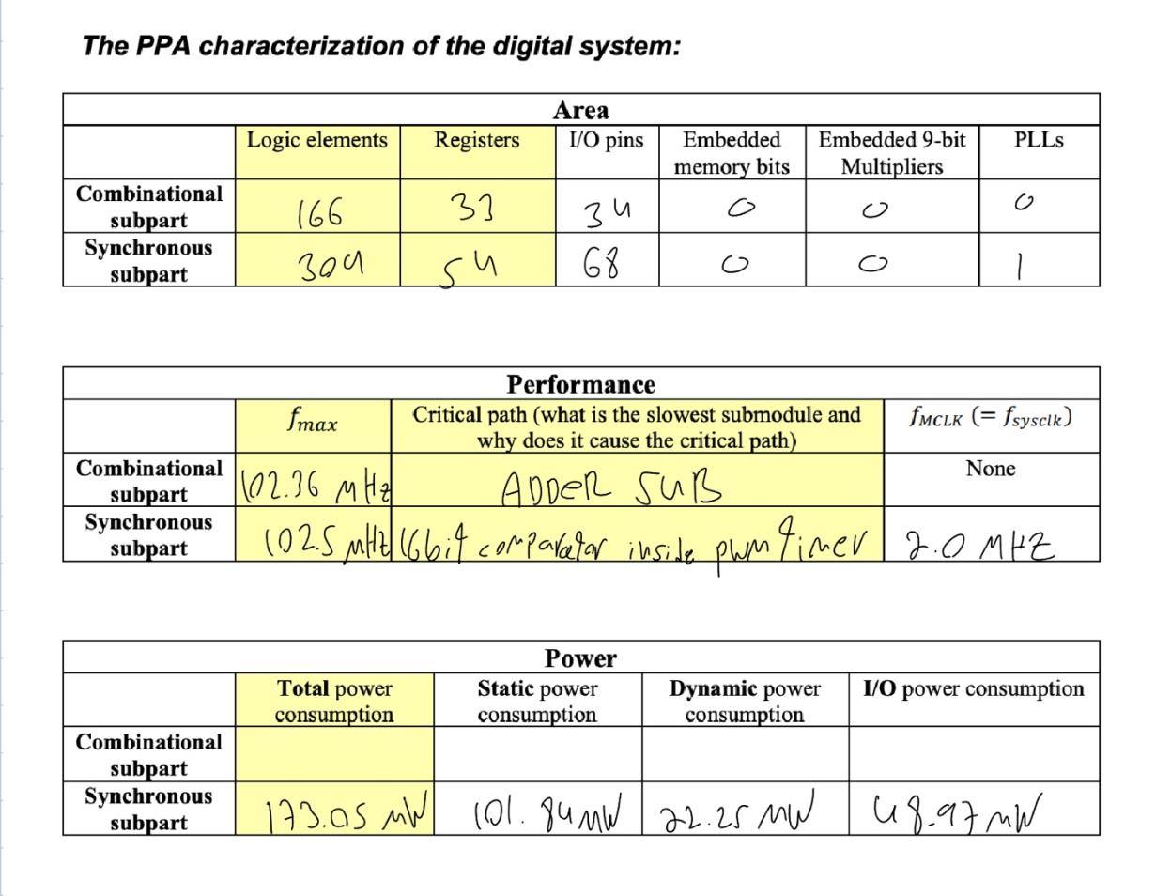
[picture p122: figure]

מסקנות הדוח:

סעיף מסקנות: בניסוי זה תוכננה בהצלחה מערכת היררכית המשלבת לוגיקה צירופית וסדרתית. נוכחנו לדעת כי הבלוק האריתמטי מהווה את צוואר הבקבוק של התדר המקסימלי בשל שרשרת הנשא, בעוד הבלוק הלוגי מציג את השהיית המינימום. כלי האימות ModelSim ו-Tap-Signal הוכיחו תאימות מלאה בין הסימולציה לחומרה.
