Adar-Shapira/rv32im-mcu-project/rv32im_mcu_project_0a7e2b8a.plan.md

---
name: RV32IM MCU Project
overview: >
  Build the RV32IM-based MCU on the structural base established by commit cfc4b4f of
  Adar-Shapira/Lab5 — the revision that follows Hanan's supplied references most closely — rather
  than on the current HEAD, whose last commit introduced three deviations that must not be carried
  forward. Fix the five decode defects present in every revision, add the peripherals from the
  Figure 1 architecture, and verify against the supplied benchmarks with self-checking testbenches.
isProject: false
---

# RV32IM MCU — Project Plan (rev 2)

**Supersedes the previous roadmap.** That version was written before the reference material had been
surveyed and before the Lab 5 git history was read. It assumed components would be written from
scratch that already exist, under-scoped the ones that do not, and treated the current Lab 5 HEAD as
the base to build on. All three assumptions were wrong.

**Reference for the base:** `https://github.com/Adar-Shapira/Lab5`, commit **`cfc4b4f`**
(15 Jul 2026, "Initial commit"). Verified: it is the revision that follows Hanan's supplied
references most closely.

---

# 0. NEW — the Lab 5 reference was replaced on 2026-08-23

> `Auxiliary/Lab 5 - as submitted/` is no longer the tree this plan was written against. It was
> replaced with the **actual final Lab 5 submission**, and the change is large enough that several
> earlier conclusions in this file are now out of date. Read this section before anything else.

**What is in the folder now** — 341 files, including three things that were not there before:

| New | What it is |
| --- | --- |
| `209580208_211468582/` | The real submission staging directory, with the `.sof` files and the `.stp`. Byte-identical to the top-level `DUT/`, `TB/`, so it is a copy, not a variant. |
| `Auxilary/RV32I/`, `Auxilary/Benchmarks/`, `Auxilary/Ori/` | Hanan's distribution, restructured into proper subfolders — plus a folder called `Ori` that is new. See the provenance warning below. |
| `PROJECT_EXPLANATION.md`, `DOC/HANDOVER_Report_lab5.md` | 1,400 and 640 lines of prose describing the design, the measured numbers and the report rewrite. The most useful documents in the whole reference tree. |

## 0.a The single most important finding: the pipeline is the repaired core

**The pipelined core repairs all of the single-cycle core's ISA defects, and it was submitted and
hardware-validated that way.** That changes Phase 3 completely: the repairs no longer have to be
designed by us. Each one is a transcription from a sibling core in the same submission that passed
all four benchmarks against the RARS golden DTCM.

And there are **seven** defects, not five. Two were found in the revised reference and had never been
recorded here:

| # | Defect | Broken at (our tree) | Repaired at (reference pipeline) |
| --- | --- | --- | --- |
| 1 | `andi` decodes as OR; `ori` matches the AND arm first | `CONTROL.vhd:142` | `CONTROL.vhd:147` |
| 2 | `lui` immediate is 0 | `const_package.vhd:27`, `IDECODE.vhd:102` | `const_package.vhd:28-29`, `IDECODE.vhd:181-182` |
| 3 | every load addresses `rs1+0` | `IDECODE.vhd:97-104` | `IDECODE.vhd:178` |
| 4 | `sra` ≡ `srl` | `EXECUTE.vhd:200` | `brl_shr_pad_r <= (others => '1')` |
| 5 | `sltu`/`sltiu`/`bltu`/`bgeu` compare signed | `EXECUTE.vhd:10,81` | `EXECUTE.vhd:196-197` |
| **6 — new** | **branch/`jal` displacement truncated one bit** | `EXECUTE.vhd:66` | `EXECUTE.vhd:181` |
| **7 — new** | **`jalr` does not clear the target's bit 0** | `IFETCH.vhd:93` | `RV32IM_PIPE_CORE.vhd:190` |

Defect 6 in detail, because it is the one nobody would find by running the benchmarks: `IDECODE`
delivers the B/J-type immediate as `imm[12:1]`, so the adder must shift left by one. The
as-submitted slice is `sign_extend_i(PC_WIDTH-3 DOWNTO 0)` = bits 10..0, which **drops immediate bit
11** — byte-offset bit 12 — halving the reachable branch range to ±2 KiB inside a 13-bit, 8 KiB PC.
No supplied benchmark branches that far, so all four still match their golden DTCM. It is latent,
not benign. (The original `-- << 2` comment on that line is also wrong; the code shifts by one,
correctly.)

The reference even ships its own regression for these:
`Auxiliary/Lab 5 - as submitted/SIM/RV32IM_pipeline/directed_isa.do`. Our
`SIM/RV32IMscMCU/repair_check.do` is the single-cycle port of it.

## 0.b The pipeline was rewritten, and our copy was a revision behind

The revised pipeline is a different design from the one Phase 1 imported:

| Changed | From | To |
| --- | --- | --- |
| Multiplier | one `MUL16` in EX | **split**: `MULT_1` (EX, four 8×8 products) + `MULT_2` (MEM, combine) |
| Write-back mux | inside `IDECODE` | its own module, **`WRITEBACK.vhd`** |
| Signal-Tap trigger | `BPTRIGGER_o` | **`STRIGGER_o`** |
| `STCNT_o` / `FHCNT_o` | 8-bit | **16-bit** |
| Observation ports | one `pc_o`/`instruction_o` + datapath signals | **five** per-stage PC/instruction pairs (Figure 8) |
| `stall_o`, `flush_o` | top-level ports | **internal** (`stall_w`, `flush_w`) — observe in the wave window, not on a pin |
| `MUL16.vhd` | instantiated | present but **not instantiated**; removed from our tree |
| `STCNT` policy | every stall cycle | only `stall='1' and flush='0'` |

Our `DUT/RV32IMpipelinedMCU/` has been re-imported and the wrapper, testbench and `.do` scripts
rewritten to match. Details in Phase 3D.

## 0.c Measured numbers from the reference — use these, not the old ones

From `DOC/HANDOVER_Report_lab5.md` §3 and §6. The single-cycle row is unchanged; every pipeline
number moved.

| | Logic elements | Registers | I/O pins | Memory bits | 9-bit multipliers | Fmax | Total power |
| --- | --- | --- | --- | --- | --- | --- | --- |
| Single-cycle | 3,120 | 1,279 | 270 | **131,072** | 4 | **26.81 MHz** | 275.98 mW |
| Pipeline | 3,538 | 1,877 | 284 | **131,072** | 4 | **51.7 MHz** | 292.21 mW |

The old pipeline figures (3,384 LE / 1,696 regs / 297 pins / 41.84 MHz / 299.10 mW) are **stale** —
`HANDOVER §4.6` lists them as the copy-paste tell. Memory bits stay 131,072 in both, which is still
the number that catches a stray SignalTap instance.
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
