Adar-Shapira/rv32im-mcu-project/DOC/04_baseline_runbook.md

# Deliverable D — Baseline Runbook (Step 2)

Reproduce a known-good run of the **unchanged** Lab 5 cores before any RTL is touched, so that a
later failure can be attributed to our change rather than to the reference, the tool install, or the
environment.

**This runbook executes on the Windows machine.** Everything it needs is already in the repository;
nothing has to be recreated from scratch. Sections 1–3 are preparation, section 4 is the run,
section 5 is the pass/fail criterion.

Based on `Auxiliary/Lab 5/ModelSim_Testing_Guide.md`, which is the students' own
documented working procedure, and on the supplied `.do` scripts in the same tree.

---
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
