Adar-Shapira/rv32im-mcu-project/Auxiliary/Lab4/Auxiliary/counter/DOC/top diagram.png

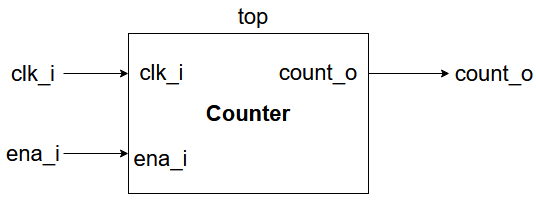
Auxiliary/Lab4/Auxiliary/counter/DOC/top diagram.png
