Adar-Shapira/rv32im-mcu-project/Auxiliary/Lab4/Auxiliary/counter/Quartus/PowerAnalyzer/Power Analysis report.png

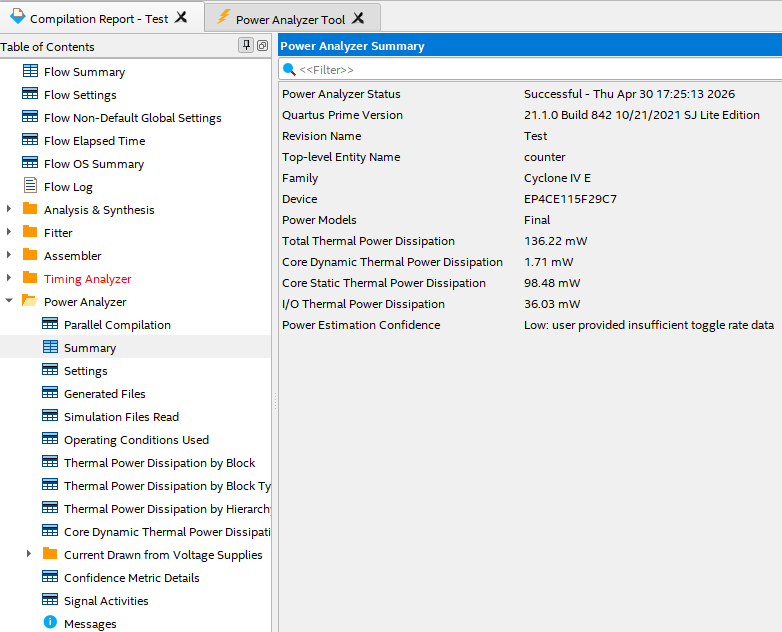
Auxiliary/Lab4/Auxiliary/counter/Quartus/PowerAnalyzer/Power Analysis report.png
