Adar-Shapira/rv32im-mcu-project/Auxiliary/Lab4/Auxiliary/DE2-115 Board Connections.png

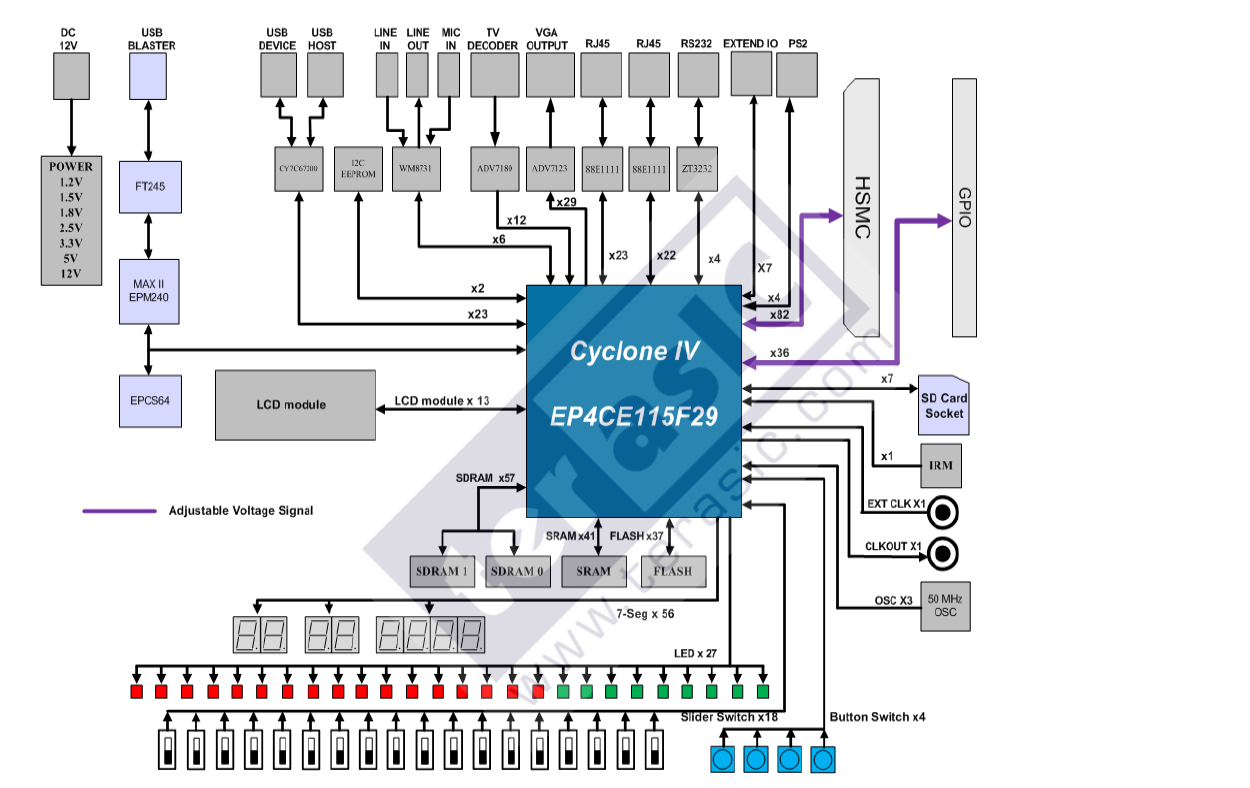
Auxiliary/Lab4/Auxiliary/DE2-115 Board Connections.png
