Adar-Shapira/rv32im-mcu-project/Auxiliary/Lab4/Auxiliary/FPGA board (1).png

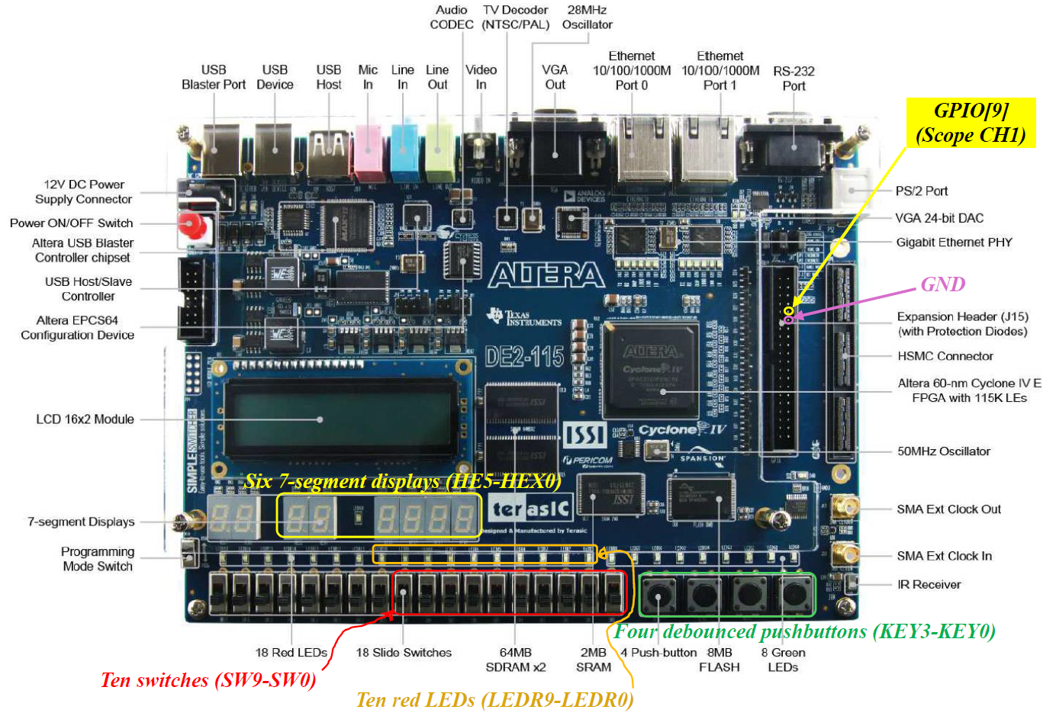
Auxiliary/Lab4/Auxiliary/FPGA board (1).png
