Adar-Shapira/rv32im-mcu-project/Auxiliary/Lab4/Auxiliary/Images/hw/anssummary.png

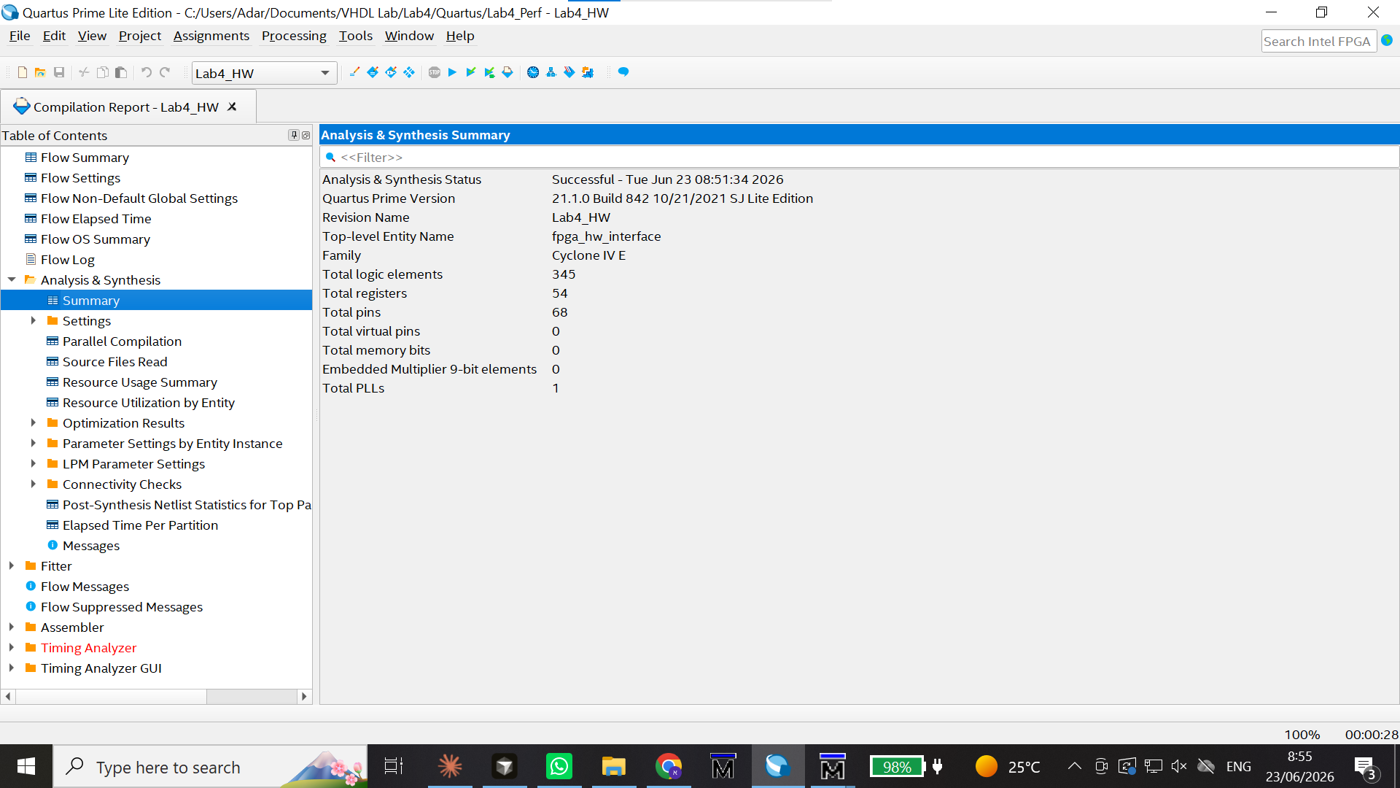
Auxiliary/Lab4/Auxiliary/Images/hw/anssummary.png
