Adar-Shapira/rv32im-mcu-project/Auxiliary/Lab4/Auxiliary/Images/hw/fmaxhw.png

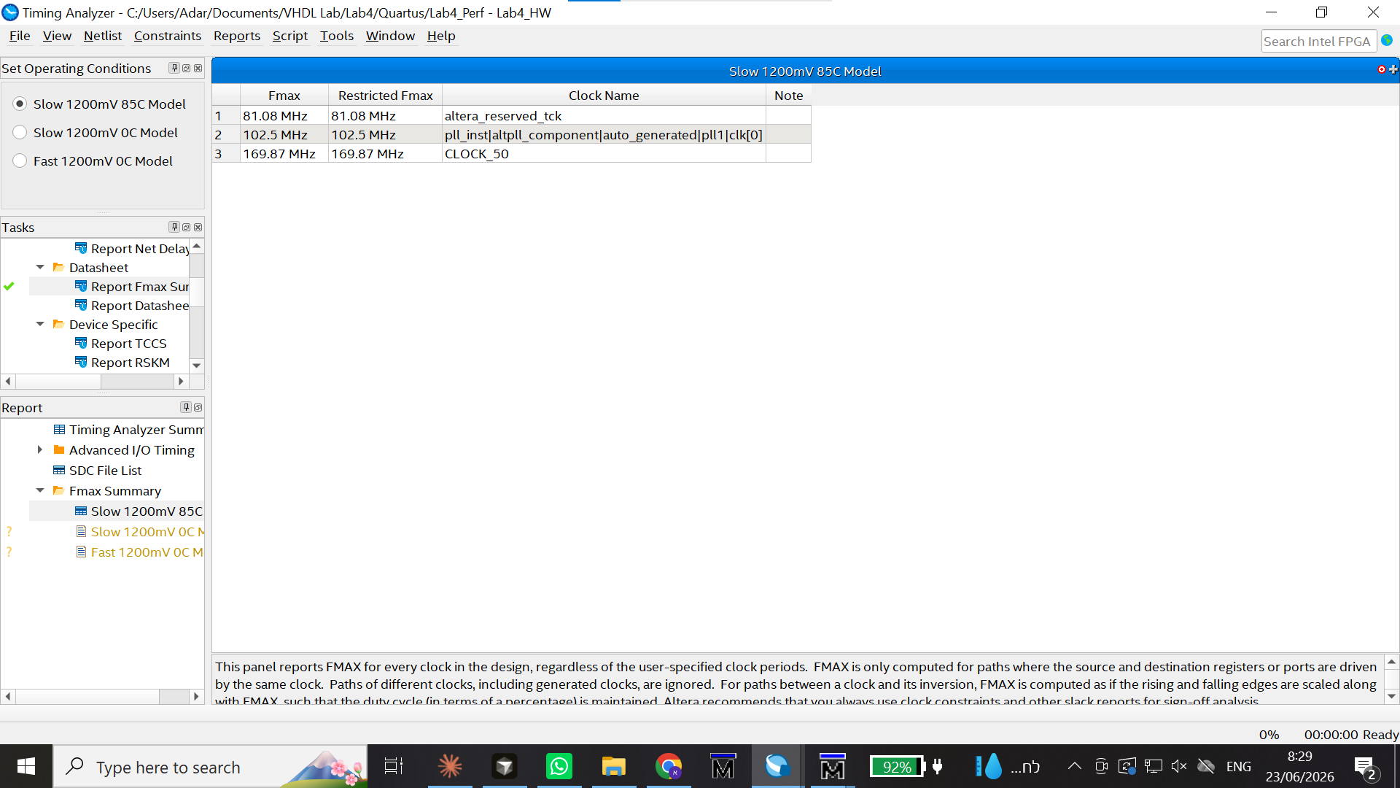
Auxiliary/Lab4/Auxiliary/Images/hw/fmaxhw.png
