Adar-Shapira/rv32im-mcu-project/Auxiliary/Lab4/Auxiliary/Images/hw/powersummary.png

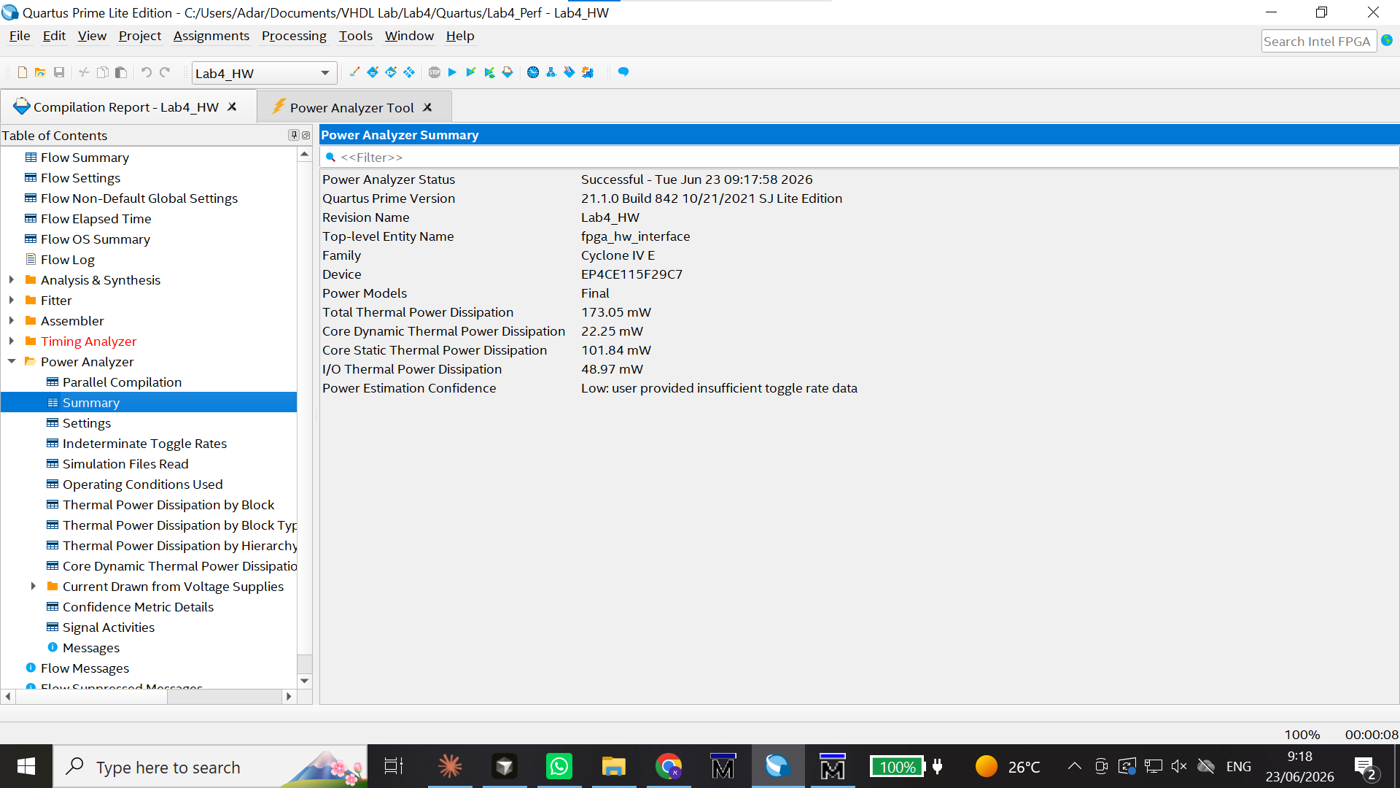
Auxiliary/Lab4/Auxiliary/Images/hw/powersummary.png
