Adar-Shapira/rv32im-mcu-project/Auxiliary/Lab4/Auxiliary/Images/hw/rtlpwm.png

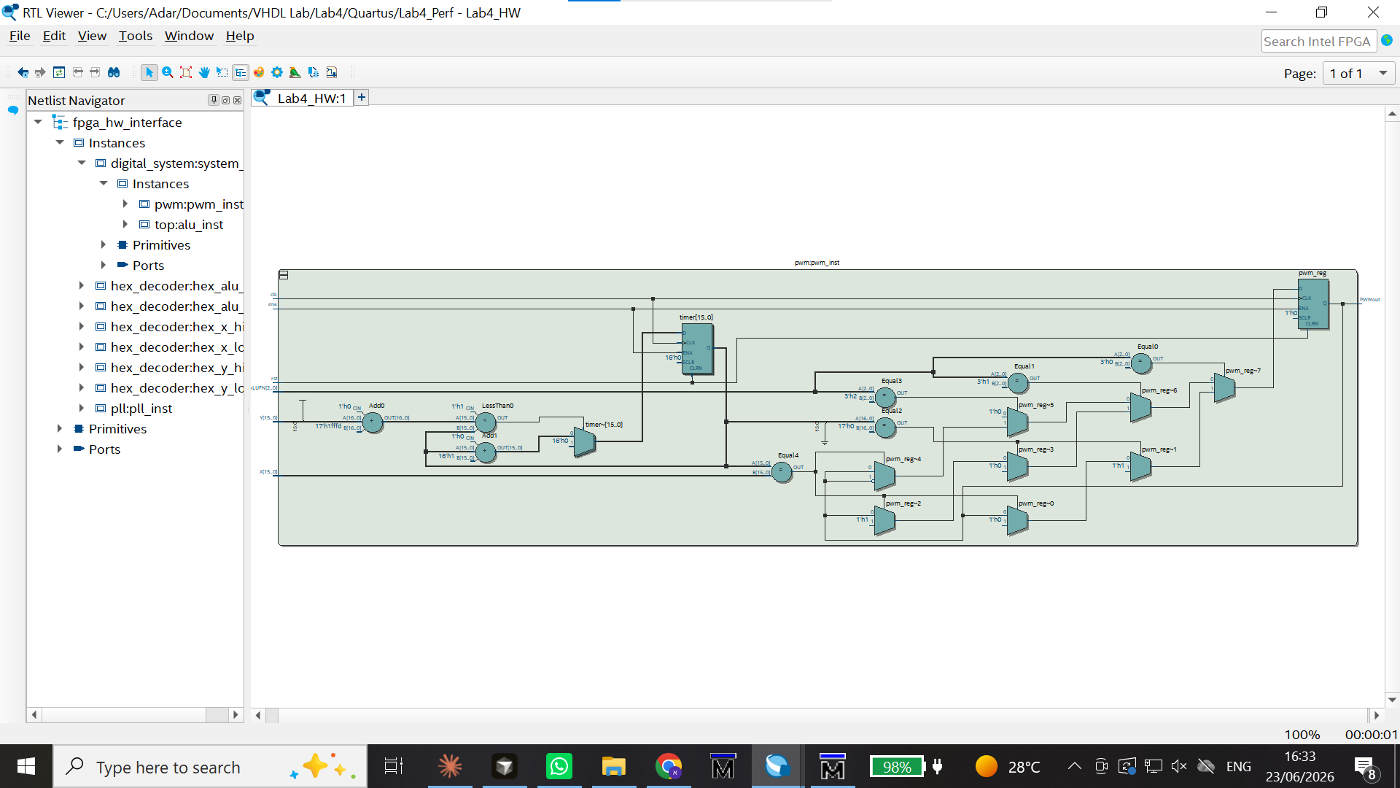
Auxiliary/Lab4/Auxiliary/Images/hw/rtlpwm.png
