Adar-Shapira/rv32im-mcu-project/Auxiliary/Lab4/Auxiliary/Images/hw/rue2.png

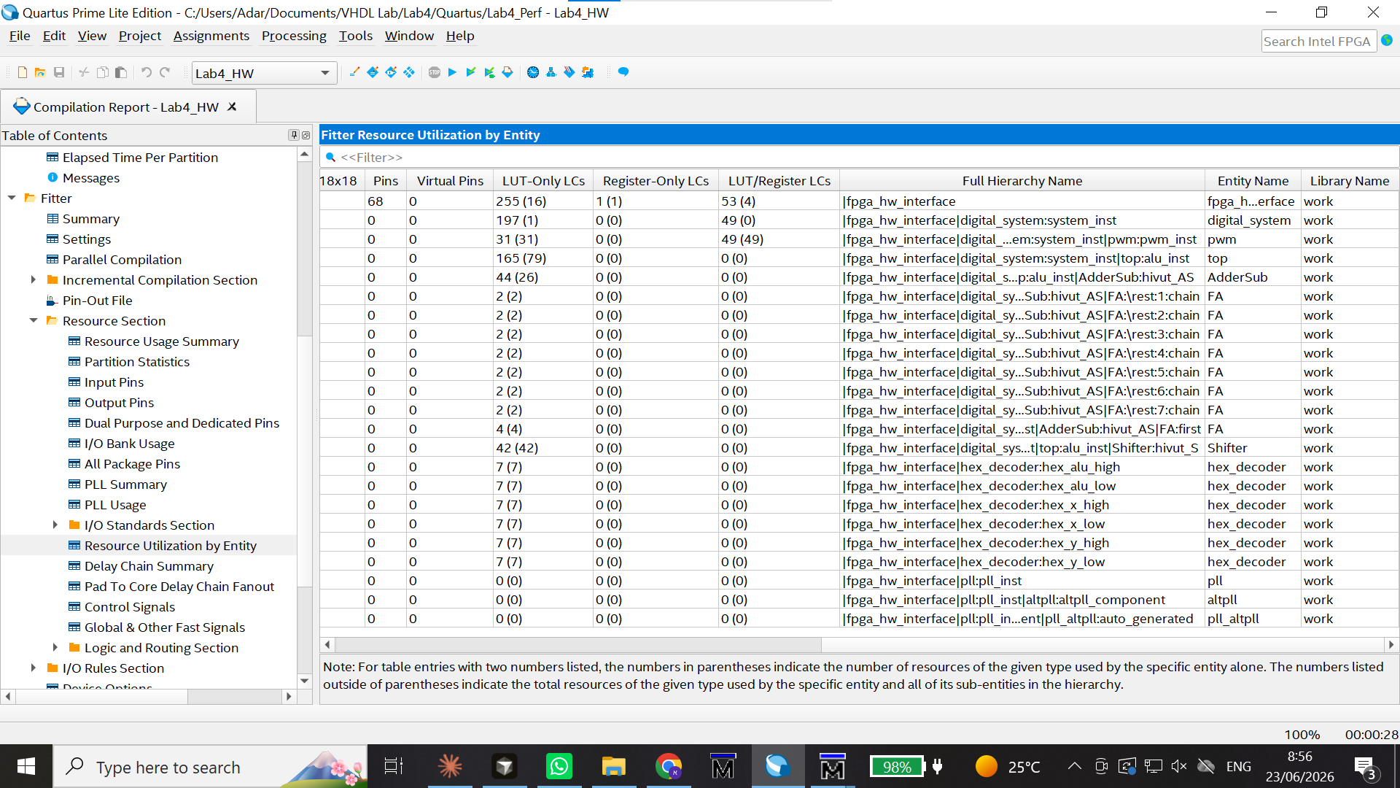
Auxiliary/Lab4/Auxiliary/Images/hw/rue2.png
