Adar-Shapira/rv32im-mcu-project/Auxiliary/Lab4/Auxiliary/Images/perf/flowsummary.png

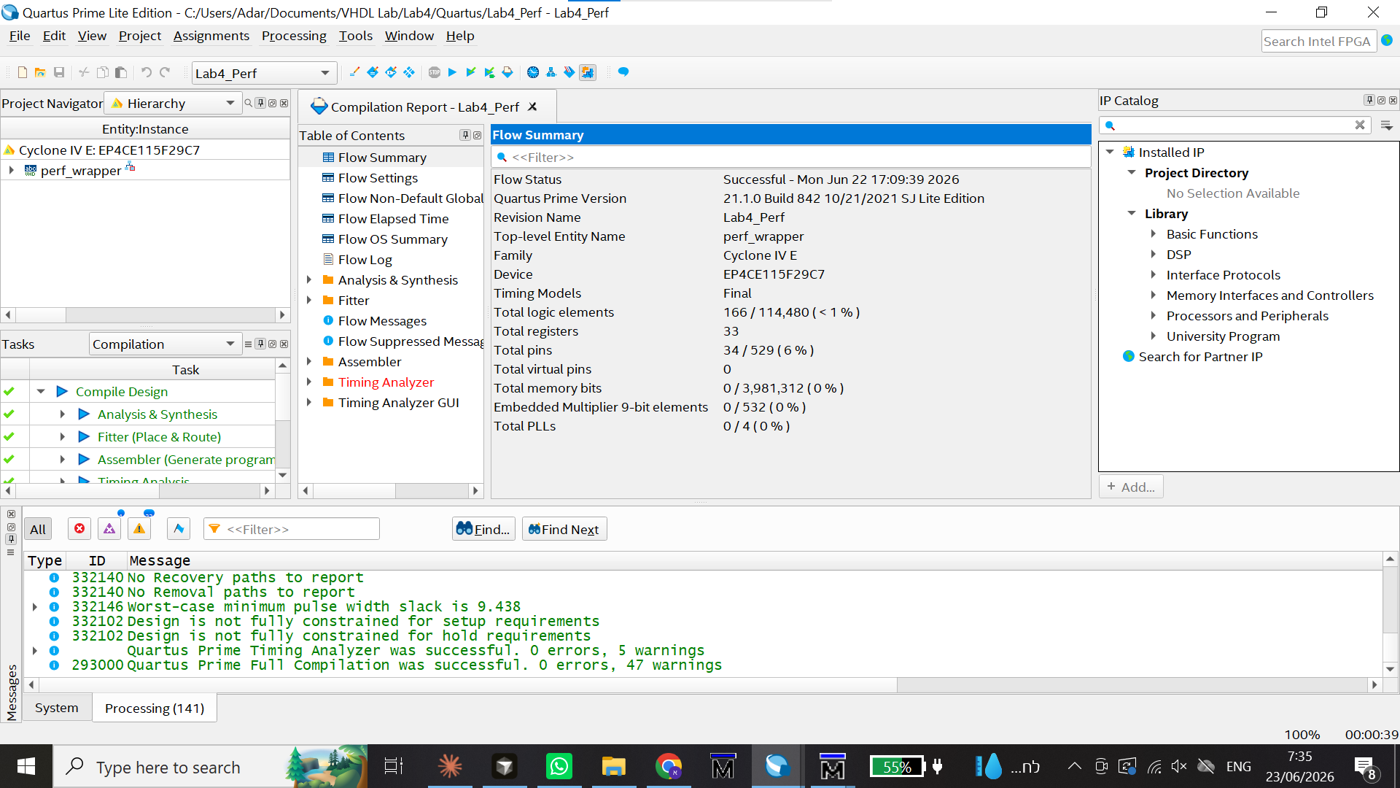
Auxiliary/Lab4/Auxiliary/Images/perf/flowsummary.png
