Adar-Shapira/rv32im-mcu-project/Auxiliary/Lab4/Auxiliary/Images/perf/fru1.png

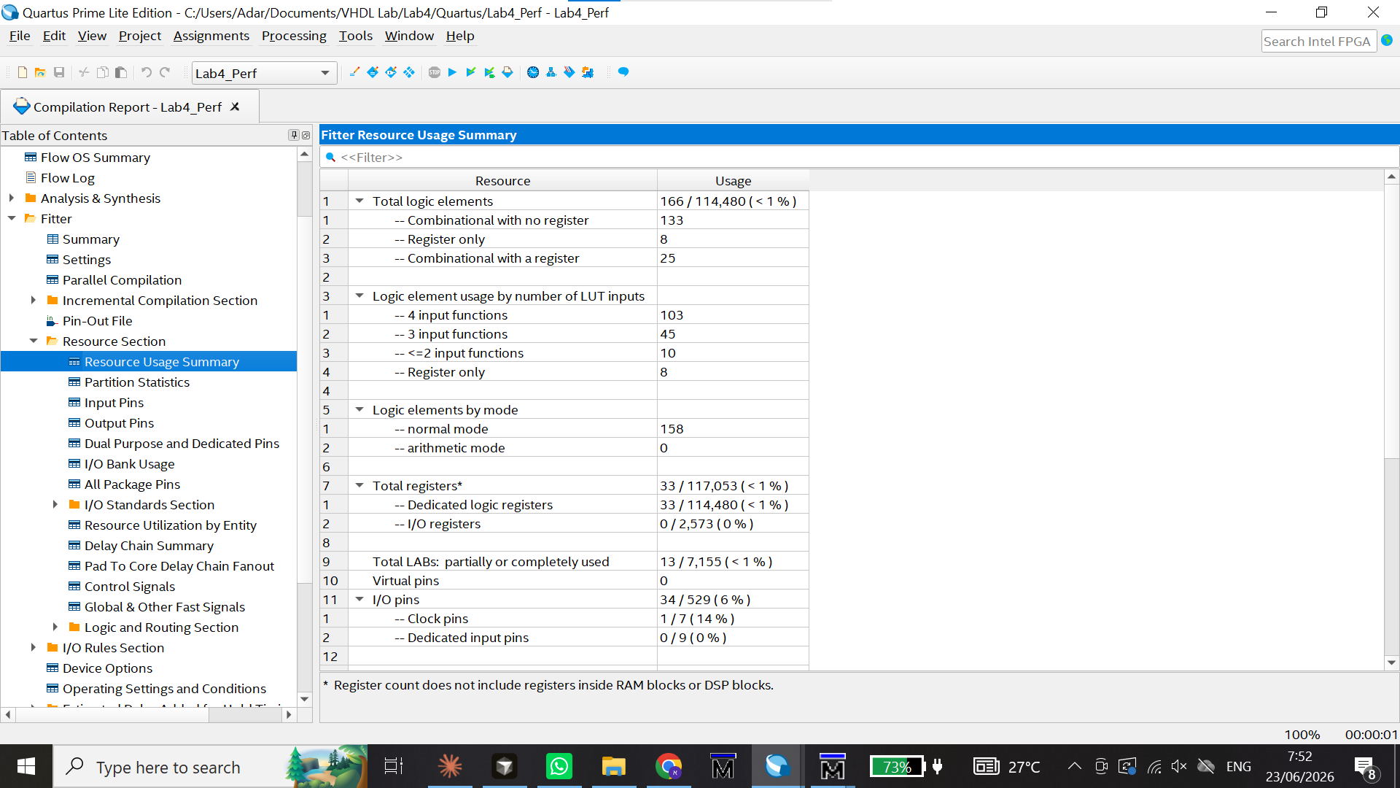
Auxiliary/Lab4/Auxiliary/Images/perf/fru1.png
