Adar-Shapira/rv32im-mcu-project/Auxiliary/Lab4/Auxiliary/Images/perf/pwm00.png

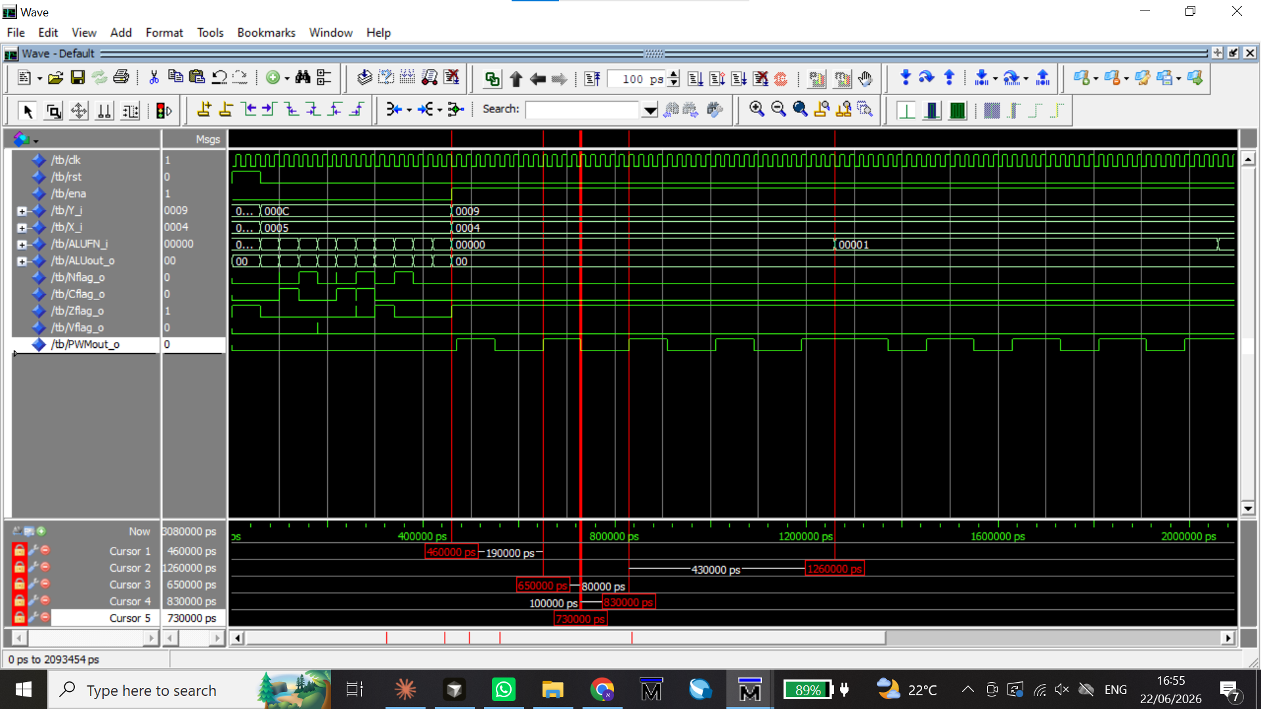
Auxiliary/Lab4/Auxiliary/Images/perf/pwm00.png
