Adar-Shapira/rv32im-mcu-project/Auxiliary/Lab4/Auxiliary/Images/perf/pwm10.png

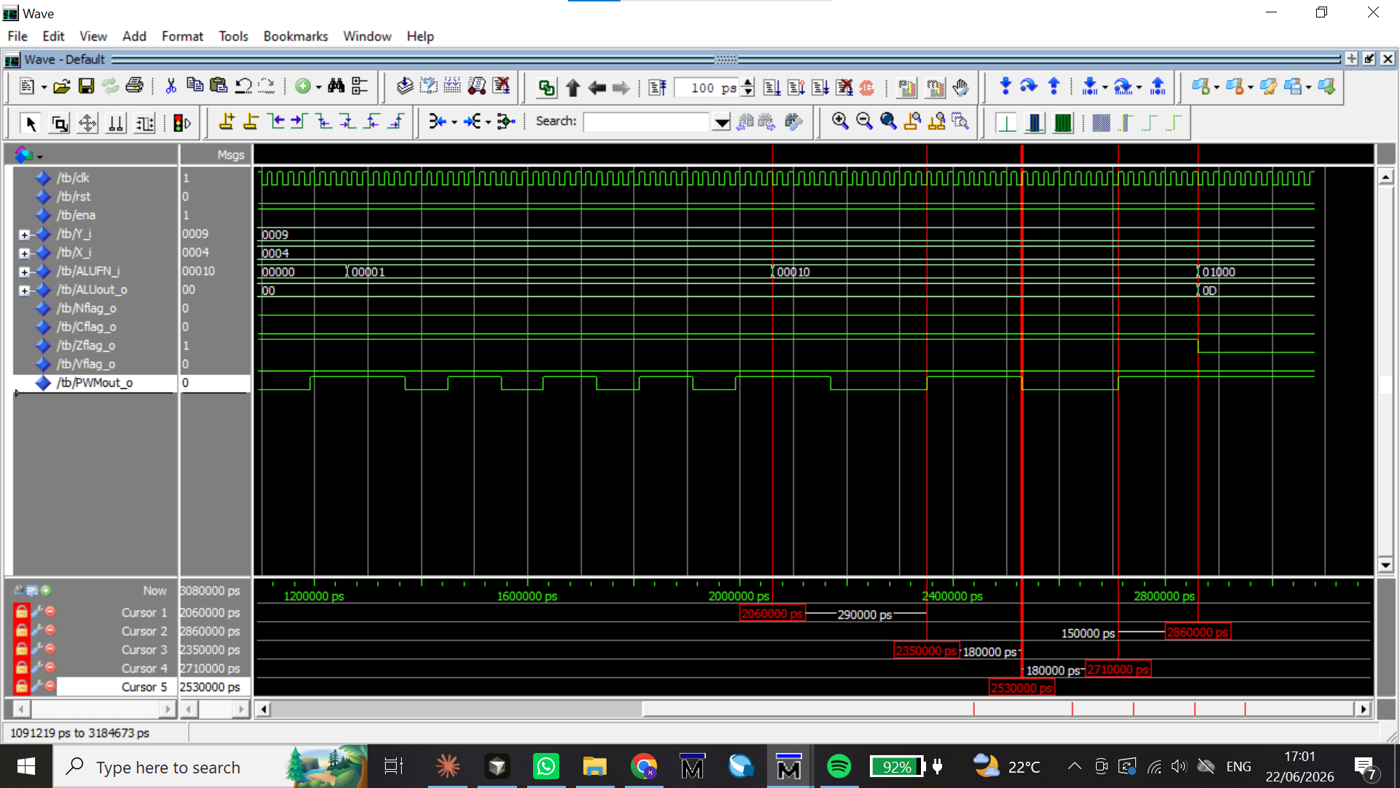
Auxiliary/Lab4/Auxiliary/Images/perf/pwm10.png
