Adar-Shapira/rv32im-mcu-project/Auxiliary/Lab4/Auxiliary/Images/perf/rtlshifter.png

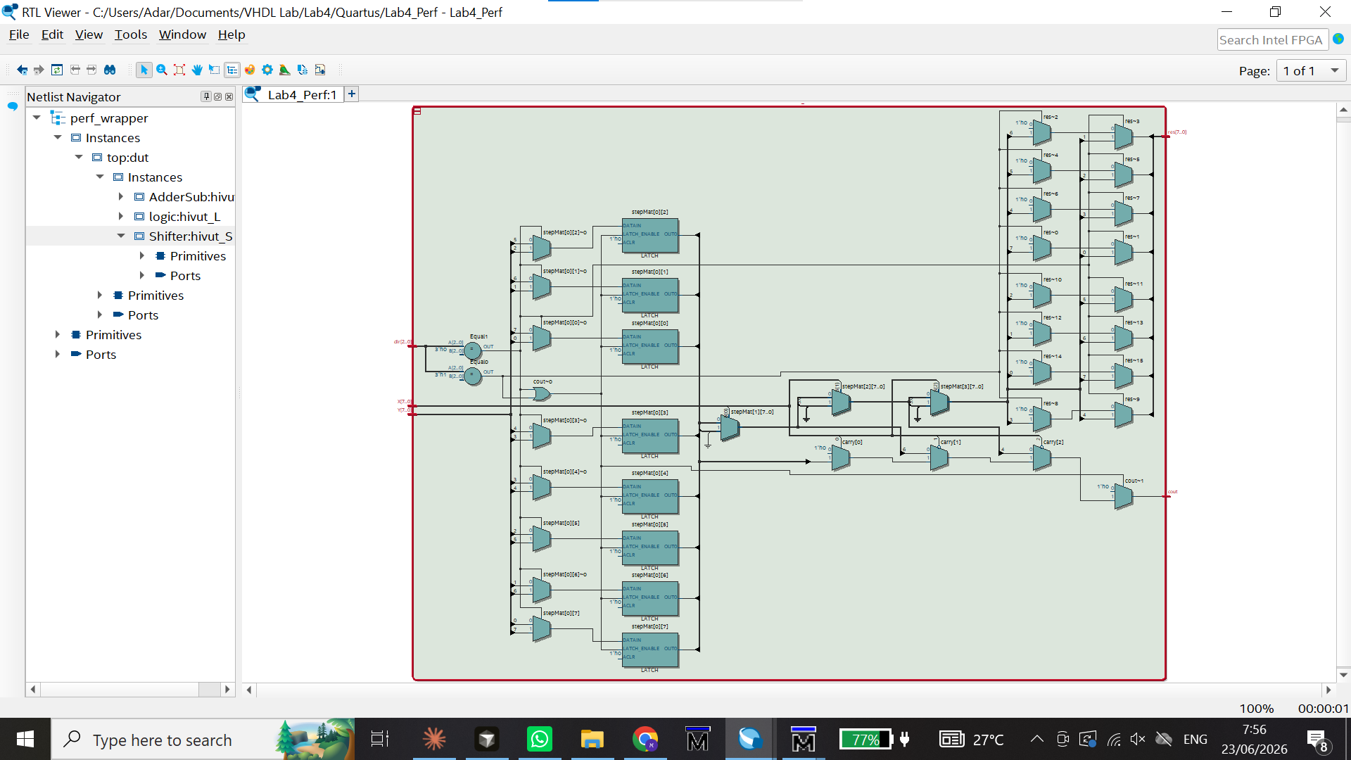
Auxiliary/Lab4/Auxiliary/Images/perf/rtlshifter.png
