Adar-Shapira/rv32im-mcu-project/Auxiliary/Lab4/Auxiliary/Images/perf/RUE1.png

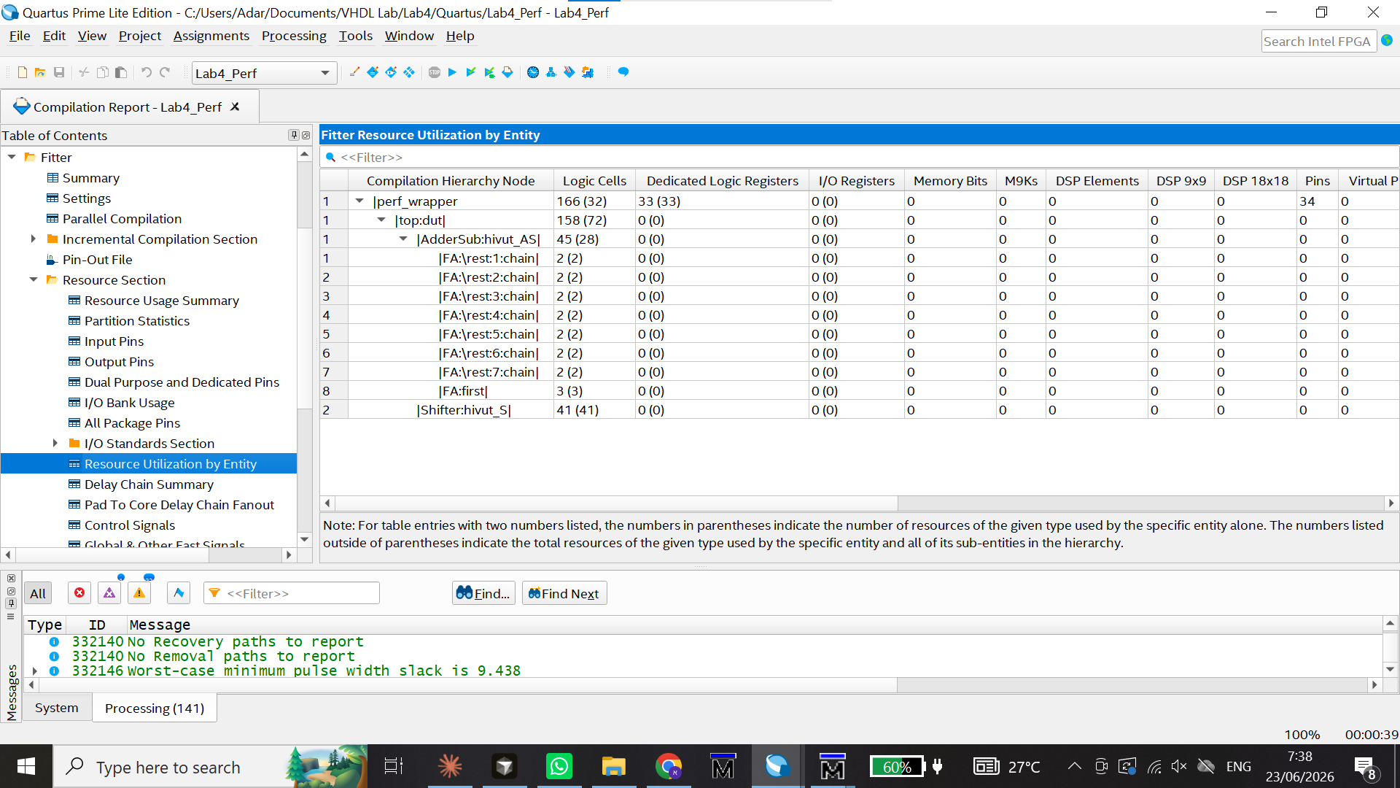
Auxiliary/Lab4/Auxiliary/Images/perf/RUE1.png
