Adar-Shapira/rv32im-mcu-project/Auxiliary/Lab4/Auxiliary/Images/perf/RUE2.png

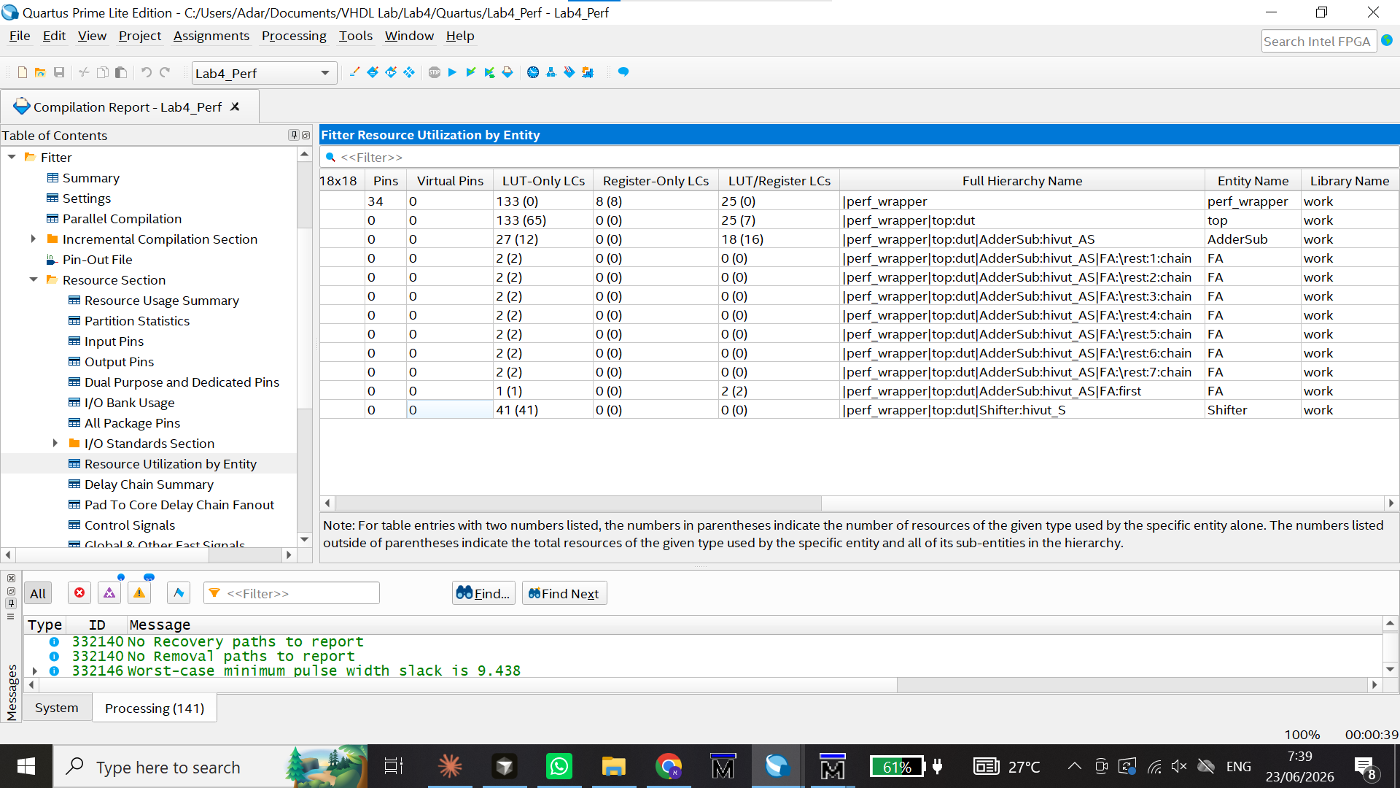
Auxiliary/Lab4/Auxiliary/Images/perf/RUE2.png
