Adar-Shapira/rv32im-mcu-project/Auxiliary/Lab4/Auxiliary/Images/signaltap/add.png

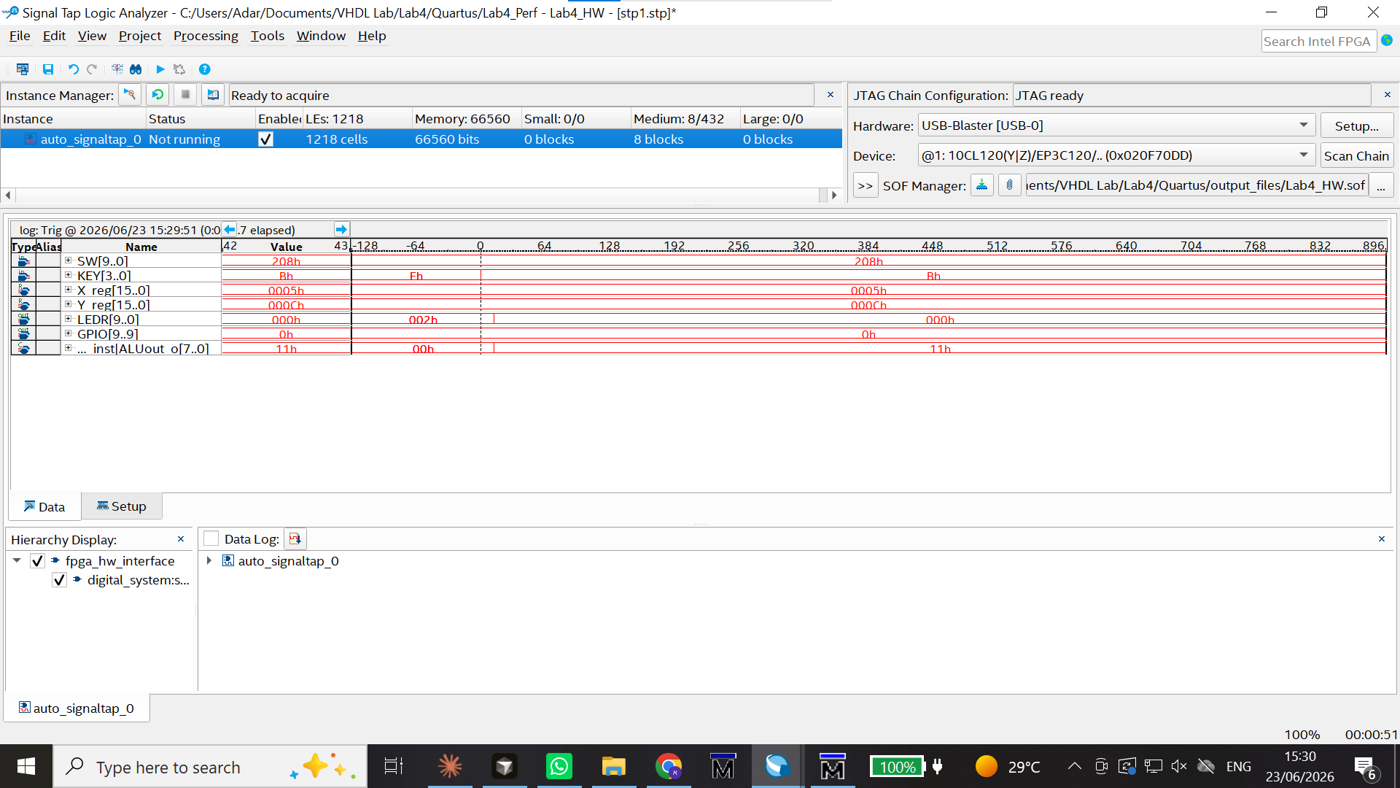
Auxiliary/Lab4/Auxiliary/Images/signaltap/add.png
