Adar-Shapira/rv32im-mcu-project/Auxiliary/Lab4/Auxiliary/Images/signaltap/pwm00.png

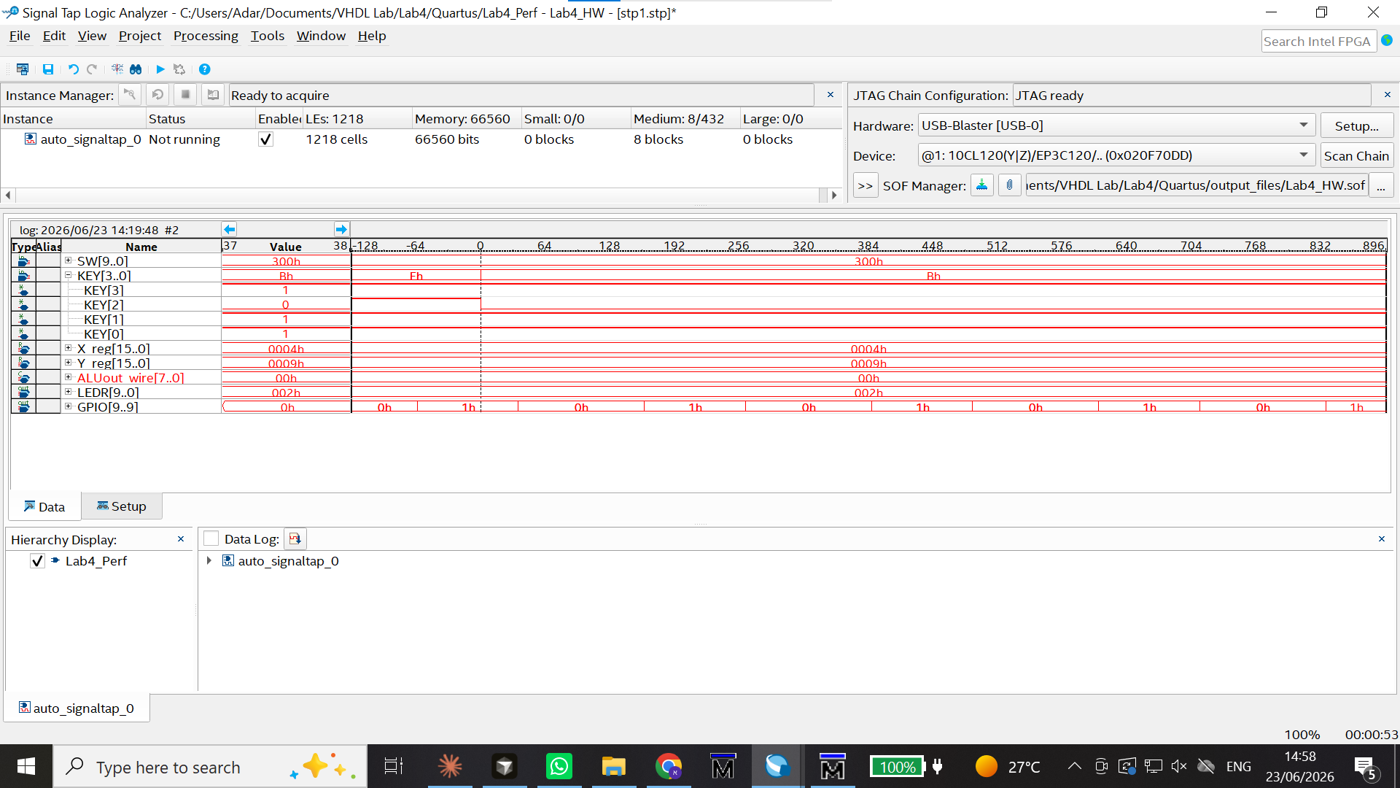
Auxiliary/Lab4/Auxiliary/Images/signaltap/pwm00.png
