Adar-Shapira/rv32im-mcu-project/Auxiliary/Lab4/Auxiliary/Images/signaltap/stsr1.png

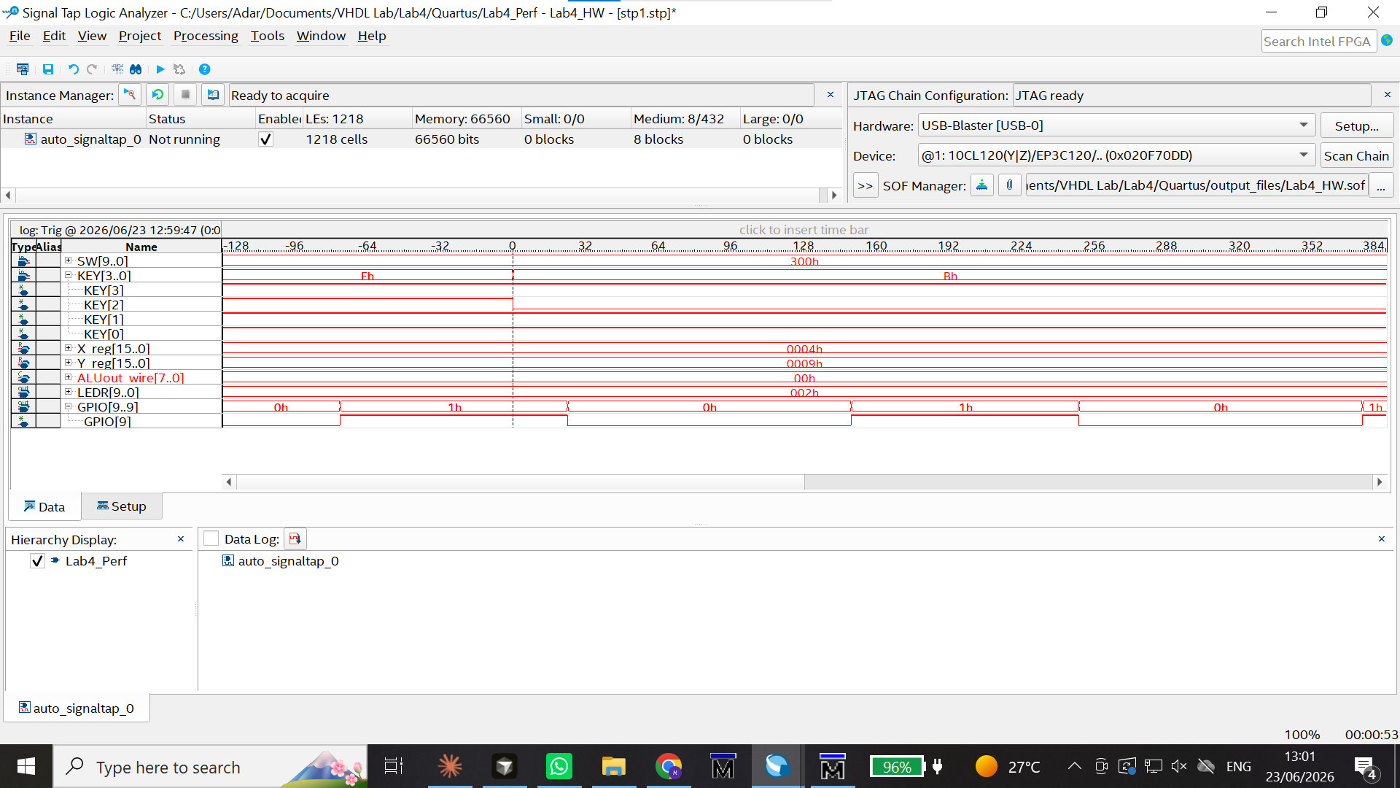
Auxiliary/Lab4/Auxiliary/Images/signaltap/stsr1.png
