Adar-Shapira/rv32im-mcu-project/Auxiliary/Lab4/Auxiliary/Images/signaltap/stsr2.png

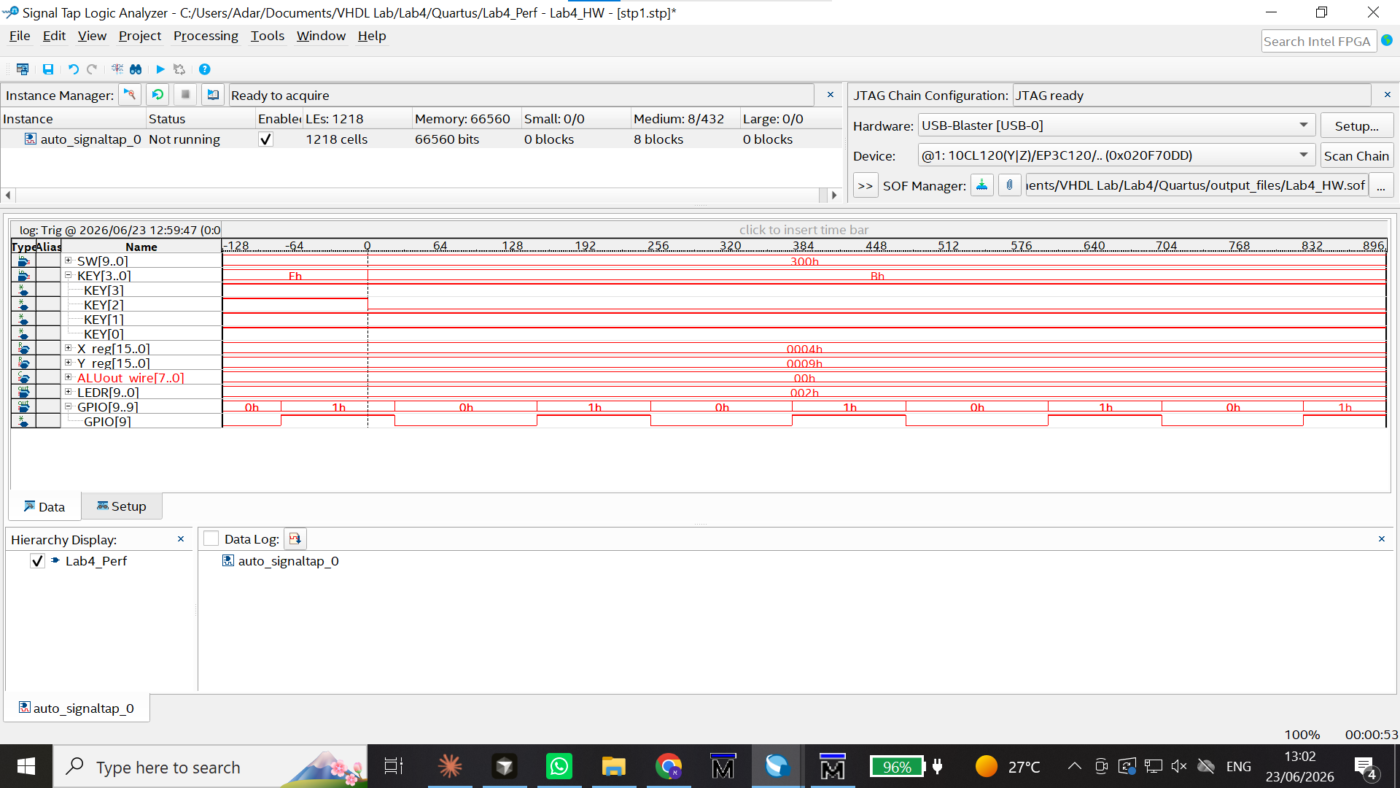
Auxiliary/Lab4/Auxiliary/Images/signaltap/stsr2.png
