Adar-Shapira/rv32im-mcu-project/Auxiliary/Lab4/Auxiliary/JP5 header connections.png

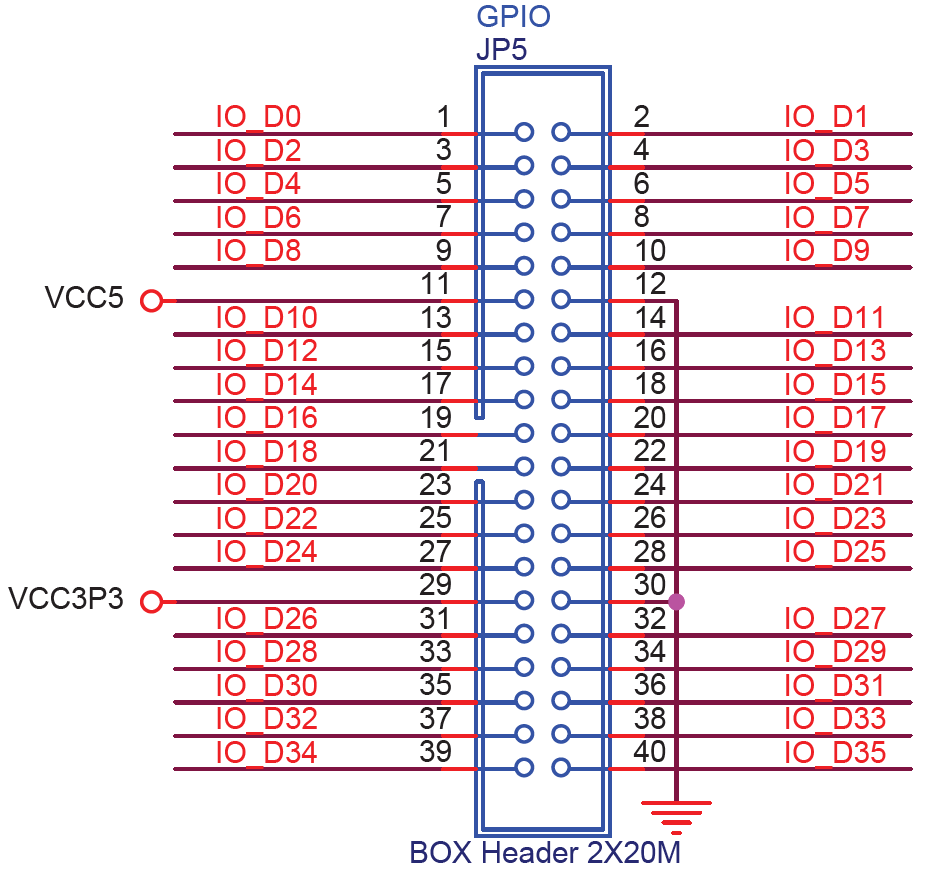
Auxiliary/Lab4/Auxiliary/JP5 header connections.png
