Adar-Shapira/rv32im-mcu-project/Auxiliary/Lab4/Auxiliary/pll_counter/DOC/top diagram.png

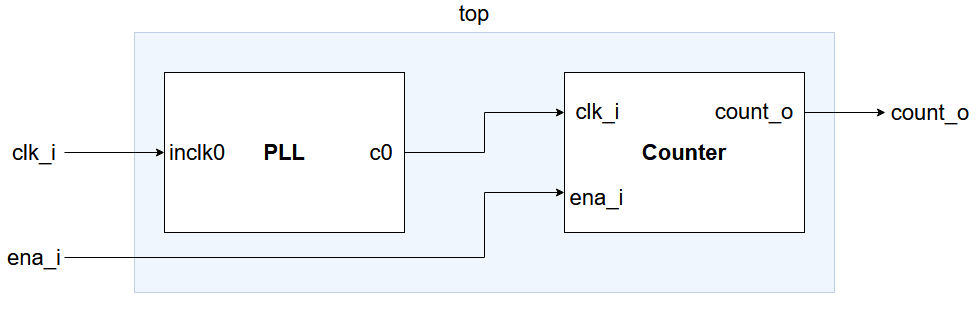
Auxiliary/Lab4/Auxiliary/pll_counter/DOC/top diagram.png
