Adar-Shapira/rv32im-mcu-project/Auxiliary/Lab 5/Auxilary/_fig8_img_0.png

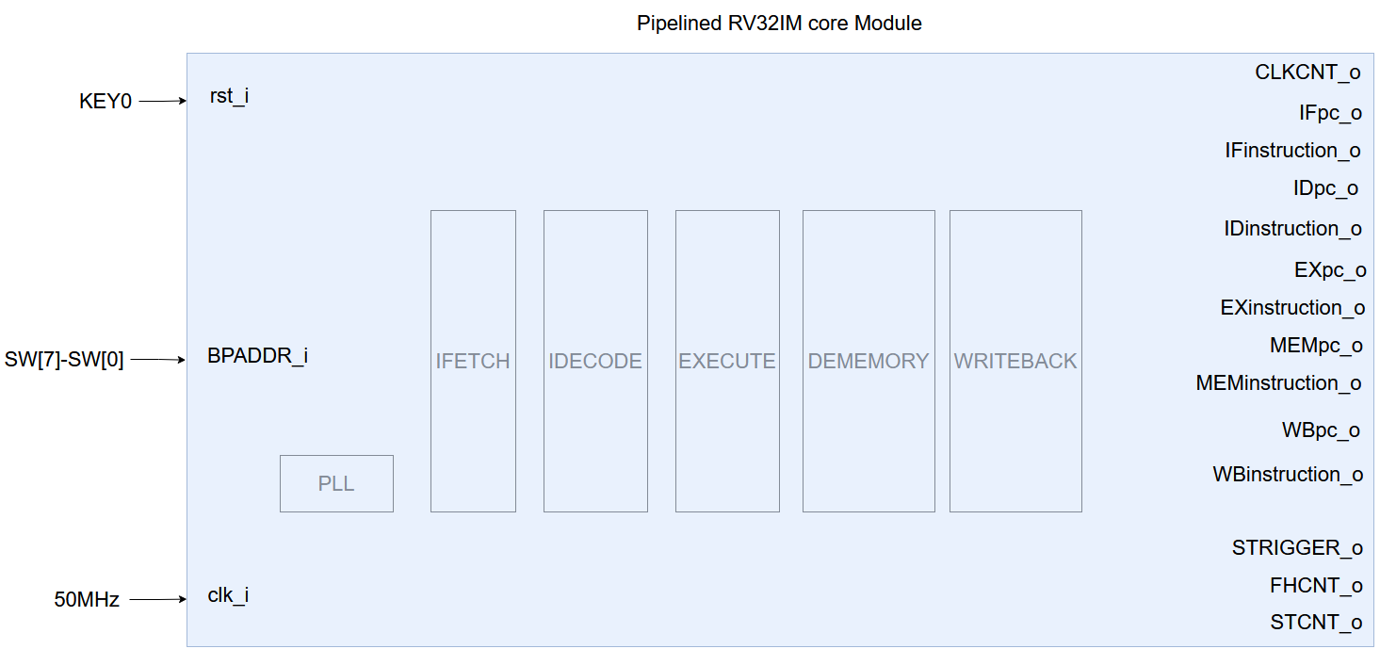
Auxiliary/Lab 5/Auxilary/_fig8_img_0.png
