Adar-Shapira/rv32im-mcu-project/Auxiliary/Lab 5/Auxilary/RV32I/DOC/IFETCH rtl.png

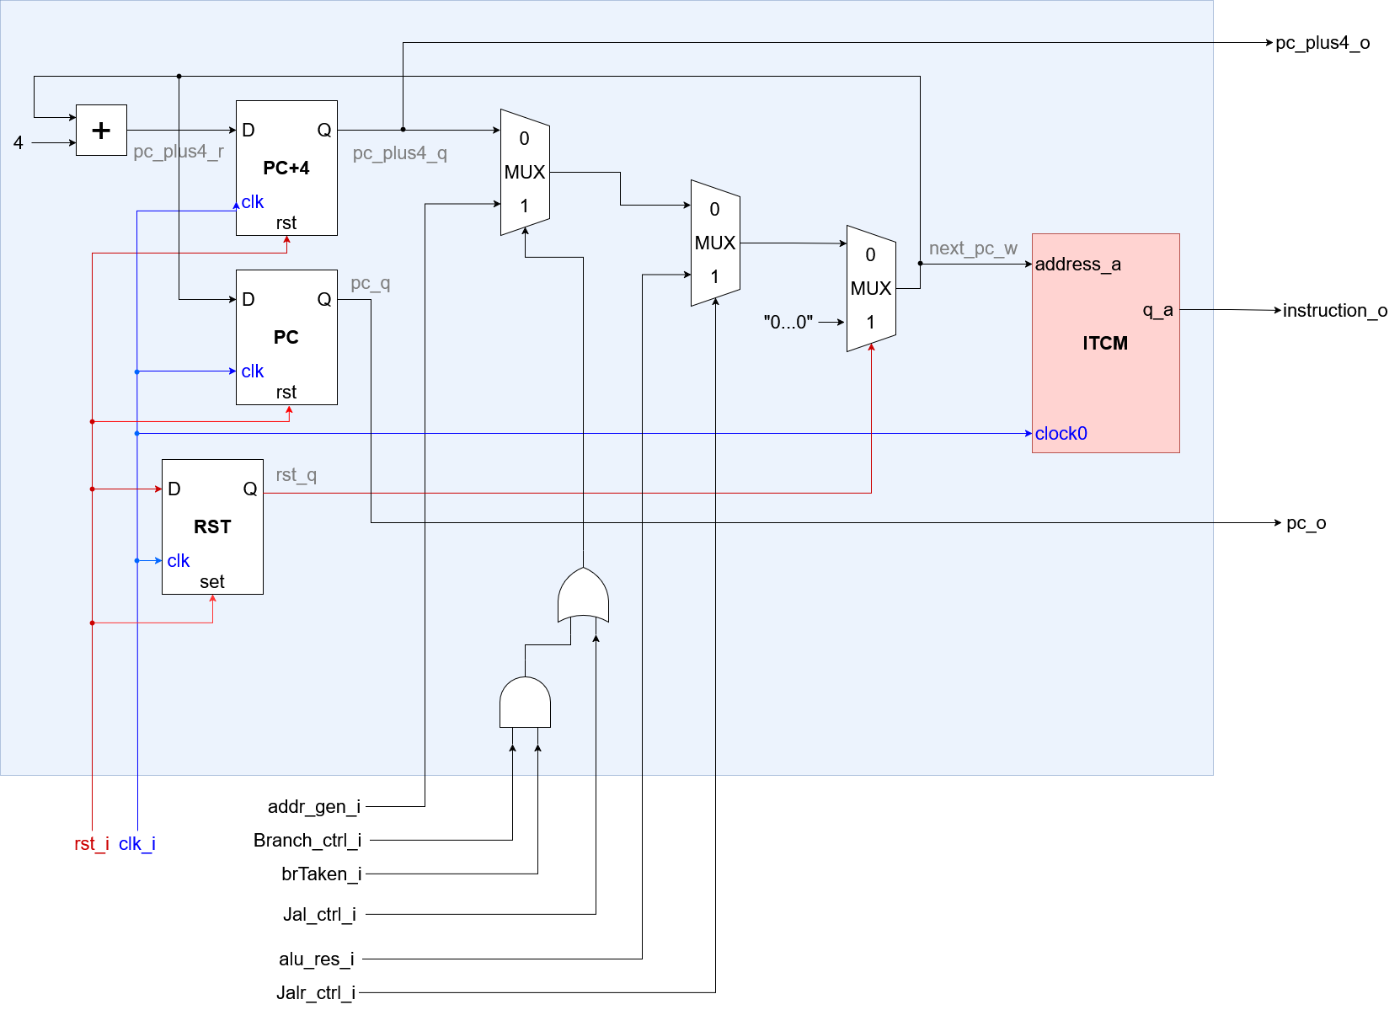
Auxiliary/Lab 5/Auxilary/RV32I/DOC/IFETCH rtl.png
