Adar-Shapira/rv32im-mcu-project/Auxiliary/Lab 5/Auxilary/RV32I/DOC/RV32I uArc.png

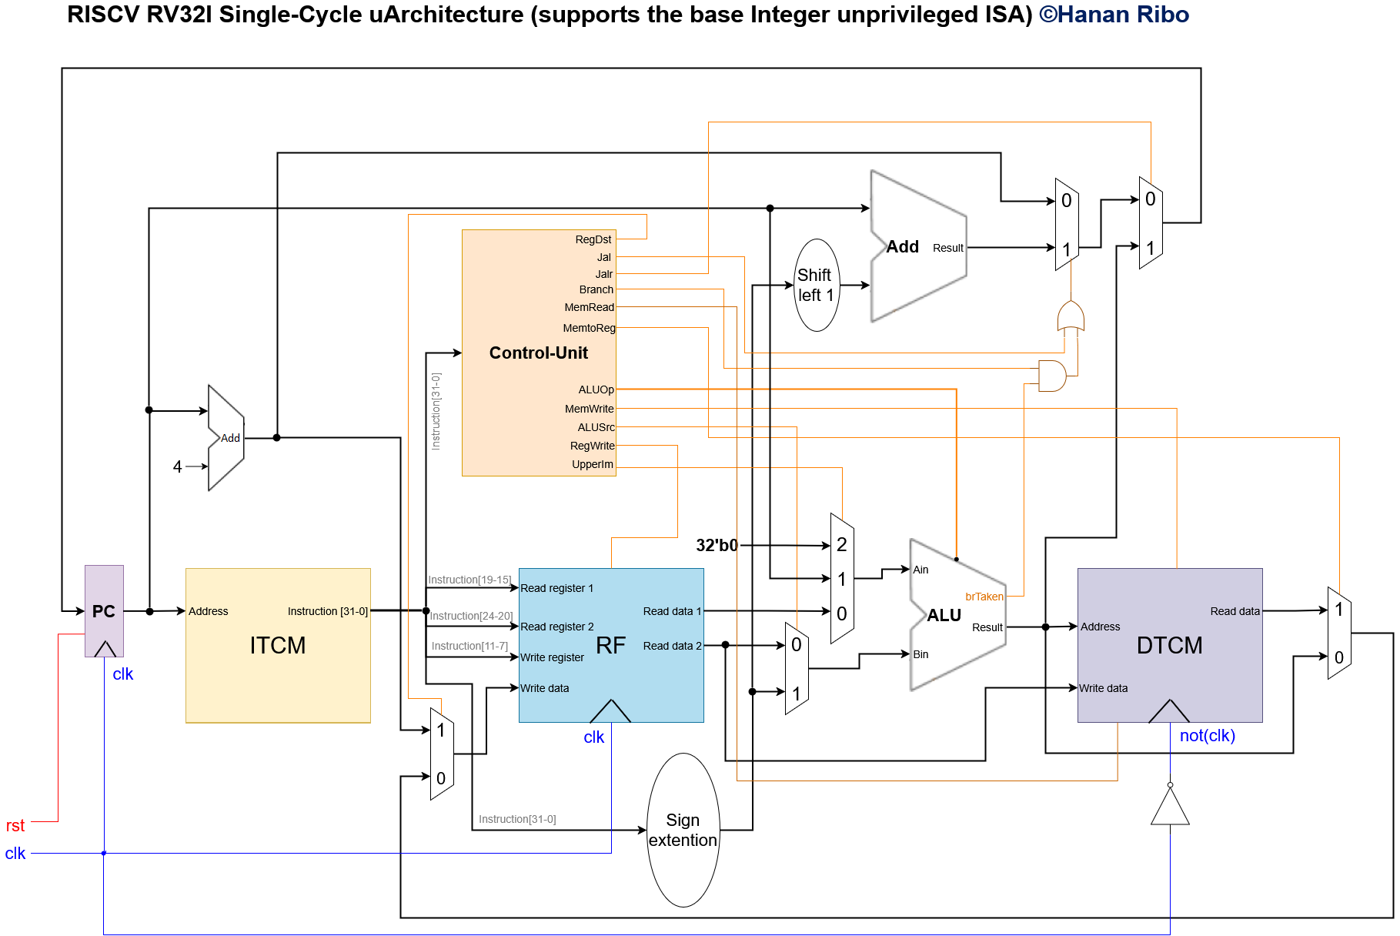
Auxiliary/Lab 5/Auxilary/RV32I/DOC/RV32I uArc.png
