Adar-Shapira/rv32im-mcu-project/Auxiliary/Lab 5/Screenshots/Quartus/Pipeline/area.png

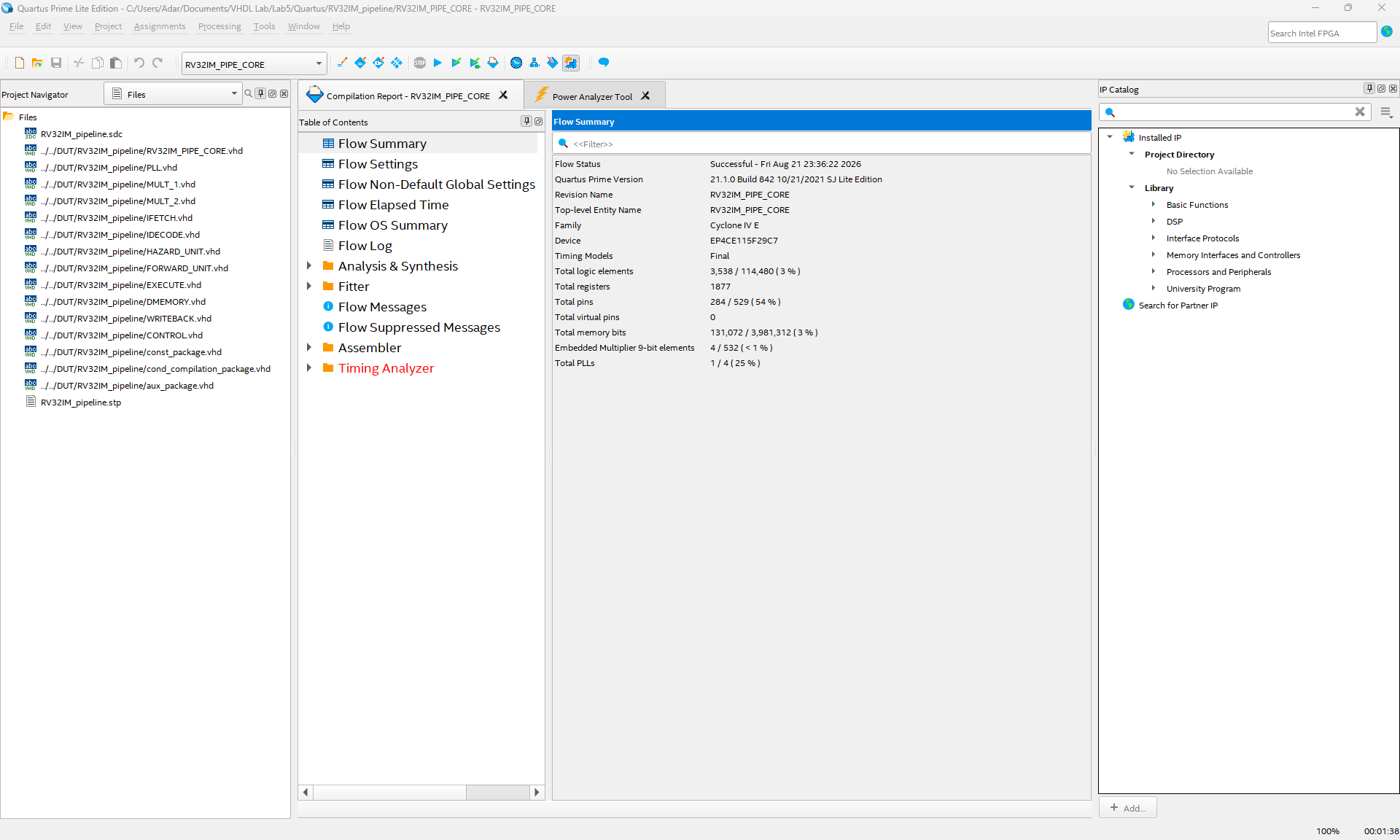
Auxiliary/Lab 5/Screenshots/Quartus/Pipeline/area.png
