Adar-Shapira/rv32im-mcu-project/Auxiliary/Lab 5/Screenshots/Quartus/Pipeline/rtl_mul1_in.png

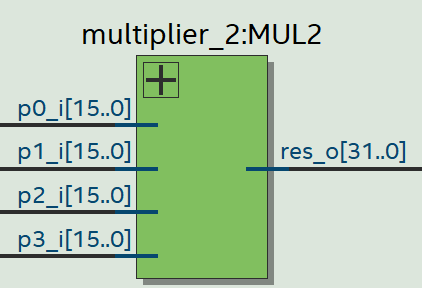
Auxiliary/Lab 5/Screenshots/Quartus/Pipeline/rtl_mul1_in.png
