Adar-Shapira/rv32im-mcu-project/Auxiliary/Lab 5/Screenshots/Quartus/SC/area.png

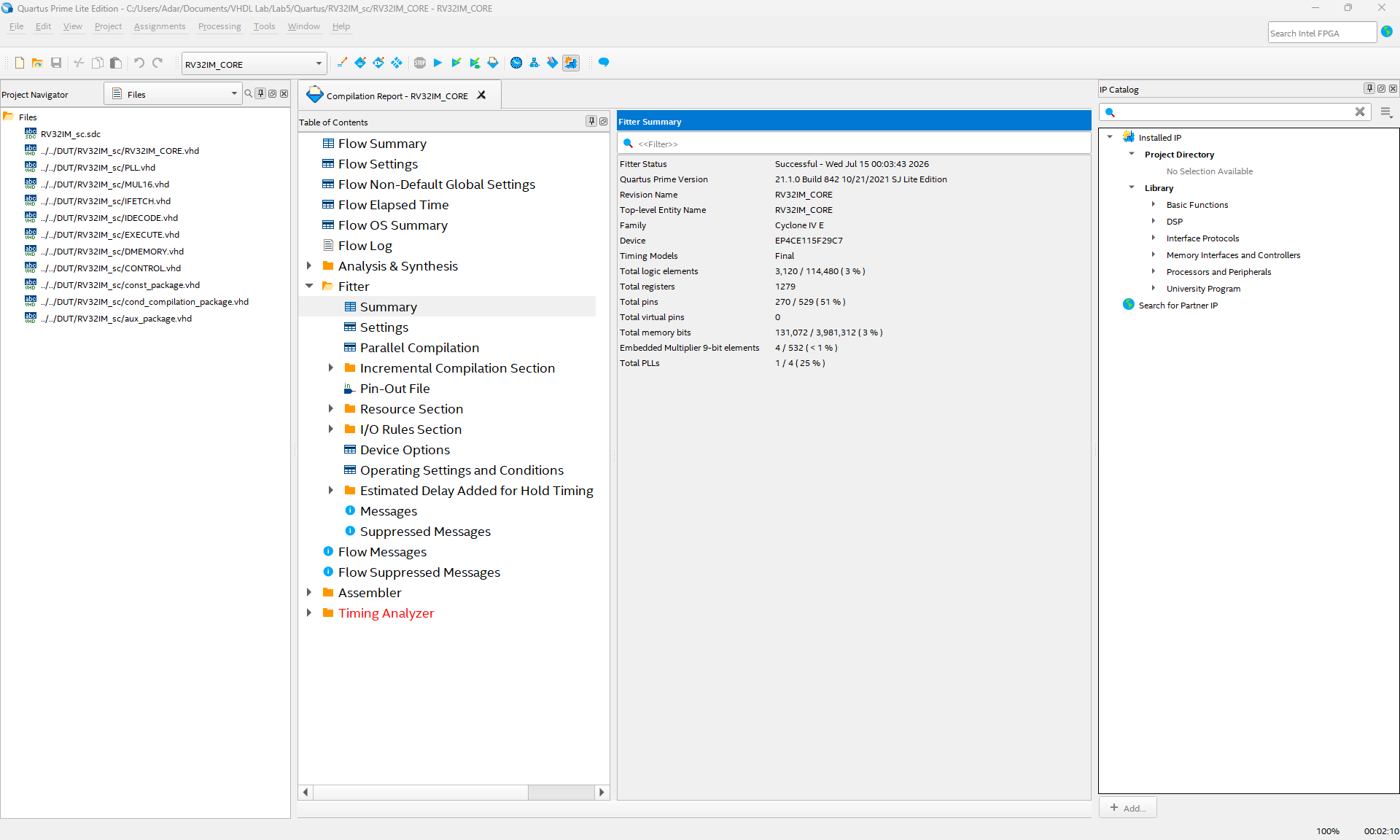
Auxiliary/Lab 5/Screenshots/Quartus/SC/area.png
