Adar-Shapira/rv32im-mcu-project/Auxiliary/Lab 5/Screenshots/Quartus/SC/critical_path.png

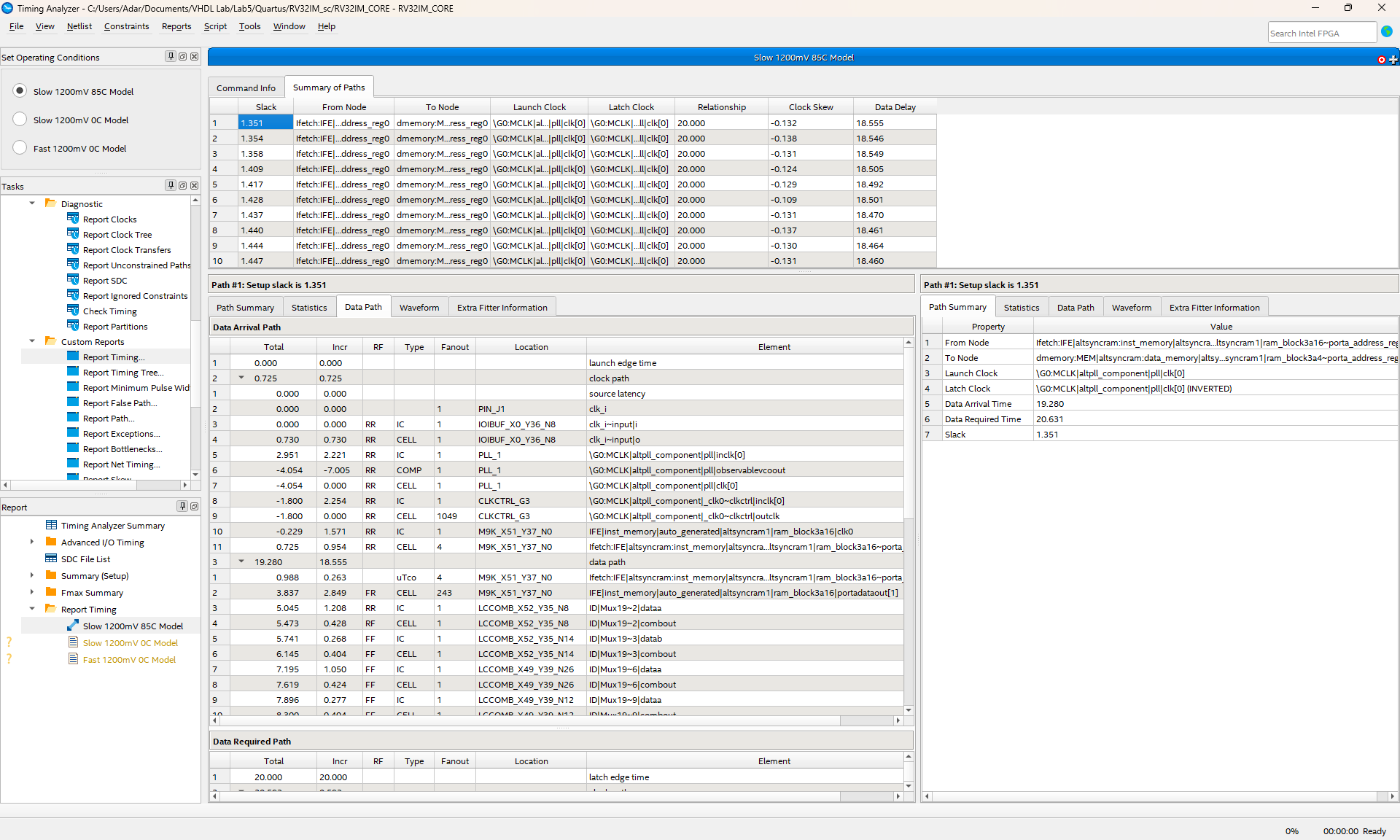
Auxiliary/Lab 5/Screenshots/Quartus/SC/critical_path.png
