Adar-Shapira/rv32im-mcu-project/Auxiliary/Lab 5/Screenshots/Quartus/SC/ffmax.png

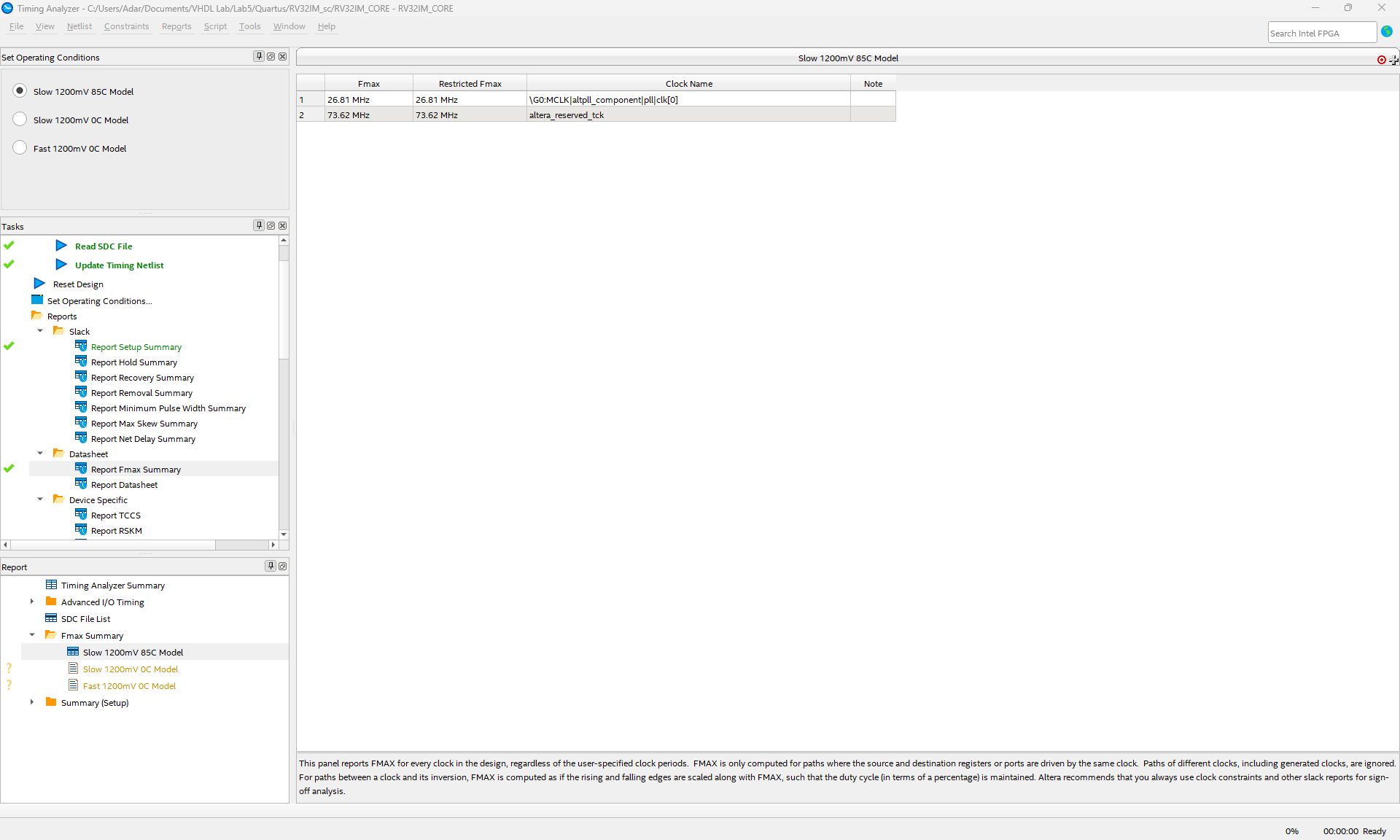
Auxiliary/Lab 5/Screenshots/Quartus/SC/ffmax.png
