Adar-Shapira/rv32im-mcu-project/Auxiliary/Lab 5/Screenshots/Quartus/SC/power.png

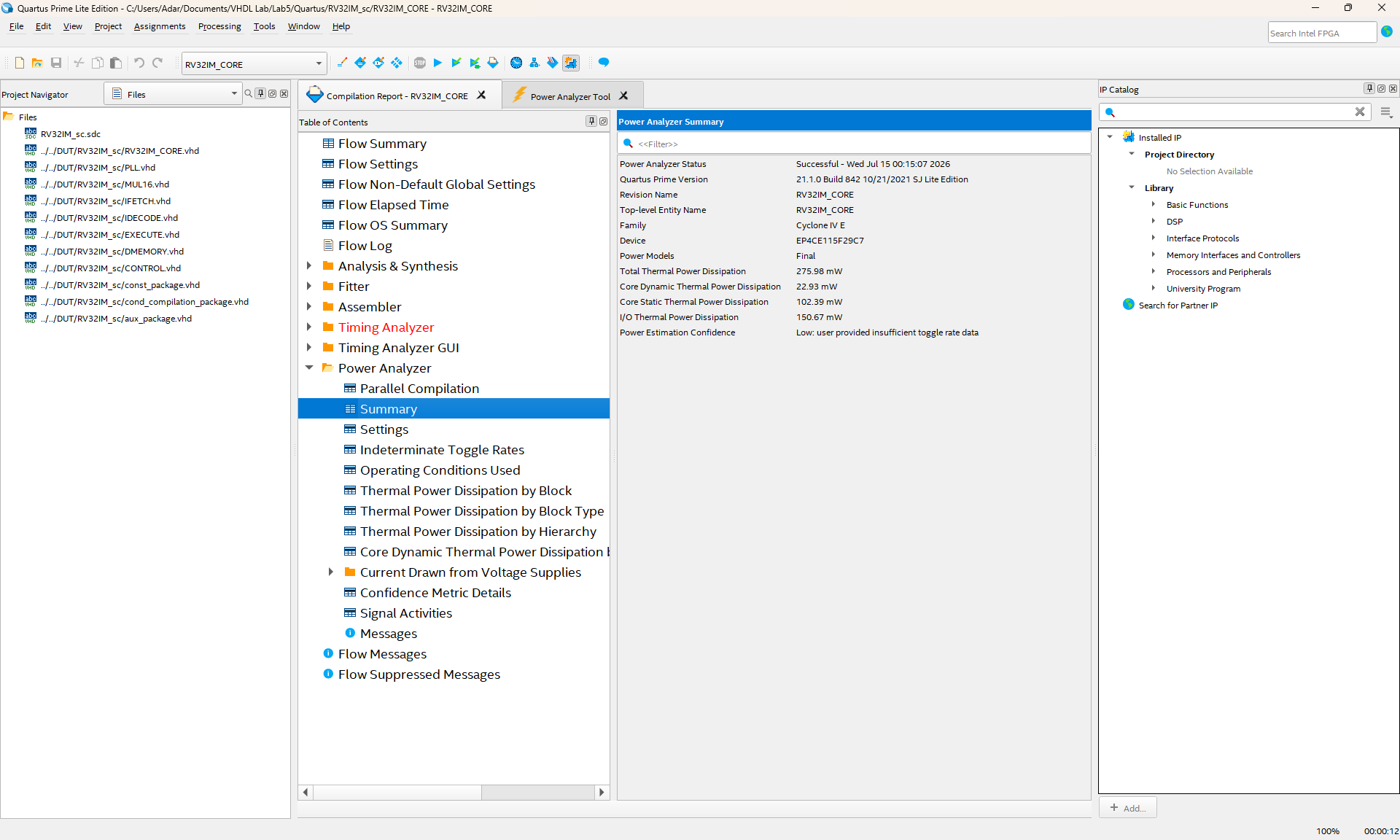
Auxiliary/Lab 5/Screenshots/Quartus/SC/power.png
