Adar-Shapira/rv32im-mcu-project/Auxiliary/Lab 5/Screenshots/Quartus/SC/rtl_mul16.png

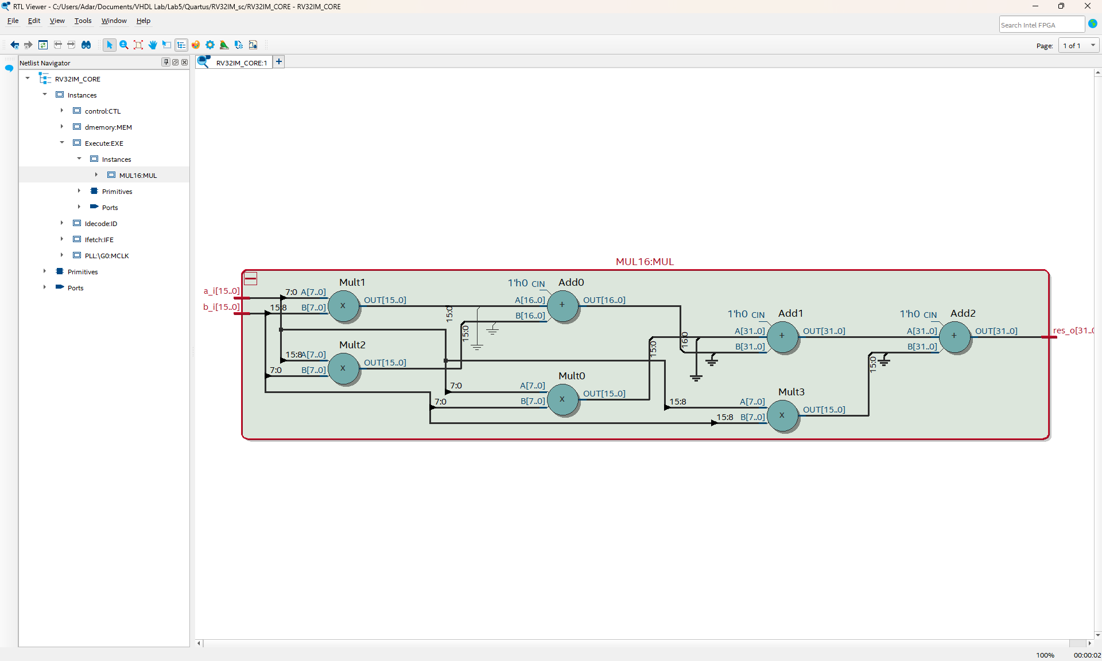
Auxiliary/Lab 5/Screenshots/Quartus/SC/rtl_mul16.png
