Adar-Shapira/rv32im-mcu-project/Auxiliary/Lab 5/Screenshots/Quartus/SC/rtl_top.png

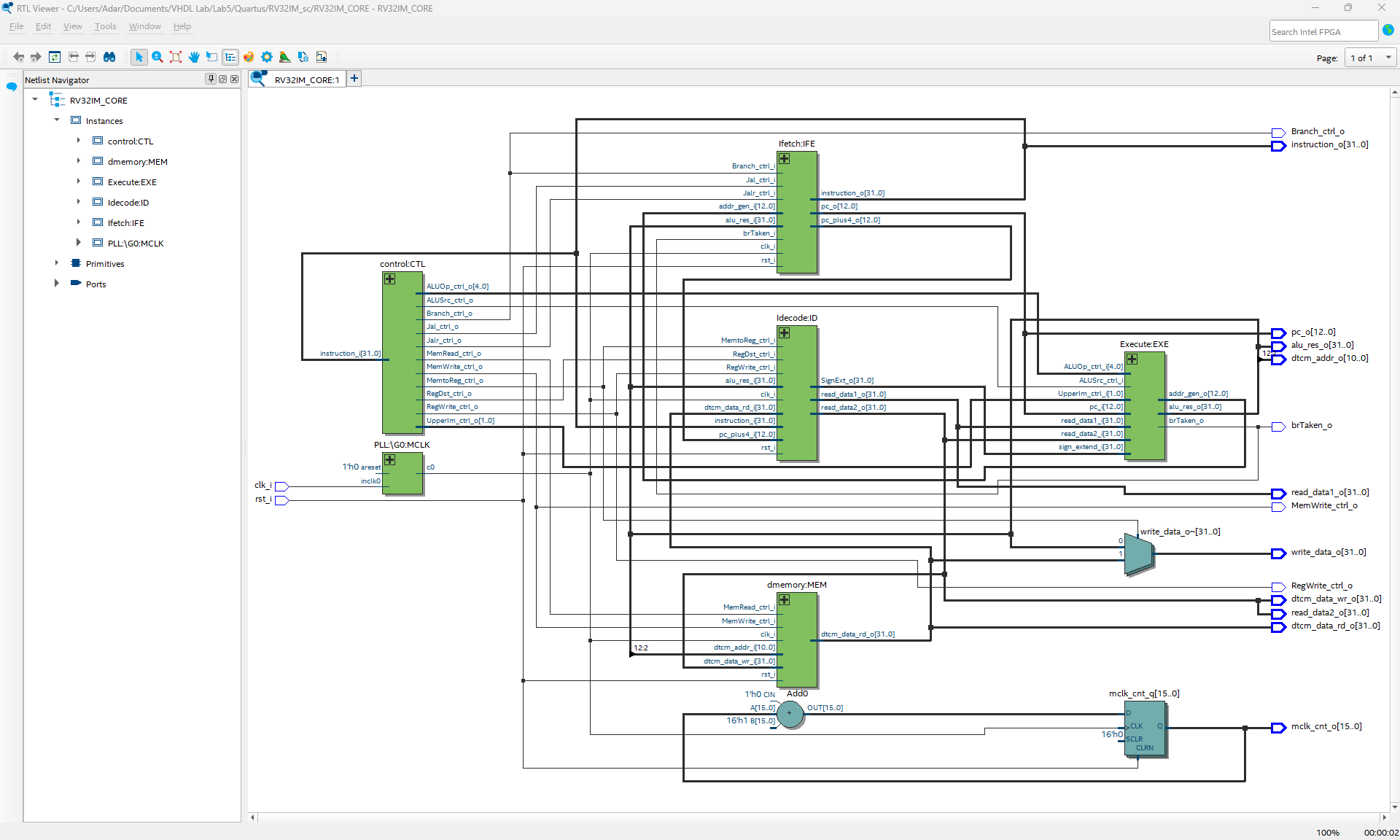
Auxiliary/Lab 5/Screenshots/Quartus/SC/rtl_top.png
