Adar-Shapira/rv32im-mcu-project/Screenshots/Basic Timer with output comparing capabilities.png

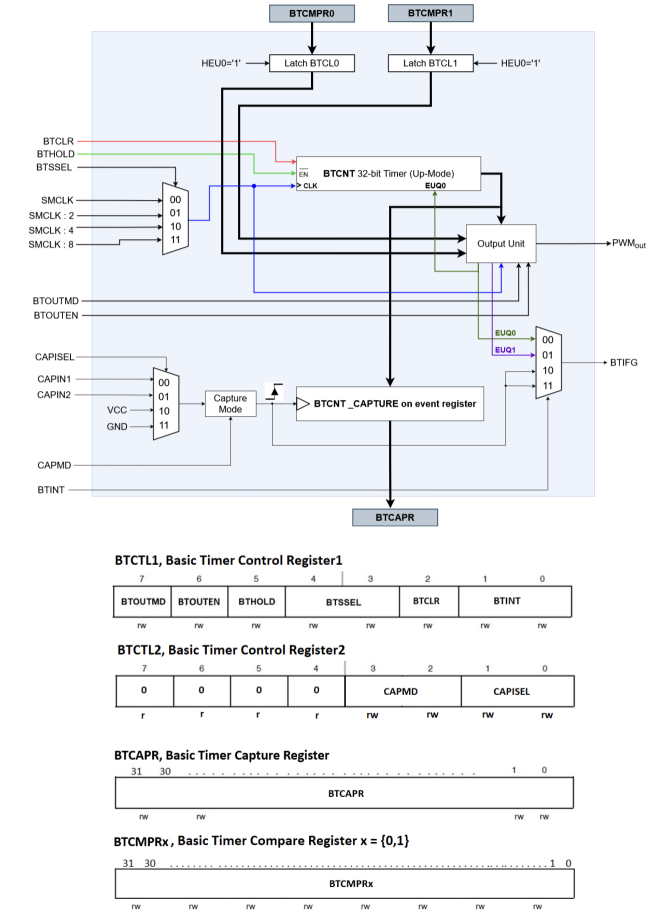
Screenshots/Basic Timer with output comparing capabilities.png
