Adar-Shapira/rv32im-mcu-project/Screenshots/CDC (clock domain crossing) synchronizer.png

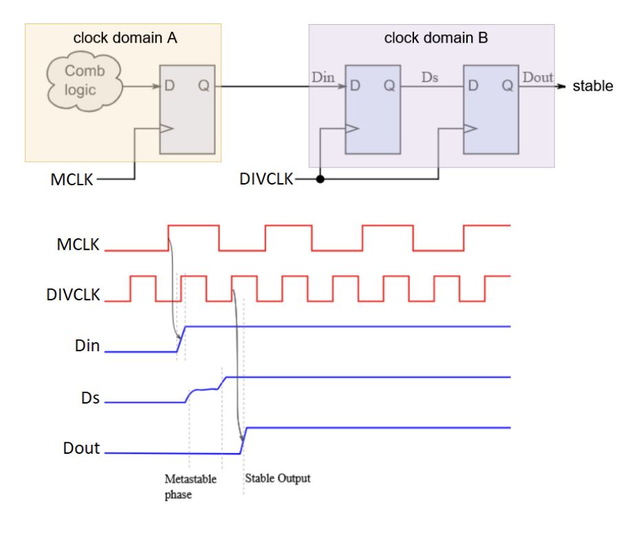
Screenshots/CDC (clock domain crossing) synchronizer.png
