Adar-Shapira/rv32im-mcu-project/Screenshots/Handling an interrupt from a single source.png

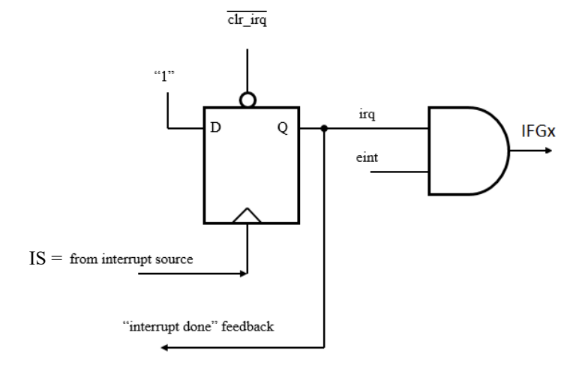
Screenshots/Handling an interrupt from a single source.png
