Adar-Shapira/rv32im-mcu-project/Screenshots/Handling interrupts from several sources.png

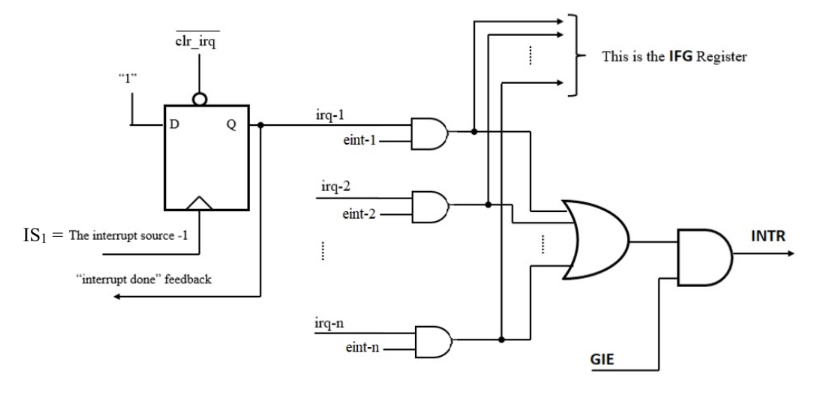
Screenshots/Handling interrupts from several sources.png
