Adar-Shapira/rv32im-mcu-project/Screenshots/Interrupt controller.png

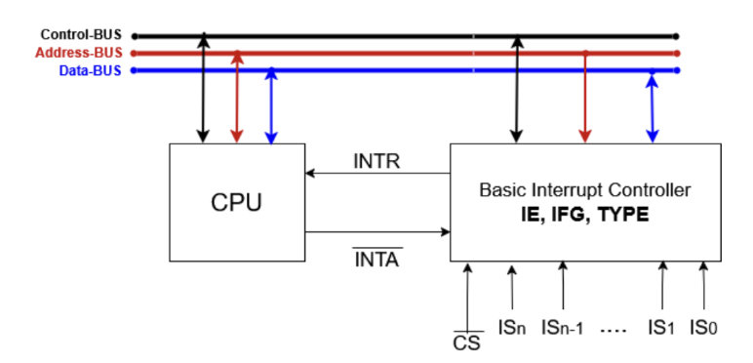
Screenshots/Interrupt controller.png
