Adar-Shapira/rv32im-mcu-project/Screenshots/MCU System General Architecture.png

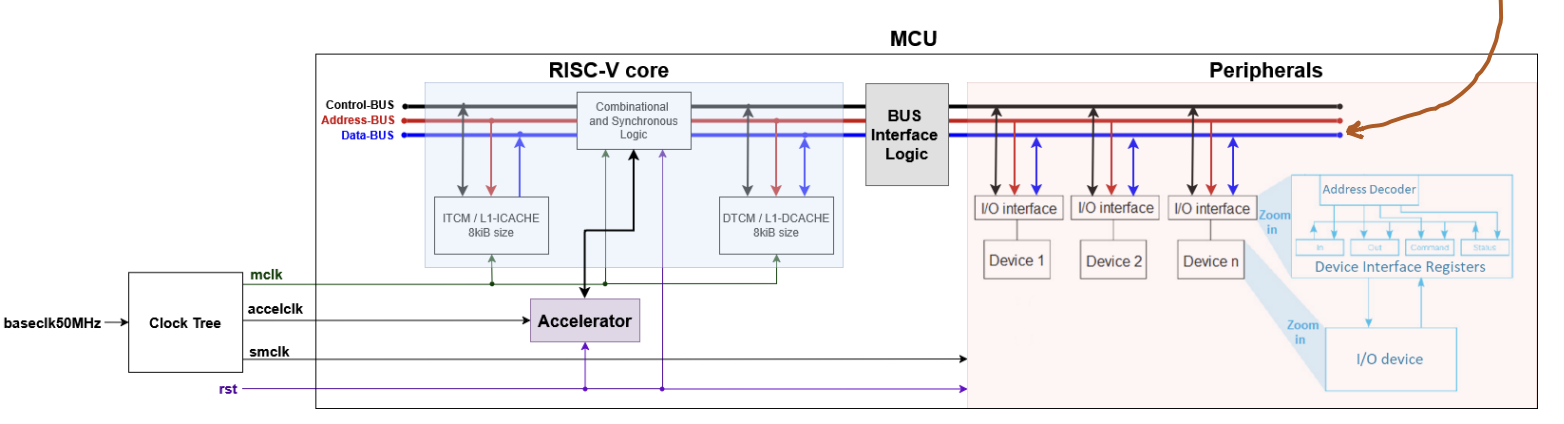
Screenshots/MCU System General Architecture.png
