Adar-Shapira/rv32im-mcu-project/Screenshots/Multicycle-based architecture of Unsigned Divisor accelerator 2.png

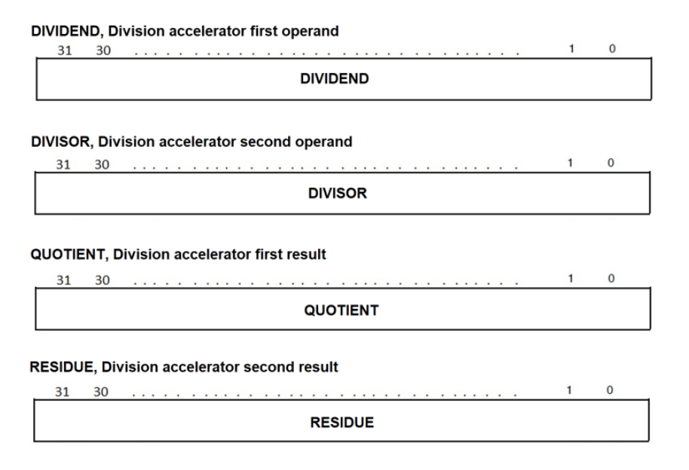
Screenshots/Multicycle-based architecture of Unsigned Divisor accelerator 2.png
