Adar-Shapira/rv32im-mcu-project/Screenshots/Multicycle-based architecture of Unsigned Divisor accelerator.png

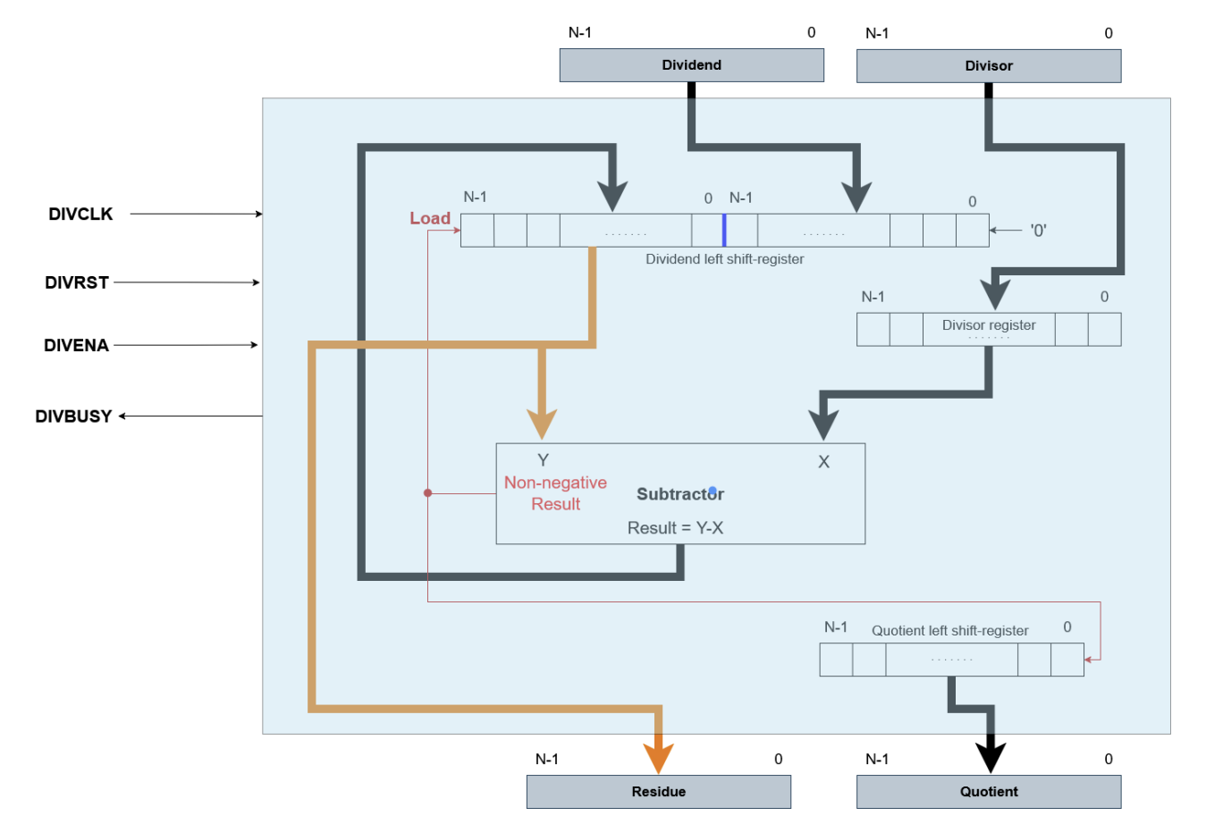
Screenshots/Multicycle-based architecture of Unsigned Divisor accelerator.png
