Adar-Shapira/rv32im-mcu-project/Screenshots/Output compare mode of PWM signals producing.png

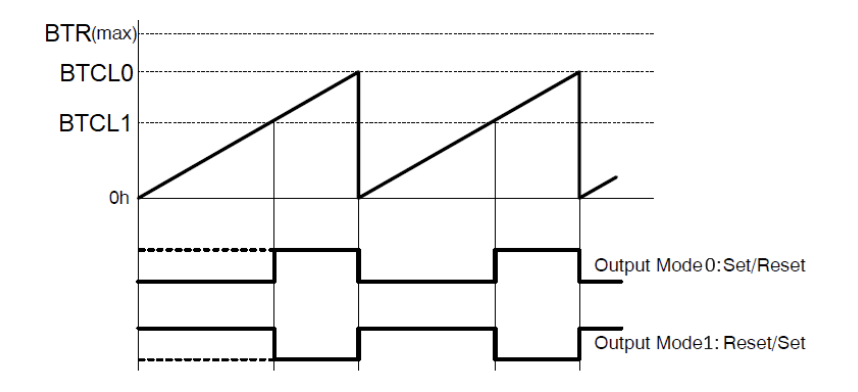
Screenshots/Output compare mode of PWM signals producing.png
