Adar-Shapira/rv32im-mcu-project/Screenshots/Pushbuttons hardware connection and debouncing.png

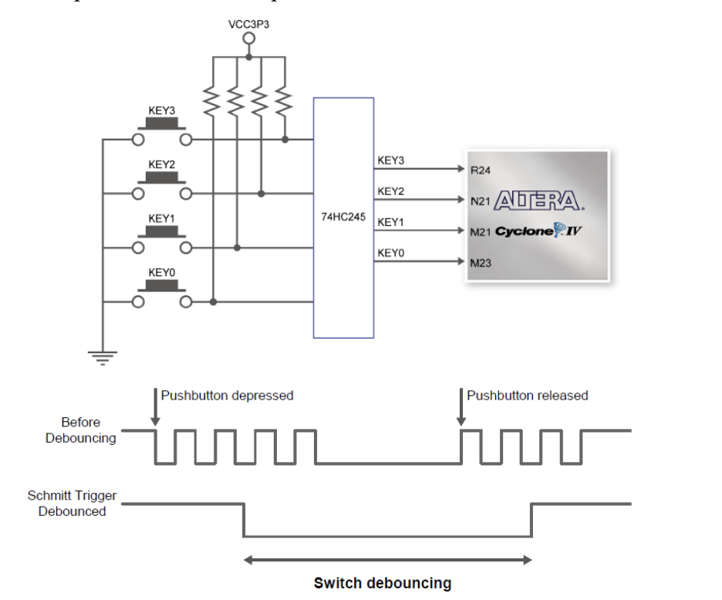
Screenshots/Pushbuttons hardware connection and debouncing.png
