Adar-Shapira/rv32im-mcu-project/Screenshots/Quartus/MCU_with_GPIO/critical_path.png

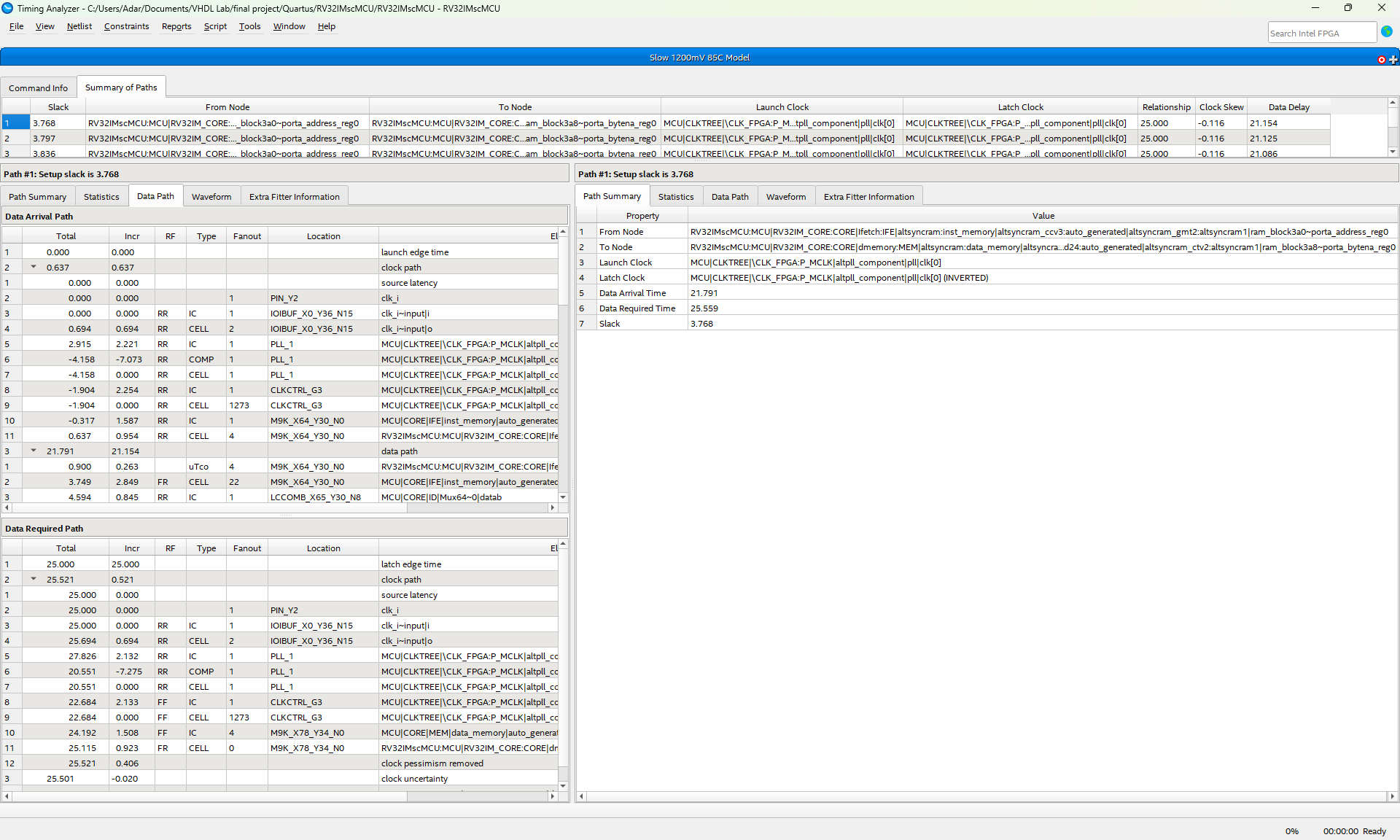
Screenshots/Quartus/MCU_with_GPIO/critical_path.png
