Adar-Shapira/rv32im-mcu-project/Screenshots/Quartus/MCU_with_GPIO/fitter.png

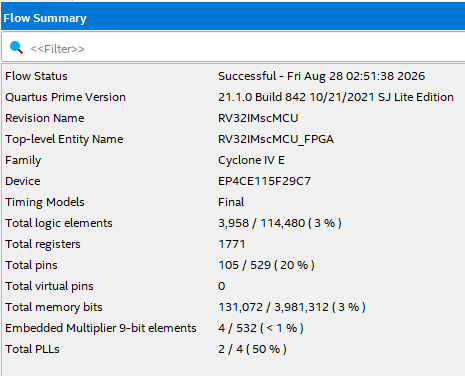
Screenshots/Quartus/MCU_with_GPIO/fitter.png
