Adar-Shapira/rv32im-mcu-project/Screenshots/Quartus/MCU_with_GPIO/power.png

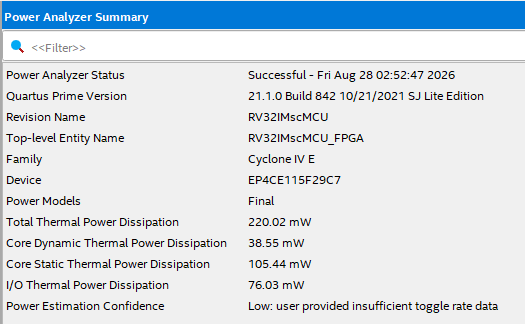
Screenshots/Quartus/MCU_with_GPIO/power.png
