Adar-Shapira/rv32im-mcu-project/Screenshots/Quartus/MCU_with_GPIO/rtl_mcu.png

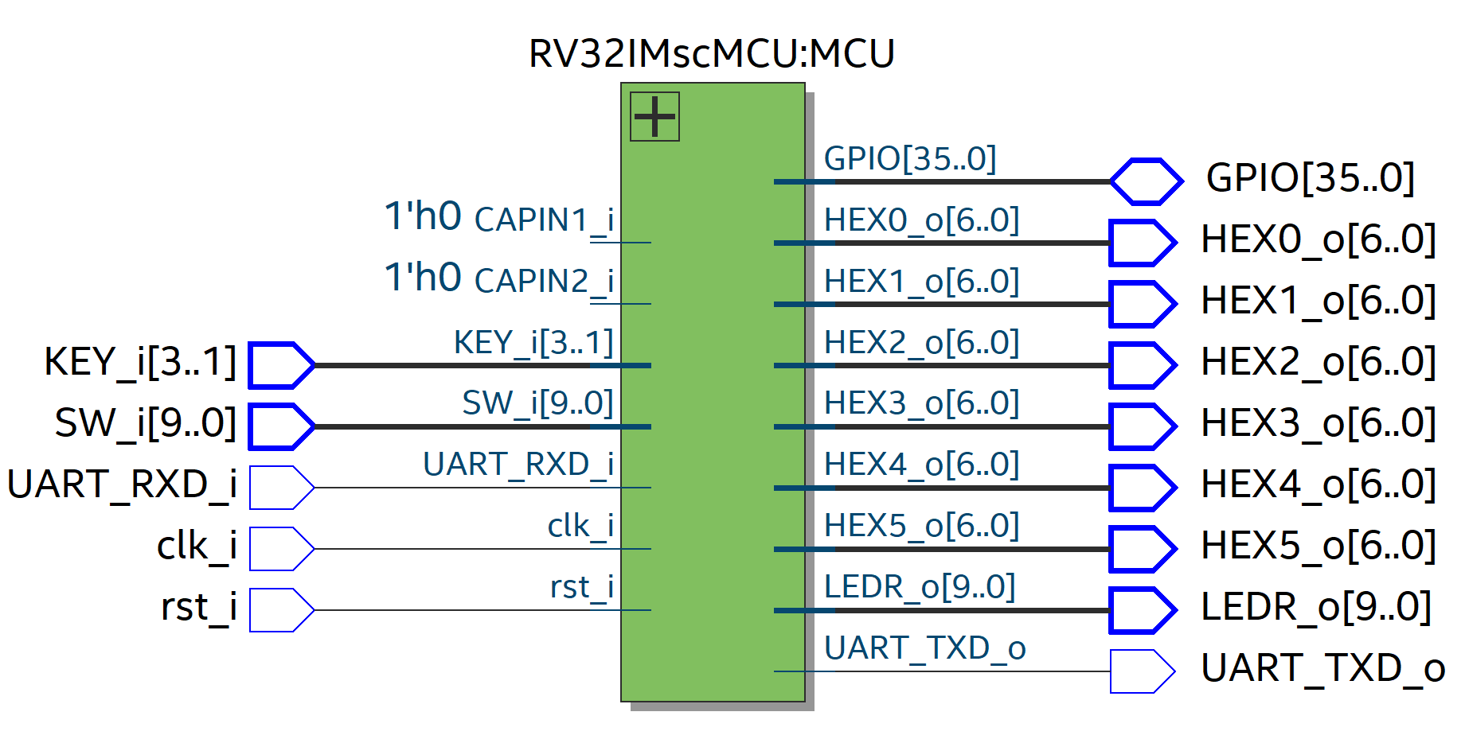
Screenshots/Quartus/MCU_with_GPIO/rtl_mcu.png
