Adar-Shapira/rv32im-mcu-project/Screenshots/Quartus/MCU_with_GPIO_and_Interrupt_Capability/fitter.png

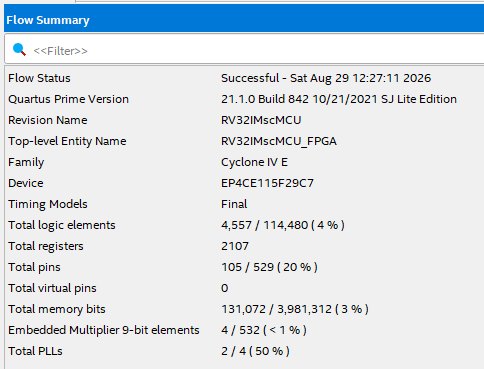
Screenshots/Quartus/MCU_with_GPIO_and_Interrupt_Capability/fitter.png
