Adar-Shapira/rv32im-mcu-project/Screenshots/Quartus/MCU_with_GPIO_and_Interrupt_Capability/power.png

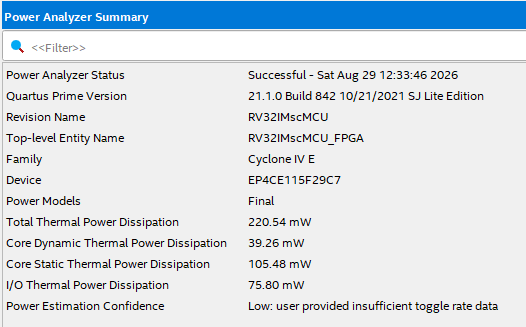
Screenshots/Quartus/MCU_with_GPIO_and_Interrupt_Capability/power.png
