Adar-Shapira/rv32im-mcu-project/Screenshots/Quartus/Pipelined_MCU_with_GPIO_and_Interrupt_Capability/rtl_data_memory.png

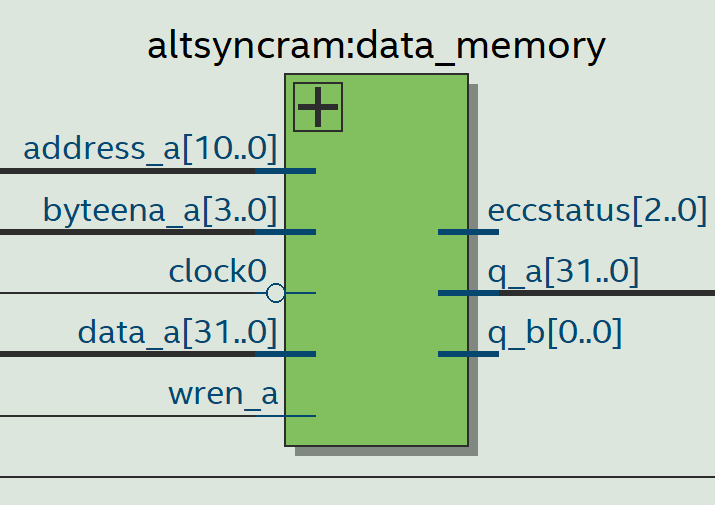
Screenshots/Quartus/Pipelined_MCU_with_GPIO_and_Interrupt_Capability/rtl_data_memory.png
