Adar-Shapira/rv32im-mcu-project/Screenshots/RV32IM single-cycle core connected to a divider accelerator.png

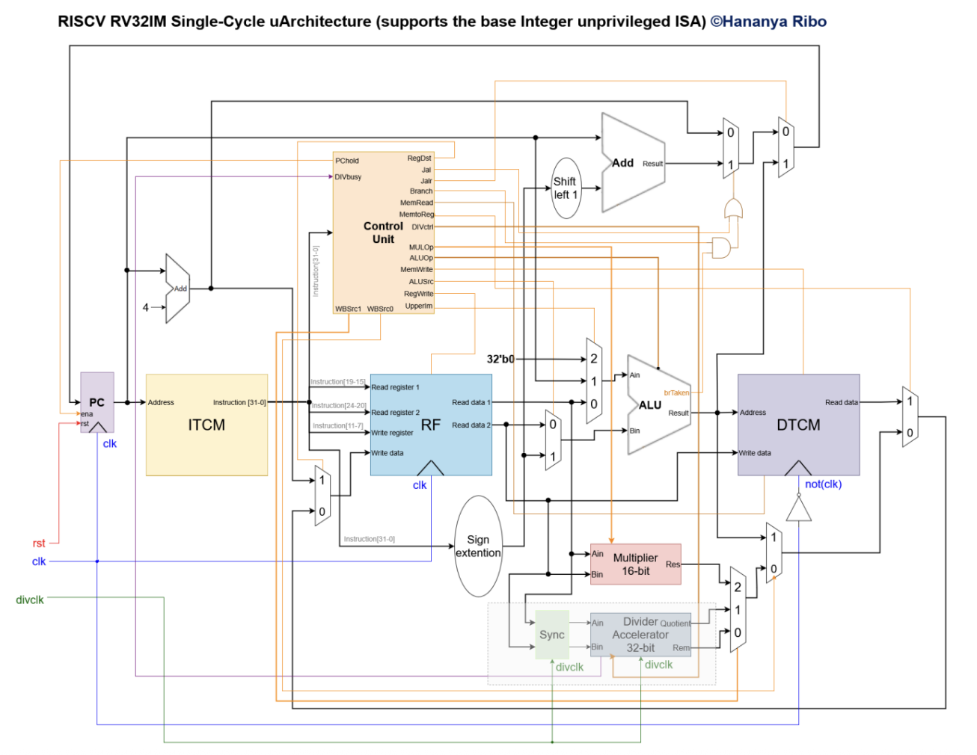
Screenshots/RV32IM single-cycle core connected to a divider accelerator.png
