Adar-Shapira/rv32im-mcu-project/Screenshots/The synchronizer architecture.png

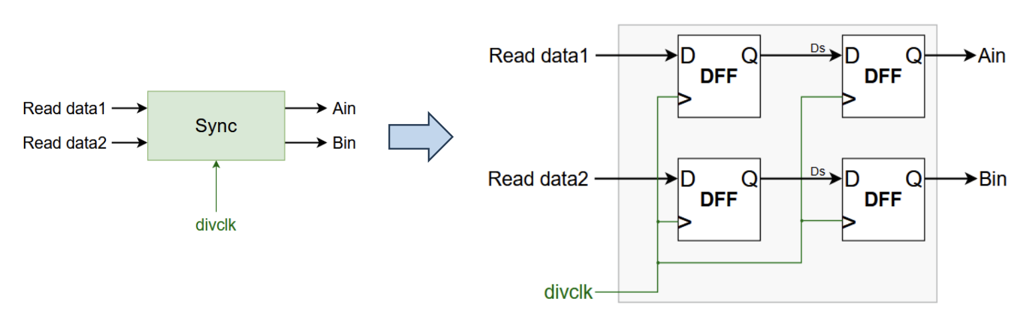
Screenshots/The synchronizer architecture.png
