Adar-Shapira/rv32im-mcu-project/Screenshots/UART module functional diagram.png

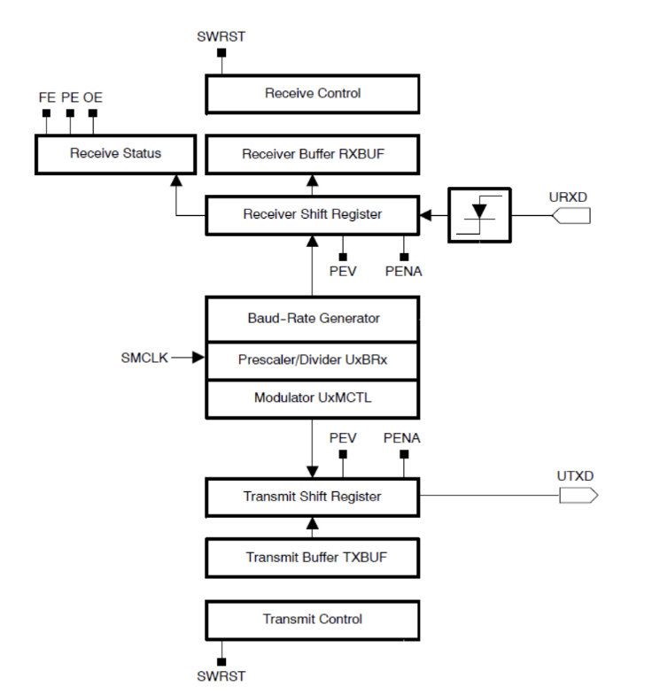
Screenshots/UART module functional diagram.png
