Adar-Shapira/rv32im-mcu-project/DOC/01_source_inventory.md

# Deliverable A — Source and Reuse Inventory

Step 1 of the RV32IM MCU final project. Answers one question for every component the project needs:
**does supplied code already exist, and if so may we use it?**

Nothing in this document changes any file. Every path was opened and verified.

---

## 1. Provenance of the reference tree

`Auxiliary/` holds four distinct kinds of material that must not be conflated.

| Provenance | Where | How it is identified |
| --- | --- | --- |
| **Hanan Ribo (lecturer)** | `Auxiliary/Lab 5/Auxilary/RV32I/{DUT,TB,SIM,QUARTUS}/`, the PDFs at that level, `Auxilary/Benchmarks/test1`–`test4/`, `Auxiliary/Benchmark Apps/`, `Auxiliary/Final Project 2026 definition.pdf` | Ten files carry `-- Copyright 20xx Hananya Ribo` on line 2. That header is the only authorship marker in the tree. |
| **The students, earlier labs** | `Auxiliary/Lab 5/Auxilary/Lab3/`, `Auxiliary/Lab4/` | `Lab4/DOC/readme.txt:2-3` is signed "Adar Shapira 209580208 / Yehonatan Dadkha 211468582". `Lab3/DOC/pre3.pdf` is a Hebrew pre-lab report by the same authors. |
| **The students, Lab 5** | `Auxiliary/Lab 5/{DUT,TB,SIM,Quartus}/`, `Auxiliary/Lab 5 - as submitted/` | Derived from the lecturer baseline; `DOC/readme.txt` in the submitted tree is signed by the same authors. |
| **Third party** | `Auxiliary/USART Material/UART_FPGA_option{1,2}/`, every `PLL.vhd` | `UART_FPGA_option1/LICENSE` is MIT, `Copyright (c) 2015 Jakub Cabal`. Option 2 carries no licence at all. `PLL.vhd` line 15: `-- THIS IS A WIZARD-GENERATED FILE. DO NOT EDIT THIS FILE!` |
| **Hanan Ribo — added 2026-08-25/27** | `Auxiliary/מבנה הצגה ובדיקת פרויקט מסכם.pdf` **and** its `.md` extraction (the project inspection/presentation protocol), `Auxiliary/hanan/` (50 lecture-note files: the full course material — VHDL, architecture, verification, ISMCE validation, the lab syllabus) | Course-official material. **Read the PDF, not the `.md`** — the extraction is garbled (Hebrew stored character-reversed, column order scrambled) and a reconstruction from it got three details wrong, including a technical requirement. The PDF was added 2026-08-27 and `DOC/04` §9 was rewritten against it. `hanan/` is lecture material: `Useful name extensions.md` is the source of this project's `_i`/`_o`/`_w`/`_q`/`_r`/`_v` convention, which every file follows. |

**`Auxilary/` (one `i`) is a mixed folder.** It is Hanan's Lab 5 distribution *plus* two student
archives dropped inside it. A tree-wide grep for the student identifiers over all of `Auxilary/`
returns exactly two hits, both in `Lab4/DOC/readme.txt:2-3`; the copyright grep returns ten, all in
`Auxilary/DUT/` and `Auxilary/TB/`. `QUARTUS/pinPlanner/DE2-115_pinLocation.txt` is also student
work — it references the `RSTPOL` generate, which does not exist in the lecturer baseline.

### What Hanan actually supplied as code

Twelve source files. The baseline is a **single-cycle RV32I core only**: no multiplier, no pipeline,
no debug instrumentation. Verified by full recursive listing plus a grep for
`STCNT|FHCNT|BPADDR|BPTRIGGER` over `Auxilary/{DUT,TB,SIM,QUARTUS}`, which matched only the
student-written pin note.

| File | Role |
| --- | --- |
| `Auxilary/DUT/RV32I_CORE.vhd` | Structural single-cycle top: `IFE`/`ID`/`CTL`/`EXE`/`MEM`, a conditional PLL, and the `mclk_cnt_q` counter |
| `Auxilary/DUT/CONTROL.VHD` | Combinational RV32I decoder; per-instruction detectors ANDed against `INST_*_MASK`, driving a 5-bit `ALUOp` priority chain |
| `Auxilary/DUT/IDECODE.VHD` | 32×32 register file, field extraction, I/S/SB/U/UJ immediate generation, write-back mux |
| `Auxilary/DUT/EXECUTE.VHD` | ALU, a 4-stage unrolled barrel shifter, the six branch comparators, branch-address adder |
| `Auxilary/DUT/IFETCH.VHD` | PC, PC+4, next-PC mux tree, reset-hold flop, `altsyncram` ITCM |
| `Auxilary/DUT/DMEMORY.VHD` | DTCM wrapper — one `altsyncram` clocked on `not(clk)` |
| `Auxilary/DUT/const_package.vhd` | Immediate pads, opcode-type constants, 18 `ALU_*` opcodes, 60+ `INST_*`/`INST_*_MASK` pairs already covering the **entire M extension**, CSR, fence and privileged instructions |
| `Auxilary/DUT/cond_compilation_package.vhd` | The eight `G_*` knobs every entity's generics default to |
| `Auxilary/DUT/aux_package.vhd` | Component declarations |
| `Auxilary/DUT/PLL.vhd` | ALTPLL MegaWizard output (third-party generated) |
| `Auxilary/TB/tb_RV32I.vhd` | Testbench — no assertions, no `report`, no memory dump, no stop condition |
| `Auxilary/SIM/RV32I.do` | Wave configuration only; no compile or run automation |

Consequence: the entity names the submission mandates (`RV32IM_CORE`, `RV32IM_PIPE_CORE`) do not
exist in the baseline — its top is `RV32I_CORE`. Every one of them is student-created.

---

## 2. The component inventory

Verdicts: **use as is** = drop in unchanged; **adapt** = start from it, changes required;
**reference only** = read for understanding, write our own; **write new** = nothing exists.

### 2.1 CPU core and ISA

| Component | Requirement | Supplied | Path | Provenance | Verdict |
| --- | --- | --- | --- | --- | --- |
| Single-cycle RV32IM core | §3 | yes | `Auxiliary/Lab 5/DUT/RV32IM_sc/` (11 files) | students, Lab 5 | **adapt** — **seven** ISA defects (§2.2), no `div`/`rem`/`mulh*`, no sub-word access |
| RV32I baseline | — | yes | `Auxilary/RV32I/DUT/` (10 files; the folder was restructured on 2026-08-23) | **Hanan** | **reference** — the provenance authority: it carries six of the seven defects itself |
| 5-stage pipeline core | bonus 10% | yes | `Auxiliary/Lab 5/DUT/RV32IM_pipeline/` (13 files) | students, Lab 5 | **adapt** — a rewrite, not a derivative |
| Hazard / forward units | bonus 10% | yes | `RV32IM_pipeline/HAZARD_UNIT.vhd`, `FORWARD_UNIT.vhd` | students, Lab 5 | **adapt** — must gain divider and memory stalls |
| 16×16 multiplier | §6.iii, LAB5 Fig 6 | yes | `RV32IM_sc/MUL16.vhd` (86 lines) | students, Lab 5 | **adapt** — see 2.6 |
| Instruction masks for the whole M extension | §2 | yes | `const_package.vhd:243-273` | **Hanan** | **use as is** — `INST_MUL`, `MULH`, `MULHSU`, `MULHU`, `DIV`, `DIVU`, `REM`, `REMU` and their masks all already present |
| Barrel shifter | §2 | yes | `Auxiliary/Lab4/DUT/Shifter.vhd` | students, Lab 4 | **reference** — generic n-bit structural MUX matrix; candidate `sra` repair |
| Register file | §3 | yes | `IDECODE.vhd` (32×32) | Hanan | **use as is** |
| — | — | yes | `Auxilary/Lab3/DUT/RF.vhd` (16×16) | students, Lab 3 | **reference only** — wrong width |
| `div`/`divu`/`rem`/`remu`, `mulh*` | §2 | **no** | — | — | **write new** |
| Byte enables, sub-word load/store | §2 | **no** | — | — | **write new** — see 2.6 |

### 2.2 The seven ISA defects — provenance re-derived

> **REVISED 2026-08-23.** This section said *five* defects and said the other four would have to be
> designed by us. Both claims are now out of date. The reference folder was replaced with the real
> final Lab 5 submission, and **the pipelined core in it repairs all seven** — it was submitted and
> hardware-validated that way. So every repair is a transcription from a sibling core in the same
> submission, not a design of ours. Two further defects surfaced from reading the revised reference,
> numbered 6 and 7 below.
>
> All seven are now repaired in `DUT/RV32IMscMCU/` — unconditionally since 2026-08-26, when the
> `G_ISA_REPAIR` switch was retired (Adar, commit `1d16fe2`) after the before/after measurements
> were taken. See the plan file §0.a and Phase 3A.

Each file diffed against the baseline with comments and whitespace stripped.

| # | Defect | Site in `RV32IM_sc` | Origin |
| --- | --- | --- | --- |
| 1 | `andi` writes 0; `ori` computes AND | `CONTROL.vhd:142` | **Student regression.** Baseline `Auxilary/DUT/CONTROL.VHD:141` is correct: `ALU_AND WHEN and_w or andi_w ELSE`. `ori_w` then appears twice in one conditional chain, so the earlier `ALU_AND` arm wins. |
| 2 | `lui` writes 0 | `const_package.vhd:27` | **Lecturer's baseline.** `Auxilary/DUT/const_package.vhd:27` is identical: `UTYPE_OPC := "0010111" and "0110111"`, which evaluates to `"0010111"` — `auipc` only. `IDECODE` uses it as an exact `select` choice, so `lui`'s `"0110111"` matches nothing. |
| 3 | Every load addresses `rs1 + 0` | `IDECODE.vhd:97-104` | **Lecturer's baseline.** `Auxilary/DUT/IDECODE.VHD:94-101` is the identical `with opc_w select` with six arms and no LOAD (`0000011`) arm, so the immediate falls to `(others => '0')`. |
| 4 | `sra` ≡ `srl` | `EXECUTE.vhd:200` | **Lecturer's baseline.** `Auxilary/DUT/EXECUTE.VHD:179` is identical: `brl_shr_pad_r <= 32x"FFFF"`, which in VHDL-2008 is `0x0000FFFF`, so bit 31 is `'0'`. Only `brl_shr_pad_r(31 DOWNTO 16)` is ever read (line 214), so the sign never propagates. |
| 5 | `sltu`/`sltiu`/`bltu`/`bgeu` compare signed | `EXECUTE.vhd:10` | **Lecturer's baseline.** `Auxilary/DUT/EXECUTE.VHD:9` is identical: `USE IEEE.STD_LOGIC_SIGNED.ALL`, which makes line 78's `ltu_res_w <= '1' WHEN ain_w < bin_w` a signed comparison. |

| 6 | Branch/`jal` displacement truncated one bit | `EXECUTE.vhd:66` | **Lecturer's baseline.** `IDECODE` hands over `imm[12:1]` sign-extended, so the adder must shift left by one. The slice is `sign_extend_i(PC_WIDTH-3 DOWNTO 0)` = bits 10..0, which drops immediate bit 11 — byte-offset bit 12 — halving the reachable branch range to ±2 KiB inside a 13-bit, 8 KiB PC. The `-- << 2` comment on that line is also wrong; the code shifts by one. |
| 7 | `jalr` does not clear the target's bit 0 | `IFETCH.vhd:93` | **Lecturer's baseline.** The next-PC mux takes `alu_res_i` unmasked. RV32I requires `pc <- (rs1+imm) & ~1`. Masked today by the word-granular ITCM dropping bits 1..0, but `pc_o`, `pc_plus4` and every link address carry the odd value. |

**Six of the seven are in code Hanan distributed** and were inherited unchanged by both student
cores; only `andi`/`ori` is a student regression. The report presents them as supplied defects rather
than as failures of our RTL. Raised as open question 13.

**Where each repair comes from.** Every one is transcribed from
`Auxiliary/Lab 5/DUT/RV32IM_pipeline/`, which fixes all seven:

| # | Repair reference | Notable |
| --- | --- | --- |
| 1 | `CONTROL.vhd:147` | `ALU_AND WHEN and_w or andi_w` |
| 2 | `const_package.vhd:28-29`, `IDECODE.vhd:181-182` | `UTYPE_OPC` split into `AUIPC_OPC` / `LUI_OPC`, two select arms |
| 3 | `IDECODE.vhd:178` | the missing `LOAD_OPC` arm |
| 4 | `EXECUTE.vhd` | `brl_shr_pad_r <= (others => '1')` |
| 5 | `EXECUTE.vhd:196-197` | `('0' & ain_w) < ('0' & bin_w)` — widening to 33 bits with a clear sign bit makes the signed-package compare give the unsigned answer, so no library change is needed and the genuinely signed `slt`/`blt`/`bge` paths cannot be disturbed |
| 6 | `EXECUTE.vhd:181` | `sign_extend_i(PC_WIDTH-2 DOWNTO 0) & '0'` |
| 7 | `RV32IM_PIPE_CORE.vhd:190` | `mem_alu_res_w(PC_WIDTH-1 DOWNTO 1) & '0'` |

**Defects 6 and 7 have a second, independent confirmation.** `Auxilary/Ori/` — another student's
pipeline, permitted as a reference — repairs exactly those two, with the *identical* expressions
(`EXECUTE.VHD:81` and `RV32IM_CORE.vhd:225`), while still carrying defects 2, 3 and 4. Two
implementations arriving independently at the same two fixes is real evidence, and it matters
because 6 and 7 are the two that came out of reading the RTL rather than out of a failing test.

Why they stayed hidden: Lab 5's own test1–test4 are add / mul / xor programs and contain zero
`lui`, zero `andi`, zero `sra` and zero loads with a non-zero offset. Defects 1–5 are all exercised
by the final-project benchmarks. **Defects 6 and 7 are exercised by nothing we have** — no supplied
benchmark branches ±2 KiB or jumps to an odd address, and the directed ISA suite's only branch
displacements are 0 and 8 with no `jalr` at all. They are covered instead by
`SIM/RV32IMscMCU/repair_check.do`.

### 2.3 Peripherals

| Component | Requirement | Supplied | Path | Provenance | Verdict |
| --- | --- | --- | --- | --- | --- |
| Seven-segment decoder, active-low | §5, Fig 5 | **yes** | `Auxiliary/Lab4/DUT/hex_decoder.vhd` (36 lines) | students, Lab 4 | **used as is, Phase 6A** — copied to `DUT/RV32IMscMCU/HEX_DECODER.vhd`; body byte-identical, md5 `56f2f16645e9bb4643c3a113c36e49c4`, only a provenance header prepended and the filename capitalised |
| PWM output unit | §6.ii, Fig 8 | **yes** | `Auxiliary/Lab4/DUT/pwm.vhd` (60 lines) | students, Lab 4 | **adapt** — 16→32 bit; re-map period `Y`→`BTCL0`, duty `X`→`BTCL1`; drop the unused Toggle mode or map it to `BTINT` |
| Bidirectional data bus | Fig 1, which links to it as "Bi-directional Data BUS (reminder)" | **yes** | `Auxilary/Lab3/DUT/BidirPin.vhd` (20 lines) | students, Lab 3 | **use as is** with `width => 32` |
| ITCM unregistered / DTCM registered pattern | Fig 3 | yes | `Auxilary/Lab3/DUT/progMem.vhd`, `dataMem.vhd` | students, Lab 3 | **reference** — explains why Lab 5's DTCM runs on `not(clk)` |
| Basic Timer core (`BTCNT`, `BTSSEL` mux, `BTCL0/1` latches, comparators, capture) | §6.ii, Fig 7 | **no** | — | — | **write new** |
| Interrupt controller (`IE`/`IFG`/`TYPE`, priority, `INTR`/`INTA`) | §6.v | **no** | — | — | **write new** |
| CPU interrupt entry FSM | §6.v protocol | **no** | — | — | **write new** |
| MMIO address decoder | §5, §6, Fig 5 | **no** | — | — | ~~write new~~ **built, Phase 5A** — `DUT/RV32IMscMCU/ADDR_DECODER.vhd`, structure from Figure 5, map from `io_map.s`, exhaustively tested over all 16384 addresses |
| GPIO buffer registers (LEDR, HEX×6, SW, PB) | §5, §6 | **no** | — | — | **write new** |
| Division accelerator | §6.iii, Fig 9 | **no** | — | — | **write new** — Figure 9 specifies it completely |
| Subtractor for the divider | §6.iii | yes | `Auxiliary/Lab4/DUT/AdderSub.vhd`, `FA.vhd` | students, Lab 4 | **reference** — generic n-bit ripple-carry add/sub |
| Edge detector / one-shot for KEY1–3 | §6.i | **no** | — | — | **write new**. Board keys are already debounced (Fig 6 shows a Schmitt trigger), so what is missing is edge detection, not debounce. Zero hits for `edge_detect`/`one_shot` anywhere. |
| Two-flop CDC synchronizer | §6.iii, Fig 10a/10b | **no** | — | — | **write new**. The only real double-register in the material is inline inside third-party `UART_FPGA_option2/VHDL/DUT/UART_RX.vhd:46-56`. **`IFETCH.vhd:73-82` is labelled "rst_i synchronization" but is a single flop with an async preset — not a synchronizer.** |

### 2.4 Clocking

| Component | Requirement | Supplied | Path | Provenance | Verdict |
| --- | --- | --- | --- | --- | --- |
| ALTPLL wrapper | Fig 1 | yes, three copies | `RV32IM_sc/PLL.vhd`, `Auxilary/DUT/PLL.vhd` (md5-identical, `a12064f2…` — the only file nobody has touched), `Auxiliary/Lab4/DUT/pll.vhd` | third-party generated | **adapt** |
| Multi-output clock tree (`mclk`, `accelclk`, `smclk`) | Fig 1 | **no** | `DUT/RV32IMscMCU/PLL.vhd` | Hanan | **written — Phase 4B**, `CLOCK_TREE.vhd` + `PLL_GEN.vhd`. Not "multi-output" after all: forum answer F6 says **three separate PLL instances**, so nothing is regenerated. The real gap was that `PLL.vhd`'s entity has no generics, so three instances would share one ratio. |
| Worked non-trivial PLL ratio | — | yes | `Auxiliary/Lab4/DUT/pll.vhd` — 50 MHz → 2 MHz | students, Lab 4 | **reference** |

### 2.5 UART (bonus 20%)

§6.iv says "You are given a VHDL design code that needs to be adapted", so this is supplied
material we are expected to use.

| Aspect | Option 1 | Option 2 |
| --- | --- | --- |
| Source | jakubcabal/uart-for-fpga v1.1 (20 Dec 2018) | nandland, VHDL + Verilog copies |
| Licence | **MIT**, `LICENSE:1-3` | **none anywhere** — only a URL comment |
| Baud generation | `DIVIDER_VALUE := CLK_FREQ/(16*BAUD_RATE)`, `rtl/uart.vhd:58` — **compile-time** | compile-time |
| Oversampling | 16×, samples mid-bit (`rx_ticks = "0111"`, `rtl/comp/uart_rx.vhd:78`) | — |
| Frame | 1 start / 8 data / 1 stop, LSB-first (`rx_data <= UART_RXD & rx_data(7 downto 1)`, `uart_rx.vhd:113`) | same |
| Parity | yes — none/even/odd/mark/space, `rtl/comp/uart_parity.vhd` | none |
| Error flags exported | one of three: `FRAME_ERROR <= NOT UART_RXD` (`uart_rx.vhd:162`). Parity error computed at `:139` but **never exported** — Phase 12E exports it as `PARITY_ERROR`, which is UCTL[5]; overrun has no equivalent upstream and is the register layer's own | none |
| Testbench | `tb & sim/uart_tb.vhd` — no `assert`, no `report`. `example/uart_loopback_tb.vhd` is **broken as shipped**: it port-maps `DIN_RDY` and `FRAME_ERR`, which the `UART_LOOPBACK` entity does not declare | none |

**Verdict: adapt Option 1.** It is the only one with a usable licence, the only one with parity, and
its baud divider is isolated in one 20-line process, which is what makes runtime 9600/115200
switching tractable.

**Write new** — absent from both options: separate `RXBUF`/`TXBUF` buffer registers, overrun (`OE`)
logic, a parity-error output port, an aggregate `BUSY` status, an `SWRST` path, a runtime baud
register, and any MMIO or interrupt wrapper. The bonus is a shift-register core we adopt plus a
register layer we write.

#### What Phase 12A actually took, file by file (2026-08-27)

| Our file | From | Change |
| --- | --- | --- |
| `UART_PARITY.vhd` | `rtl/comp/uart_parity.vhd`, md5 `530bb3ff…` | **body byte-identical**, provenance header prepended |
| `UART_DEBOUNCER.vhd` | `rtl/comp/uart_debouncer.vhd`, md5 `946d390f…` | **body byte-identical** |
| `UART_TX.vhd` | `rtl/comp/uart_tx.vhd`, md5 `b2fcd485…` | **12A: body byte-identical** — `DIN`/`DIN_VLD`/`DIN_RDY` is a plain valid-ready handshake and `tx_data` is latched by the same condition that leaves idle (`:94`), which is exactly what the register layer hands over on. **12E: one semantic change, three places** — the `PARITY_BIT` string generic is replaced by `PARITY_EN`/`PARITY_EVEN` ports, `UART_PARITY` is instantiated unconditionally as `"even"` with odd as its inverse, and the `databits` state tests the port. REQ p12 makes parity two *writable register bits*, and a generic cannot implement a register field |
| `UART_RX.vhd` | `rtl/comp/uart_rx.vhd`, md5 `2a856823…` | **two** semantic changes. *12A:* a `;`, a new `RX_BUSY` port, and one assignment — **`rx_receiving_data` is not that signal**, the FSM drives it only in the `databits` state so a BUSY built on it blinks mid-character; the port exports `rx_pstate /= idle`. *12E:* runtime parity — the generic replaced by `PARITY_EN`/`PARITY_EVEN`, a new `PARITY_ERROR` output for UCTL[5], and **`AND PARITY_EN` on the parity-check register**, which is load-bearing: that register samples on every `rx_clk_en`, not only in the `paritybit` state, so without the gate an 8N1 frame would drop valid characters |
| `UART_CORE.vhd` | `rtl/uart.vhd` | adapted: runtime baud select (REQ p12 makes the rate software-selectable, the original freezes it in a generic), **rounded** divider, `>=` compare |
| `UART_PERIPH.vhd` | — | **ours**: the whole register layer |

Verify any of the byte-identical claims by diffing our file from its first `-----` line against the
original.

**A finding in the reference, recorded because it changes a number:** the original's
`CLK_FREQ/(16*BAUD_RATE)` **truncates**. At this project's 20 MHz (F8/F11) and 115200 baud that is
10, i.e. 125 000 baud — **+8.5%**, which no 8N1 link survives. Rounding gives 11 → 113 636, −1.36%.
At the author's own default of 50 MHz truncation lands at +0.47%, which is why the formula looks
harmless in its home configuration. `UART_CORE.vhd` rounds and asserts the resulting error at
elaboration for any `CLK_HZ`.

### 2.6 Multiplier scope

`MUL16.vhd` is 16×16 → 32 **unsigned**, built from four 8×8 partial products — exactly LAB5
Figure 6's `P0..P3`, `M = P1+P2`, `RESULT = P0 + (M<<8) + (P3<<16)`. And `EXECUTE.vhd:93-94` feeds
it only the **lower half-words**:

```vhdl
a_i => ain_w(DATA_BUS_WIDTH/2-1 DOWNTO 0),
b_i => bin_w(DATA_BUS_WIDTH/2-1 DOWNTO 0)
```

So `mul` is correct only when both operands fit in 16 bits unsigned, and `mulh`/`mulhsu`/`mulhu`
are not decoded at all despite their masks existing. Whether a conformant 32×32 is required is
open — LAB5 calls the scope "MULDIV partial" — but a full 32×32 multiplier does not exist anywhere
in the material.

### 2.7 Verification and tooling

| Component | Supplied | Path | Provenance | Verdict |
| --- | --- | --- | --- | --- |
| MCU testbenches | yes | `Auxiliary/Lab 5 - as submitted/TB/RV32IM_{sc,pipeline}/` | students, Lab 5 | **adapt** — waveform-oriented, not self-checking |
| Compile order | yes | `Auxiliary/Lab 5 - as submitted/SIM/*/compile.do` | students, Lab 5 | **adapt** — the explicit VHDL compile order is valuable |
| Run / dump / batch scripts | **no longer** | **Deleted in the 2026-08-23 replacement.** The reference now ships only `golden.do`, `wave.do`, `modelsim.ini` (and `compile.do` + `directed_isa.do` for the pipeline alone — there is no `compile.do` for the single-cycle core anywhere). | — | **written new**: `SIM/baseline_reference/{compile,run_test,mem_dump}.do` reach into `Auxiliary/` read-only so it stays as supplied |
| Measured baseline dumps | yes | `SIM/*/DTCM_test1..4_MS.mem` — renamed, and now **2048 data words** (2051 lines with the 3-line mti header) instead of 1024 | students, Lab 5 | **use as is** — diff a reproduced run against these. The full-range capture is what closes gap G-204 on the single-cycle side |
| Assertion-based TB pattern | yes, barely | `Auxilary/Lab3/TB/tb_top.vhd:86` (timeout, `severity failure`) and `:110` (`assert false report "Simulation Completed Successfully"`) | students, Lab 3 | **reference** — **the only assertion usage in the entire material**; the seed for the self-checking style the rules require |
| Self-checking / scoreboard infrastructure | **no** | — | — | **write new** |
| SDC | yes | `Auxiliary/Lab 5/Auxilary/RV32I/QUARTUS/SDC/RISCV_simple.sdc` — `create_clock -period 20 [get_ports {clk_i}]` plus `derive_pll_clocks -create_base_clocks` | **Hanan** | **adapt** |
| — | yes | `Auxiliary/Lab 5 - as submitted/Quartus/*/*.sdc`, and `Auxiliary/Lab4/Quartus/Lab4_{hw,perf}.sdc` | students | **adapt** |
| Two-revision PPA structure | yes | `Auxiliary/Lab4/DUT/perf_wrapper.vhd` + `Lab4_perf.sdc` (pinless, SignalTap off) + `Lab4_hw.sdc` (pinned, SignalTap on) | students, Lab 4 | **adapt** — exactly the structure the three mandatory PPA rows need |
| SignalTap file | yes | `Auxiliary/Lab4/Quartus/stp1.stp`, plus the Lab 5 `.stp` | students | **adapt** |
| Board-level top wrapper | yes | `Auxiliary/Lab4/DUT/fpga_hw_interface.vhd` | students, Lab 4 | **reference** — pattern for the MCU top |
| Report structure | yes | `Auxiliary/Lab 5/DOC/Report_lab5.pdf` | students, Lab 5 | **reference** — LAB5 §9 and the final project §10 require the same items |
| Architecture figures | yes | `Auxiliary/Lab 5 - as submitted/report_figs/` (8 PNGs) | students, Lab 5 | **adapt** |
| PPA / waveform evidence | yes | `Auxiliary/Lab 5 - as submitted/Screenshots/{Quartus,ModelSim}/{SC,Pipeline}/` | students, Lab 5 | **reference** — templates for the mandatory screenshots |
| ISMCE procedure | yes | `Auxilary/Validation using ISMCE.pdf` | **Hanan** | **use as is** |
| Toolchain procedure | yes | `Auxilary/RISC-V Tool-Chain.pdf` | **Hanan** | **use as is** |
| Working ModelSim procedure | yes | `Auxiliary/Lab 5/ModelSim_Testing_Guide.md` | students, Lab 5 | **use as is** |

### 2.8 Earlier labs — what exists and what does not

The question "was earlier-lab code supplied that we should be reusing" resolves as follows.

- **Lab 3** — present in full: `DOC`, `DUT`, `SIM`, `TB`, plus `SW-QA/Ex5` and `Ex6` with `.asm`/`.c`
  sources and matching ITCM/DTCM images. A multi-cycle 1-BUS CPU with a 16×16 register file.
- **Lab 4** — present in full: `DOC`, `DUT`, `SIM`, `TB`, `Quartus`. The richest source of reusable
  leaf modules in the whole tree.
- **Lab 1** — survives only as the 8-bit combinational ALU absorbed into Lab 4
  (`top.vhd`/`AdderSub`/`Logic`/`Shifter`/`FA`), identified by `Lab4/DOC/readme.txt:12`.
- **Lab 2** — **completely absent.** No folder, no file, no header, no README mention.

---

## 2.4 Provenance of every RTL file — is this Lab 5's or ours?

**Asked directly, and answered from the files rather than from memory.** This project is a
continuation of Lab 5, so the honest question about any file is which parts are the lab's and which
are new. Regenerate this table by diffing `DUT/RV32IMscMCU/` against
`Auxiliary/Lab 5/DUT/RV32IM_sc/`.

**11 of the 29 RTL files come straight from Lab 5** — the entire CPU: fetch, decode,
execute, data memory, the multiplier, the PLL, and all three packages. Nothing about the core was
rewritten; every ISA repair, the byte enables and the bus interface are edits **on top of** the
supplied files, which is why the diffs are line counts rather than whole files.

| File | Base | Relationship to Lab 5 |
| --- | --- | --- |
| `ADDR_DECODER.vhd` | new / other lab | **new** — Figure 5. Searched: no address decoder exists anywhere in Lab 3, 4 or 5. |
| `BIDIRPIN.vhd` | new / other lab | **Lab 3, used as is** — body byte-identical to Lab 3's `BidirPin.vhd` (md5 `ab12d81d…`). **The source was deleted from `Auxiliary/` by the 2026-08-25 restructure; our `DUT/RV32IMscMCU/BIDIRPIN.vhd` is now the only surviving copy.** |
| `CLOCK_TREE.vhd` | new / other lab | **new** — Figure 1. Board-level PLL placement follows `Auxiliary/Lab4/DUT/fpga_hw_interface.vhd`; the three-instance structure is new (every ALTPLL in the tree exposes `c0` only). |
| `CONTROL.vhd` | Lab 5 | **extended** — 70 changed line(s) vs the Lab 5 single-cycle core |
| `DIV_ACCEL.vhd` | new / other lab | **new** — Figure 9. Subtractor alternative documented from `Auxiliary/Lab4/DUT/AdderSub.vhd`. |
| `DIV_UNIT.vhd` | new / other lab | **new** — Figures 3 + 10b. Wraps our own `DIV_ACCEL` and `SYNC`. |
| `DMEMORY.vhd` | Lab 5 | **extended** — 229 changed line(s) vs the Lab 5 single-cycle core |
| `EXECUTE.vhd` | Lab 5 | **extended** — 51 changed line(s) vs the Lab 5 single-cycle core |
| `GPO_PORT.vhd` | new / other lab | **new** — Figure 5. Register-with-enable idiom follows `Auxiliary/Lab4/DUT/fpga_hw_interface.vhd:37-38`. |
| `HEX_DECODER.vhd` | new / other lab | **Lab 4, used as is** — body byte-identical to `Auxiliary/Lab4/DUT/hex_decoder.vhd` (md5 `56f2f166…`). |
| `IDECODE.vhd` | Lab 5 | **extended** — 68 changed line(s) vs the Lab 5 single-cycle core |
| `IFETCH.vhd` | Lab 5 | **extended** — 74 changed line(s) vs the Lab 5 single-cycle core |
| `INTERRUPT_CTRL.vhd` | new / other lab | **new, Phase 9A** — REQ p13/p14 + the falsified-A6 forum answer + the prep session's release-edge rule (`DOC/03` §C). Searched: no interrupt RTL in Lab 3, 4 or 5. Reuses `SYNC.vhd` for the KEY inputs. |
| `MUL16.vhd` | Lab 5 | **identical** — not one byte changed |
| `PLL.vhd` | Lab 5 | **identical** — not one byte changed |
| `PLL_GEN.vhd` | new / other lab | **derived from `PLL.vhd`** — four wizard constants promoted to generics; `PLL.vhd` itself left byte-identical. |
| `RV32IM_CORE.vhd` | Lab 5 | **extended** — 438 changed line(s) vs the Lab 5 single-cycle core |
| `RV32IMscMCU.vhd` | new / other lab | **new** — §3 requires a structural top. Pattern from `Auxiliary/Lab4/DUT/fpga_hw_interface.vhd`. |
| `UART_CORE.vhd` | new / other lab | **third-party, adapted** — jakubcabal `rtl/uart.vhd` (MIT) with a runtime, ROUNDED baud divider. Phase 12A. |
| `UART_DEBOUNCER.vhd` | new / other lab | **third-party, used as is** — body byte-identical to jakubcabal `uart_debouncer.vhd`, md5 `946d390f…`. |
| `UART_PARITY.vhd` | new / other lab | **third-party, used as is** — body byte-identical, md5 `530bb3ff…`. Compiled but not instantiated: the frame is 8N1 (A26). |
| `UART_PERIPH.vhd` | new / other lab | **new, Phase 12A** — the whole USART register layer (UCTL/RXBUF/TXBUF, OE/FE/BUSY/SWRST, the interrupt strobes). Neither supplied option has any of it. |
| `UART_RX.vhd` | new / other lab | **third-party, two adaptations** — jakubcabal `uart_rx.vhd`, md5 `2a856823…`, plus `RX_BUSY` for UCTL[7] (12A) and runtime parity with `PARITY_ERROR` for UCTL[5] (12E). |
| `UART_TX.vhd` | new / other lab | **third-party, one adaptation** — md5 `b2fcd485…`, byte-identical until 12E made parity runtime. |
| `SYNC.vhd` | new / other lab | **new** — Figures 10a/10b. Searched: no synchroniser in the material (`IFETCH.vhd`'s "rst_i synchronization" is a single flop, not one). |
| `aux_package.vhd` | Lab 5 | **extended** — 435 changed line(s) vs the Lab 5 single-cycle core |
| `cond_compilation_package.vhd` | Lab 5 | **extended** — 23 changed line(s) vs the Lab 5 single-cycle core |
| `const_package.vhd` | Lab 5 | **extended** — 136 changed line(s) vs the Lab 5 single-cycle core |

**What genuinely did not exist in Lab 3, 4 or 5 — verified by searching every `.vhd` under
`Auxiliary/`:** an address decoder, a GPIO port, a clock tree or any second clock domain, a
synchroniser, a divider, and an interrupt controller. Those are the six things the final project
adds, and they are exactly the six the assignment's own figures introduce (5, 5, 1, 10a/10b, 9,
and p13's controller diagram).

**Where Lab 5 DID have a precedent and it is used, it is cited in the file itself.** The clearest
case is the Phase 7B2 stall: `IFETCH.vhd` holds the PC by feeding `pc_q` back into `next_pc_w`, which
is the same mechanism — and the same reasoning about the synchronous ITCM re-reading the address —
that our own Lab 5 **pipeline** uses for its load-use interlock at
`Auxiliary/Lab 5/DUT/RV32IM_pipeline/IFETCH.vhd:107`. That citation was **missing
until it was asked for**, and the file now carries it, including what differs (the name is Figure 3's
`PCHold`, the source is a divide rather than a load-use hazard, and there is no IF/ID register to
hold in a single-cycle core).

## 3. Hazards recorded while surveying

1. **Reset polarity is welded to the simulation switch in BOTH copies now.** This used to be a
   difference between the two Lab 5 trees; it no longer is. `Auxiliary/Lab 5/` has the `RSTPOL`
   generate, and the replaced `Auxiliary/Lab 5/DUT/RV32IM_sc/RV32IM_CORE.vhd` now
   does the same thing a different way: `rst_w <= rst_i WHEN MODELSIM /= 0 ELSE NOT rst_i`. Either
   way, compiling at `MODELSIM = 0` inverts the testbench's active-high reset into a permanent
   assertion — the core sits at PC 0, the transcript shows no errors, and nothing runs.
   **Our own tree deliberately does not do this**: polarity lives in the wrapper's `RST_ACTIVE_LOW`
   generic, so "active-low board reset" and "FPGA build" stay separate decisions. Our core does not
   invert at all, so there is no double inversion — verified.
2. **`G_MODELSIM` no longer needs a manual toggle — gap G-201 is closed.** Both testbenches declare
   `MODELSIM` as a generic and forward it to the core, so `vsim -gMODELSIM=1` does the job and the
   package keeps its shipped default of `0` for Quartus. This is true of the *reference* testbenches
   too (`TB/RV32IM_sc/tb_RV32IM_sc.vhd:19,61`), which is what lets `Auxiliary/` stay untouched.
   The `DOC/readme.txt` instruction to edit the constant by hand is superseded.
3. **Absolute Windows paths are baked into the RTL** at four sites —
   `init_file => "C:\TestPrograms\Quartus21_1\app_bin\{ITCM,DTCM}.hex"` in `IFETCH.vhd:64` and
   `DMEMORY.vhd:50` — and the `.do` scripts stage benchmarks by copying from
   `C:/TestPrograms/Quartus21_1/test$N/bin/`. This is the **documented working convention**, not an
   accident; `testN/RARS/DTCM.h` holds the goldens. Do not change it while reproducing the
   baseline. Parameterise only before staging the submission ZIP, which forbids absolute-path
   dependencies.
4. **`mem_dump.do` reaches into simulator internals** (`.../data_memory/MEMORY/m_mem_data_a`),
   which version-locks it to ModelSim ASE 2020.1.
5. **The single-cycle critical path has only half a clock period.** The Lab 5 `critical_path.png`
   shows ITCM `porta_address_reg` → `ID|Mux19~2/3/6/9` → DTCM `porta_address_reg`, relationship
   **20.000 ns** with an **inverted** latch clock, slack 1.351 ns. The MMIO decoder of §2.3 lands
   directly in that path.
6. **Two similarly-spelled benchmark folders.** `Auxiliary/Benchmark Apps/Intrrupt-based IO/` is
   the current revision; `_superseded/Interupt-based IO/` is the older one. One letter apart — a
   real hazard for a `.do` script path.
7. **Use `bin/M9K-intel/*.hex` for ITCM, never `bin/Hexadecimal-Text/ITCM.h`.** The two formats are
   different programs: the `.hex` images use `auipc imm = 0x00000` (text base 0), the `.h` images
   retain RARS's `0x3000` base. The `.h` files are the DTCM golden text only — which is exactly
   what §8.c.i asks for.
8. ~~The project's own working folders are empty.~~ **No longer true.** `DUT/RV32IMscMCU/`,
   `DUT/RV32IMpipelinedMCU/`, `TB/`, `SIM/` and `Quartus/` are populated as of Phases 1–3.
   `Screenshots/` and `209580208_211468582/` are still placeholders and fill up in Phases 13–16.

---

## 4. Summary

| Verdict | Count | Components |
| --- | --- | --- |
| **use as is** | 6 | `hex_decoder.vhd`; `BidirPin.vhd` (`width => 32`); the M-extension instruction masks; the 32×32 register file; the measured baseline dumps; the two lecturer procedure PDFs |
| **adapt** | 14 | both CPU cores, hazard/forward units, `MUL16`, `pwm.vhd`, the ALTPLL, UART option 1, both testbenches, the `.do` scripts, the SDCs, the two-revision PPA structure, the `.stp`, the report structure, the architecture figures |
| **reference only** | 8 | the RV32I baseline, `Shifter.vhd`, `AdderSub.vhd`/`FA.vhd`, `Lab3/RF.vhd`, `progMem`/`dataMem`, `fpga_hw_interface.vhd`, `Lab4/pll.vhd`, `Lab3/tb_top.vhd` assertions |
| **write new** | 12 | divider accelerator, Basic Timer core, interrupt controller, CPU interrupt FSM, ~~MMIO decoder~~ **(built, Phase 5A/5B)**, ~~GPIO output registers~~ **(built, Phase 6A)**, `div`/`rem`/`mulh*`, ~~byte enables and sub-word load/store~~ **(built, Phase 3B)**, edge detectors, ~~CDC synchronizer~~ **(built, Phase 4A)**, multi-output clock tree, the UART register layer |

The roadmap assumed the seven-segment decoder, the PWM unit and the bidirectional bus would all be
written from scratch. They exist. Conversely it under-scoped sub-word load/store and the UART
register layer, both of which are larger than a single step.

**One entry in the "write new" column deserves a note, because it was searched hardest.** Byte
enables and sub-word load/store had **no reference anywhere** — the tree contains 10 `altsyncram`
instantiations and not one uses `byteena_a`, `byte_size` or `width_byteena_a`; the reference pipeline
does not implement sub-word access either (`PROJECT_EXPLANATION.md` §4.4 says so outright); and
`Auxilary/Ori/`, once permitted and checked, has nothing in `DEMEMORY.VHD` either. It was built in
Phase 3B from Intel's megafunction interface, which is **general knowledge and not course
material** — the one place in the project so far where that is true, and it is flagged as such in
`DUT/RV32IMscMCU/DMEMORY.vhd` itself.
