Adar-Shapira/rv32im-mcu-project/Auxiliary/USART Material/FPGA USART connections.jpg

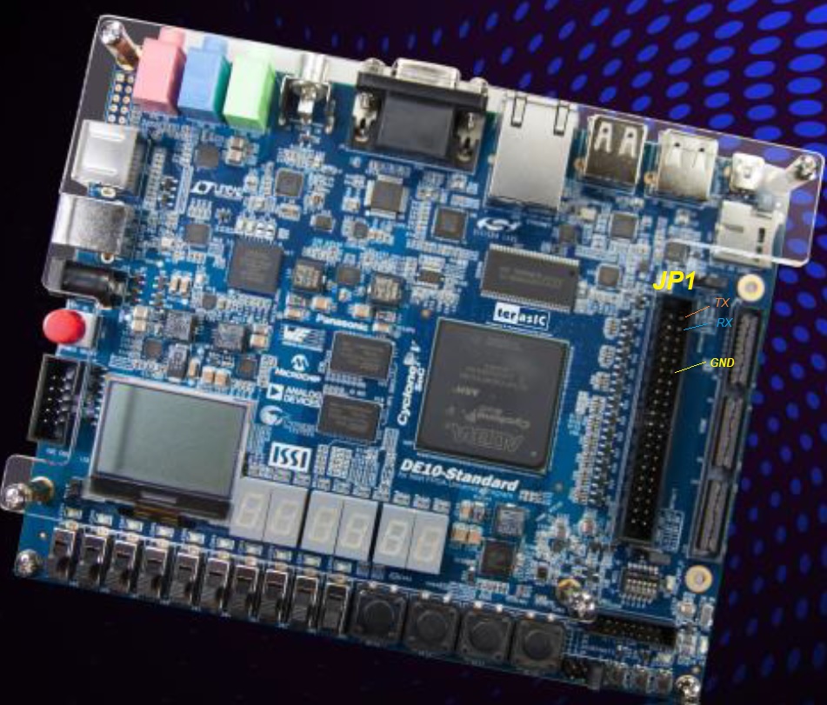
Auxiliary/USART Material/FPGA USART connections.jpg
