Adar-Shapira/rv32im-mcu-project/Auxiliary/USART Material/JP1 header connections.jpg

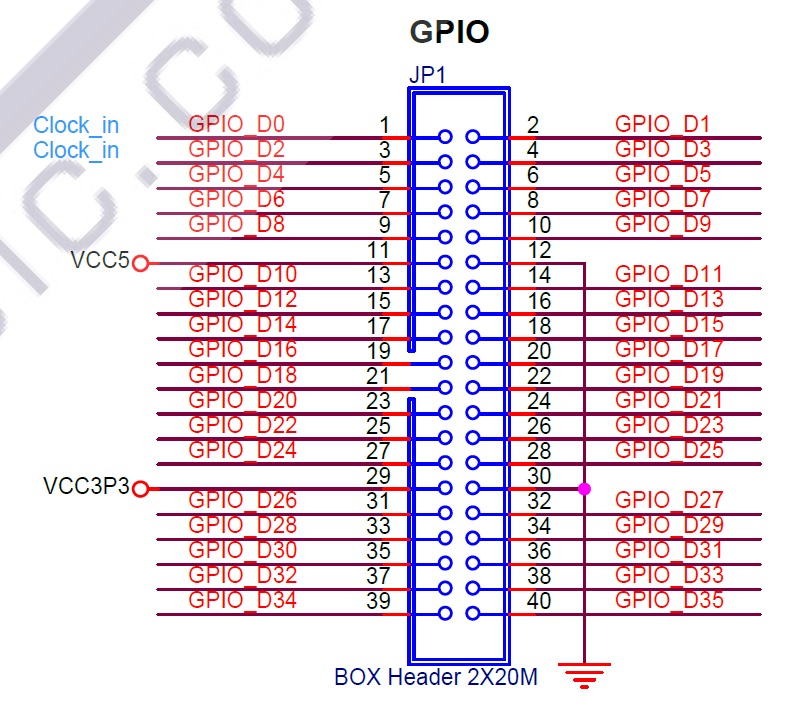
Auxiliary/USART Material/JP1 header connections.jpg
