Adar-Shapira/rv32im-mcu-project/(list of files, cad)

Other CAD files:
209580208_211468582/Quartus/RV32IMpipelinedMCU/stp_pwm.stp
209580208_211468582/Quartus/RV32IMscMCU/stp_pwm.stp
Auxiliary/Lab 5/209580208_211468582/Quartus/RV32IM_pipeline/RV32IM_pipeline.stp
Auxiliary/Lab 5/209580208_211468582/Quartus/RV32IM_sc/stp1.stp
Auxiliary/Lab 5/Quartus/RV32IM_pipeline/RV32IM_pipeline.stp
Auxiliary/Lab4/209580208_211468582/Quartus/stp1.stp
Auxiliary/Lab4/Auxiliary/counter/Quartus/SignalTap/DE1_v1018.stp
Auxiliary/Lab4/Auxiliary/pll_counter/Quartus/SignalTap/pll_counter.stp
Auxiliary/Lab4/Quartus/stp1.stp
Quartus/RV32IMpipelinedMCU/stp_pwm.stp
Auxiliary/Lab4/Auxiliary/counter/Quartus/SignalTap/DE10-Standard.stp
Auxiliary/Lab4/Auxiliary/counter/Quartus/SignalTap/DE2_115.stp
