Adar-Shapira/rv32im-mcu-project/Auxiliary/Lab 5/Auxilary/Benchmarks/test2/RV32I/man_compiled/test2_statistics.png

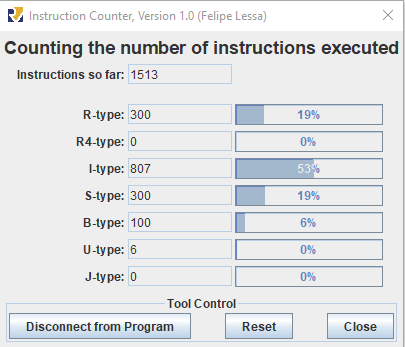
Auxiliary/Lab 5/Auxilary/Benchmarks/test2/RV32I/man_compiled/test2_statistics.png
