Adar-Shapira/rv32im-mcu-project/Auxiliary/Lab 5/Auxilary/Benchmarks/test3/RV32IM/man_compiled/test3_statistics.png

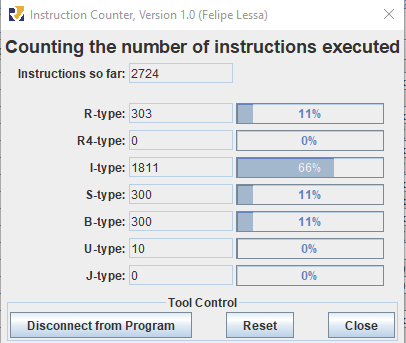
Auxiliary/Lab 5/Auxilary/Benchmarks/test3/RV32IM/man_compiled/test3_statistics.png
