Adar-Shapira/rv32im-mcu-project/Auxiliary/Lab 5/Auxilary/Benchmarks/test4/RV32I/man_compiled/WatchMe.png

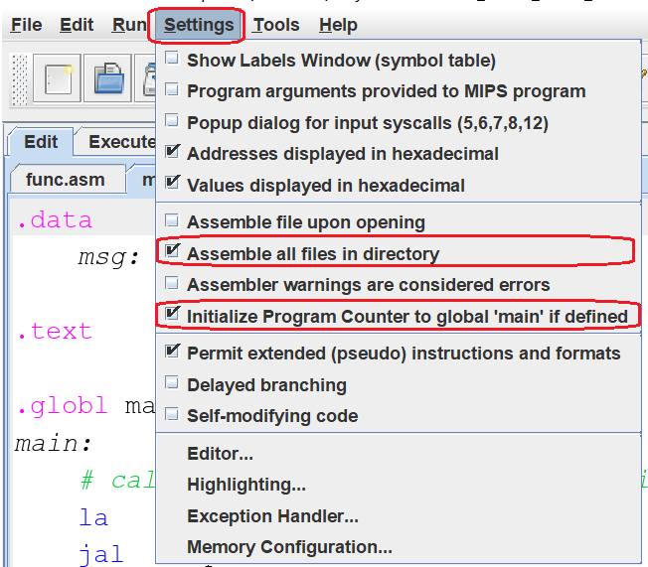
Auxiliary/Lab 5/Auxilary/Benchmarks/test4/RV32I/man_compiled/WatchMe.png
