Adar-Shapira/rv32im-mcu-project/Auxiliary/Lab 5/Auxilary/Benchmarks/test4/RV32IM/man_compiled/test4_statistics.png

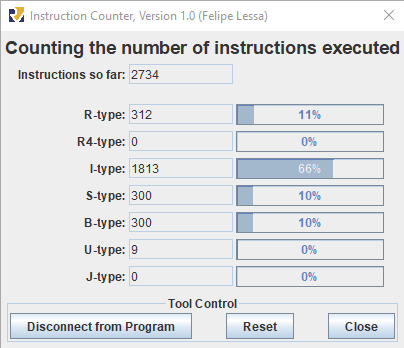
Auxiliary/Lab 5/Auxilary/Benchmarks/test4/RV32IM/man_compiled/test4_statistics.png
