Adar-Shapira/rv32im-mcu-project/Auxiliary/Lab 5/Screenshots/ModelSim/Pipeline/test3_2.png

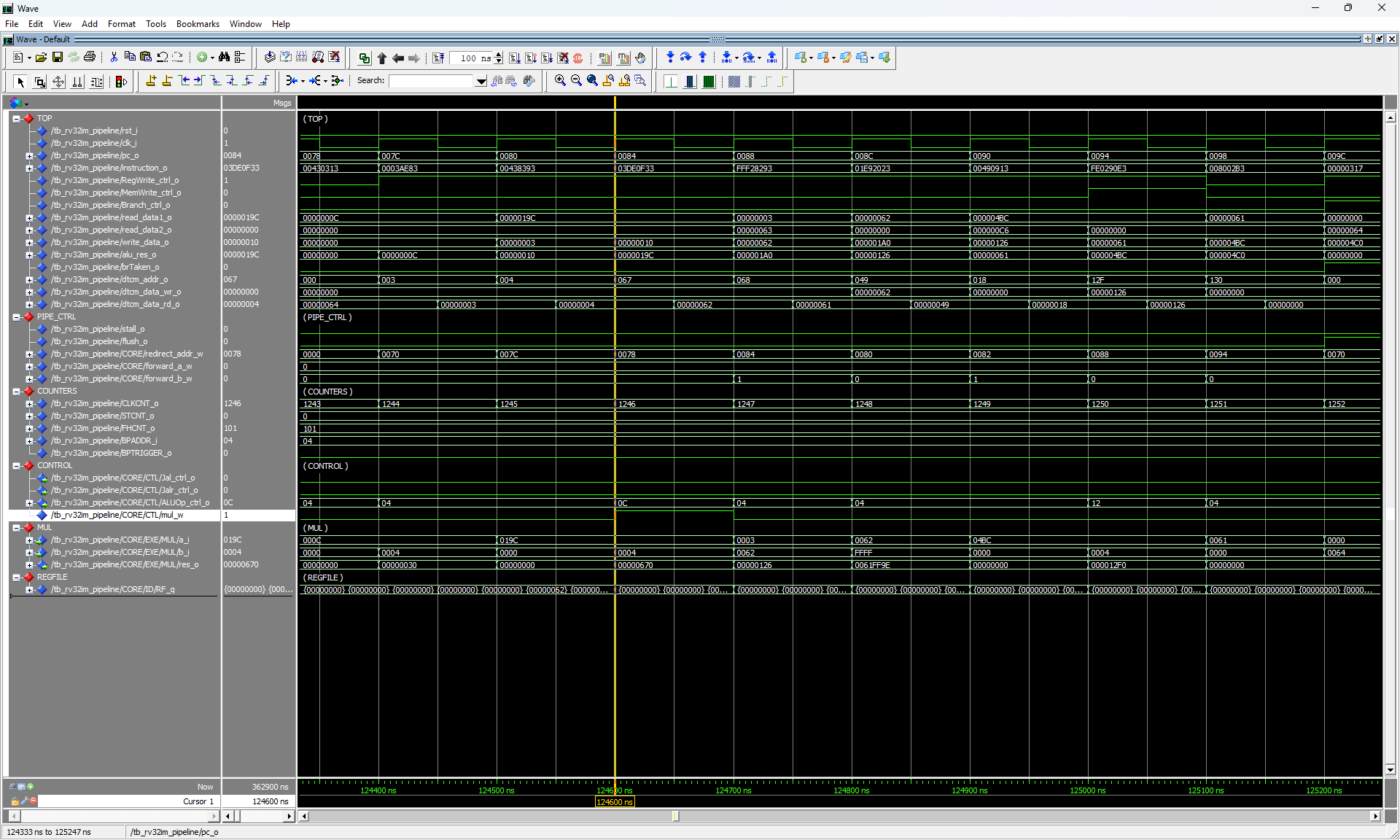
Auxiliary/Lab 5/Screenshots/ModelSim/Pipeline/test3_2.png
