Adar-Shapira/rv32im-mcu-project/Auxiliary/Lab 5/Screenshots/ModelSim/SC/test1_1.png

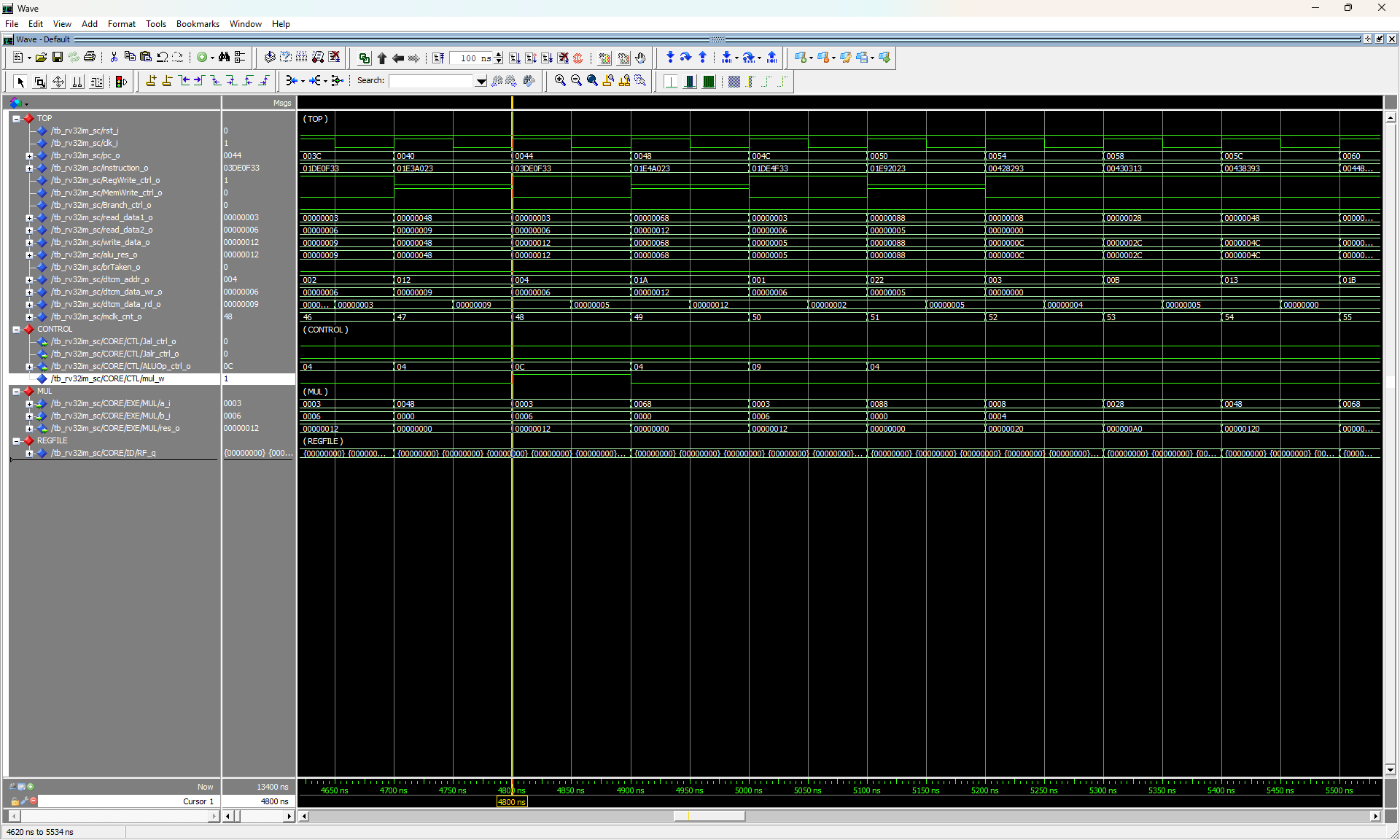
Auxiliary/Lab 5/Screenshots/ModelSim/SC/test1_1.png
