Adar-Shapira/rv32im-mcu-project/Auxiliary/Lab 5/Screenshots/pre/test1_sc_signaltap.jpeg

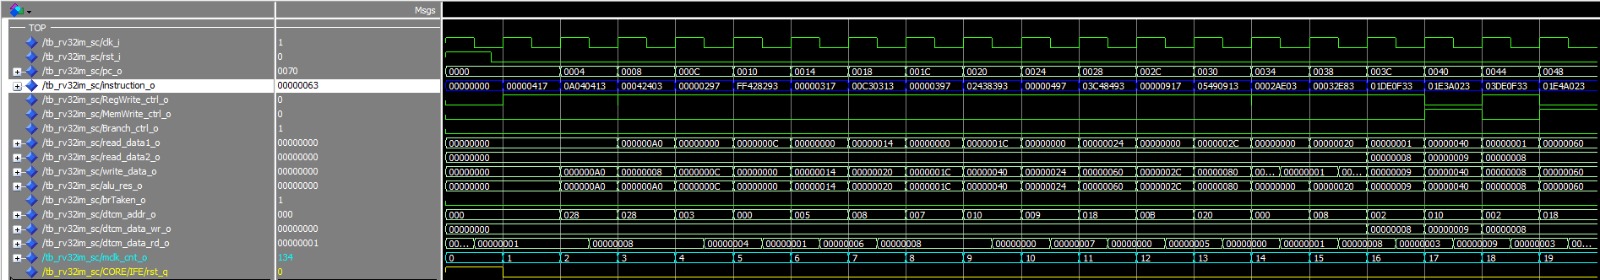
Auxiliary/Lab 5/Screenshots/pre/test1_sc_signaltap.jpeg
