Adar-Shapira/rv32im-mcu-project/Auxiliary/Lab 5/Screenshots/pre/test1_statistics.png

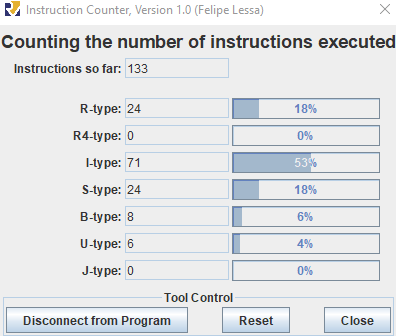
Auxiliary/Lab 5/Screenshots/pre/test1_statistics.png
