Adar-Shapira/rv32im-mcu-project/Auxiliary/Lab 5/Screenshots/pre/test2_pipe_end.jpeg

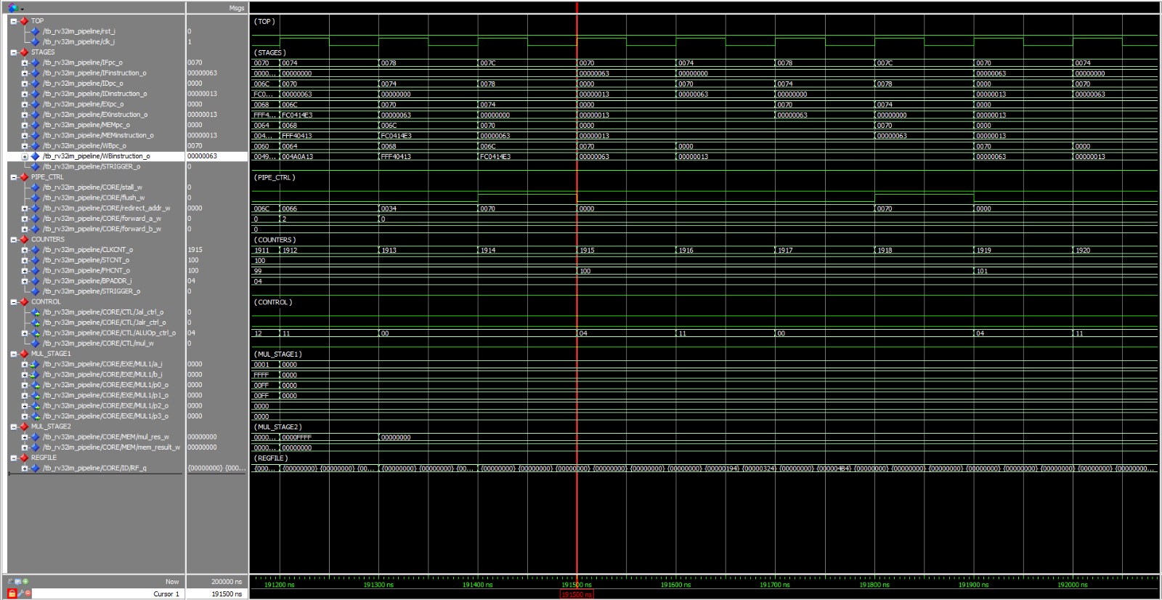
Auxiliary/Lab 5/Screenshots/pre/test2_pipe_end.jpeg
