Adar-Shapira/rv32im-mcu-project/Auxiliary/Lab 5/Screenshots/pre/test2_sc_signaltap_quartus.jpeg

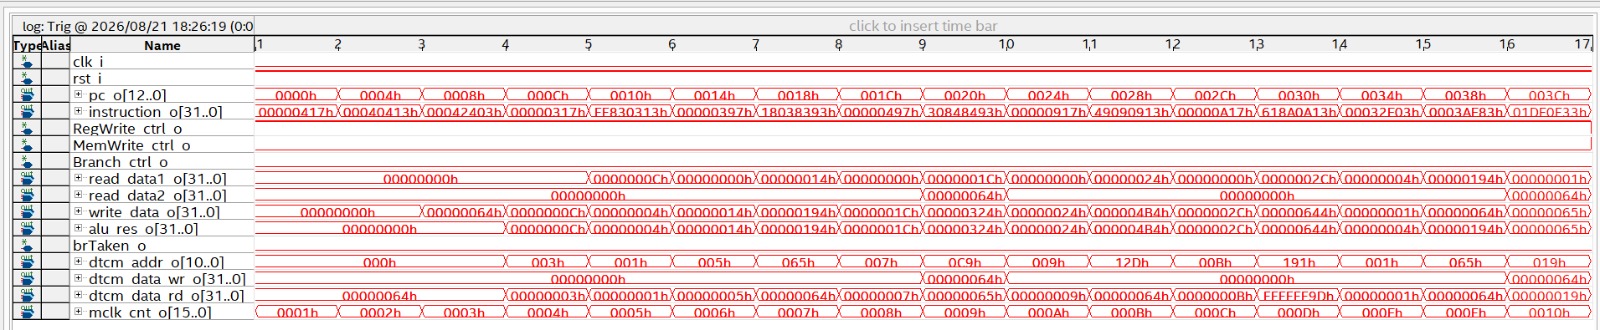
Auxiliary/Lab 5/Screenshots/pre/test2_sc_signaltap_quartus.jpeg
