Adar-Shapira/rv32im-mcu-project/Auxiliary/Lab 5/Screenshots/pre/test3_sc_end.jpeg

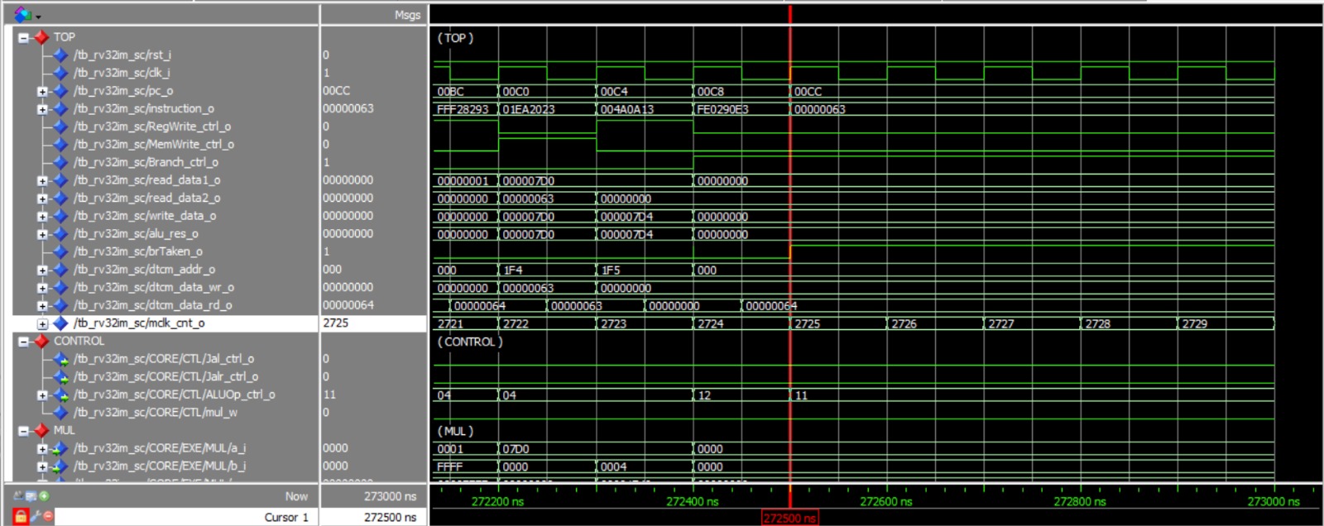
Auxiliary/Lab 5/Screenshots/pre/test3_sc_end.jpeg
