Adar-Shapira/rv32im-mcu-project/Auxiliary/Lab 5/Screenshots/pre/test4_pipe_signaltap_quartus.jpeg

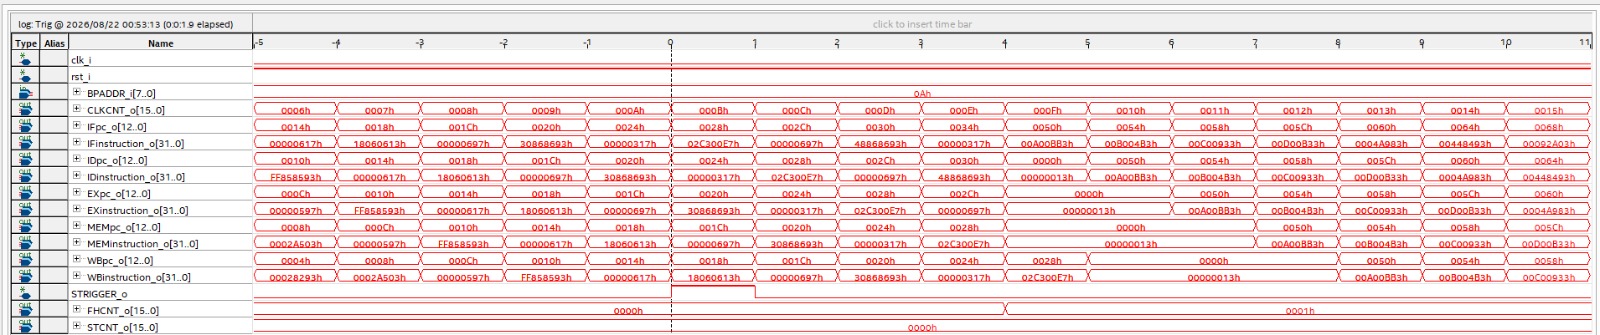
Auxiliary/Lab 5/Screenshots/pre/test4_pipe_signaltap_quartus.jpeg
