Adar-Shapira/rv32im-mcu-project/Auxiliary/Lab 5/Screenshots/pre/test4_sc_signaltap.jpeg

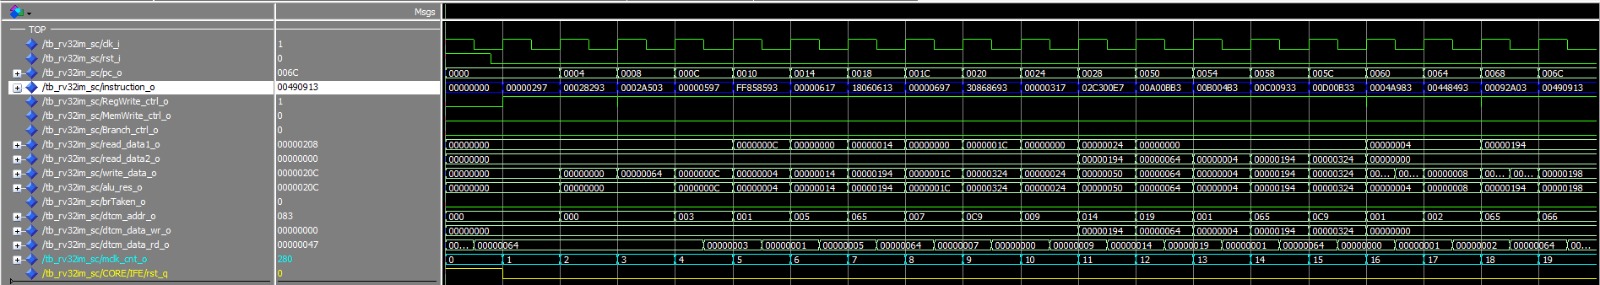
Auxiliary/Lab 5/Screenshots/pre/test4_sc_signaltap.jpeg
