Adar-Shapira/rv32im-mcu-project/Auxiliary/Lab 5/Screenshots/pre/test_pipe_mul.jpeg

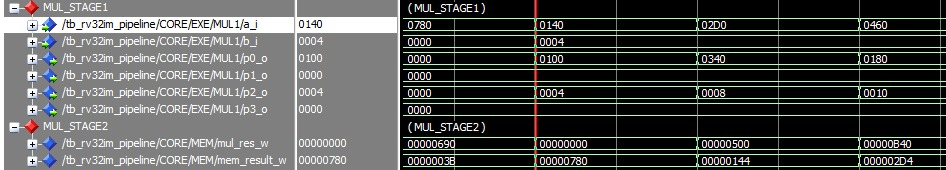
Auxiliary/Lab 5/Screenshots/pre/test_pipe_mul.jpeg
