Adar-Shapira/rv32im-mcu-project/Screenshots/ModelSim/RV32IMpipelinedMCU/GPIO_test0.png

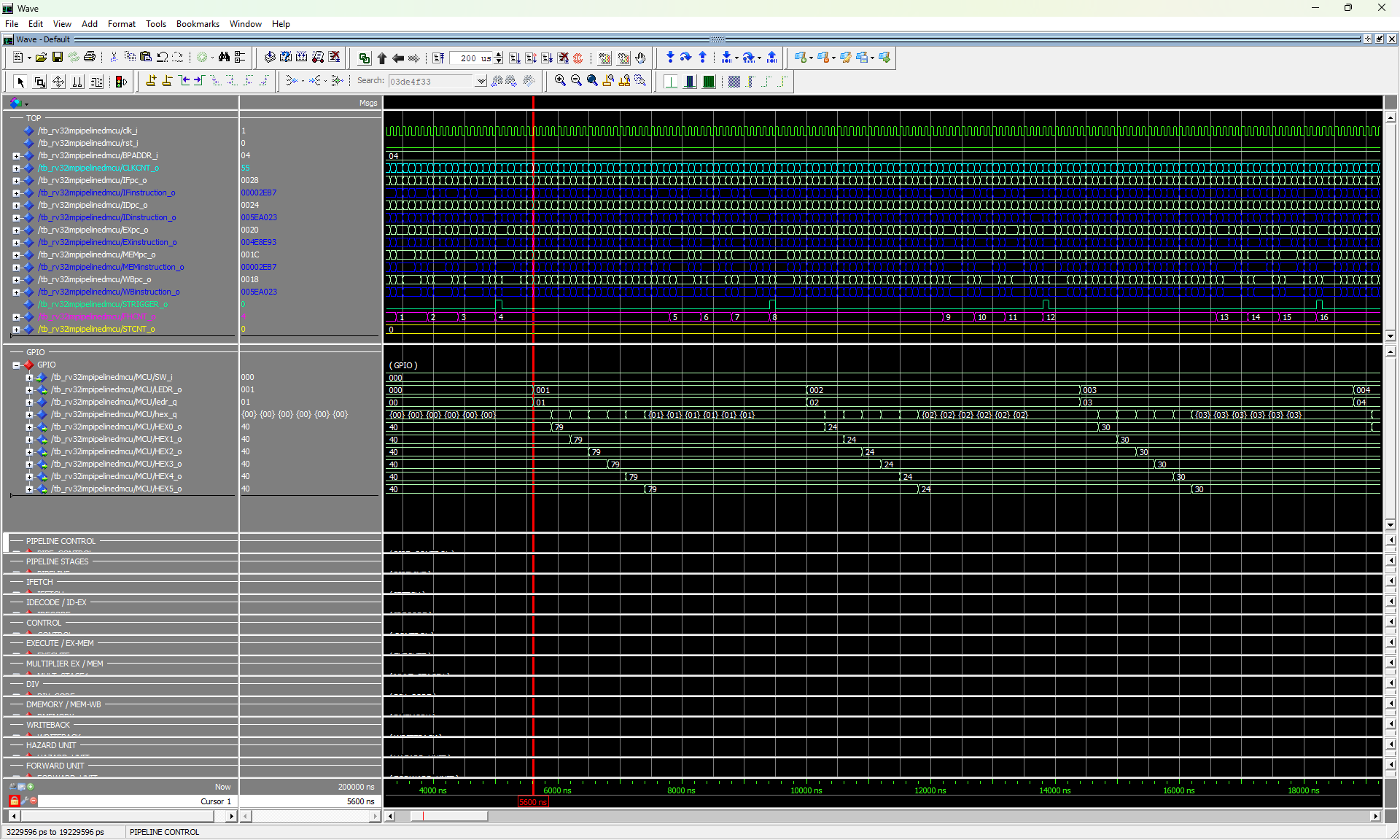
Screenshots/ModelSim/RV32IMpipelinedMCU/GPIO_test0.png
