Adar-Shapira/rv32im-mcu-project/Screenshots/ModelSim/RV32IMpipelinedMCU/GPIO_test2_sw01.png

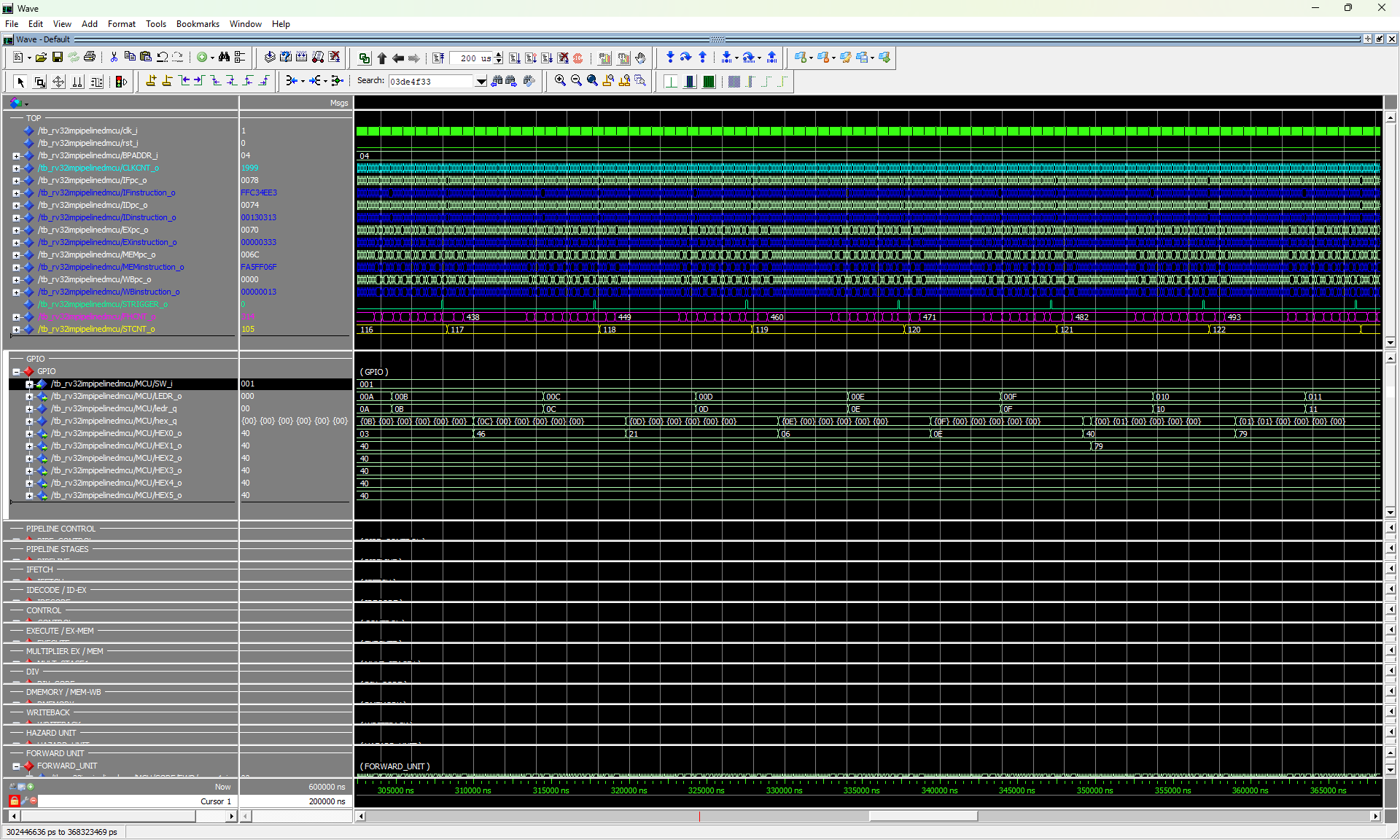
Screenshots/ModelSim/RV32IMpipelinedMCU/GPIO_test2_sw01.png
