Adar-Shapira/rv32im-mcu-project/Screenshots/ModelSim/RV32IMpipelinedMCU/GPIO_test2_sw10.png

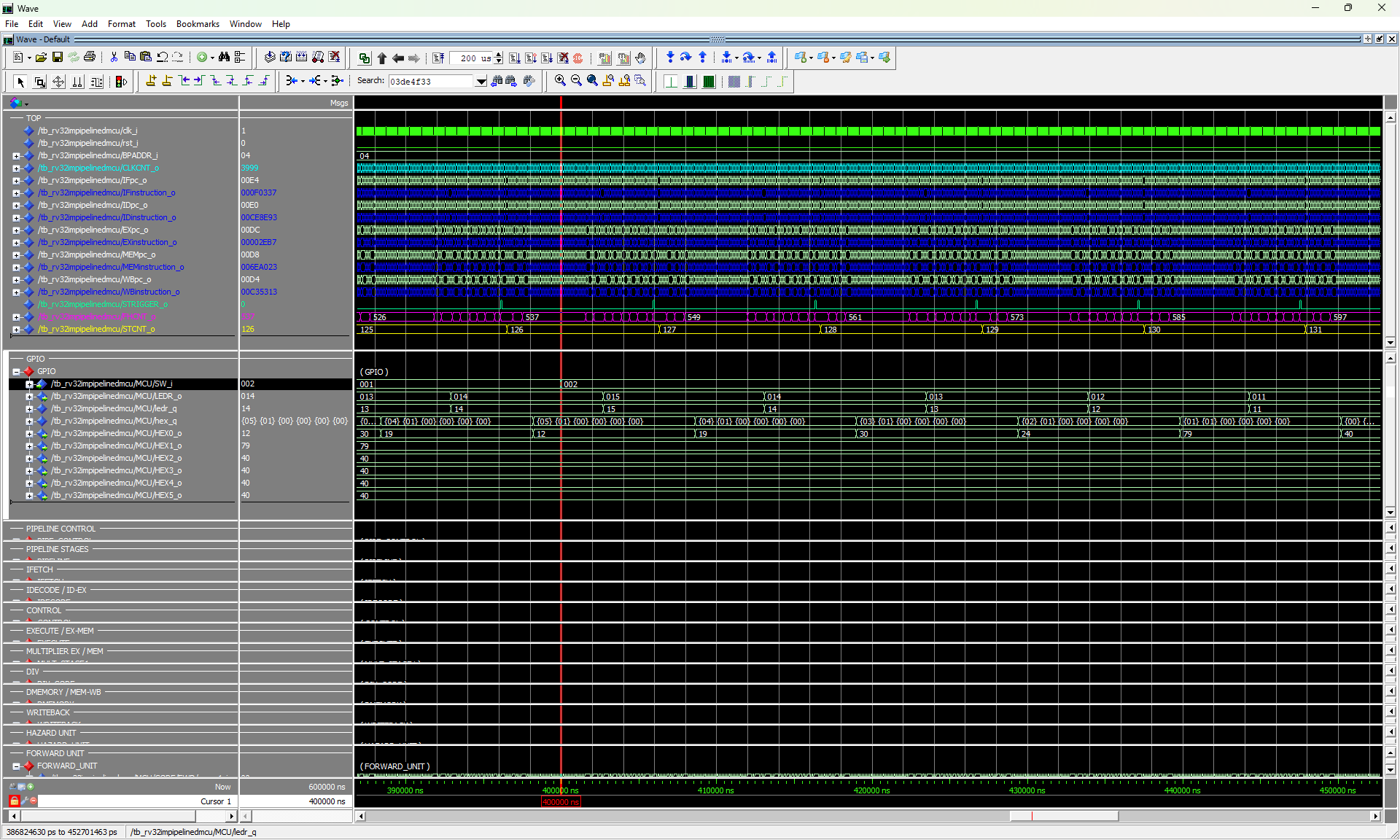
Screenshots/ModelSim/RV32IMpipelinedMCU/GPIO_test2_sw10.png
