Adar-Shapira/rv32im-mcu-project/Screenshots/ModelSim/RV32IMpipelinedMCU/interrupt_test3_key1.png

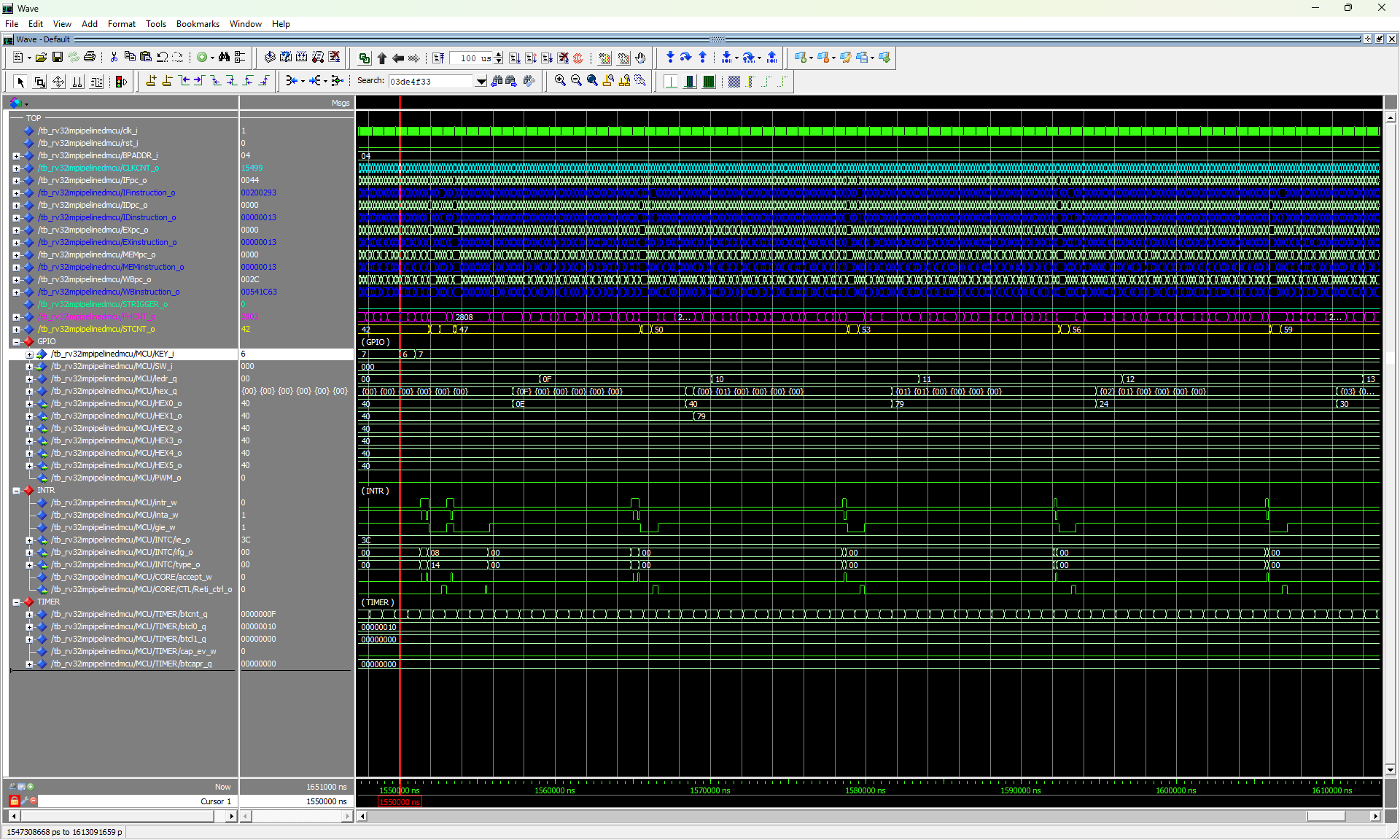
Screenshots/ModelSim/RV32IMpipelinedMCU/interrupt_test3_key1.png
