Adar-Shapira/rv32im-mcu-project/Screenshots/ModelSim/RV32IMpipelinedMCU/interrupt_test3_key2.png

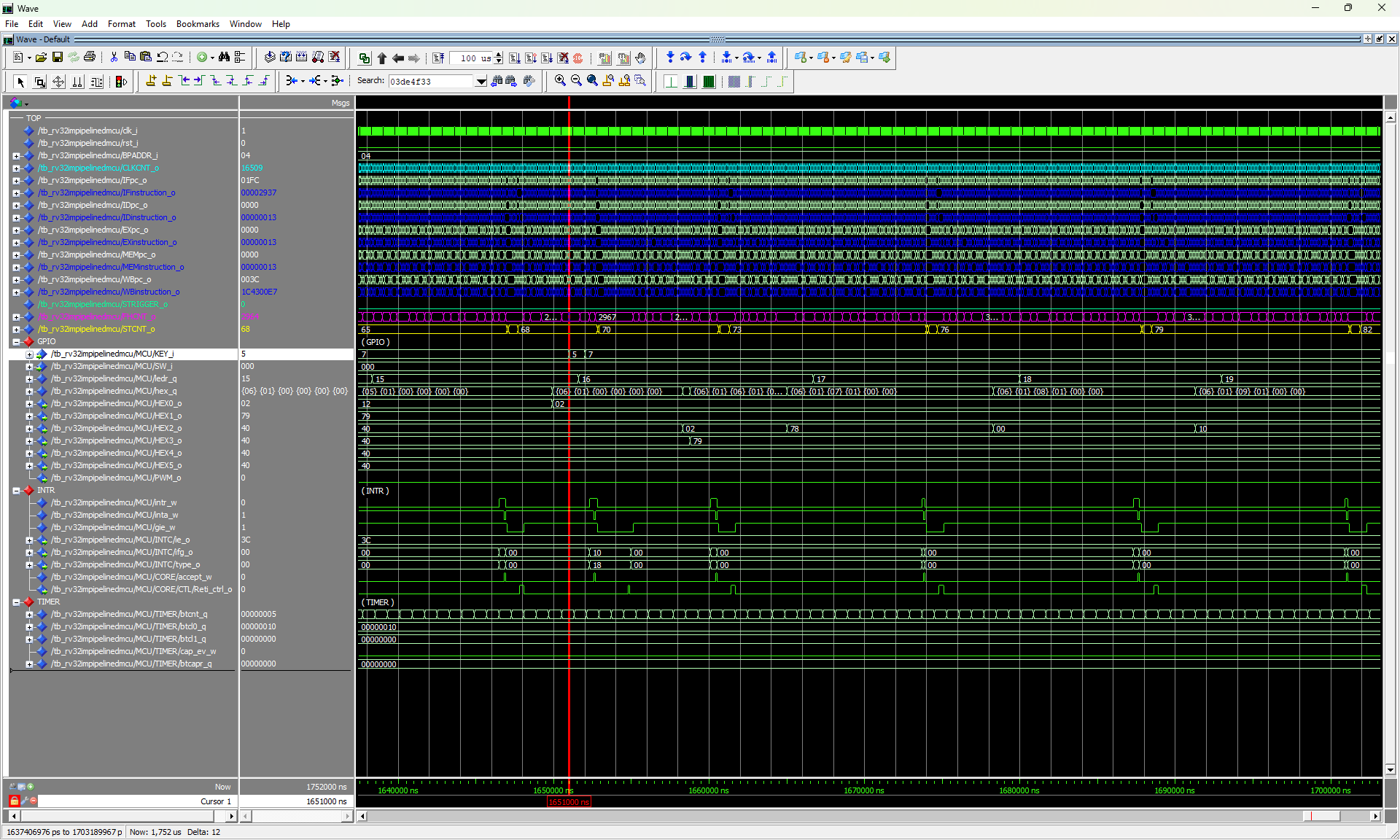
Screenshots/ModelSim/RV32IMpipelinedMCU/interrupt_test3_key2.png
