Adar-Shapira/rv32im-mcu-project/Screenshots/ModelSim/RV32IMpipelinedMCU/interrupt_test3_key3.png

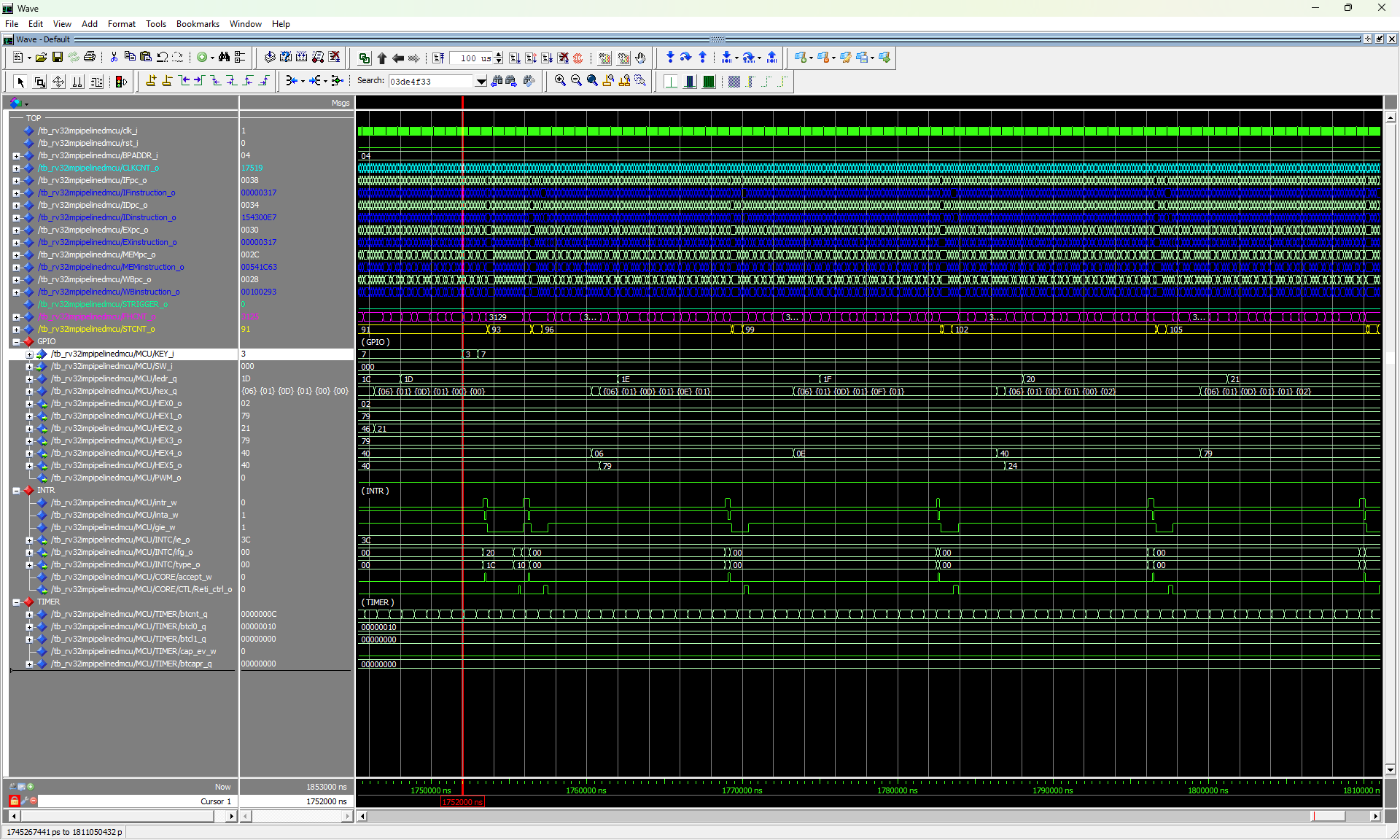
Screenshots/ModelSim/RV32IMpipelinedMCU/interrupt_test3_key3.png
