Adar-Shapira/rv32im-mcu-project/Screenshots/ModelSim/RV32IMpipelinedMCU/interrupt_test4_key3.png

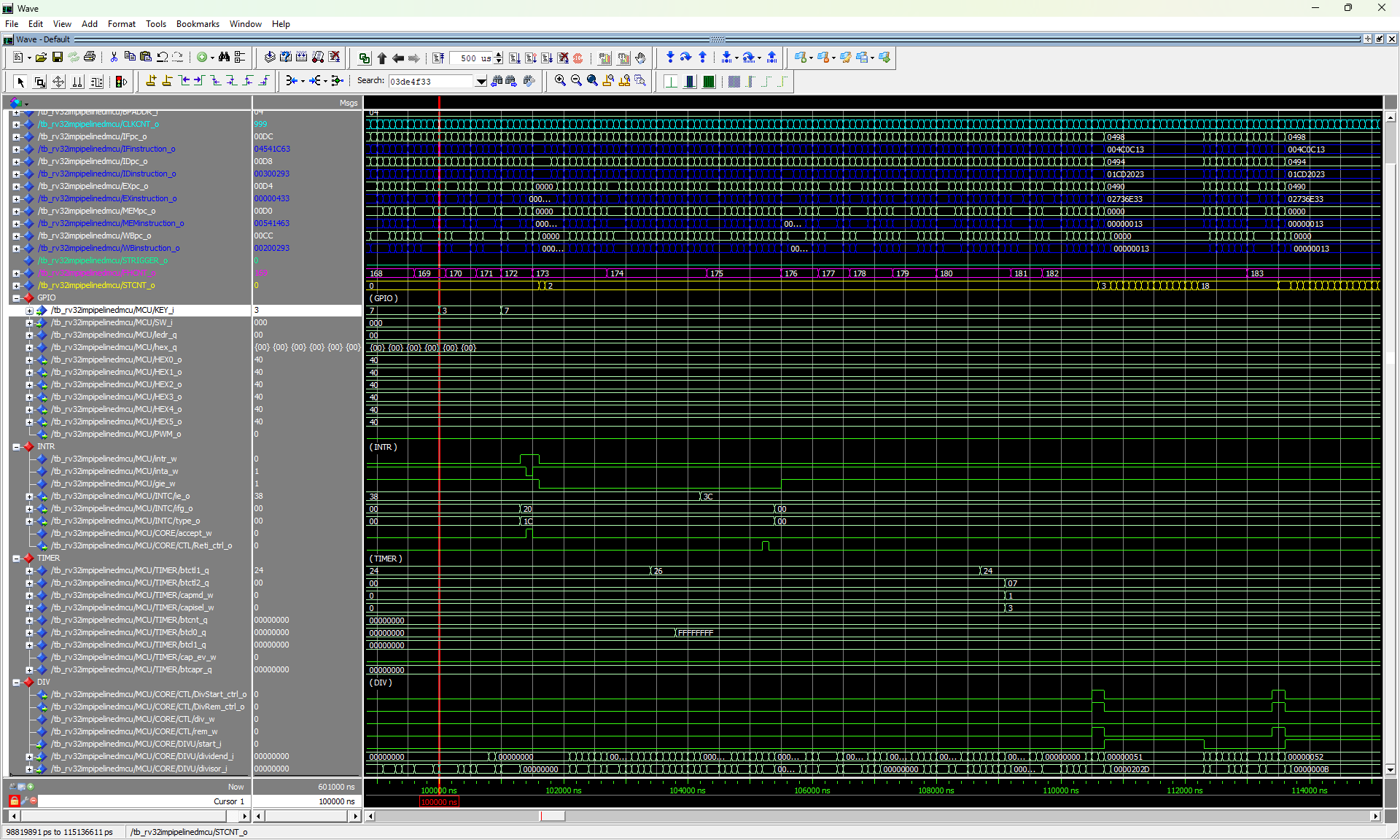
Screenshots/ModelSim/RV32IMpipelinedMCU/interrupt_test4_key3.png
