Adar-Shapira/rv32im-mcu-project/Screenshots/ModelSim/RV32IMpipelinedMCU/interrupt_test4_key3_div.png

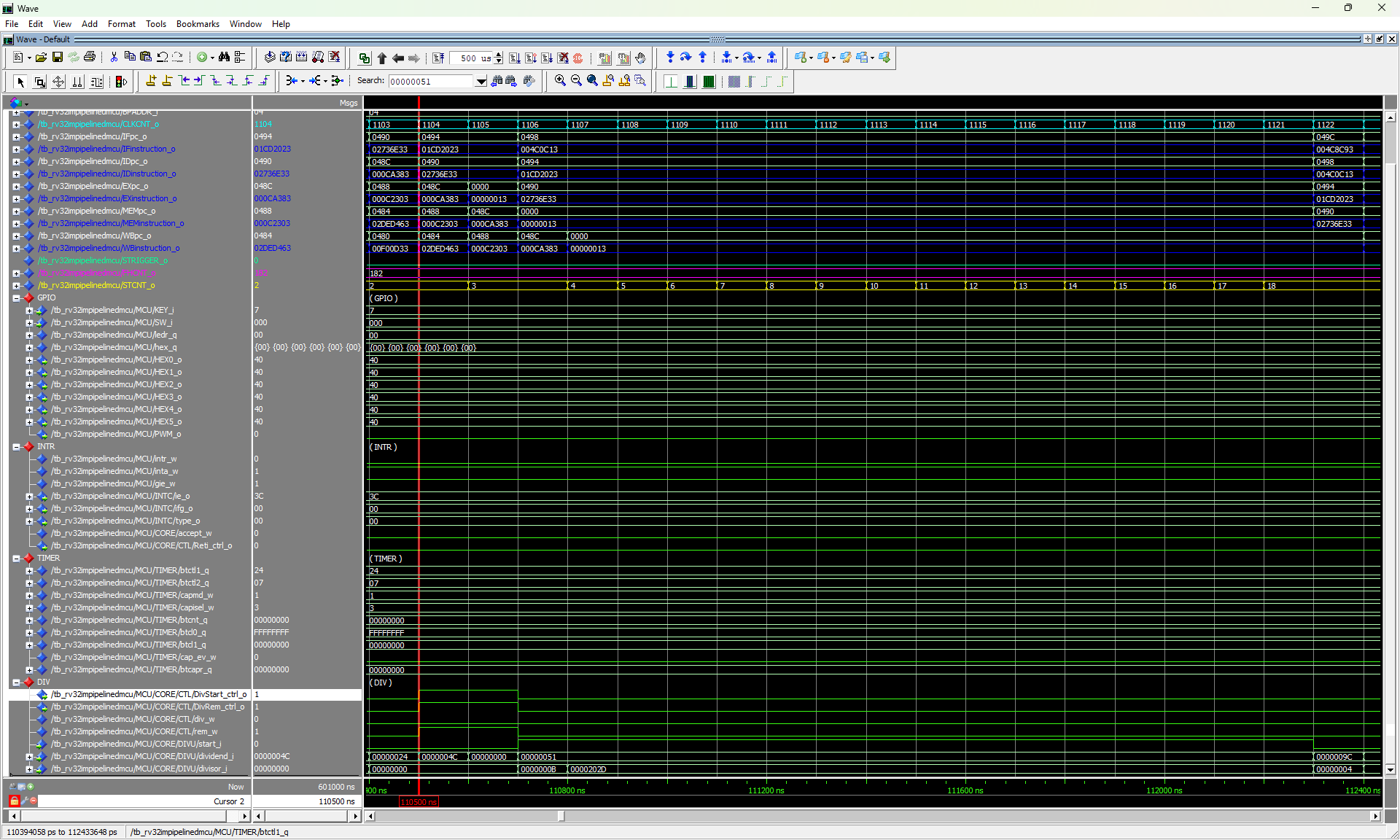
Screenshots/ModelSim/RV32IMpipelinedMCU/interrupt_test4_key3_div.png
