Adar-Shapira/rv32im-mcu-project/Screenshots/ModelSim/RV32IMpipelinedMCU/RV32IM_test1_div.png

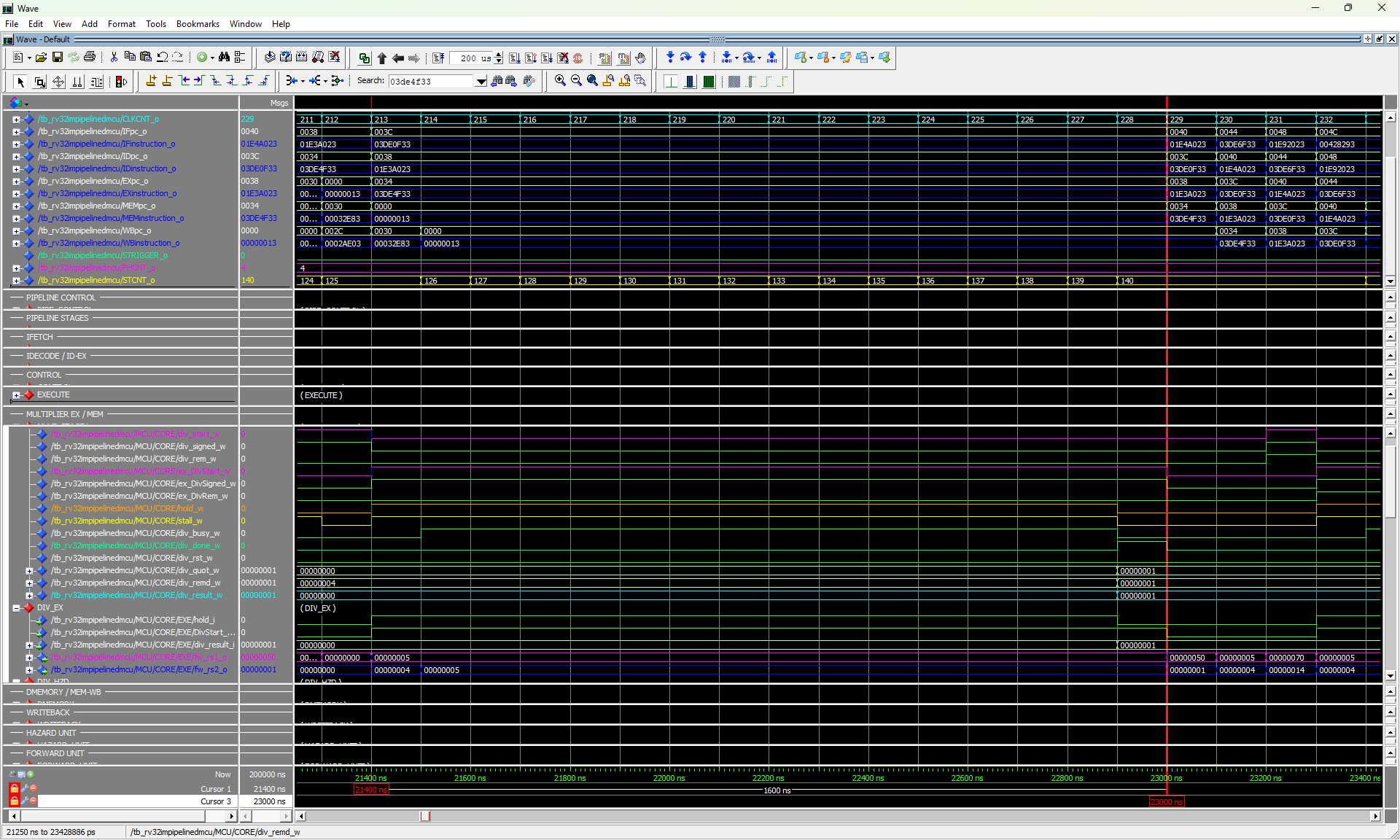
Screenshots/ModelSim/RV32IMpipelinedMCU/RV32IM_test1_div.png
