Adar-Shapira/rv32im-mcu-project/Screenshots/ModelSim/RV32IMscMCU/GPIO_test0.png

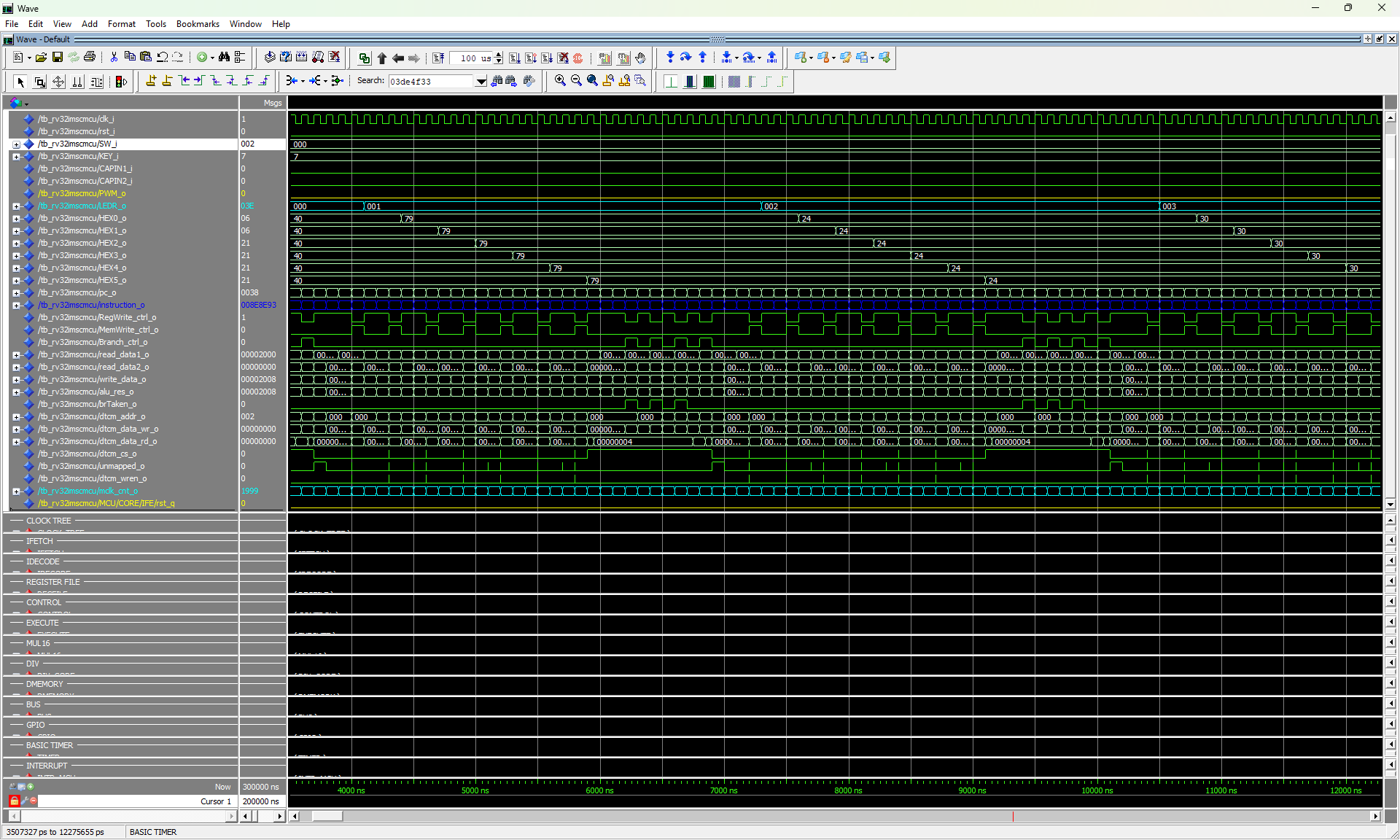
Screenshots/ModelSim/RV32IMscMCU/GPIO_test0.png
