Adar-Shapira/rv32im-mcu-project/Screenshots/ModelSim/RV32IMscMCU/RV32IM_test1_div_start.png

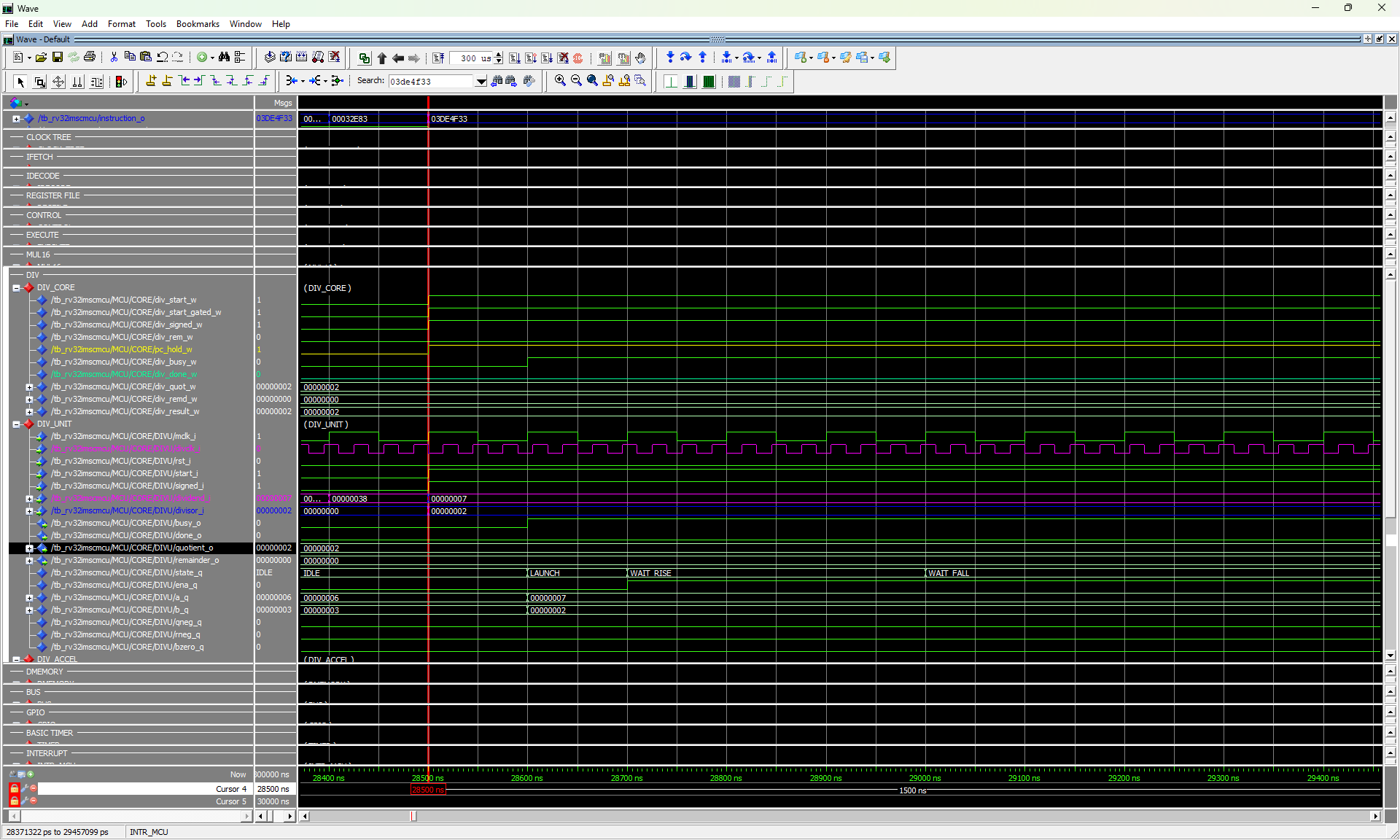
Screenshots/ModelSim/RV32IMscMCU/RV32IM_test1_div_start.png
