Adar-Shapira/rv32im-mcu-project/Screenshots/ModelSim/RV32IMscMCU/RV32IM_test1_end_of_test.png

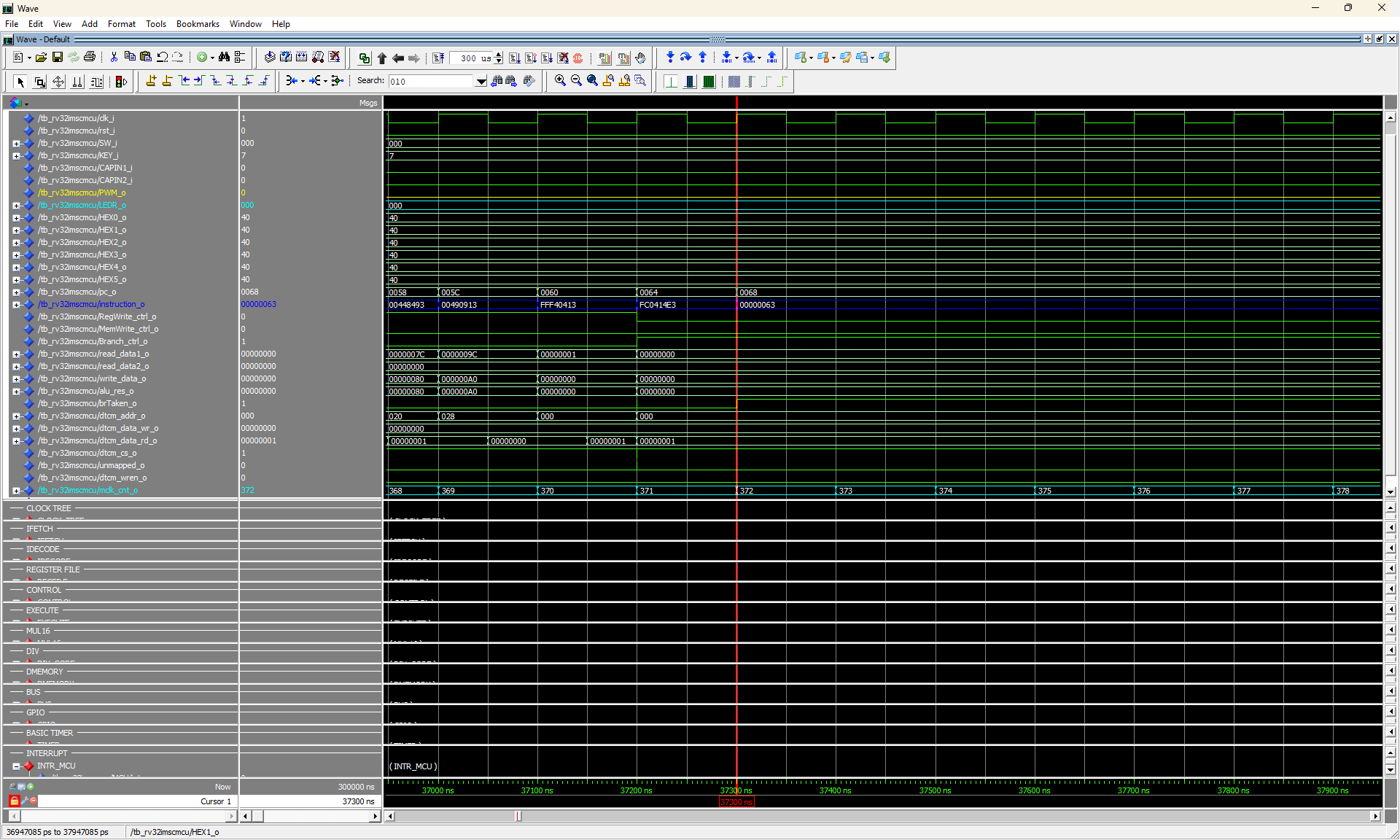
Screenshots/ModelSim/RV32IMscMCU/RV32IM_test1_end_of_test.png
