Adar-Shapira/rv32im-mcu-project/209580208_211468582/DUT/RV32IMpipelinedMCU/RV32IM_PIPE_CORE.vhd

--============================================================================
-- Copyright 2026 Hananya Ribo 
-- Advanced CPU architecture and Hardware Accelerators Lab 361-1-4693 BGU
-- Top Level Structural Model for Pipelined RISC-V RV32IM Core (Figure 8)
-- Instantiates the 5 pipeline stages (IF | ID | EX | MEM | WB) plus
-- HAZARD_UNIT and FORWARD_UNIT, and generates
-- the two global pipeline-control signals:
--   * stall_w - from HAZARD_UNIT (load-use interlock): freezes PC + IF/ID
--     and bubbles ID/EX
--   * flush_w - taken branch / jal / jalr resolved in the MEM stage
--     (EX/MEM register outputs): redirects the PC and kills the 3 younger
--     instructions (IF/ID, ID/EX and EX/MEM get bubbles) => depth = 3
-- The redirect target is the branch address adder result (branch/jal) or
-- the ALU result (jalr), both carried in the EX/MEM register.
-- Debug additions per Figure 8 (vs the single-cycle top): CLKCNT_o clock
-- counter, STCNT_o stall counter, FHCNT_o flush counter, and the BPADDR_i
-- breakpoint register compared against the IF-stage PC (word granularity)
-- to produce the SignalTap trigger STRIGGER_o.
--============================================================================ 
LIBRARY IEEE;
USE IEEE.STD_LOGIC_1164.ALL;
USE IEEE.STD_LOGIC_ARITH.ALL;
use ieee.std_logic_unsigned.all;
USE work.cond_compilation_package.all;
USE work.const_package.all;
USE work.aux_package.all;


ENTITY RV32IM_PIPE_CORE IS
	generic( 
			WORD_GRANULARITY 	: boolean 	:= G_WORD_GRANULARITY;
	    	MODELSIM 			: integer 	:= G_MODELSIM;
			DATA_BUS_WIDTH 		: integer 	:= 32;
			ITCM_ADDR_WIDTH 	: integer 	:= G_ADDRWIDTH;
			DTCM_ADDR_WIDTH 	: integer 	:= G_ADDRWIDTH;
			PC_WIDTH 			: integer 	:= G_PC_WIDTH;
			MA_WIDTH 			: integer 	:= G_MA_WIDTH;
			DATA_WORDS_NUM 		: integer 	:= G_DATA_WORDSNUM;
			CLK_CNT_WIDTH 		: integer 	:= 16;
			STCNT_WIDTH 		: integer 	:= 16;
			FHCNT_WIDTH 		: integer 	:= 16;
			BP_ADDR_WIDTH 		: integer 	:= 8
	);
	PORT(	
		--Inputs
		rst_i		 			:IN		STD_LOGIC;
		clk_i					:IN		STD_LOGIC;		-- mclk, from CLOCK_TREE (Phase 4C / slice 1)
		divclk_i				:IN		STD_LOGIC := '0';	-- accelclk; divider in slice 3

		-- Interrupt handshake (slice 4). Defaulted so slice 1 elaborates:
		-- no request, INTA idles high, GIE reads 0.
		intr_i					:IN		STD_LOGIC := '0';
		inta_o					:OUT	STD_LOGIC;
		gie_o					:OUT	STD_LOGIC;

		-- Data-bus master interface -- slice 1 (G-305). Same contract as
		-- DUT/RV32IMscMCU/RV32IM_CORE.vhd. Functional, not Signal-Tap.
		dbus_addr_o				:OUT	STD_LOGIC_VECTOR(DATA_ADDR_WIDTH-1 DOWNTO 0);
		dbus_wdata_o			:OUT	STD_LOGIC_VECTOR(DATA_BUS_WIDTH-1 DOWNTO 0);
		dbus_MemRead_o			:OUT	STD_LOGIC;
		dbus_MemWrite_o			:OUT	STD_LOGIC;
		dtcm_cs_i				:IN		STD_LOGIC := '1';
		dbus_rdata_i			:IN		STD_LOGIC_VECTOR(DATA_BUS_WIDTH-1 DOWNTO 0) := (OTHERS => '0');
		dtcm_wren_o				:OUT	STD_LOGIC;

		BPADDR_i				:IN		STD_LOGIC_VECTOR(BP_ADDR_WIDTH-1 DOWNTO 0);	-- breakpoint word address (SW7-SW0)
		
		-- Figure 8 SignalTap observation interface
		CLKCNT_o				:OUT	STD_LOGIC_VECTOR(CLK_CNT_WIDTH-1 DOWNTO 0);
		IFpc_o					:OUT	STD_LOGIC_VECTOR(PC_WIDTH-1 DOWNTO 0);
		IFinstruction_o			:OUT	STD_LOGIC_VECTOR(DATA_BUS_WIDTH-1 DOWNTO 0);
		IDpc_o					:OUT	STD_LOGIC_VECTOR(PC_WIDTH-1 DOWNTO 0);
		IDinstruction_o			:OUT	STD_LOGIC_VECTOR(DATA_BUS_WIDTH-1 DOWNTO 0);
		EXpc_o					:OUT	STD_LOGIC_VECTOR(PC_WIDTH-1 DOWNTO 0);
		EXinstruction_o			:OUT	STD_LOGIC_VECTOR(DATA_BUS_WIDTH-1 DOWNTO 0);
		MEMpc_o					:OUT	STD_LOGIC_VECTOR(PC_WIDTH-1 DOWNTO 0);
		MEMinstruction_o		:OUT	STD_LOGIC_VECTOR(DATA_BUS_WIDTH-1 DOWNTO 0);
		WBpc_o					:OUT	STD_LOGIC_VECTOR(PC_WIDTH-1 DOWNTO 0);
		WBinstruction_o			:OUT	STD_LOGIC_VECTOR(DATA_BUS_WIDTH-1 DOWNTO 0);
		STRIGGER_o				:OUT	STD_LOGIC;
		FHCNT_o					:OUT	STD_LOGIC_VECTOR(FHCNT_WIDTH-1 DOWNTO 0);
		STCNT_o					:OUT	STD_LOGIC_VECTOR(STCNT_WIDTH-1 DOWNTO 0)
	);		
END RV32IM_PIPE_CORE;
--============================================================================
ARCHITECTURE structure OF RV32IM_PIPE_CORE IS
	-- clock
	SIGNAL mclk_w 				: STD_LOGIC;
	SIGNAL rst_w					: STD_LOGIC;
	-- global pipeline control
	SIGNAL stall_w 				: STD_LOGIC;
	SIGNAL hold_w				: STD_LOGIC;
	SIGNAL flush_w 				: STD_LOGIC;
	SIGNAL redirect_addr_w		: STD_LOGIC_VECTOR(PC_WIDTH-1 DOWNTO 0);
	-- IF stage / IF-ID register outputs
	SIGNAL if_pc_w 				: STD_LOGIC_VECTOR(PC_WIDTH-1 DOWNTO 0);
	SIGNAL if_instruction_w		: STD_LOGIC_VECTOR(DATA_BUS_WIDTH-1 DOWNTO 0);
	SIGNAL id_pc_w 				: STD_LOGIC_VECTOR(PC_WIDTH-1 DOWNTO 0);
	SIGNAL id_pc_plus4_w 		: STD_LOGIC_VECTOR(PC_WIDTH-1 DOWNTO 0);
	SIGNAL id_instruction_w		: STD_LOGIC_VECTOR(DATA_BUS_WIDTH-1 DOWNTO 0);
	-- CONTROL outputs (ID stage, captured by the ID/EX register in IDECODE)
	SIGNAL reg_dst_w 			: STD_LOGIC;
	SIGNAL reg_write_w 			: STD_LOGIC;
	SIGNAL MemtoReg_w 			: STD_LOGIC;
	SIGNAL mem_read_w 			: STD_LOGIC;
	SIGNAL mem_write_w 			: STD_LOGIC;
	SIGNAL branch_w 			: STD_LOGIC;
	SIGNAL Jal_ctrl_w 			: STD_LOGIC;
	SIGNAL Jalr_ctrl_w 			: STD_LOGIC;
	SIGNAL alu_src_w 			: STD_LOGIC;
	SIGNAL upper_im_w			: STD_LOGIC_VECTOR(1 DOWNTO 0);
	SIGNAL alu_op_w 			: STD_LOGIC_VECTOR(4 DOWNTO 0);
	SIGNAL mem_op_w				: STD_LOGIC_VECTOR(2 DOWNTO 0);
	SIGNAL div_start_w			: STD_LOGIC;
	SIGNAL div_signed_w			: STD_LOGIC;
	SIGNAL div_rem_w			: STD_LOGIC;
	-- IDECODE outputs: ID stage (hazard check) + WB write-back data
	SIGNAL id_rs1_w 			: STD_LOGIC_VECTOR(4 DOWNTO 0);
	SIGNAL id_rs2_w 			: STD_LOGIC_VECTOR(4 DOWNTO 0);
	SIGNAL wb_write_data_w		: STD_LOGIC_VECTOR(DATA_BUS_WIDTH-1 DOWNTO 0);
	-- ID/EX register outputs (EX-stage view)
	SIGNAL ex_pc_w 				: STD_LOGIC_VECTOR(PC_WIDTH-1 DOWNTO 0);
	SIGNAL ex_pc_plus4_w 		: STD_LOGIC_VECTOR(PC_WIDTH-1 DOWNTO 0);
	SIGNAL ex_instruction_w		: STD_LOGIC_VECTOR(DATA_BUS_WIDTH-1 DOWNTO 0);
	SIGNAL ex_read_data1_w 		: STD_LOGIC_VECTOR(DATA_BUS_WIDTH-1 DOWNTO 0);
	SIGNAL ex_read_data2_w 		: STD_LOGIC_VECTOR(DATA_BUS_WIDTH-1 DOWNTO 0);
	SIGNAL ex_sign_ext_w 		: STD_LOGIC_VECTOR(DATA_BUS_WIDTH-1 DOWNTO 0);
	SIGNAL ex_rs1_w 			: STD_LOGIC_VECTOR(4 DOWNTO 0);
	SIGNAL ex_rs2_w 			: STD_LOGIC_VECTOR(4 DOWNTO 0);
	SIGNAL ex_rd_w 				: STD_LOGIC_VECTOR(4 DOWNTO 0);
	SIGNAL ex_ALUSrc_w 			: STD_LOGIC;
	SIGNAL ex_UpperIm_w 		: STD_LOGIC_VECTOR(1 DOWNTO 0);
	SIGNAL ex_ALUOp_w 			: STD_LOGIC_VECTOR(4 DOWNTO 0);
	SIGNAL ex_Branch_w 			: STD_LOGIC;
	SIGNAL ex_Jal_w 			: STD_LOGIC;
	SIGNAL ex_Jalr_w 			: STD_LOGIC;
	SIGNAL ex_MemRead_w 		: STD_LOGIC;
	SIGNAL ex_MemWrite_w 		: STD_LOGIC;
	SIGNAL ex_MemOp_w			: STD_LOGIC_VECTOR(2 DOWNTO 0);
	SIGNAL ex_DivStart_w		: STD_LOGIC;
	SIGNAL ex_DivSigned_w		: STD_LOGIC;
	SIGNAL ex_DivRem_w			: STD_LOGIC;
	SIGNAL ex_RegDst_w 			: STD_LOGIC;
	SIGNAL ex_RegWrite_w 		: STD_LOGIC;
	SIGNAL ex_MemtoReg_w 		: STD_LOGIC;
	-- EX/MEM register outputs (MEM-stage view)
	SIGNAL mem_pc_w 				: STD_LOGIC_VECTOR(PC_WIDTH-1 DOWNTO 0);
	SIGNAL mem_pc_plus4_w 		: STD_LOGIC_VECTOR(PC_WIDTH-1 DOWNTO 0);
	SIGNAL mem_instruction_w	: STD_LOGIC_VECTOR(DATA_BUS_WIDTH-1 DOWNTO 0);
	SIGNAL mem_alu_res_w 		: STD_LOGIC_VECTOR(DATA_BUS_WIDTH-1 DOWNTO 0);
	SIGNAL mem_write_data_w		: STD_LOGIC_VECTOR(DATA_BUS_WIDTH-1 DOWNTO 0);
	SIGNAL mem_addr_gen_w 		: STD_LOGIC_VECTOR(PC_WIDTH-1 DOWNTO 0);
	SIGNAL mem_brTaken_w 		: STD_LOGIC;
	SIGNAL mem_rd_w 			: STD_LOGIC_VECTOR(4 DOWNTO 0);
	SIGNAL mem_mul_p0_w			: STD_LOGIC_VECTOR(15 DOWNTO 0);
	SIGNAL mem_mul_p1_w			: STD_LOGIC_VECTOR(15 DOWNTO 0);
	SIGNAL mem_mul_p2_w			: STD_LOGIC_VECTOR(15 DOWNTO 0);
	SIGNAL mem_mul_p3_w			: STD_LOGIC_VECTOR(15 DOWNTO 0);
	SIGNAL mem_Mul_w			: STD_LOGIC;
	SIGNAL mem_Branch_w 		: STD_LOGIC;
	SIGNAL mem_Jal_w 			: STD_LOGIC;
	SIGNAL mem_Jalr_w 			: STD_LOGIC;
	SIGNAL mem_Reti_w			: STD_LOGIC;
	SIGNAL mem_MemRead_w 		: STD_LOGIC;
	SIGNAL mem_MemWrite_w 		: STD_LOGIC;
	SIGNAL mem_MemOp_w			: STD_LOGIC_VECTOR(2 DOWNTO 0);
	SIGNAL mem_RegDst_w 		: STD_LOGIC;
	SIGNAL mem_RegWrite_w 		: STD_LOGIC;
	SIGNAL mem_MemtoReg_w 		: STD_LOGIC;
	-- MEM stage
	SIGNAL dtcm_addr_w 			: STD_LOGIC_VECTOR(DTCM_ADDR_WIDTH-1 DOWNTO 0);
	SIGNAL mem_forward_data_w	: STD_LOGIC_VECTOR(DATA_BUS_WIDTH-1 DOWNTO 0);
	-- MEM/WB register outputs (WB-stage view)
	SIGNAL wb_pc_w 				: STD_LOGIC_VECTOR(PC_WIDTH-1 DOWNTO 0);
	SIGNAL wb_pc_plus4_w 		: STD_LOGIC_VECTOR(PC_WIDTH-1 DOWNTO 0);
	SIGNAL wb_instruction_w		: STD_LOGIC_VECTOR(DATA_BUS_WIDTH-1 DOWNTO 0);
	SIGNAL wb_alu_res_w 		: STD_LOGIC_VECTOR(DATA_BUS_WIDTH-1 DOWNTO 0);
	SIGNAL wb_dtcm_data_rd_w	: STD_LOGIC_VECTOR(DATA_BUS_WIDTH-1 DOWNTO 0);
	SIGNAL wb_rd_w 				: STD_LOGIC_VECTOR(4 DOWNTO 0);
	SIGNAL wb_RegDst_w 			: STD_LOGIC;
	SIGNAL wb_RegWrite_w 		: STD_LOGIC;
	SIGNAL wb_MemtoReg_w 		: STD_LOGIC;
	-- forwarding mux selects
	SIGNAL forward_a_w 			: STD_LOGIC_VECTOR(1 DOWNTO 0);
	SIGNAL forward_b_w 			: STD_LOGIC_VECTOR(1 DOWNTO 0);
	SIGNAL ex_fw_rs1_w			: STD_LOGIC_VECTOR(DATA_BUS_WIDTH-1 DOWNTO 0);
	SIGNAL ex_fw_rs2_w			: STD_LOGIC_VECTOR(DATA_BUS_WIDTH-1 DOWNTO 0);
	SIGNAL div_busy_w			: STD_LOGIC;
	SIGNAL div_done_w			: STD_LOGIC;
	SIGNAL div_quot_w			: STD_LOGIC_VECTOR(DATA_BUS_WIDTH-1 DOWNTO 0);
	SIGNAL div_remd_w			: STD_LOGIC_VECTOR(DATA_BUS_WIDTH-1 DOWNTO 0);
	SIGNAL div_result_w			: STD_LOGIC_VECTOR(DATA_BUS_WIDTH-1 DOWNTO 0);
	SIGNAL div_rst_w			: STD_LOGIC;
	SIGNAL reti_w				: STD_LOGIC;
	SIGNAL ex_Reti_w			: STD_LOGIC;
	-- Slice 4 -- MEM-retirement interrupt entry FSM (plan Assumption).
	TYPE intr_state_t IS (I_IDLE, I_CYC1, I_CYC2);
	SIGNAL istate_q				: intr_state_t;
	SIGNAL intr_q				: STD_LOGIC;
	SIGNAL accept_w				: STD_LOGIC;
	SIGNAL cyc1_w				: STD_LOGIC;
	SIGNAL cyc2_w				: STD_LOGIC;
	SIGNAL annul_w				: STD_LOGIC;
	SIGNAL type_q				: STD_LOGIC_VECTOR(7 DOWNTO 0);
	SIGNAL vec_word_addr_w		: STD_LOGIC_VECTOR(DTCM_ADDR_WIDTH-1 DOWNTO 0);
	SIGNAL gie_wr_w				: STD_LOGIC;
	SIGNAL gie_val_w			: STD_LOGIC;
	SIGNAL gie_w				: STD_LOGIC;
	SIGNAL tp_val_w				: STD_LOGIC_VECTOR(DATA_BUS_WIDTH-1 DOWNTO 0);
	SIGNAL br_flush_w			: STD_LOGIC;
	SIGNAL br_redirect_w		: STD_LOGIC_VECTOR(PC_WIDTH-1 DOWNTO 0);
	SIGNAL resume_w				: STD_LOGIC_VECTOR(PC_WIDTH-1 DOWNTO 0);
	SIGNAL resume_pc_q			: STD_LOGIC_VECTOR(PC_WIDTH-1 DOWNTO 0);
	SIGNAL mem_active_w			: STD_LOGIC;
	SIGNAL mem_dtcm_rd_w		: STD_LOGIC_VECTOR(DATA_BUS_WIDTH-1 DOWNTO 0);
	SIGNAL mem_read_core_w		: STD_LOGIC;
	SIGNAL mem_write_core_w		: STD_LOGIC;
	SIGNAL mem_op_eff_w			: STD_LOGIC_VECTOR(2 DOWNTO 0);
	-- debug registers (Figure 8)
	SIGNAL mclk_cnt_q			: STD_LOGIC_VECTOR(CLK_CNT_WIDTH-1 DOWNTO 0);	-- CLKCNT
	SIGNAL stcnt_q				: STD_LOGIC_VECTOR(STCNT_WIDTH-1 DOWNTO 0);		-- STCNT
	SIGNAL fhcnt_q				: STD_LOGIC_VECTOR(FHCNT_WIDTH-1 DOWNTO 0);		-- FHCNT
	SIGNAL bpaddr_q				: STD_LOGIC_VECTOR(BP_ADDR_WIDTH-1 DOWNTO 0);	-- BPADDR breakpoint register

BEGIN
	-- RESET POLARITY IS THE WRAPPER'S JOB, NOT THIS FILE'S -- corrected 2026-08-26.
	rst_w <= rst_i;

	-- Phase 4C / slice 1: THE CORE NO LONGER MAKES ITS OWN CLOCK.
	-- Figure 1 puts the Clock Tree at the MCU level. clk_i is mclk from CLOCK_TREE.
	-- Reference: DUT/RV32IMscMCU/RV32IM_CORE.vhd:212.
	mclk_w 	<= clk_i;

	--=======================================
	-- Interrupt entry FSM -- slice 4
	--=======================================
	-- THE PROTOCOL is REQ p15 as implemented in DUT/RV32IMscMCU/RV32IM_CORE.vhd
	-- ~214-285. Entry TIMING is a pipeline design decision (plan Assumption):
	-- retirement boundary = MEM. Accept when MEM holds a non-bubble instruction,
	-- INTR is registered, and the divider is idle (F13: div_start OR div_busy).
	-- Resume PC is the successor of the completing MEM instruction (pc+4, or the
	-- branch/jal/jalr target if that instruction redirects). Younger stages are
	-- killed with the existing flush. Cycle 1/2 TYPE capture + vector fetch are
	-- the same handshake as SC so INTERRUPT_CTRL is reused as-is.
	--
	-- Live INTR (intr_i) is ANDed with the registered request (intr_q).
	-- INTERRUPT_CTRL: a spurious INTA with nothing pending pushes TYPE=0, and
	-- Mem[0] is `main`. On the pipeline an ISR's IFG W0C can retire in MEM on
	-- the same edge that still captures the previous INTR into intr_q; the next
	-- cycle would then INTA with TYPE=0 and jump to reset. SC's one-cycle
	-- machine rarely overlaps that write with the lag flop; the pipeline does.
	-- intr_q still provides REQ p15's one-cycle delay after INTR rises.
	--
	-- x0-only RegWrite is NOT a retirement point. IFETCH flush injects
	-- addi x0,x0,0 with pc=0 / pc+4=0 into IF/ID (IFETCH.vhd:152-155). That
	-- NOP then flows as a "real" instruction: CONTROL sets RegWrite, so a
	-- naive OR of the MEM control bits would accept on it and capture
	-- resume=0. After reti the core re-runs `main`. The idle loops of
	-- tests 2-4 are taken-branch storms, so KEY INTR almost always meets
	-- one of those bubbles. SC has no flush bubbles. Loads/stores/branches
	-- /jal/jalr (including reti, rd=x0) still count; a source-level `nop`
	-- is skipped and the next MEM instruction is the accept point.
	mem_active_w	<= '1' WHEN ((mem_RegWrite_w = '1' AND mem_rd_w /= "00000") OR
								 mem_MemWrite_w = '1' OR mem_MemRead_w = '1' OR
								 mem_Branch_w = '1' OR mem_Jal_w = '1' OR
								 mem_Jalr_w = '1')
					   ELSE '0';

	accept_w	<= '1' WHEN (istate_q = I_IDLE AND intr_q = '1' AND intr_i = '1' AND
							 mem_active_w = '1' AND
							 ex_DivStart_w = '0' AND div_busy_w = '0')
					ELSE '0';
	inta_o		<= NOT accept_w;

	cyc1_w		<= '1' WHEN istate_q = I_CYC1 ELSE '0';
	cyc2_w		<= '1' WHEN istate_q = I_CYC2 ELSE '0';
	annul_w		<= cyc1_w OR cyc2_w;

	process(mclk_w, rst_w)
	begin
		if rst_w = '1' then
			istate_q	<= I_IDLE;
			intr_q		<= '0';
			type_q		<= (OTHERS => '0');
			resume_pc_q	<= (OTHERS => '0');
		elsif rising_edge(mclk_w) then
			intr_q <= intr_i;
			case istate_q is
				when I_IDLE =>
					if accept_w = '1' then
						resume_pc_q	<= resume_w;
						istate_q	<= I_CYC1;
					end if;
				when I_CYC1 =>
					-- REQ p15 Cycle 1: capture TYPE from the data bus. RAW
					-- dbus_rdata_i, not the region-muxed load (SC CORE:269-273).
					type_q	 <= dbus_rdata_i(7 DOWNTO 0);
					istate_q <= I_CYC2;
				when I_CYC2 =>
					istate_q <= I_IDLE;
			end case;
		end if;
	end process;

	gie_wr_w	<= cyc1_w OR (mem_Reti_w AND (NOT annul_w));
	gie_val_w	<= mem_Reti_w AND (NOT annul_w);
	tp_val_w	<= ZEROS_DBUS2PCADDR & resume_pc_q;
	
	--=================================================
	-- Global pipeline control: flush / redirect (MEM)
	--=================================================
	br_flush_w		<=	(mem_Branch_w AND mem_brTaken_w) OR mem_Jal_w OR mem_Jalr_w;
	flush_w			<=	br_flush_w OR accept_w OR cyc1_w OR cyc2_w;

	br_redirect_w	<=	mem_alu_res_w(PC_WIDTH-1 DOWNTO 1) & '0'	WHEN mem_Jalr_w = '1' ELSE
						mem_addr_gen_w;
	resume_w		<=	br_redirect_w WHEN br_flush_w = '1' ELSE mem_pc_plus4_w;

	-- cyc2 vector is an IFETCH IntrVec arm, not this mux. accept uses the live
	-- resume; cyc1 recirculates the captured resume (MEM is a bubble by then).
	redirect_addr_w	<=	resume_pc_q	WHEN cyc1_w = '1' ELSE
						resume_w	WHEN accept_w = '1' ELSE
						br_redirect_w;
	
	--===========================================
	-- IFETCH (including ITCM) module connection
	--===========================================
	IFE : Ifetch
	generic map(
		WORD_GRANULARITY	=> 	WORD_GRANULARITY,
		DATA_BUS_WIDTH		=> 	DATA_BUS_WIDTH, 
		PC_WIDTH			=>	PC_WIDTH,
		ITCM_ADDR_WIDTH		=>	ITCM_ADDR_WIDTH,
		WORDS_NUM			=>	DATA_WORDS_NUM
	)
	PORT MAP (
		--Inputs
		clk_i 				=> mclk_w,  
		rst_i 				=> rst_w,
		stall_i 			=> stall_w,
		flush_i 			=> flush_w,
		redirect_addr_i		=> redirect_addr_w,
		IntrVec_ctrl_i		=> cyc2_w,
		intr_vector_i		=> mem_dtcm_rd_w(PC_WIDTH-1 DOWNTO 0),
		
		--Outputs
		if_pc_o 			=> if_pc_w,
		if_instruction_o	=> if_instruction_w,
		pc_o 				=> id_pc_w,
		pc_plus4_o	 		=> id_pc_plus4_w,
		instruction_o 		=> id_instruction_w    
	);
	--=======================================
	-- CONTROL module connection (ID stage)
	--=======================================
	CTL:   control
	PORT MAP ( 	
		--Inputs
		instruction_i 		=> id_instruction_w,
		
		--Outputs
		RegDst_ctrl_o		=> reg_dst_w,
		ALUSrc_ctrl_o 		=> alu_src_w,
		MemtoReg_ctrl_o 	=> MemtoReg_w,
		RegWrite_ctrl_o 	=> reg_write_w,
		MemRead_ctrl_o 		=> mem_read_w,
		MemWrite_ctrl_o 	=> mem_write_w,
		Branch_ctrl_o 		=> branch_w,
		Jal_ctrl_o 			=> Jal_ctrl_w,
		Jalr_ctrl_o			=> Jalr_ctrl_w,
		UpperIm_ctrl_o 		=> upper_im_w,
		ALUOp_ctrl_o 		=> alu_op_w,
		MemOp_ctrl_o		=> mem_op_w,
		DivStart_ctrl_o		=> div_start_w,
		DivSigned_ctrl_o	=> div_signed_w,
		DivRem_ctrl_o		=> div_rem_w,
		Reti_ctrl_o			=> reti_w
	);
	--==================================================
	-- IDECODE module connection (ID stage + RF + ID/EX)
	--==================================================
	ID : Idecode
	generic map(
		PC_WIDTH			=>	PC_WIDTH,
		DATA_BUS_WIDTH		=>  DATA_BUS_WIDTH
	)
	PORT MAP (	
		--Inputs
		clk_i 				=> mclk_w,  
		rst_i 				=> rst_w,
		stall_i 			=> stall_w,
		hold_i				=> hold_w,
		flush_i 			=> flush_w,
		pc_i				=> id_pc_w,
		pc_plus4_i	 		=> id_pc_plus4_w,
    	instruction_i 		=> id_instruction_w,
		RegDst_ctrl_i		=> reg_dst_w,
		RegWrite_ctrl_i 	=> reg_write_w,
		MemtoReg_ctrl_i 	=> MemtoReg_w,
		MemRead_ctrl_i 		=> mem_read_w,
		MemWrite_ctrl_i 	=> mem_write_w,
		MemOp_ctrl_i		=> mem_op_w,
		DivStart_ctrl_i		=> div_start_w,
		DivSigned_ctrl_i	=> div_signed_w,
		DivRem_ctrl_i		=> div_rem_w,
		Reti_ctrl_i			=> reti_w,
		Branch_ctrl_i 		=> branch_w,
		Jal_ctrl_i 			=> Jal_ctrl_w,
		Jalr_ctrl_i 		=> Jalr_ctrl_w,
		ALUSrc_ctrl_i 		=> alu_src_w,
		UpperIm_ctrl_i 		=> upper_im_w,
		ALUOp_ctrl_i 		=> alu_op_w,
		wb_RegWrite_ctrl_i 	=> wb_RegWrite_w,
		wb_rd_i 			=> wb_rd_w,
		wb_write_data_i 	=> wb_write_data_w,
		IntrGieWr_i			=> gie_wr_w,
		IntrGieVal_i		=> gie_val_w,
		IntrTpWr_i			=> cyc2_w,
		IntrTpVal_i			=> tp_val_w,
		
		--Outputs
		id_rs1_o 			=> id_rs1_w,
		id_rs2_o 			=> id_rs2_w,
		ex_pc_o 			=> ex_pc_w,
		ex_pc_plus4_o 		=> ex_pc_plus4_w,
		ex_instruction_o	=> ex_instruction_w,
		ex_read_data1_o 	=> ex_read_data1_w,
    	ex_read_data2_o 	=> ex_read_data2_w,
		ex_sign_ext_o 		=> ex_sign_ext_w,
		ex_rs1_o 			=> ex_rs1_w,
		ex_rs2_o 			=> ex_rs2_w,
		ex_rd_o 			=> ex_rd_w,
		ex_ALUSrc_ctrl_o 	=> ex_ALUSrc_w,
		ex_UpperIm_ctrl_o 	=> ex_UpperIm_w,
		ex_ALUOp_ctrl_o 	=> ex_ALUOp_w,
		ex_Branch_ctrl_o 	=> ex_Branch_w,
		ex_Jal_ctrl_o 		=> ex_Jal_w,
		ex_Jalr_ctrl_o 		=> ex_Jalr_w,
		ex_MemRead_ctrl_o 	=> ex_MemRead_w,
		ex_MemWrite_ctrl_o 	=> ex_MemWrite_w,
		ex_MemOp_ctrl_o		=> ex_MemOp_w,
		ex_DivStart_ctrl_o	=> ex_DivStart_w,
		ex_DivSigned_ctrl_o	=> ex_DivSigned_w,
		ex_DivRem_ctrl_o	=> ex_DivRem_w,
		ex_Reti_ctrl_o		=> ex_Reti_w,
		ex_RegDst_ctrl_o 	=> ex_RegDst_w,
		ex_RegWrite_ctrl_o 	=> ex_RegWrite_w,
		ex_MemtoReg_ctrl_o 	=> ex_MemtoReg_w,
		gie_o				=> gie_w
	);
	--=================================================
	-- EXECUTE module connection (EX stage + EX/MEM)
	--=================================================
	EXE:  Execute
  	generic map(
		DATA_BUS_WIDTH 		=> 	DATA_BUS_WIDTH,
		PC_WIDTH 			=>	PC_WIDTH
	)
	PORT MAP (	
		--Inputs
		clk_i 				=> mclk_w,
		rst_i 				=> rst_w,
		flush_i 			=> flush_w,
		hold_i				=> hold_w,
		pc_i				=> ex_pc_w,
		pc_plus4_i 			=> ex_pc_plus4_w,
		instruction_i		=> ex_instruction_w,
		read_data1_i 		=> ex_read_data1_w,
    	read_data2_i 		=> ex_read_data2_w,
		sign_extend_i 		=> ex_sign_ext_w,
		rd_i 				=> ex_rd_w,
		UpperIm_ctrl_i 		=> ex_UpperIm_w,
		ALUOp_ctrl_i 		=> ex_ALUOp_w,
		ALUSrc_ctrl_i 		=> ex_ALUSrc_w,
		Branch_ctrl_i 		=> ex_Branch_w,
		Jal_ctrl_i 			=> ex_Jal_w,
		Jalr_ctrl_i 		=> ex_Jalr_w,
		MemRead_ctrl_i 		=> ex_MemRead_w,
		MemWrite_ctrl_i 	=> ex_MemWrite_w,
		MemOp_ctrl_i		=> ex_MemOp_w,
		DivStart_ctrl_i		=> ex_DivStart_w,
		div_result_i		=> div_result_w,
		Reti_ctrl_i			=> ex_Reti_w,
		RegDst_ctrl_i 		=> ex_RegDst_w,
		RegWrite_ctrl_i 	=> ex_RegWrite_w,
		MemtoReg_ctrl_i 	=> ex_MemtoReg_w,
		forward_a_i 		=> forward_a_w,
		forward_b_i 		=> forward_b_w,
		mem_forward_data_i	=> mem_forward_data_w,
		wb_write_data_i 	=> wb_write_data_w,
		
		--Outputs
		mem_pc_o 			=> mem_pc_w,
		mem_pc_plus4_o 		=> mem_pc_plus4_w,
		mem_instruction_o	=> mem_instruction_w,
		mem_alu_res_o 		=> mem_alu_res_w,
		mem_write_data_o 	=> mem_write_data_w,
		mem_addr_gen_o 		=> mem_addr_gen_w,
		mem_brTaken_o 		=> mem_brTaken_w,
		mem_rd_o 			=> mem_rd_w,
		mem_mul_p0_o		=> mem_mul_p0_w,
		mem_mul_p1_o		=> mem_mul_p1_w,
		mem_mul_p2_o		=> mem_mul_p2_w,
		mem_mul_p3_o		=> mem_mul_p3_w,
		mem_Mul_ctrl_o		=> mem_Mul_w,
		mem_Branch_ctrl_o 	=> mem_Branch_w,
		mem_Jal_ctrl_o 		=> mem_Jal_w,
		mem_Jalr_ctrl_o 	=> mem_Jalr_w,
		mem_Reti_ctrl_o		=> mem_Reti_w,
		mem_MemRead_ctrl_o 	=> mem_MemRead_w,
		mem_MemWrite_ctrl_o => mem_MemWrite_w,
		mem_MemOp_ctrl_o	=> mem_MemOp_w,
		mem_RegDst_ctrl_o 	=> mem_RegDst_w,
		mem_RegWrite_ctrl_o => mem_RegWrite_w,
		mem_MemtoReg_ctrl_o => mem_MemtoReg_w,
		fw_rs1_o			=> ex_fw_rs1_w,
		fw_rs2_o			=> ex_fw_rs2_w
	);

	div_rst_w		<= rst_w OR (flush_w AND ex_DivStart_w);
	div_result_w	<= div_remd_w WHEN ex_DivRem_w = '1' ELSE div_quot_w;

	DIVU : div_unit
	generic map(N => DATA_BUS_WIDTH)
	PORT MAP(
		mclk_i		=> mclk_w,
		divclk_i	=> divclk_i,
		rst_i		=> div_rst_w,
		start_i		=> ex_DivStart_w AND (NOT flush_w),
		signed_i	=> ex_DivSigned_w,
		dividend_i	=> ex_fw_rs1_w,
		divisor_i	=> ex_fw_rs2_w,
		busy_o		=> div_busy_w,
		done_o		=> div_done_w,
		quotient_o	=> div_quot_w,
		remainder_o	=> div_remd_w
	);
	--=================================================
	-- DTCM module connection (MEM stage + MEM/WB)
	--=================================================
	-- Slice 4: entry Cycle 2 hijacks the DTCM address to TYPE's vector word --
	-- SC CORE:481-498. TYPE is a byte offset already a multiple of 4.
	vec_word_addr_w(5 DOWNTO 0)					<= type_q(7 DOWNTO 2);
	vec_word_addr_w(DTCM_ADDR_WIDTH-1 DOWNTO 6)	<= (OTHERS => '0');

	G1: 
	if (WORD_GRANULARITY = True) generate -- i.e. each WORD has a unike address
		dtcm_addr_w	<= vec_word_addr_w WHEN cyc2_w = '1' ELSE
					   mem_alu_res_w(MA_WIDTH-1 DOWNTO 2);
	elsif (WORD_GRANULARITY = False) generate -- i.e. each BYTE has a unike address
		dtcm_addr_w	<= mem_alu_res_w(MA_WIDTH-1 DOWNTO 0);
	end generate;

	mem_read_core_w		<= mem_MemRead_w AND (NOT annul_w);
	mem_write_core_w	<= mem_MemWrite_w AND (NOT annul_w);
	mem_op_eff_w		<= MEM_W WHEN cyc2_w = '1' ELSE mem_MemOp_w;
	
	MEM:  dmemory
	generic map(
		DATA_BUS_WIDTH		=> 	DATA_BUS_WIDTH, 
		DTCM_ADDR_WIDTH		=> 	DTCM_ADDR_WIDTH,
		WORDS_NUM			=>	DATA_WORDS_NUM,
		PC_WIDTH 			=>	PC_WIDTH
	)
	PORT MAP (	
		--Inputs
		clk_i 				=> mclk_w,  
		rst_i 				=> rst_w,
		dtcm_addr_i 		=> dtcm_addr_w,
		dtcm_data_wr_i 		=> mem_write_data_w,
		MemRead_ctrl_i 		=> mem_read_core_w,
		MemWrite_ctrl_i 	=> mem_write_core_w,
		MemOp_ctrl_i		=> mem_op_eff_w,
		byte_sel_i			=> mem_alu_res_w(1 DOWNTO 0),
		dtcm_cs_i			=> dtcm_cs_i,
		dbus_rdata_i		=> dbus_rdata_i,
		vec_fetch_i			=> cyc2_w,
		pc_i 				=> mem_pc_w,
		pc_plus4_i 			=> mem_pc_plus4_w,
		instruction_i		=> mem_instruction_w,
		alu_res_i 			=> mem_alu_res_w,
		rd_i 				=> mem_rd_w,
		mul_p0_i			=> mem_mul_p0_w,
		mul_p1_i			=> mem_mul_p1_w,
		mul_p2_i			=> mem_mul_p2_w,
		mul_p3_i			=> mem_mul_p3_w,
		Mul_ctrl_i			=> mem_Mul_w,
		RegDst_ctrl_i 		=> mem_RegDst_w,
		RegWrite_ctrl_i 	=> mem_RegWrite_w,
		MemtoReg_ctrl_i 	=> mem_MemtoReg_w,
				
		--Outputs
		dtcm_data_rd_o 		=> mem_dtcm_rd_w,
		dtcm_wren_o			=> dtcm_wren_o,
		mem_forward_data_o	=> mem_forward_data_w,
		wb_pc_o 			=> wb_pc_w,
		wb_pc_plus4_o 		=> wb_pc_plus4_w,
		wb_instruction_o	=> wb_instruction_w,
		wb_alu_res_o 		=> wb_alu_res_w,
		wb_dtcm_data_rd_o 	=> wb_dtcm_data_rd_w,
		wb_rd_o 			=> wb_rd_w,
		wb_RegDst_ctrl_o 	=> wb_RegDst_w,
		wb_RegWrite_ctrl_o 	=> wb_RegWrite_w,
		wb_MemtoReg_ctrl_o 	=> wb_MemtoReg_w
	);
	--=================================================
	-- WRITEBACK mux (WB stage)
	--=================================================
	WB: writeback
	generic map(
		DATA_BUS_WIDTH		=>	DATA_BUS_WIDTH,
		PC_WIDTH			=>	PC_WIDTH
	)
	PORT MAP (
		alu_res_i			=> wb_alu_res_w,
		dtcm_data_rd_i		=> wb_dtcm_data_rd_w,
		pc_plus4_i			=> wb_pc_plus4_w,
		MemtoReg_ctrl_i		=> wb_MemtoReg_w,
		RegDst_ctrl_i		=> wb_RegDst_w,
		write_data_o		=> wb_write_data_w
	);
	--=======================================
	-- HAZARD_UNIT connection (interlock)
	--=======================================
	HZD: HAZARD_UNIT
	PORT MAP (
		--Inputs
		id_rs1_i 			=> id_rs1_w,
		id_rs2_i 			=> id_rs2_w,
		ex_MemRead_ctrl_i 	=> ex_MemRead_w,
		ex_rd_i 			=> ex_rd_w,
		ex_DivStart_ctrl_i	=> ex_DivStart_w,
		div_done_i			=> div_done_w,
		
		--Outputs
		stall_o 			=> stall_w,
		hold_o				=> hold_w
	);
	--=======================================
	-- FORWARD_UNIT connection (full forwarding)
	--=======================================
	FWD: FORWARD_UNIT
	PORT MAP (
		--Inputs
		ex_rs1_i 			=> ex_rs1_w,
		ex_rs2_i 			=> ex_rs2_w,
		mem_RegWrite_ctrl_i => mem_RegWrite_w,
		mem_rd_i 			=> mem_rd_w,
		wb_RegWrite_ctrl_i 	=> wb_RegWrite_w,
		wb_rd_i 			=> wb_rd_w,
		
		--Outputs
		forward_a_o 		=> forward_a_w,
		forward_b_o 		=> forward_b_w
	);
	
	--==========================================================
	-- Debug registers (Figure 8): CLKCNT / STCNT / FHCNT
	--==========================================================
	-- CLKCNT: free-running clock counter (cleared on reset)
	process (mclk_w , rst_w)
	begin
		if rst_w = '1' then
			mclk_cnt_q	<=	(others	=> '0');
		elsif rising_edge(mclk_w) then
			mclk_cnt_q	<=	mclk_cnt_q + '1';
		end if;
	end process;
	
	-- THE ACCOUNTING THESE TWO COUNTERS HAVE TO SATISFY
	-- Clause 6.iii.b of `Auxiliary/Lab 5/Auxilary/LAB5 task definition.pdf`
	-- reads the instruction count out of the cycle count:
	--     InstructionCounter = CLKCNT - (STCNT + 4 + depth*FHCNT),  depth = 3
	-- so EVERY cycle in which the retirement stage (MEM) holds a bubble, after
	-- the 4 fill cycles, must be accounted for exactly once - either in STCNT
	-- or inside one flush event's depth. Counted twice, IPC comes out too low;
	-- not counted at all, too high. Cycle by cycle:
	--
	--   taken branch / jal / jalr retires in MEM at cycle N. The flush bubbles
	--   IF/ID, ID/EX and EX/MEM, so MEM is a bubble at N+1, N+2, N+3 -- three
	--   non-retiring cycles, which is exactly depth*1. ONE event.
	--
	--   an interrupt is accepted at cycle N (the MEM instruction still retires:
	--   DMEMORY has no flush port, by design). The same flush kills the same
	--   three younger instructions -- so the same depth*1 -- but entry then
	--   spends cycle N+1 capturing TYPE and cycle N+2 fetching the vector,
	--   and IFETCH only sees the vector at N+3. MEM is a bubble at N+1..N+5:
	--   FIVE non-retiring cycles = depth*1 PLUS the two entry cycles.
	--
	-- Hence: one flush event per redirect, and cyc1/cyc2 belong in STCNT.
	--
	-- Before 2026-08-27 FHCNT counted CYCLES of flush_w, and flush_w is
	-- `br_flush OR accept OR cyc1 OR cyc2` -- so every interrupt entry
	-- incremented it THREE times and the equation subtracted 9 cycles where
	-- 5 are real. Harmless for tests 2-4, but test1 is the interrupt benchmark
	-- and its IPC is Phase 11's exit criterion, so it was worth one line.

	-- STCNT: cycles the machine was held with nothing retiring and no flush
	-- event to charge them to. Two sources:
	--   * stall_w (load-use interlock, divide-in-EX hold). A stall that
	--     coincides with a flush is not counted - the redirect from MEM
	--     cancels the interlock (flush has priority in IFETCH) and that cycle
	--     is already inside the flush penalty.
	--   * annul_w (interrupt entry Cycle 1 and Cycle 2), per the derivation
	--     above. stall_w is necessarily '0' in those two cycles (ID/EX and
	--     EX/MEM are bubbles), so the OR cannot double-count.
	process (mclk_w , rst_w)
	begin
		if rst_w = '1' then
			stcnt_q	<=	(others	=> '0');
		elsif rising_edge(mclk_w) then
			if ((stall_w = '1' and flush_w = '0') or annul_w = '1') then
				stcnt_q	<=	stcnt_q + '1';
			end if;
		end if;
	end process;

	-- FHCNT: counts REDIRECT EVENTS, not flush cycles (cleared on reset).
	-- br_flush_w is high for exactly one cycle per taken branch/jal/jalr (the
	-- EX/MEM register is bubbled right after) and accept_w for exactly one
	-- cycle per interrupt entry; both kill the same three younger stages, so
	-- one count = one redirect = 3 killed instructions (depth = 3). The OR is
	-- deliberate rather than a sum: an interrupt accepted on a cycle whose MEM
	-- instruction is itself a taken branch is ONE redirect, and the three
	-- killed instructions are the same three.
	process (mclk_w , rst_w)
	begin
		if rst_w = '1' then
			fhcnt_q	<=	(others	=> '0');
		elsif rising_edge(mclk_w) then
			if ((br_flush_w or accept_w) = '1') then
				fhcnt_q	<=	fhcnt_q + '1';
			end if;
		end if;
	end process;
	
	--==========================================================
	-- BPADDR breakpoint register + Signal-Tap trigger
	--==========================================================
	-- BPADDR_i (word-granularity address from SW7-SW0) is sampled into the
	-- breakpoint register (cleared on reset)
	process (mclk_w , rst_w)
	begin
		if rst_w = '1' then
			bpaddr_q	<=	(others	=> '0');
		elsif rising_edge(mclk_w) then
			bpaddr_q	<=	BPADDR_i;
		end if;
	end process;
	
	-- SignalTap_trigger = (IF_PC == BPADDR_i): the byte-addressed IF-stage
	-- PC is converted to a word address (drop the 2 LSBs); the unsigned
	-- compare zero-extends the shorter operand
	
	-- Data-bus master outputs -- slice 1 (G-305). Full byte address, not the
	-- narrowed RAM index. Reference: DUT/RV32IMscMCU/RV32IM_CORE.vhd:559-566.
	dbus_addr_o		<= mem_alu_res_w(DATA_ADDR_WIDTH-1 DOWNTO 0);
	dbus_wdata_o	<= mem_write_data_w;
	dbus_MemRead_o	<= mem_read_core_w;
	dbus_MemWrite_o	<= mem_write_core_w;

---------------------------------------------------------------------------------------
-- Figure 8 verification and FPGA SignalTap outputs
---------------------------------------------------------------------------------------
	CLKCNT_o				<=	mclk_cnt_q;
	IFpc_o					<=	if_pc_w;
	IFinstruction_o		<=	if_instruction_w;
	IDpc_o					<=	id_pc_w;
	IDinstruction_o		<=	id_instruction_w;
	EXpc_o					<=	ex_pc_w;
	EXinstruction_o		<=	ex_instruction_w;
	MEMpc_o					<=	mem_pc_w;
	MEMinstruction_o		<=	mem_instruction_w;
	WBpc_o					<=	wb_pc_w;
	WBinstruction_o			<=	wb_instruction_w;
	STRIGGER_o				<=	'1' WHEN (if_pc_w(PC_WIDTH-1 DOWNTO 2) = bpaddr_q) ELSE '0';
	FHCNT_o					<=	fhcnt_q;
	STCNT_o					<=	stcnt_q;
	gie_o					<=	gie_w;
	
---------------------------------------------------------------------------------------

END structure;
