Adar-Shapira/rv32im-mcu-project/TB/RV32IMpipelinedMCU/tb_gpio_read.vhd

--============================================================================
-- Advanced CPU architecture and Hardware Accelerators Lab 361-1-4693 BGU
-- Final Project 2026 — self-checking testbench for Phase 6B (gap G-306)
--
-- Proves the SFR read path works, using the supplied GPIO test1 and its own
-- control flow as the oracle.
--
-- WHY test1 IS A BETTER TEST THAN ANY ASSERTION ON THE BUS
--   A read path can be checked two ways: watch the value on the bus, or watch
--   what the program DOES with it. The second is far stronger here, because
--   test1 branches on the value it reads. From the disassembled image
--   Auxiliary/Benchmark Apps/GPIO/test1/bin/M9K-intel/ITCM.hex:
--
--     word  4  lui   x29,0x2
--     word  5  lw    x29,16(x29)     -- reads 0x2010 = PORT_SW
--     word  6  andi  x7,x29,1        -- SW0_MASK
--     word  7  bne   x7,x0,+8        -- taken -> word 9
--     word  8  jal   x0,+28          -- not taken -> word 15
--     word  9  addi  x5,x5,1         -- SW0 set:   COUNT UP
--     word 15  andi  x7,x29,2        -- SW1_MASK
--     word 16  bne   x7,x0,+8        -- taken -> word 18
--     word 18  addi  x5,x5,-1        -- SW1 set:   COUNT DOWN
--
--   So the switch value chooses between three observable behaviours, and the
--   observable is the value that reaches PORT_LEDR and the six displays:
--
--     SW = 0x01  ->  the counter INCREASES
--     SW = 0x02  ->  the counter DECREASES
--     SW = 0x00  ->  neither branch is taken, so print2all is never called and
--                    NOTHING IS WRITTEN AT ALL
--
--   The third case is the sharpest. If the read path returned rubbish — 'Z' from
--   an undriven bus, 'X' from two drivers, or a stuck value — the branches would
--   go somewhere and writes would appear. "Exactly zero writes" is a very hard
--   thing to produce by accident.
--
-- WHAT IS CHECKED
--   P1  UP.    While SW = 0x01, every value written is the previous one plus 1.
--   P2  DOWN.  While SW = 0x02, every value written is the previous one minus 1.
--   P3  QUIET. While SW = 0x00, no store to any GPO port occurs at all.
--   P4  NOT VACUOUS. Phases 1 and 2 must each have produced writes, and the
--       counter must have moved in both directions. Without this, a core that
--       fetched nothing passes P3 and says nothing about P1 or P2.
--   P5  PORT CONTENT. The seven ports still hold what was last stored to them,
--       and each display still shows the right pattern — the Phase 6A model,
--       carried forward so 6B cannot silently break 6A.
--
-- WHAT THIS DOES NOT COVER, STATED PLAINLY
--   The GPO read-back paths (GEN_GPO_READBACK). No supplied benchmark ever reads
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
