Adar-Shapira/rv32im-mcu-project/(notices)

Notices in the files:
Auxiliary/hanan/Out-of-Order_Execution_G.md:
Copyright by
